zzskm/keyboard/46es/model/samples/README.md

# 46es 시험 쿠폰 원본 — B 쿠폰·보스 탭

`46es_sw_hole_sample.sc`는 주문 1의 B 쿠폰(`SW_HOLE_SAMPLE`)과 보스 탭(`BOSS_TAB_SAMPLE`)의 SolidCraft 원본이다. 46es 부품이 아니라 시험용 조각이다. 출력 파일은 `python 46es/tools/export_print_v5.py`가 이 원본에서 [`../print_v5/order1/`](../print_v5/README.md)의 `46es_v5_sw_hole_coupon`·`46es_v5_boss_tab`으로 내보낸다. 이 폴더에는 출력 파일을 두지 않는다. 재료·수량·출력 방향은 [제작 안내](../print_v5/README.md)를 따른다.

## 형상

B 쿠폰은 145.35 × 74.15 × 10 mm다. 열은 7개이고 X 간격 19.05로 홀이 13.7에서 14.3까지 0.1씩 커진다. 열 0(13.7) 쪽 원점 코너의 3 mm 모따기가 방향 표시다. 두께 10은 업체 최소 부품 크기 때문이다. 스위치 끼움에는 아래 층만 관여한다.

| 행 | 구조 | 확인할 것 |
|---|---|---|
| A | 홀 + 상면 1.5 아래 걸쇠 노치(8 × 1 × 1.5) | 국부 노치 방식 |
| B | 홀(상면 1.5) + 아래 16.5 개방 포켓 | 노치 없는 비교 |
| C | 상면 16.5 개구 1.7(`SMP_upper` = v5 `TBD_upper_plate_T`) + 홀 층 1.5 + 아래 개방 | **v5 plate와 같은 층 구성** |
| D | M2 Ø2.0–2.6, M3 관통 Ø3.0–3.6, 카운터보어 Ø6.0/6.2/6.4 × 3.5(M3 3.3 위), 육각 포켓 AF 4.8–5.4 × 1.5(아랫면) | 나사 자리·보스·지지대 끼움 |

보스 탭은 30 × 30 × 10 판에 커버 보스 Ø5.8 × 1.5(끝 자석 포켓 Ø3.2 × 2.1)와 평면 자석 포켓 Ø3.2/3.3/3.4를 둔 투명 레진 견본이다.

`check_repository.py`는 행 C의 `SMP_upper`가 현행 CAD의 `TBD_upper_plate_T`와 같은지 검사한다. plate 층 두께를 바꾸면 이 원본도 함께 고치고 주문 1을 다시 내보낸다.

## 시험

1. 각 홀에 Gateron KS-3 Milky Yellow Pro를 끼운다. 삽입력·걸쇠·키캡을 뺄 때의 이탈·흔들림·플랜지 착좌를 행 A/B/C별로 기록한다.
2. 행 D: M2 통과·자가탭, M3 통과, 보스 탭 보스와 카운터보어의 여유(반경 0.1/0.2/0.3), M3 육각 스탠드오프와 육각 포켓의 끼움을 기록한다.
3. 보스 탭: 자석 포켓 끼움·에폭시·흡착력과 투명 표면을 확인한다.
4. 홀 내경을 실측해 `measurements.csv` M18에 적고, 채택한 값은 생성기 입력으로 옮겨 주문 2 전에 CAD를 다시 만든다. plate는 깎아 맞추지 않는다([AGENTS.md](../../AGENTS.md) §5).

참고 치수의 출처: [스위치 테스터 분석](../../inspection/switch_tester/README.md)(fidget 14.0 / 남김 1.4 / 노치 16 × 8 × 1.5), r2 DWG 14.0(레이저 커프라 MJF와 다름).
