zzskm/keyboard/46es/inspection/wilmore/README.md

# The_Wilmore.stl 검사 — PSD60 실측 전 하우징 대용값

> **Wilmore는 PSD60 Defender가 아니다.** 둘 다 GH60 호환 60% 하우징이라 내부가 비슷할 것으로 보고, PSD60을 실측하기 전까지 대용값으로만 쓴다. 여기서 뽑은 값은 모두 `REF_WIL_` 매개변수에 넣었고, 하우징 관련 `TBD_` 매개변수가 그 값을 참조한다. 실측값이 나오면 `TBD_` 매개변수의 식을 실측값으로 바꾸면 모델 전체가 따라간다(`../../model/README.md` 참고).

검사일 2026-11-04. 원본 메시 파일은 저장소에 넣지 않았다(외부 모델, 재배포 권한 미확인).

## 원본

| 항목 | 값 |
|---|---|
| 경로 | `C:\Users\bearhappy\Downloads\The_Wilmore.stl` |
| 크기 / SHA-256 | 5,387,484 B / `c9c50ac7cd22fcba3e5492bf53bf5867bfc8d429cbc2098ed6ebe6a173a8d1f6` |
| 형식 | binary STL, 삼각형 107,748, 경계 엣지 0, 비다양체 엣지 13. 단위는 mm로 가정 |
| 출처 | 찾지 못함. Printables의 The Haydee·Morrel·Faria·Zatarra 같은 60% 케이스 시리즈와 이름 짓는 방식이 같지만 같은 제작자인지는 확인하지 못했다 |

## 구성 (연결 성분 7개)

크기는 아래 「좌표 변환」을 적용한 PCB면 기준이다.

| # | 삼각형 | 형상 | 해석 |
|---|---|---|---|
| 0 | 48,400 | 외곽 312.904 × 117.713, 내벽 292.370 × 101.929 R5.5 | 케이스 본체 |
| 2 | 15,766 | 두께 3.0, 높이 17.15 링. 내면 286.381 × 95.934 **R2.5** | 케이스 내벽에 붙는 링. 좌우 가운데에 H05·H06 보스(Ø2 구멍), USB 위치에 틈 |
| 1 | 36,926 | 292.4 × 102.0 시트, 두께 0.62(가장자리 0.96) + H01 스탠드오프 | 바닥 시트. 케이스 바닥에서 0.56 떠 있음 |
| 3·4·5 | 3,192 / 1,724 / 1,724 | Ø5.0 / 구멍 Ø2.0, 높이 4.67 | H04·H03·H02 스탠드오프 |
| 6 | 16 | 292 × 104 쐐기 | 케이스 아래 쐐기(받침 또는 무게추 자리로 추정). 사용하지 않음 |

46es에서 하우징 내벽 역할을 하는 면은 **링 내면**으로 본다. r2 판(286.4 × 95.8)과 거의 같은 크기이고, 링 내면과 GH60 PCB(285 × 94.6) 사이 틈이 사방 0.67~0.69로 고르다.

## 좌표 변환

1. **경사 제거**: 시트 윗면 법선의 경사 4.633°(케이스 본체·링 윗면도 4.633°)만큼 X축으로 돌려 PCB면을 수평으로 만든다.
2. **비틀림 보정**: 내벽 4면을 직선 맞춤해 나온 Z축 비틀림 0.0164°를 보정한다.
3. **원점**: H03·H04 구멍 중심에 GH60 좌표를 맞춘 점(Wilmore 좌표 305.004, 1.441, 두 구멍 잔차 ≤ 0.001)을 원점으로, 스탠드오프 상면(8.730)을 Z = 0으로 잡는다. 46es 모델의 좌표계(GH60 PCB 기준점, Z = 지지대 상면)와 같다.

## 추출값 (46es 모델 좌표)

| 매개변수 | 값 | 측정 방법 |
|---|---|---|
| `REF_WIL_in_W` × `REF_WIL_in_D` | 286.381 × 95.934 | 링 내면. Z −4.7 ~ +12.5 모든 높이에서 같다(수직벽, 구배 없음) |
| `REF_WIL_in_R` | 2.5 | 링 내측 4코너 × 3높이 원 맞춤 2.481 ~ 2.500, 잔차 ≤ 0.01 |
| `REF_WIL_pcb0_dx` / `dy` | 0.693 / 0.667 | 링 내면 → GH60 기준점 |
| `REF_WIL_support_H` | 6.196 | 케이스 내부 바닥 윗면 → 스탠드오프 상면 |
| `REF_WIL_rim_F` / `rim_B` | 12.173 / 11.891 | 스탠드오프 상면 → 앞·뒤 테두리 윗면(내측 모서리) |
| `REF_WIL_usb_X` / `W` / `H` / `Z` | 18.713 / 11.217 / 7.137 / −1.533 | 뒷벽 USB 개구부. 모서리 R 없는 직사각형, 링 포함 벽 두께 약 7.1 |
| `REF_WIL_post_D` | 5.0 (구멍 2.0) | 스탠드오프 외경 |
| `REF_WIL_out_*`, `bot_*`, `chamfer_*` | 표 아래 참고 | 외형 표시용. 측면 단면(X = 450) 폴리곤을 단순화한 값 |
| `REF_WIL_tilt` | 4.633° | 내부 기준면의 타이핑 경사 |

외형 단면(Y, Z): 앞 아래 (−15.302, −7.581) → 뒤 아래 (102.411, −12.025) → 뒤 위 (102.411, 11.891) → 앞 경사 시작 (−7.353, 12.173) → 앞 경사 끝 (−15.302, 6.826). X는 −13.953 ~ 298.951. 실제 메시의 약 1° 외벽 구배와 바깥 모서리 형상은 생략했다.

## GH60 후보 좌표와 비교

| 구멍 | GH60 `CAND_` | Wilmore | 차이 (X, Y) |
|---|---|---|---|
| H01 | 25.199, 66.699 | 25.319, 66.699 | +0.120, 0.000 |
| H02 | 128.200, 47.600 | 128.198, 47.299 | −0.002, −0.301 |
| H03 | 190.499, 9.399 | 190.500, 9.400 | 원점을 맞춘 구멍 |
| H04 | 260.050, 66.699 | 260.050, 66.699 | 원점을 맞춘 구멍 |
| H05 | 3.709, 38.099 | 3.319, 38.110 | −0.390, +0.011 |
| H06 | 281.291, 38.099 | 281.809, 38.110 | +0.518, +0.011 |

H05–H06 중심 거리: GH60 277.58, r2 DWG 279.44, Wilmore 278.49로 세 자료가 모두 다르다. 하우징 대용 바디의 기둥은 GH60 `CAND_` 좌표에 두었다. 체결 좌표는 PSD60 실측(M08)과 체결 시험 프레임(단계 A)으로 정한다.

## 이전 자리표시값과 비교

| 매개변수 | 이전 | 지금(Wilmore) | 메모 |
|---|---|---|---|
| `TBD_case_in_W` | 286.4 (r2 판) | 286.381 | r2 판이 PSD60에 들어간다면 PSD60 내폭은 286.4 이상이어야 한다. Wilmore는 0.019 작다 |
| `TBD_case_in_D` | 95.8 (r2 판) | 95.934 | |
| `TBD_case_in_R` | 2.5 (The_Wedge) | 2.5 | 두 메시가 같다. 사용자 관찰(R3.5 판에서 코너 유격)과도 맞는다 |
| `TBD_pcb0_dx` / `dy` | 0.7 / 0.6 (가정) | 0.693 / 0.667 | |
| `TBD_support_H` | 0 (값 없음) | 6.196 | |
| `TBD_support_to_rim_F` / `B` | 0 (값 없음) | 12.173 / 11.891 | |
| `TBD_usb_X` / `W` / `Z` | 20 / 12 / 0 (근거 없음) | 18.713 / 11.217 / −1.533 | `TBD_usb_H` 7.137 새로 추가 |
| `TBD_case_post_D` | — | 5.0 | 새로 추가. r2 판의 지지대 회피 구멍 Ø4.5보다 크다 → M10 |

## SolidCraft 하우징 대용 바디

초기 스케치 모델 `model/46es_draft_sketches.sc`(태그 `46es-pre-cleanup-2026-11-09`)의 `REF_HOUSING_WILMORE_NOT_PSD60` 바디. 제작용 아님, 간섭 확인용. 현행 v5는 이 값을 `REF_WIL_` 매개변수로 이어받았고, 조립 검토 모델은 실측하지 않은 바닥 윤곽에만 쓴다(`tools/build_assembly_reference_v5.py`).

| 피처 | 내용 | 따르는 매개변수 |
|---|---|---|
| `SK40_HOUSING_PROFILE_REF_WILMORE` → `HOUSING_OUTER_REF_WIL` | 측면 단면 5점 폴리곤을 X로 돌출 | `REF_WIL_out_*`, `bot_*`, `chamfer_*`, `TBD_support_to_rim_F/B` |
| `HOUSING_CAVITY_TBD` | 기존 SK00 내측 외곽을 바닥(−`TBD_support_H`)부터 위로 관통 절단 | `TBD_case_in_W/D/R`, `TBD_pcb0_dx/dy`, `TBD_support_H` |
| `SK41_HOUSING_POSTS_CAND` → `HOUSING_POSTS_CAND` | 기둥 6개. H01–H04는 원기둥, H05·H06은 벽까지 이어진 슬롯 모양 보스. 구멍 지름 `TBD_case_screw_D` | `CAND_H0x_X/Y`, `TBD_case_post_D`, `TBD_case_screw_D`, `TBD_support_H` |
| `HOUSING_USB_CUT_TBD` | 뒷벽 직사각형 관통 | `TBD_usb_X/W/H/Z` |

검증:

- 부피 297,430.3 mm³. 손으로 계산한 값 297,430.3과 같다. Wilmore 케이스와 링을 합친 부피는 295,785 mm³(+0.56%, 바닥 모깎기·턱 생략분).
- 기둥 6개의 원통면 중심·반지름이 `CAND_` 좌표, Ø5.0 / Ø2.0과 일치한다(불리언 보정 이동 ≤ 0.0007).
- 바디를 STL로 내보내 Wilmore 메시와 Z = −5.5 / −3 / −0.3 / 4 / 10 단면을 겹쳐 비교했다. 내벽은 0.01 이내, 외곽은 0.15 이내(외벽 구배 생략분), USB 개구부와 앞 경사면은 일치한다. `render/compare_*.png`(파랑 = SolidCraft, 주황 = Wilmore)
- 스케치 7개 모두 자유도 0, 타임라인 오류 0.

Wilmore와 일부러 다르게 만든 부분: 케이스와 링을 한 덩어리로 만들었고, 바닥 시트를 빼고 기둥을 바닥에서 세웠다(Wilmore 스탠드오프는 바닥 위 1.53에서 시작). 기둥 좌표는 GH60 값을 썼고, 내부 바닥·벽 모서리의 약 1 mm 모깎기, 외벽 구배, 바깥 모서리 형상, 쐐기(성분 6)는 생략했다.

## 재현

스크립트는 `scripts/`에 있다. numpy와 scipy만 쓴다. 임시 폴더에서 실행했으므로 경로는 바꿔서 쓴다.

```bash
python -I scripts/stl_overview.py The_Wilmore.stl wilmore.npz       # 개요·성분
python -I scripts/components.py wilmore.npz wil_lab.npy             # 성분 라벨
python -I scripts/untilt.py wilmore.npz wil_lab.npy wil_kb.npz      # 경사 4.633° 제거
python -I scripts/frame2.py wil_kb.npz wil_lab.npy wil_kb2.npz      # 비틀림 0.0164° 보정
python -I scripts/crossings.py wil_kb2.npz wil_lab.npy 2 12         # 링 내·외면 위치
python -I scripts/corners.py wil_kb2.npz wil_lab.npy 2 12 304.311 590.692 0.774 96.708 2.9   # 링 내측 R
python -I scripts/loops2.py wil_kb2.npz wil_lab.npy 0,1,2,3,4,5 6   # 구멍 중심
python -I scripts/vcross.py wil_kb2.npz wil_lab.npy 450 sec.npz     # 높이(바닥·시트·테두리)
python -I scripts/ysec.py wil_kb2.npz wil_lab.npy 0 101.5 318.5,323.7 3.7,10.8 310 340       # USB
python -I scripts/compare.py wil_kb2.npz wil_lab.npy housing.stl cmp # 대용 바디와 단면 비교
```
