zzskm/keyboard/46es/model/review_side_pairs_v3/README.md

# Side pairs v3 — REVIEW ONLY

기준일: 2026-11-05 KST. 제작 승인·발주용 아님.

STL9개: 좌/우 병합 mount2개 + 중앙 mount2개 + plate2개 + spine1개 + controller bracket/gate 각1개.
단위mm, 조립 좌표 유지. 프린트 베드 배치가 아니다. 상위 `46es_mount_side_pairs_v3_REVIEW_ONLY.step`은 같은9바디 조립이다.

[편집 모델](../46es_mount_side_pairs_v3.sc), [보고서·국부 시험안](../../docs/side-pairs-v3-2026-11-05.md), [CSV](../parameters_side_pairs_v3.csv).
전체9개 shell1·STL 연결1·비정상 edge0. 실제 재료·부품·배선·강도/조립 시험은 미완료다. v2 파일은 이전 안으로 보존했다.
