zzskm/keyboard/46es/docs/design.md

# 현행 설계 — v5

PSD60 Defender용 46키 non-split hand-wired. r2의 키 중심/회전/외곽 유지. plate 좌우 2조각, mount 4, spine, 분리형 Pro Micro 스냅 브래킷(PCB는 나사 없이 고정), 자석 커버 3조각. 스태빌라이저 없음.

## 기준/변경 경로

- 현행 CAD: [`model/46es_mount_seam_v5.sc`](../model/46es_mount_seam_v5.sc) ← `tools/build_seam_v5.py`가 기반 타임라인 [`model/seam_v5_base.json`](../model/seam_v5_base.json)(plate)에 v5 기능을 더해 생성. plate 앞 이음과 주문 1 이음 쿠폰은 `tools/seam_v5.py`, mount 4개는 [`model/mounts_cadcraft_phase1.dxf`](../model/mounts_cadcraft_phase1.dxf)의 평면 윤곽을 `tools/mounts_v5.py`가 직접 돌출하고, 브래킷은 `tools/ctrl_v5.py`, 커버 3조각은 `tools/cover_v5.py`(윗면 장식은 `tools/cover_pattern_v5.py`), spine은 `tools/spine_v5.py`, 참조 나사·너트·자석은 `tools/hardware_v5.py`가 만든다(앞 이음 나사·너트는 `seam_v5.py`). mount만 고칠 때는 `--mounts`, 브래킷만 고칠 때는 `--ctrl`, 커버만 고칠 때는 `--covers`로 수 초–수십 초 안에 확인한다([명령](validation.md#재생성-저장소-루트)).
- `parameters_seam_v5.csv`는 CAD 내보내기 결과. 변경 순서: 생성기 → CAD → 검토/제작 출력 → 검증 → 가이드.
- [`46es_assembly_review_v5.sc`](../model/46es_assembly_review_v5.sc): 조립 검토용 파생(부분 실측/단순 MX·OEM 참고). 실물 보증·주문용 아님.
- 좌표: GH60 PCB 앞·왼쪽 원점, X 오른쪽/Y 뒤쪽/Z 위. **Z=0 = 케이스 지지대 상면**(타이핑 경사 정규화).

## 현행 치수

| 항목 | 값·의미 |
|---|---|
| plate 상면 | Z 13 mm |
| 스위치 상부 개구 / 걸쇠 홀 층 / 아래 릴리프 | 1.7 / 1.5 / 1.8 mm |
| 스위치 착좌 | Z 11.3 mm. 14.0 mm 홀은 시험 출발값 |
| 커버 윗면 / 본체 두께 | 평면 Z 19.0 mm / 6.0 mm |
| mount–plate 접촉면 | Z 8.0 mm, 도면대로 돌출한 일체형 받침 7곳(좌 2·우 2·Rear 1·Front 2) |
| 뒤 받침 블록 | 별도 부품 3개, 길이 14 × 폭 4 × 높이 4.5(Z 0.5–5). X 30–44·106–120·163–177, Y 90.97–94.97. 밑은 케이스 뒤 벽 보스 윗면(가정 Z 0)과 틈 0.5 = 점착 패드, 위는 plate 뒤 플랜지 밑면. plate에는 다리가 없다. 주문 1 높이 변형 4.2 / 4.8 |
| 커버 다리 자석 포켓 위 살 | 3.9 mm |
| 커버 창과 참고 키캡 간격 | 1.0 mm. 쉴 때·4 mm 눌림 모두 |
| 커버 창 윤곽 | 키 블록(왼쪽·오른쪽) 실루엣 2개. 키캡 실제 폭 + 여유를 담는 셀 20.35, 외곽 살 ≥ 1.1, 다리 자석 포켓과 ≥ 1.15. 이 창이 그대로 L/T/R 분할 절삭이다: 9(E)·31(I)번 위 뒤 테두리와 22·40번 아래 앞 테두리를 그 키의 창 폭 띠로 곧게 끊는다(앞 두 곳의 안쪽 선은 키 중심에서 7.0). 윤곽의 0.6 이하 꺾임, 2.5 이하 짧은 모서리, 1.5 이하 평행 계단은 정리한다(`COVER_SPLITS`·`COVER_CLEAN`, `tools/build_seam_v5.py`) |
| 커버 윗면 장식 | 로고 `kb46es/26` 음각 하나, 깊이 1.0(Z 19 → 18, 관통 없음). L 왼쪽 블록 위쪽(X 3.26–18.75, Y 39.5–41.5). 폰트 Xifiction(출처 [dafont Xifiction](https://www.dafont.com/xifiction.font)(Nowak.tv, dafont 표기 "Free for personal use", 폰트 파일 내 표기 "freeware [for non-commercial use]")), 글자 칸 높이 2.0·폭 15.5, 획 0.5, 글자 안 틈·글자 사이 살 0.25(레진 벽 기준 미달, 사용자 수용). 대문자 모양으로 나온다. T·R에는 장식 없음. `tools/cover_pattern_v5.py`, 글자 윤곽 `tools/cover_logo_xifiction.json` |
| 참고 키캡 밑면 | 착좌 +6.0 = Z 17.3 mm. 실측 확정값 아님 |
| 참고 키캡 4 mm 눌림 후 plate 간격 | 0.3 mm |
| 케이스 테두리 | Z 14 mm 대략 실측. 커버 윗면 +5.0 |
| plate·커버 전체 외곽 | 약 285.781 × 95.334 mm |
| SO 체결 6곳 | mount 보스 Ø8(Z 1.5–8)에 보유 원형 황동 M3 인서트 Ø5 × 4를 열압입(구멍 Ø4.2 × 깊이 5, 아래 관통 Ø3.4). 보유 흑색 M3×10이 plate 카운터보어 바닥 Z 9.5에서 인서트를 지나 mount 밑 0.5까지 |
| 자석 | Ø3×2, 보스 6개 + 다리 2쌍 4개 = 10개 |
| 다리 자석 포켓 | 커버 Ø3.2 / plate Ø3.3. X 94.0·167.7, Y 2.5 |

r2 DWG의 P4·P5는 각각 윗면이 평평하고, 세 조각의 윤곽은 거의 일치한다. v5도 세 조각의 윗면을 Z 19(참고 키캡 밑면 17.3 + 덮음 1.7)로 평탄화했다. r2와 비교해 v5에는 키캡 여유 1.0 mm를 위한 창 확장과 밑면 자석 체결이 적용된다.

커버 윗면에는 이름 `46es` 하나만 작게 음각한다(사용자 결정 2026-11-10). 경위: 처음에는 L 앞쪽·R 가운데·T 뒤쪽 빈 면을 채우는 무늬를 시도했다(attractor hex → V자 헤링본 사선 → 폭이 줄어드는 헤링본). 사용자가 미리보기에서 모두 마음에 들지 않아 했고, 면을 채우는 대신 초점 하나를 두는 안 중 T 윤곽 핀스트라이프와 엠블럼을 골랐다. 그 미리보기도 본 뒤 핀스트라이프는 빼고("center cover에 engrave 제거"), 엠블럼은 "minimal, futuristic font"로 작게 바꿔 화면 캡처에 표시한 자리(L 왼쪽 블록의 뒤쪽 가장자리 바로 아래)에 두기로 했다. 글자는 폰트 파일 없이 생성기에 직선으로 그린 각진 단일 획이라 어느 환경에서도 같은 형상이 나온다. 모든 글자가 같은 높이이고 획 끝과 모서리는 직각이며, 막대 사이 살은 높이의 절반 − 획 폭이라 레진 벽 기준 1.0이 글자 높이의 하한을 정한다. 사용자가 폭은 그대로 두고 높이만 조금 줄이라고 해서(2026-11-10) 획을 0.45 → 0.4로 줄여 높이 3.0 → 2.8로 내렸다(막대 사이 살 1.0, 기준에 딱 맞음). 더 줄이려면 살이 1.0 아래로 가거나 획이 0.4보다 가늘어진다. 관통하지 않으므로 커버 강도·자석·배선 가림은 그대로이고, 윗면 평면 Z 19와 창 여유는 바뀌지 않는다. 2026-11-11 사용자가 로고를 폰트 Xifiction과 문자열 `kb46es/26`으로 바꿨다(출처 [dafont Xifiction](https://www.dafont.com/xifiction.font)(Nowak.tv, dafont 표기 "Free for personal use", 폰트 파일 내 표기 "freeware [for non-commercial use]")). 이 폰트는 200 단위 격자의 굵은 각진 글자라 획이 글자 높이의 1/4, 글자 안 틈과 글자 사이가 1/8이다. 살 1.0을 지키려면 글자 높이 8(폭 62)이 필요해 L 어디에도 들어가지 않는다. 앞쪽 띠(높이 6.2, 틈 0.77)·뒤쪽 띠·왼쪽 블록 세로 후보를 미리보기로 보였고, 사용자는 기존 자리(A, 최대 높이 2.7)를 고르고 크기를 줄이라고 했다. 높이 2.0(폭 15.5, 획 0.5, 틈 0.25)으로 정했다. 폰트 파일은 커밋하지 않고 쓰는 글자 7개의 윤곽만 곡선을 직선 6개로 나눠 `tools/cover_logo_xifiction.json`에 둔다(`python 46es/tools/cover_pattern_v5.py --font Xifiction.ttf`로 다시 만듦). 틈 0.25는 출력 벽 검사(`thin_wall_scan.py --exclude`)에서 로고 영역으로 따로 기록하고 폰트 틈 이상인지 확인한다. 로고 밖의 벽은 그대로 재질 기준으로 검사한다. 절삭은 홈마다 바깥 고리의 곡선으로 프로파일을 지정해 안쪽 고리(B·6 속)를 섬으로 남긴다. 생성·검증은 윗면 높이가 Z 19와 Z 18 두 개뿐이고 Z 18 면적이 계산한 홈 면적과 같은지 확인한다.

## 체결·분해

PSD60 → mount 4개(SO 인서트 보스 6개) → plate L/R → 커버 순서다. 좌우 mount에 각각 2곳, 중앙 뒤에 1곳, 중앙 앞에 2곳의 평평한 받침면을 뒀다. 좌측 두 받침은 SO1·SO2 보스 외곽 쪽이 넓어지고, 나머지 받침은 mount 길이 방향을 따라 양끝을 둥글게 마감했다. 타건 하중을 plate 밑면에서 mount로 직접 전달한다. mount는 케이스 체결 오차를 흡수한다(사용자 요구 2026-11-04): 나사를 느슨하게 건 채 위치를 맞추고 조인 뒤 축력으로 고정하며, 장공 방향은 위치별 오차 방향을 따른다. 케이스 벽 간격·나사 여유·출력 보정은 따로 관리하고, 잘 맞는 r2 외곽을 구멍 오차 때문에 줄이지 않는다. 지지대 높이 차이는 장공이 아니라 접촉면 높이·스페이서로 다룬다. 받침은 스위치와 체결부를 피해서 배치하고 사이를 열어 배선 공간을 확보했다. plate·스위치·배선·컨트롤러는 한 모듈로 들어낼 수 있다. 브래킷은 plate 아랫면에 고정하고 Pro Micro를 나사 없이 스냅으로 잡는다(아래 Pro Micro 브래킷 문단, 2026-11-09 `b52c50f`). 이전의 게이트 고정은 폐지했다.

mount 4개는 CADCraft 도면(`model/mounts_cadcraft_phase1.dxf`)의 외곽·받침 윤곽을 그대로 Z 0–3 / Z 1.5–8로 돌출해 만든다. 체결부는 도면이 아니라 매개변수에서 만든다. SO1–SO6: 프레임 관통홀 Ø(`TBD_so_screw_D`+`TBD_so_clr`)=3.4 위에 Ø8 보스(`v5_so_boss_D`, Z 1.5–8)를 세우고, 보스 윗면에서 프레임 윗면까지 인서트 구멍 Ø4.2 × 5(`v5_so_insert_hole_D`, `v5_so_insert_hole_depth`)를 판다. 보유 원형 황동 M3 인서트(Ø5 × 4, `v5_so_insert_D`·`v5_so_insert_H`)를 윗면에 맞춰 열압입하면 아래에 녹은 수지가 갈 1 mm가 남는다. 보유 흑색 M3×10이 plate 카운터보어 바닥(Z 9.5)에서 인서트와 관통홀을 지나 mount 밑으로 0.5 나온다(옛 아래 나사머리 자리 Z −1.65–0 안). 보스는 AF 8.5 팔각형 보존 구역(회피부·케이스 체결부가 들어오지 않는 곳) 안에 있고, plate 플랜지 안쪽 면에서 0.3 떨어지게 잘린다(SO4만 해당, 구멍 둘레 살 1.56, 나머지 1.9). spine의 SO3 회피 구멍은 Ø8.6이다(`spine_v5.SO3_RELIEF_D`). 2026-11-12 전에는 윗면 육각 포켓 AF 5.4 × 깊이 1에 황동 지지대(길이 6, 맞변 5)를 넣고 위 M3×4·아래 M3×5로 잡았다. 케이스 나사 H01–H06: 방향별 장공 폭 2.4(H05만 직선부 1.8, 나머지 2.0), H05를 뺀 다섯 곳에 윗면 머리 자리 폭 4.4×깊이 1. 도면의 홀·머리 자리 레이어는 이 매개변수 형상과 일치하는지 검사만 한다.

스위치 핀 회피부는 r2 배열과 KS-3X1 핀 위치에서 계산한다. 외곽에 0.4 mm 안으로 닿는 핀이 있는 키마다 핀 외곽+0.6의 사각 포켓을 바닥 Z 2.1까지 판다. 포켓과 외곽 사이 벽이 1 mm 미만이면 그 변을 열고, 육각 포켓과는 1 mm를 지키며, 케이스 머리 자리와 1 mm 미만으로 가까우면 둘을 1 mm 클로징으로 이어 접선 필렛으로 만든다(18번, 단순 합집합은 칼날 모양 재료를 남겼다). 여유 영역이 몸체에 1 mm 미만으로만 걸치는 핀은 사각 포켓 대신 핀 둘레 r(핀+0.4+0.6)의 둥근 스캘럽을 판다(33번, 사각이면 옆면에 머리카락 폭 틈이 생긴다). 현행 배열에서는 좌 10·11, 우 18·33·46이다. 생성기는 모든 Z 구간에서 절삭 옆에 1 mm 미만 두께의 재료 조각이 남으면 멈춘다. 받침이 스위치 몸체(13.98+0.15)와 겹치는 곳은 Z 4.95 위를 잘라 낸다(좌 11, 우 46). Front 받침 1에는 앞 이음 M2 너트 자리 Ø5.1을 뚫는다.

PSD60 뒤 벽 안쪽에는 구멍 없는 반원 보스 4개가 있다(사용자 제공 KPrepublic 제품 사진, 2026-11-09). 사진을 H01–H06으로 사영 보정한 중심 X는 약 36·113.6·170.1·245.8(잔차 ≤ 0.8, 기준점 하나씩 빼면 ±2–4), 지름은 약 9다. 윗면은 지지대 윗면(Z 0)과 같다고 가정했다. r2 맨 아래 판 P0(폭 4 테두리, H01·H05·H06 M2 구멍)가 노치 없이 이 보스 위를 지났기 때문이다. 실측은 M22다. ①②③은 plate 뒤 플랜지(Y 92.97–94.97, Z 5–8) 아래에 있다. 각 보스 위에 별도 받침 블록(길이 14 × 폭 4 × 높이 4.5)을 점착 패드로 붙이고 플랜지 밑면(Z 5)이 그 위에 얹힌다(`tools/build_seam_v5.py` `REAR_RESTS`). 2026-11-09에는 플랜지를 길이 14 다리로 Z 0.5까지 내렸으나, plate 출력 높이가 8에서 12.5로 늘고 얇은 다리 3개 때문에 출력에 support가 필요해져(사용자 보고 2026-11-10) 다리를 plate에서 떼었다. plate에는 받침 관련 형상이 없다. 블록 밑면과 보스 윗면의 공칭 틈 0.5는 패드 자리다. 딱 맞게 만들면 지지대 6개가 정한 plate 높이와 겹쳐 과구속이 되므로, 주문 1에 높이 4.2 / 4.5 / 4.8 세 가지를 뽑아 시험 조립에서 패드 두께와 함께 고른다. 어긋남을 plate가 아니라 블록에서 흡수하므로 plate를 기준 부품으로 두는 원칙과 맞는다. 블록 길이는 보스 위치가 ±2 mm 틀려도 플랜지 안쪽 면에서 본 보스 윗면 폭이 블록 밑에 다 들어오게 잡았고, 폭은 플랜지 2에 보스 앞쪽으로 2를 더했다(보스와 겹치는 면적 약 29 mm², 맨 뒷줄 스위치 몸체와 평면 거리 2.2 이상). 뒤 가장자리 받침 간격은 SO2→SO3 124 mm·SO3→SO4 120 mm에서 최대 약 80 mm로 줄고, 숫자 줄 하중이 mount를 거치지 않고 케이스로 간다. ④는 우 mount 뒤 모서리(SO4 옆) 밑이라 블록이 없고, 가정대로면 mount가 그 위에 얹힌다(검토 CAD 거리 0, 겹침 없음). plate는 블록 위에 얹히기만 하므로 분해 방식은 그대로다.

Rear(가운데 뒤 mount)에는 spine 받침을 따로 두지 않는다. spine 줄기 밑면(`split_spine_bottom_Z` = `TBD_frame_T` + `split_support_gap` = Z 3.05)이 Rear 프레임 윗면 Z 3에 공칭 틈 0.05로 얹혀, 줄기가 Rear 위를 지나는 Y 43–83 구간 전체가 접촉면이다(배선 홈 3곳과 H02 케이스 나사머리 자리를 빼고 116 mm², 이전 shim 받침 24 mm²). H02 머리(팬헤드 1.3 가정, 1.0 묻힘 → 윗면 Z 3.3) 위는 줄기 밑면을 옛 높이 Z 4로 남겨(`SPINE_H02_HEAD_RELIEF`, 머리 자리 폭 4.4 + 0.3 여유, 장공 ±1 포함) 0.7을 띄운다. 배선 홈 윗면은 Z 6 그대로라 홈 높이는 2.95, 프레임까지 통로 3이다. 생성 결과는 `inspection/scripts/verify_seam_v5.py`가 주문 1 STL의 Z 1.0·2.5·3.6·6.0 단면을 도면 기준 프로파일과 비교해 확인한다(대칭 차 0.5 mm²·경계 0.1 mm 이내).

Pro Micro 브래킷은 `tools/ctrl_v5.py`가 PCB 기준 좌표(`TBD_ctrl_*`)에서 만든다. plate 왼쪽 아랫면에 M2×6 2개로 달고(나사 (121.7, 18.96)·(121.7, 25.16), 배선하지 않는 1–4번 핀 구역의 패드 두 줄 사이), PCB는 나사 없이 잡는다. +X 끝을 끝 립 아래로 넣고 USB 쪽을 누르면 양옆 탄성 암(X 9.0 × 두께 1.0, 립까지 7.75)의 립이 PCB 긴 변 아래로 `ctrl5_hook_e` 0.4 걸린다. USB 개구 양옆 모서리 턱이 뽑는 힘(−X), 패드 두 줄 사이의 +X 끝 벽이 꽂는 힘(+X)을 받고, 두 쌍이 PCB가 Z축으로 도는 것도 막는다. 위(+Z)로는 모서리 받침·나사 블록·끝 받침이 납땜면을 0.15 위에서 받친다. 펌웨어가 쓰는 핀(행 D1·D0·D4·C6, 열 D7…B6)은 양쪽 5–12번 패드라 그 구간에는 긴 변 벽·홈을 두지 않고, 지붕은 패드 두 줄 사이 띠로 좁혔다. 생성기는 배선 패드(납땜면 r 1.87 × 2.5, 부품면 r 1.17 × 0.5), 부품면 부품(검토 모델의 Pro Micro 참고 도면), 스위치 하우징·핀, USB 플러그, mount, plate 16.5 릴리프를 피하는지 검사한다. 패드 위치(1번 핀이 USB 끝에서 3.8, 12번 핀이 +X 끝에서 1.26)와 부품은 참고 도면 값이고 실물(M15)은 미측정이다. 1번 스위치의 +x, 23번 스위치의 −x PCB 다리는 검토 CAD에서 PCB 뒤 모서리에 0.86 mm 파고들어 조립 때 자른다. 주문 1에는 걸림만 다른 시험편 A(0.25 / 끝 0.7)·B(현행)·C(0.55 / 1.2)를 넣는다. 탄성 암 변형률(외팔보 계산: 삽입 1.75 %, 멈춤 1.85 %)은 계산값이며 실물 강도·반복 탈착은 시험으로 확인한다.

plate 앞 이음은 위에서 얹는 곧은 반턱과 M2×5 나사 1개로 결합한다(`tools/seam_v5.py`). L의 tab은 윗면 쪽 2.4 mm 두께로 X 136.3–147.4까지 R 위로 나온다. tab 옆면(Y 3.0·10.2)이 Y 위치와 면내 회전을 잡고, tab 끝 3.2 mm 구간이 +Y로 2.4 넓어진 걸림 턱이 X 방향 벌어짐을 잡는다. 위치결정 여유는 편측 0.15 mm, tab 끝과 턱 바깥은 0.3 mm다. 나사는 (140.4, 6.6)의 ISO 7380 M2×5 버튼헤드(머리 Ø3.5–3.8 × 1.3), 머리 카운터보어는 Ø4.4 × 깊이 1.4(머리 윗면 Z 12.9, 머리 아래 tab 살 1.0, 카운터보어 둘레 벽 1.4)다. 너트는 R 아랫면의 닫힌 육각 포켓(맞변 4.0, 깊이 1.3)에 눌러 끼운다. 이음면 쪽 벽 1.27, 포켓 위 살 1.3이고, 너트는 plate 밑으로 0.3 나와 Front 받침 1의 Ø5.1 구멍에 들어간다. 나사로 당겨 끼우고 나사로 밀어 뺀다. 측면 삽입 슬롯은 쓰지 않았다. R 바닥 살이 2.6 mm라 위 1.0 + 슬롯 1.8 + 아래 1.0을 넣을 수 없다. 이음에서 5 mm 안에는 스위치 개구가 없다. 2026-11-10 이전에는 dovetail tab(X 136.3–142.9, 여유 0.15)과 이음면 쪽이 열린 얕은 너트 포켓(맞변 4.4, 깊이 1.0)이었다. 비스듬한 면의 0.15 여유는 MJF 공차에서 끼일 수 있는데 plate는 깎지 않는 부품이고, 너트는 조립 중 손으로 받쳐야 했다. 여유와 너트 포켓 맞변은 주문 1 이음 쿠폰 3쌍(S0 옛 dovetail 대조군, S1 현행, S2 여유 0.25·맞변 4.2)으로 확인한다. 중앙·뒤쪽은 spine의 M2 나사 4개가 잡는다. spine 배선 홈은 Y 49/64/72, 폭 3 × 높이 2.95 mm(윗면 Z 6)다. 이음의 단차·삐걱임과 접착 필요 여부는 배선 전에 확인한다.

커버 보스는 plate 카운터보어에서 위치를 잡고 자석은 강철 M3 나사머리에 붙는다. 아래 다리의 자석 2쌍은 서로 붙으므로 극성을 맞춘다. 위 다리는 공간이 부족해 자석을 추가하지 않았다. 비용이 큰 plate를 재출력하기 전에 mount·쿠폰 시험, 장공 조정과 상대 부품의 국부 가공으로 맞춤을 확인한다.

조립 검토 모델의 Pro Micro는 첨부 `arduino-pro-micro-1.snapshot.1.zip`의 STEP과 그림을 참고해 별도로 그렸다. v5의 PCB 외곽과 설치 위치에 맞춰 USB 소켓, 칩, 주요 부품과 양면 납땜 패드를 단순화했다. 소켓이 −X를 향하고 부품면은 케이스 바닥(−Z), 납땜면은 plate(+Z)를 향한다. 제작 모델의 플러그 점유 영역은 케이블 여유 검사용이다.

## 실측과 가정

[2026-11-04 실측 JSON](../model/measurements/2026-11-04T111846Z.json)은 원본 기록이다. 케이스 폭 286, 깊이 96, 테두리 14는 대략값이며 전체 최솟값으로 확정하지 않는다. H01 지지대 높이 5.5·외경 5와 M08 입력 좌표 성분만 참고 모델에 반영하며 미측정 축은 GH60 후보를 유지한다. mount는 GH60 채택 좌표와 장공으로 시험한다. H01–H06 좌표는 [GH60 호환 치수 조사](https://note.com/skeletonkbd/n/n7fdfaac9bd8c?hl=en)의 공개 CAD 비교값(GH60 PCB 앞·왼쪽 원점)이며 실물 측정 자료가 아니다. PSD60 외형 약 320 × 115, 앞 21·뒤 32, 경사 6°는 [KPrepublic 제품 안내](https://kprepublic.com/collections/case/products/kp-poseidon-60-psd60-defender-de-60-cnc-coating-case-layer-painting-for-standard-60-mechanical-keyboard-pcb-xd64-bm6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) 값이다.

케이스 내측 폭 286 기준 외곽 여유는 편측 약 0.11 mm다. 원점 가정을 적용하면 오른쪽에 0.081 mm 중첩이 생긴다. 대략 측정만으로 형상을 축소하지 않으며 실물의 중심 맞춤·접촉을 확인한다.

r2 현물 커버는 체결 상태에서 테두리 위로 최소 3 mm 돌출된다. r2는 5T+2T 아크릴 적층이고 현재 커버는 6T 단일 출력이다. r2 관찰값을 v5 실측 결과로 쓰지 않는다. 맨 아랫줄 키캡 폭은 사용자 확인값 1.25u·1u·2.25u·2u·1u·1u를 따른다. 펌웨어 JSON의 물리 폭 표기는 현물과 다를 수 있어 CAD 폭의 기준으로 쓰지 않는다.

참고 형상의 근거: [Cherry MX](https://www.thingiverse.com/thing:421524), [OEM KeyV2](https://github.com/rsheldiii/KeyV2/blob/master/src/key_profiles/oem.scad). 곡면·내부 소켓·정밀 걸쇠는 생략했다. Gateron KS-3 Milky Yellow Pro와 실제 OEM 키캡의 정밀 도면이 아니다. [r2 판독](../inspection/46es_r2_dwg_inspection.md), [Wilmore 참고 분석](../inspection/wilmore/README.md), [스위치 홀 참고 분석](../inspection/switch_tester/README.md)은 근거 자료로만 사용한다.

재료·수량과 구매품은 [제작 안내](../model/print_v5/README.md), 다음 결정은 [실물 확인 목록](validation.md)을 따른다.

## 결정 이력

이전 결정을 바꾼 변경은 여기에 날짜·커밋·경위를 남긴다. 2026-11-10부터 커밋 칸에는 해시 대신 `decision:` 커밋 제목을 적는다(조회: `git log --grep "^decision:" -- 46es`). 그 전 행의 해시는 그대로 둔다. 치수 자체는 위 표가 현행이고, 이 표는 "왜 바뀌었나"만 적는다. 경위가 기록되지 않은 변경은 `경위 미기록`으로 두고 다음 작업자가 확인한다.

| 날짜 | 커밋 | 결정 | 경위·근거 |
|---|---|---|---|
| 2026-11-04 | `9fd75ff` | 스태빌라이저 없음, Pro Micro 중앙 하단, plate·커버는 r2 아크릴 형상 | 사용자 결정 |
| 2026-11-05 | `67fe2c0` | 정밀 실측 대신 GH60 체결 좌표 채택, 장공·시험 출력으로 확인 | 사용자 결정. 실측 게이트 폐지 |
| 2026-11-05 | `67fe2c0` | 재료 MJF PA12, 최소 벽 1.0 | 사용자 결정(JLC3DP 규칙) |
| 2026-11-06 | `0880d22` | plate·mount 검정 PA12S-HP, 커버·보스 탭 투명 8001 레진 | 사용자: "mount, plate는 black, cover는 transparent resin" |
| 2026-11-06 | `854e647` | 두 단 커버(바닥 Z 16.1 / 창 둘레 턱 Z 19), 참고 키캡 착좌 +6.0, B 쿠폰 행 C 1.7 | 사용자 결정(계획 문서 §0). 커버 부피·돌출 축소 목적 |
| 2026-11-06 | `72d3ea1` | 안전마진: 다리 자석 포켓 위 살 1.0 → 1.3(바닥 Z 16.4) | 사용자: "의심되는 부분은 안전마진 추가" |
| 2026-11-07 | `7b252f3` | **커버를 평판 Z 19(6T)로 되돌림**, mount–plate 받침 7곳 추가 | **사용자 결정(2026-11-09 확인).** r2 P4·P5가 평판이라 r2 외관을 따름. 두 단 커버·안전마진(위 두 행)은 이 결정으로 폐기. 다리 자석 포켓 위 살은 3.9로 늘어 안전마진 문제도 해소. 투명 레진 커버 부피는 두 단 커버보다 큼(수용) |
| 2026-11-07 | `f41bda4`, `91ec26c`, `9c79cb5` | Phase 1 mount: WEB 5개 억제, 팔각 랜드 8.5, 직선 레일, 핀 회피부 | 구조 개선 계획 1단계. `74aebb5`에서 재구축 |
| 2026-11-07 | `7744368` | Phase 2: Ctrl 브래킷 립 4·스톱·게이트 핑거 억제 | 구조 개선 계획 2단계. `b52c50f`에서 재설계 |
| 2026-11-09 | `b52c50f` (`decision:`) | **Pro Micro 브래킷 재설계(Phase 2): 게이트·M2×5·너트 폐지, 스냅 고정**(+X 끝 립, USB 양옆 모서리 턱, 탄성 암 2). plate L의 브래킷 M2 구멍 (125, 17)·(125, 25) → (121.7, 18.96)·(121.7, 25.16), 게이트 홈 2곳 메움. 생성기 `tools/ctrl_v5.py`, 주문 1에 시험편 3종 | 사용자 요청(2026-11-09: 부품·나사 축소, 생성기로 재구축, PCB 고정 복원; 고정 방식은 판단 위임 → 스냅 제안, 외부 검토 2회 반영해 진행 동의). `7744368` 뒤로 PCB를 −Z·X로 잡는 형상이 없었다. 5–12번 핀 양쪽 16선 배선과 긴 변 전체 홈은 양립하지 않고, 앞 M2 너트 보스가 배선 5번 패드 위에 있었다. plate는 주문 전이라 재출력 없음 |
| 2026-11-09 | `74aebb5` (`decision:`) | **mount 4개를 DXF에서 직접 돌출하는 구조로 재구축.** 팔각 랜드 둘레 홈(0.3 mm 링·우측 1.5 mm 해자) 폐지, 핀 회피부를 배열에서 계산, Rear spine 받침 Z 3.95 복원, 우측 두 번째 plate 받침 생성, v4 mount 사슬·REF 스위치 외피·Wilmore 하우징을 생산 모델에서 억제 | 사용자 보고(2026-11-09): 우측이 옛 형상으로 회귀, Front에 V자 홈 반복, 타임라인이 느림. 원인은 옛 바디 위에 clip∩old+fill 패치를 겹치는 생성 방식(DXF 윗레일 폭 10.67 → 생성 9.3–10.4, x≈155에 0.3 mm 슬롯, Rear 받침 3.95 → 3.3, 우측 받침 2 미생성). 0.3 mm 링 홈은 MJF로 출력되지 않아 폐지. 평가 시간 48 s → 약 16 s, mount 단독 2 s |
| 2026-11-09 | `9bacd26` | **plate 뒤 다리 3곳 추가**(PSD60 뒤 벽 보스 ①②③ 위, 틈 0.5 + 패드). 구조 개선 3단계(mount와 브래킷·spine 병합) 폐기 | 사용자: "case outside에 보면 boss가 있던데 이거랑 plate가 닿을 수 있도록", 위치는 판단 위임("적당히 알맞게 위치 정해줘"). 병합은 사용자: "정비성 저하가 크리티컬". 보스 위치·높이는 제품 사진 추정과 r2 P0 근거의 가정(M22 미측정). plate는 주문 전이라 재출력 없음, 주문 1 출력물 바이트 불변 |
| 2026-11-10 | `decision: 46es plate 뒤 다리를 별도 받침 블록으로, plate 출력 support 제거` | **plate 뒤 다리 3곳을 plate에서 떼어 별도 받침 블록 3개로**(14 × 4 × 4.5, 보스 ①②③ 위에 패드로 붙이고 plate 뒤 플랜지가 얹힘). plate L/R은 다리 추가 전 형상(출력 높이 12.5 → 8). 주문 1에 블록 높이 3종(4.2 / 4.5 / 4.8) 각 3개 | 사용자 보고(2026-11-10): "leg를 추가했는데 출력에서 support가 필요하게 돼서 leg를 별도 부품으로". 어느 공정·업체에서 나온 지적인지는 확인하지 못했다. 블록을 케이스 쪽에 두는 것과 주문 1 높이 변형은 계획의 권장안이며 사용자가 그대로 진행을 지시했다. 받치는 위치·하중 경로·분해 방식은 `9bacd26` 그대로다 |
| 2026-11-10 | `decision: 46es plate 앞 이음을 곧은 반턱과 닫힌 너트 포켓으로, 이음 쿠폰 3쌍` | **plate 앞 이음 재설계.** dovetail tab → 위에서 얹는 곧은 반턱 + 끝 걸림 턱(tab 끝 X 142.9 → 147.4, 여유 0.15), M2 (139.5, 6.6) → (140.4, 6.6), 열린 너트 포켓(맞변 4.4, 깊이 1.0) → 닫힌 눌러 끼움 포켓(맞변 4.0, 깊이 1.3). Front mount 받침 1의 Ø5.1 구멍이 나사를 따라 이동. 이음과 쿠폰을 `tools/seam_v5.py`로 옮기고, 주문 1 이음 쿠폰을 plate 복사·절단 1쌍에서 변형 3쌍(S0·S1·S2)으로 | 사용자 요청(2026-11-10): "plate 체결 방식 개선". validation.md 「plate L/R 앞 이음 및 하중 경로」의 출발안(직선 반턱 2.4, 턱 0.15, M2×5 1개)을 따랐다. 측면 삽입 너트 포켓은 R 바닥 살 2.6으로는 벽 1.0을 지킬 수 없어 닫힌 눌러 끼움 포켓으로 바꿨다(판단: Claude, 계획 문서 「핵심 위험」). spine·M3 6개·받침 7곳은 그대로다. 실물 합격은 주문 1 쿠폰 대기 |
| 2026-11-11 | `decision: 46es 커버 로고를 Xifiction 폰트 kb46es/26으로` | **커버 L 로고 `46es`(각진 단일 획, 높이 2.8·살 1.0) → Xifiction 폰트 `kb46es/26`**(같은 자리, 높이 2.0·폭 15.5·획 0.5·틈 0.25). 레진 살 기준 1.0 → 로고 영역만 예외. 보스 탭 시험 음각은 실제 크기와 1.6배(획 0.8·틈 0.4) | 사용자 요청(2026-11-11: 폰트·문자열 변경, 위치 후보 중 "A로 하는데 크기 줄여줘"). 폰트 출처 dafont |
| 2026-11-10 | `decision: 46es 커버 실루엣 창 채택, 높이 Z 19 유지` | **커버 창을 키별 여유 사각형에서 키 블록 실루엣 윤곽 2개로 단순화**(실제 키캡 폭 셀 20.35, 외곽 살 1.1, 다리 자석 포켓과 1.15). 윗면 Z 19·두께 6 유지 | `7b3c569`가 실루엣 창(r2 칸 폭 셀 16)과 Z 18.5를 생성기에만 넣고 CAD·출력물은 재생성하지 않았다. 사용자 결정(2026-11-10): 실루엣 창만 main에 채택, 높이 후보(Z 18.5·18)는 `codex/46es-cover-plate-trial`에서 시험. 셀 16은 키캡 간격 0.31(요구 1.0, 46개 중 30개 키 미달)이라 사용자 선택으로 셀을 키움: 키캡 18.05 + 2×1.0 + 래스터·단순화 오차 0.3. 셀을 r2 칸 폭으로 두면 19번(1.5u 칸, 1u 키캡) 창이 오른쪽 끝까지 가서 립에 0.28 살이 남아 실제 키캡 폭으로 바꿨다. 9·31·40번이 외곽 1.16 안까지 와서 살 1.6 → 1.1(옛 창의 최소 살과 같음). L 다리 자석 포켓 벽이 0.98이 되어 창을 포켓에서 1.15 떨어뜨림(plate 포켓은 그대로). 결과: 키캡 간격 쉴 때·눌림 1.021, 커버 최소 벽 1.059–1.098, 다리 자석 벽 1.137. 커버 3조각만 바뀌고 plate·spine·브래킷·주문 1은 바이트 불변 |
| 2026-11-11 | `decision: 46es 커버 분할을 실루엣 창으로, r2 P4 분할 윤곽 폐지` | **커버 L/T/R 분할 절삭을 r2 P4 창 윤곽에서 실루엣 창 + 곧은 분할 띠로 바꿈**(9·31번 위, 22·40번 아래). 실루엣 창 윤곽의 잔 꺾임·짧은 계단 정리. 부피 L 15.167 → 15.570, T 14.031 → 14.187, R 15.378 → 15.757 cm³(창 밖에 남던 r2 윤곽만큼 살이 늘어남), 최소 벽 T 1.059 → 1.098 | 사용자 요청(2026-11-11: "cover 형상 more simplier 하게 … pgup, pgdn, left ctrl, e, i key 주변"). 원인은 실루엣 창 채택(2026-11-10) 뒤에도 남은 r2 P4 분할 윤곽(`cover_v5.SPLIT_CUTS`)이었다. 창과 최대 2.3 mm 어긋나 PgUp·PgDn 둘레(r2 사각 창), 20번(왼쪽 Ctrl) 옆 홈(X 19–23), E·I 위 조각 끝에 계단을 만들었다. 키캡 간격 1.021·창 외곽 살·다리 자석 벽은 그대로, 커버 3조각만 바뀌고 plate·mount·spine·브래킷·주문 1 출력물은 불변 |
| 2026-11-11 | `decision: 46es spine을 Rear mount 프레임에 직접 얹고 Rear spine shim 받침 폐지` | **spine 줄기 밑면 Z 4 → 3.05(두께 4.5 → 5.45), Rear mount의 spine shim 받침(Z 2.5–3.95, 6 × 5.45) 삭제.** 줄기가 Rear 프레임 윗면 Z 3에 틈 0.05로 얹혀 접촉 24 → 116 mm²(길이 6 → 약 40 mm). H02 케이스 나사머리 위만 옛 밑면 Z 4로 회피, 배선 홈 윗면 Z 6 유지(`spine_wire_H` 2 → 2.95). 부피 spine 1.691 → 1.806, Rear mount 1.592 → 1.561 cm³ | 사용자 요청(2026-11-11): "spine가 center mount랑 접하고 있는데 center mount와의 접점을 늘릴 수 있도록 두께를 조정하고 center mount에서 지지대는 제거". center mount는 spine 바로 밑의 Rear(H02·SO3), 지지대는 `74aebb5`에서 복원한 spine shim 받침으로 읽었다. 두께는 줄기 높이(Z)로 읽었다: 폭(X)을 넓히면 왼쪽 Rear plate 받침과 0.78밖에 남지 않는다. 도면의 `REAR_SHIM` 레이어도 지웠다. 틈 0.05는 지지대 6개가 정한 plate 높이와의 과구속을 피하는 값으로 그대로 두고, 조립 때 필름 shim으로 맞춘다. plate·커버·브래킷·다른 mount 3개 출력물은 불변, Rear mount는 주문 1·spine은 주문 2(둘 다 발주 전) |
| 2026-11-12 | `decision: 46es SO 지지대를 보유 M3 인서트 보스로, 위 나사를 보유 M3×10으로` | **SO 6곳의 황동 육각 지지대(길이 6, 맞변 5)·mount 육각 포켓(AF 5.4 × 1)·아래 M3×5를 없애고, mount에 Ø8 보스(Z 1.5–8)를 세워 보유 원형 황동 M3 인서트(Ø5 × 4)를 열압입(구멍 Ø4.2 × 5).** 위 나사 M3×4 → 보유 흑색 M3×10(인서트와 프레임을 지나 mount 밑 0.5). spine SO3 회피 Ø6.8 → 8.6. 부피 mount L 3.923 → 4.313, R 3.951 → 4.344, Rear 1.561 → 1.759, Front 2.190 → 2.389, spine 1.806 → 1.774 cm³. 주문 1 B 쿠폰 행 D 육각 포켓 4개(AF 5.2–5.8) → 인서트 구멍 4개(Ø4.0–4.6). 도면의 SO 육각 머리 자리 6개 삭제, 기반 타임라인의 지지대 참조 형상·포켓 매개변수 삭제 | 사용자 요청(2026-11-12): "보유한 재고 부품을 최대한 활용하도록 수정". 보유 육각품(`3×10`·`3×14` 표기, 맞변 5)은 표기대로면 길이 10/14라 Z 2–8에 들어가지 않고, 보유 흑색 볼트(사용자 확인 M3×10)는 지지대 구조에서는 아래 나사와 부딪힌다(위·아래 끝 사이 0.5). 인서트 보스안을 제안했고 사용자가 골랐다. 지지대 6·아래 나사 6·위 나사 6의 구매가 없어진다. plate는 그대로(카운터보어·구멍·밑면 Z 8), 케이스 장공·받침 7곳·핀 회피부도 그대로(회피부는 바이트 단위로 같은 윤곽). 정비 방식(M3 6개를 풀어 plate 모듈을 꺼냄)도 같다. 구멍 지름·열압입 상태는 주문 1(B 쿠폰·mount 4개)에서 확인한다. 남은 인서트 14개는 46sp 몫이다 |
| 2026-11-11 | `decision: 46es M2 나사를 ISO 7380 버튼헤드로, 앞 이음 머리 자리 1.4` | **M2 나사 7개를 저두(NBK SSH-M2-5/6, 머리 Ø4 × 1.1)에서 ISO 7380 버튼헤드(머리 Ø3.5–3.8 × 1.3)로 바꿈.** 앞 이음 머리 카운터보어 깊이 1.2 → 1.4(머리 윗면 Z 12.9 유지, 머리 아래 tab 살 1.2 → 1.0 = MJF 최소 벽). spine·브래킷 M2 자리(Z 10.2)는 머리 윗면 Z 11.5로 여유가 커서 형상 그대로다. 대조군 쿠폰 S0는 v4 깊이 1.2 유지. 참조 나사 머리도 Ø3.8 × 1.3으로. 같은 날 구매품 표를 알리 일반품 기준으로 고쳤다(지지대 맞변 5 확인, 위 M3는 흑색 합금강, 자석 니켈 도금, 에폭시 다이소) | 사용자: "구하기 쉬운 부품에 맞춰서 설계를 변경했으면 하는데". 저두 M2는 NBK 같은 전문품이고 알리 "ultra thin"은 치수가 판매처마다 다르다. DIN 7984 저두(머리 1.35)는 옛 1.2 자리에서 plate 윗면 위로 나온다. 버튼헤드는 M3와 같은 묶음으로 살 수 있다 |

정리로 현행 트리에서 뺀 v1~v4 문서·검토 출력·검증 기록은 태그 `46es-pre-cleanup-2026-11-06`(= `72d3ea1`)에서 찾는다. 예: `git show 46es-pre-cleanup-2026-11-06:46es/docs/v5-plan-two-level-cover-2026-11-06.md`. 2026-11-09 정리로 뺀 계획·작업 보고서(`planning.md`, `assembly-revision.md`, `mount-redesign-plan.md`, 11-04 보고서 2개), 초기 스케치 모델(`46es_draft_sketches.sc`, `parameters.csv`), 지그 A, 옛 쿠폰 출력은 태그 `46es-pre-cleanup-2026-11-09`(= `5e62a0a`)에 있다. 작업 방식 개선 계획(`docs/improvement-plan.md`, 2026-11-10)은 끝난 뒤 지웠다. 코드 주석의 `plan 3-4` 같은 번호는 그 계획의 항목이며 `git show 0700a0b:46es/docs/improvement-plan.md`로 본다. 남은 plate 생성 코드 전환은 [validation.md](validation.md)의 「채택 및 반영」에 있다. 뒤 받침 블록·앞 이음 작업의 계획 문서(`plate-fastening-plan.md`, 2026-11-10)는 작업을 마치고 지웠다. 커밋 `decision: 46es plate 뒤 다리를 별도 받침 블록으로, plate 출력 support 제거`에 들어 있다(`git log --grep "뒤 다리를 별도 받침" -- 46es`로 찾아 `git show <커밋>:46es/docs/plate-fastening-plan.md`).
