zzskm/keyboard/46es/docs/work-report-2026-11-04.md

> **역사 문서(현행 v5 기준 아님).** 이 문서는 작성 당시의 계획/실험/검토 기록이다. 현재 설계·제작·검증 판단은 [README](../README.md), [설계](design.md), [검증과 다음 작업](validation.md), [v5 제작 세트](../model/print_v5/README.md)를 우선한다. 필요한 결정/근거만 현행 문서로 옮긴다.

# 46es 작업 보고서 — 2026-11-04

브랜치 `46es-r2-inspection`. 이 문서는 2026-11-04 하루 동안 모델·자료·결정이 어떻게 바뀌었는지 요약한다. 세부 근거는 각 링크의 파일에 있다.

## 1. 요약

| 구분 | 결과 |
|---|---|
| 하우징 대용 바디 | `The_Wilmore.stl`(GH60 호환 60% 케이스, PSD60 아님)에서 치수 22개를 추출해 SolidCraft에 `REF_HOUSING_WILMORE_NOT_PSD60` 바디를 만들었다. 하우징 `TBD_` 13개가 이 값을 참조한다 |
| 부품 초안 바디 | 프레임·스탠드오프·plate·커버 4개를 하우징 안에 세웠다(`*_DRAFT_TBD`). 스위치 홀 46개, 커버 키 창 46개 포함 |
| B 단계 시험 쿠폰 | 스위치 홀 13.7–14.3 × 걸쇠 구조 2종 + M2 구멍 4종 쿠폰을 설계하고 STL/STEP으로 내보냈다(미발주) |
| 결정 기록 | M11 아크릴 홀 실측 생략, M18 FDM·JLCPCB 후보, M19 Gateron KS-3 Milky Yellow, M15/M16 패널형 USB 연장 케이블 접착 |
| 참고 자료 분석 | `v2 keychain.step`(압입 테스터), `3x3Fidget v11.stl`(Printables 1077722, "fit well") |
| 커밋 | `5b4ddc8`, `c2c2e71` (+ 이 보고서) |

모델 현황: 매개변수 109개, 스케치 9개(모두 자유도 0), 바디 5개, 타임라인 오류 0. **실측 항목 M01–M21은 아직 0개 완료**이며, 모든 `TBD_`·`CAND_`·`REF_` 값은 미확정이다.

## 2. 하우징 대용 바디 (Wilmore)

- 분석: `inspection/wilmore/README.md`. STL을 numpy로 단면·원 맞춤해 내측 286.381 × 95.934, 코너 R2.5, 지지대 높이 6.196, 테두리 12.17/11.89, USB 개구 11.2 × 7.1 등을 읽었다. 경사 4.633°를 제거한 PCB면 기준 좌표다.
- 모델: SK40(측면 단면)·SK41(기둥 6개) + 피처 4개. 부피 297,430 mm³, 메시 대비 내벽 0.01·외곽 0.15 이내.
- 주의: Wilmore 내측 폭 286.381은 r2 plate 286.4보다 좁다. 기둥 Ø5.0은 r2의 회피 구멍 Ø4.5와 맞지 않는다. 기둥 위치는 GH60 후보 좌표와 최대 0.52 차이. 모두 PSD60 실측(M01·M08·M10)에서 확인할 항목이다.

## 3. 부품 초안 바디

| 바디 | Z 범위 | 내용 | 따르는 매개변수 |
|---|---|---|---|
| `FRAME_DRAFT_TBD` | 0 → 3 | SK10 외곽 통판, 케이스 구멍 6, 스탠드오프 구멍 6 | `TBD_frame_T`, `CAND_H0n`, `REF_SO_*` |
| `STANDOFFS_DRAFT_TBD` | 3 → 8 | 원기둥 6개(육각 4.7 외접 Ø5.43) | `TBD_standoff_H`, `TBD_so_AF`, `TBD_pcb0_*` |
| `PLATE_DRAFT_TBD` | 8 → 13 | 5T + 스위치 홀 46개(14.0, r2 회전각) | `TBD_plate_T`; 홀 위치는 고정 숫자 |
| `COVER_DRAFT_TBD` | 13 → 21 | 벽 2 쉘(아래 개방) + 키 창 46개(20.0) | `TBD_cover_H`, `TBD_cover_wall`; 창 위치는 고정 숫자 |

- 높이 2개는 **가정값**이다: `REF_draft_standoff_H = 5`, `REF_draft_cover_H = 8`. `TBD_standoff_H`·`TBD_cover_H`가 이를 참조하므로 실측(M05·M14·M17) 후 식만 숫자로 바꾸면 된다.
- 스위치 홀·키 창은 r2 DWG P3 개구부 46개의 중심·회전각을 DXF(`inspection/derived/REF_r2_keys_sq14_gh60.dxf`, `sq20`)로 넣은 고정 스케치(SK22·SK32)다. 매개변수를 따르지 않으며 현물 대조(M12·M20) 전까지 참고값이다.
- 검증: 프레임 81,444.7 = SK10 면적 × 3, plate 90,796.8 = SK20 면적 × 5 − 44 × 14² × 5(템플릿 홀 2개가 실제 키와 일치해 중복), 스탠드오프 693.7, 커버 28,123.1 mm³.
- 당시 중간 렌더는 후속 파일 정리에서 삭제했다. 현재 형상 이미지는 [model/README.md](../model/README.md)의 최신 렌더를 참조한다.

### 초안에서 드러난 점

1. **커버는 키 사이에 리브를 둘 수 없다.** 1u 키캡 18 + 간격 1×2 = 20 > 피치 19.05라 인접 창이 겹친다. 커버 개구부는 클러스터(블록·행) 단위가 되고, 리브는 좌우 블록 경계와 행 사이 각도 차 구간에만 남는다. 1.25u/1.75u/2u 키(펌웨어 JSON 기준 각 1개)는 창 폭을 따로 잡아야 한다.
2. 가정 스택(3 + 5 + 5)에서 plate 상면 13은 Wilmore 뒤 테두리 11.9보다 1.1 높다. PSD60 테두리 실측(M05) 후 스탠드오프 값으로 조정한다.
3. 프레임은 아직 통판이다. 중앙 창·리브·USB 접착 자리·컨트롤러 자리는 다음 단계다.

## 4. B 단계 스위치 홀 쿠폰 (`model/samples/`)

- 145.35 × 50.1 × 10 mm. 7열(홀 13.7 → 14.3, 0.1 간격) × 2행.
  - 행 A(모따기 쪽): 상면 1.5 아래 걸쇠 노치(편측 1.0 × 길이 8 × 높이 1.5, 4변) + 아래 14 우물 — 3×3 fidget 방식 재현.
  - 행 B: 상면 1.5 아래 16.5 개방 포켓 — 비교군.
  - +Y 여백: Ø2.0/2.2/2.4/2.6 (M2 나사 여유·자가 탭).
- 두께 10은 JLC3DP FDM 최소 부품 크기 30 × 30 × 10 때문. 끼움 거동은 상면 1.5 + 노치 1.5만 관여한다.
- 파일: `46es_sw_hole_sample.sc`(매개변수 15개, 피처 41개), `.stl`(3,252 삼각형, 닫힘, 부피 40,294.7), `.step`, 렌더 2장, `README.md`(시험 절차).
- 출력 방향: 홀 쪽 상면을 베드에. 재료는 최종 plate와 같은 것으로.
- 게이트: `model/README.md` §4 B 단계 입력(M11·M18·M19)은 사용자 결정으로 채웠고, 걸쇠 치수는 쿠폰이 직접 시험한다. STL 내보내기는 사용자 승인 후 진행했다.

## 5. 결정 기록 (`model/measurements.csv`)

| ID | 결정 | 비고 |
|---|---|---|
| M11 | 기존 아크릴 홀은 실측하지 않음. r2 DWG 14.000 × 13.999를 출발값으로 | 레이저 커프 공차와 FDM 공차는 별개 |
| M18 | FDM, 업체 후보 JLCPCB(JLC3DP), 재료 미정(PLA-P 언급) | JLC3DP 가이드: 치수 ±0.3(≤100)·±0.4%, 구멍 ±0.4, 최소 벽 1.6@50×50, 조립 틈 0.5, 최소 부품 30×30×10, 돌기·스냅 1.5 초과 권장 |
| M19 | Gateron KS-3 Milky Yellow (Pro), 5핀 PCB 마운트형, MX 호환 하우징 | 공식 도면 미확보. 걸쇠 폭·위치·플랜지는 실물 측정 필요 |
| M15·M16 | Pro Micro → 패널형 USB 연장 케이블 → PSD60 개구부에 글루스틱/핫글루 고정 | 커넥터 종류·암쪽 하우징 L×W×H·케이블 길이 미확인(판매처 이미지 링크만 받음, 자동 수집 불가) |

## 6. 참고 자료 분석 (`inspection/switch_tester/README.md`)

| 파일 | 무엇 | 쓰임 |
|---|---|---|
| `v2 keychain.step` (Fusion, 2024-10) | 20 mm 셀 8개 스위치 테스터 키체인. 13.75 포켓 압입, 플랜지 자리 16.8 × 0.8, 걸쇠 릴리프 ±X Z 7.43–9.33 | 인터넷 다운로드·출력 여부 모름 → 보정 기준점으로 쓰지 않음. 걸쇠 위치 범위(플랜지 아래 1.25–3.15)만 참고 |
| `3x3Fidget v11.stl` (Printables 1077722) | 3×3 셀, 피치 19.0. **홀 14.0, 걸쇠 남김 1.4, 노치 16 × 8 × 1.5 4변, 아래 14 우물 5.6** | 댓글 "fit well". 46es "5T + 국부 박육" 방식과 같은 원리 → 쿠폰 행 A의 원형 |

두 파일 모두 타인 저작물이라 리포지토리에 넣지 않았다(SHA-256은 보고서에 기록).

## 7. 공정 관련 주의 (JLC3DP FDM)

1. 구멍 공차 ±0.4는 스위치 홀 14.0에 비해 크다 → 쿠폰 범위를 13.7–14.3으로 잡았다.
2. 1.5T 걸쇠부는 권장 벽두께(돌기·스냅 1.5 초과) 아래다 → 5T 구조부 + 국부 박육 방식이 맞고, 샘플 검증이 필수.
3. 최소 부품 30 × 30 × 10 — 두께 5의 plate 단품이 이 규칙에 걸리는지 업체에 확인. MJF(PA12, 구멍 ±0.3, 최소 벽 1.0)는 plate 대안으로 열어 둠.

## 8. 다음 단계

| 순서 | 할 일 | 누가 |
|---|---|---|
| 1 | 쿠폰 주문(재료 선택) → 끼움·걸쇠·나사 결과를 M18에 기록 | 사용자 |
| 2 | PSD60 실측 M01–M10·M16 (A 단계 7개 우선) | 사용자 |
| 3 | USB 연장 케이블 커넥터 규격 전달 | 사용자 |
| 4 | 쿠폰 결과로 plate에 걸쇠 노치·우물 추가, 커버 창을 클러스터 단위로 재작성, 프레임 중앙 창·리브·접착 자리 | 모델 |
| 5 | 실측값으로 `TBD_` 식 교체 → 재빌드 → A 단계 시험 지그 STL | 모델 |

관련 문서: [`model/README.md`](../model/README.md)(매개변수·게이트·재개 절차), [`model/samples/README.md`](../model/samples/README.md), [`inspection/wilmore/README.md`](../inspection/wilmore/README.md), [`inspection/switch_tester/README.md`](../inspection/switch_tester/README.md).
