zzskm/keyboard/46es/docs/plate-fastening-plan.md

# plate 체결 방식 개선 계획

작성 2026-11-10, 기준 `main` `4def425`, 작업 브랜치 `46es-plate-seam`. 상태: **1단계·L단계 완료(2026-11-10, F1 받침 블록 14 × 4 × 4.5, 주문 1 높이 변형 4.2 / 4.8), 다음은 2단계.** D1–D5는 권장안으로 진행한다(사용자 "작업 진행해줘").
두 가지를 다룬다. (가) [validation.md 「커버 및 plate L/R 개선 계획」](validation.md#커버-및-plate-lr-개선-계획) 2·3절의 앞 이음 개선, (나) plate 뒤 다리 3곳을 plate에서 떼어 별도 부품으로 바꾸는 것(사용자 요청 2026-11-10). 끝나면 결과를 design.md·validation.md에 옮기고 이 파일은 지운다(AGENTS.md §7).

## 0. 시작 전에 사용자가 정할 것

수행 세션 첫머리에 아래 다섯을 확인한다. 답이 없으면 권장안으로 진행한다.

| 결정 | 권장안 | 다른 선택 |
|---|---|---|
| D1. 범위 | **앞 이음(L/R 반턱 + M2 1개 + 너트)만 고친다.** spine·M3 6개·받침 7곳은 현행 유지 | spine 체결(M2 4 + 낱개 너트 4)까지 같이 고침. 작업량 약 2배, spine 재출력 |
| D2. 너트 고정 방식 | 3단계 단면 검토 결과로 정한다(아래 「핵심 위험」). 1순위 후보는 R 아랫면 국부 보스 + 잡힌 너트 | 열압입 인서트 M2, 또는 현행 아랫면 포켓에 빠짐 방지 턱만 추가 |
| D3. 주문 1 구성 | 이음 쿠폰을 현행(대조군) + 후보로 늘린다. 주문 1은 아직 발주 전이라 세트 교체가 가능 | 현행 쿠폰만 먼저 발주하고 후보는 다음 시험 주문으로 |
| D4. 뒤 다리 부품의 고정 위치 | **케이스 쪽에 둔다(F1).** 보스 위에 놓는 받침 블록이고 plate 뒤 플랜지가 그 위에 얹힌다. plate에는 다리 관련 형상이 남지 않는다 | plate 쪽에 붙임(F2, 에폭시 + 위치 턱), mount를 보스까지 연장(F3). 아래 「뒤 다리」 표 |
| D5. 뒤 다리 부품의 주문 | 주문 1에 높이 변형과 함께 넣는다. 보스 위치·높이(M22)를 mount 시험 때 같이 확인할 수 있다 | 주문 2에 한 가지 높이만 |

## 1. 여섯 가지 (AGENTS.md §2)

1. **목적:** plate R 안쪽을 잡는 체결을 조립하기 쉽고 공차에 덜 민감하게 만든다. 같은 작업에서 plate를 생성 코드로 옮긴다. plate 뒤 다리는 출력에 support가 필요해져(사용자 보고 2026-11-10) plate에서 떼어 별도 부품으로 바꾼다.
2. **기준:** `main` `4def425`, 현행 CAD `model/46es_mount_seam_v5.sc`. 작업 브랜치 `46es-plate-seam`(새로 만든다).
3. **범위:** 설계(plate L/R 앞 이음, Front mount 너트 자리, 이음 쿠폰, 뒤 다리 3곳 → 별도 부품), 생성기, 출력물, 검증, 가이드, 문서.
4. **보존:** 키 중심·회전·외곽(r2), 스위치 홀 3층(1.7 / 1.5 / 1.8), SO1–SO6 위치와 카운터보어, 커버 립 단차, 뒤 가장자리를 케이스 뒤 벽 보스 ①②③으로 받치는 하중 경로(부품만 바뀐다), 다리 자석 포켓, 브래킷 M2 구멍, spine 자리와 M2 4개(D1 권장안), **위 M3 6개만 풀어 plate 모듈을 통째로 꺼내는 정비 방식**, plate는 기준 부품(끼움 오차는 상대 부품에서 흡수).
5. **원본:** `tools/build_seam_v5.py`, `model/seam_v5_base.json`, 새 `tools/plate_v5.py`, `tools/mounts_v5.py`(`SEAM_NUT_CLEARANCE`), `tools/hardware_v5.py`, `tools/parts_v5.py`. 따라 바뀌는 것: 현행·검토 CAD, CSV, 주문 1·2 출력물, 형상 기준, 검증 기록, 가이드.
6. **완료 조건:** `pipeline.py --run` 전 단계 통과, `verify_seam_v5.py --accept` 차이가 plate L/R·이음 쿠폰·Front mount·참조 나사·새 뒤 다리 부품뿐, 가이드 시각 검토(이음 단계·완성 상태), `finish.py` 통과, `decision:` 커밋, main 병합 뒤 가이드 게시. 실물 합격은 `실물 확인 대기`로 남긴다.

## 2. 현행 구조 (2026-11-10 확인)

출처는 `model/seam_v5_base.json`의 피처와 `model/parameters_seam_v5.csv`다. CAD를 열어 단면을 본 것은 아니다.

- **분할선:** 가운데는 X 130.881(`split_center_X`), Y < 11과 Y > 83.5에서는 X 136.881로 +6 우회한다(`split_SO_bypass`). 틈 0.5(`split_plate_gap`).
- **M3 귀속:** SO3·SO6이 X 130.881이라 우회 때문에 둘 다 **L에 속한다.** R에 직접 걸리는 M3는 SO4(250.42, 89.0)·SO5(278.52, 6.52) 두 개뿐이고 둘 다 오른쪽 끝이다. R은 폭 약 154 mm인데 안쪽 가장자리에는 M3가 없다. validation.md 2-1의 가정이 맞다.
- **R 안쪽을 잡는 것:** 앞 이음 1곳, spine(M2 4개, Y 38–87 구간), mount 받침.
- **앞 이음:** L의 tab(X 136.3–142.9, Y 3.0–10.2, 뿌리 쪽이 0.6 좁은 dovetail, 윗면에서 2.4 두께)이 R 포켓에 위에서 얹힌다. 옆 여유 편측 0.15. M2는 (139.5, 6.6), 머리 카운터보어 깊이 1.2(머리 윗면 Z 12.9, 커버 밑면 Z 13).
- **너트:** R 아랫면 육각 포켓 깊이 1.0(`seam_nut_D`)에 낱개 M2 너트(두께 1.6)를 넣는다. 너트가 0.6 아래로 나오고 포켓은 이음면 쪽으로 열려 있다(`SEAM_FRONT_NUT_OPEN_R_MJF`). 조립 때 너트를 밑에서 받치고 있어야 한다. Front mount 받침 1에는 이 너트 자리로 Ø5.1 구멍이 있다(`mounts_v5.SEAM_NUT_CLEARANCE`).
- **이음 쿠폰:** plate L/R과 참조 나사·너트를 Y −60으로 복사해 상자(X 118–150, 폭 22.2)로 잘라 만든다. plate를 고치면 자동으로 따라온다. 후보를 여러 개 두려면 이 방식으로는 안 된다.
- **plate 사슬:** 기반 타임라인 81개 피처가 전부 plate 관련이다. r2 스케치 4개(외곽, 스위치 홀, 위 개구, 아래 릴리프), 카운터보어·립 단차·분할·spine 자리·플랜지·앞 이음·MJF 보정 절삭, 쿠폰 복사, 그리고 사이에 끼인 참조 바디(억제된 하우징·스위치 외피, 컨트롤러·USB 점유 영역, 지지대 참조).

### 문제로 보는 점

| # | 문제 | 근거 |
|---|---|---|
| P1 | 너트가 잡히지 않는다. 포켓이 얕고(1.0 < 1.6) 옆이 열려 있다 | 위 「너트」 |
| P2 | dovetail 여유 0.15가 MJF 공차(±0.3 mm)보다 작다. plate는 다듬지 않는 부품이라 빡빡하면 풀 방법이 없다 | AGENTS.md §5, design.md |
| P3 | R 안쪽 앞 모서리의 들뜸·회전을 M2 1개와 tab 옆면이 맡는다. tab 옆면은 0.6 물림뿐이다 | 스케치 좌표 |
| P4 | 이음 치수가 스케치 고정 좌표다. 매개변수 `seam_*`를 바꿔도 tab·포켓 윤곽은 따라오지 않는다 | `SK_SEAM_FRONT_TAB_V4` 점이 수치 |

### 핵심 위험: 너트 포켓 두께

validation.md 2-3의 "측면 삽입식 육각 너트 포켓"은 현행 두께에서는 벽이 모자란다. R 포켓 바닥 살은 `TBD_plate_T − seam_tab_T` = 5 − 2.4 = **2.6 mm**다. 너트 1.6에 여유를 준 슬롯 1.8을 넣으면 위아래 살이 합쳐 0.8, 한쪽 0.4로 MJF 최소 벽 1.0에 못 미친다. tab을 2.0으로 줄여도 한쪽 0.6이다. 이 계산은 매개변수 값으로만 한 것이므로 3단계 단면에서 다시 확인한다.

갈 수 있는 방향:

| 안 | 내용 | 걸리는 점 |
|---|---|---|
| N1 (1순위) | R 아랫면에 국부 보스를 내려 두께를 확보하고(예: 밑면 Z 8 → 약 5.5) 그 안에 측면 삽입 슬롯 | 보스가 Front mount 받침 1 자리로 내려간다. 받침의 Ø5.1 구멍을 보스 윤곽 + 여유로 넓힌다(mount는 조정 부품이라 원칙에 맞음). 받침 접촉 면적 감소, 앞 이음 옆 스위치 핀과의 간격 확인 |
| N2 | 열압입 인서트 M2(외경 약 3.2–3.6, 길이 3 안팎) | 살 2.6에 길이가 빠듯하다. PA12 열압입 조건·인서트 실물 치수 확인 필요, 구매품 추가 |
| N3 | 현행 아랫면 포켓 유지, 깊이를 1.6 이상으로 하고 입구 턱으로 빠짐만 막음 | 위 살이 1.0 이하로 줄어든다. 턱이 0.3–0.4 수준이라 MJF로 나올지 쿠폰으로만 알 수 있다 |
| N4 | 방향을 뒤집어 L tab 쪽에 너트, R 아래에서 나사 | 위에서만 풀어 꺼내는 정비 방식을 깨므로 **채택하지 않는다** |

시험으로도 R 안쪽이 기준을 넘으면 validation.md의 순서(턱 방향·거리 조정 → M2 2개 → spine·Rear shim)를 따른다. R 안쪽에 M3 지지대를 하나 더 두는 안은 "M3 6개" 정비 방식과 r2 볼트 위치를 바꾸므로 사용자 결정 없이는 하지 않는다.

### 뒤 다리 (현행과 변경 방향)

현행(`tools/build_seam_v5.py` `REAR_FEET`, `9bacd26`): plate 뒤 플랜지(Y 92.97–94.97, Z 5–8)에서 길이 14 × 폭 2의 다리 3개를 Z 0.5까지 내렸다. 플랜지 밑에서 4.5 내려온 얇은 판이다. L에 2개(X 37·113), R에 1개(X 170). 케이스 뒤 벽 보스 윗면(가정 Z 0)과 틈 0.5를 패드로 메운다. 이 다리 때문에 plate 출력 높이가 8에서 12.5로 늘었다(`print_v5/README.md` 부품 표).

**문제(사용자 보고 2026-11-10):** 다리를 넣은 뒤 plate 출력에 support가 필요해졌다. plate는 `윗면이 아래` 방향 MJF로 기록되어 있고 MJF는 보통 support가 없으므로, 수행 세션에서 **어느 공정·업체 견적에서 나온 지적인지** 한 줄로 확인해 결정 이력에 적는다. 원인이 무엇이든 다리를 떼면 plate는 `9bacd26` 이전의 높이 8 형상으로 돌아가 문제가 없어진다.

**변경:** 다리 3개를 plate에서 지우고 같은 역할을 하는 작은 부품 3개로 만든다. 보스 ①②③ 위 받침이라는 하중 경로와 "얹히기만 한다"는 분해 방식은 유지한다. `9bacd26` 결정을 바꾸는 것이므로 `decision:` 커밋이다.

| 안 | 내용 | 장점 | 걸리는 점 |
|---|---|---|---|
| F1 (권장) | **보스 위 받침 블록.** 케이스 보스 윗면에 놓고(양면 테이프 또는 점착 패드) plate 뒤 플랜지 밑면 Z 5가 그 위에 얹힌다. 블록은 케이스에 남는다 | plate에 형상이 전혀 없다. 높이를 블록에서 조절하므로(높이 변형 출력, 다시 뽑아도 싸다) 패드 선택이 블록 선택으로 바뀌고 "어긋남은 plate 밖에서 흡수" 원칙에 더 맞는다. 정비 방식 그대로 | 보스 윗면은 벽에 반쯤 묻힌 Ø9 반원이라 붙일 면적이 작다. 위치를 잡을 형상(뒤 벽에 기대는 면, 보스를 감싸는 턱)이 필요한데 보스 치수가 사진 추정이다(M22) |
| F2 | **plate에 붙이는 다리.** 플랜지 밑면에 얕은 위치 홈이나 턱을 두고 다리를 에폭시로 붙인다 | plate 모듈과 함께 움직인다 | 플랜지 폭이 2라 위치 형상을 둘 살이 거의 없다. plate에 접착 작업이 생기고 높이 조절은 다시 패드로 돌아간다 |
| F3 | **mount 연장.** 가까운 mount를 보스 위까지 늘려 받침을 만든다 | 부품 수가 늘지 않는다 | mount 도면(DXF) 4개 중 해당 mount를 고쳐야 하고, 보스 ①②③ 근처에 mount가 있는지 먼저 확인해야 한다(④는 이미 우 mount 밑). mount 장공 조정과 보스 위치가 묶인다 |

F1의 출발 치수: 받침면 길이 14(현행 다리와 같음, 보스 위치 오차 ±2 수용), 높이 = 플랜지 밑면 Z 5 − 보스 윗면 Z 0 − 접착층. 높이 변형은 공칭과 ±0.3 정도 세 가지를 먼저 본다. 폭은 플랜지 2보다 넓게 잡아 플랜지가 블록 위에서 벗어나지 않게 하되, 맨 뒷줄 스위치·배선과 간격 1.0을 지킨다. 최소 벽 1.0. 이 수치들은 매개변수 값에서 계산한 출발값이며 L단계의 CAD 간격 검사로 확정한다.

## 3. 작업 순서

각 단계는 그 단계의 검증이 통과한 뒤 커밋한다. 형상이 바뀌는 커밋은 둘이다: L단계(뒤 다리)와 4단계(앞 이음). 순서는 1 → L → 2 → 3 → 4 → 5 → 6 → 7이다. L단계는 앞 이음과 독립이라 먼저 끝내고, 이음 작업이 길어지면 L단계만 따로 main에 병합할 수 있다.

### 1단계. 준비

1. `git fetch`, `main`이 `4def425` 이후 바뀌었는지 확인하고 `46es-plate-seam` 브랜치를 만든다. `git config user.email`이 zzskm noreply인지 본다.
2. `origin/codex/46es-cover-plate-trial`은 옛 기준에서 갈라진 커버 높이 시험이다. 커버 밑면 높이가 바뀌면 이음 나사머리 여유(현행 0.1)에 영향이 있으므로 그 브랜치의 진행 여부만 확인하고 파일은 가져오지 않는다.
3. `pipeline.py --status`가 전부 ok인지 확인한다. 낡은 단계가 있으면 원인을 먼저 본다.

### L단계. 뒤 다리를 별도 부품으로

다리는 이미 생성 코드(`build_seam_v5.py`의 `PLATE_REAR_FOOT_{i}_V5` box join)라 2단계의 plate 이전과 무관하게 고칠 수 있다. 아래는 F1 기준이다.

1. `build_seam_v5.py`: plate에 join하던 다리 피처 3개를 없애고, 같은 X 위치에 새 바디 `REAR_REST_{1,2,3}_V5`를 만든다(이름은 구현 때 확정). `REAR_FEET`의 plate 귀속은 "어느 plate 플랜지가 얹히는가"로 의미가 바뀐다. `v5_rear_foot_*` 매개변수는 블록 치수로 이름·설명을 고치고 `v5_rear_foot_gap`은 접착층 두께로 바꾸거나 없앤다. `rear_foot_plan`·`rear_foot_clearance`·`rear_foot_volume`을 블록 기준으로 고친다: 블록 ↔ mount·스위치 참조 형상 간격 1.0, 플랜지 밑면과의 접촉 면적, 보스 위치 ±2에서 블록 밑면이 보스 윗면에 걸치는 폭.
2. 뒤 플랜지 구간 확인: 블록 위에 플랜지가 실제로 있는지(`PLATE_FLANGE_L_REAR` X 30–120, `PLATE_FLANGE_R_REAR_A` X 142–238). 현행 다리 위치 X 37·113·170은 구간 안이다.
3. `parts_v5.py`에 부품 행을 더한다(MJF 검정, 출력 방향은 넓은 면이 아래). D5 권장안이면 주문 1에 높이 변형 3종 × 필요 수량, 주문 2에는 채택 높이 3개. 높이 변형을 시험 모델에 둘지 현행 모델에 둘지는 스냅 시험편(`ctrl_trials_v5.sc`) 구조를 따른다.
4. `build_assembly_reference_v5.py`: 검토 모델의 보스 참조(`REF_PSD_REAR_BOSS_*`)와 블록의 관계를 갱신한다. `verify_assembly_reference_v5.py`의 `rear_boss_within_1mm`·다리 항목을 "블록 밑면 ↔ 보스 윗면 접촉, 블록 윗면 ↔ 플랜지 밑면 접촉, 겹침 없음"으로 바꾼다.
5. `check_repository.py`의 `DESIGN_ROWS` 「plate 뒤 다리」 행을 새 매개변수 식으로 고친다. `smoke_test.py`가 다리 부피를 쓰는지 확인한다.
6. `pipeline.py --run` → `verify_seam_v5.py --accept`. 허용되는 차이: `PLATE_L_SPLIT_V1`·`PLATE_R_SPLIT_V1`(다리 3개 부피만큼 감소, 상자 Z 하한 0.5 → 5), 새 블록 바디 추가, `v5_rear_*` 매개변수. plate L/R의 부피 감소량이 `rear_foot_volume`의 옛 값과 맞는지 대조한다. **mount 4개, 커버, spine, 브래킷, 이음 쿠폰, 스냅 시험편은 불변이어야 한다.**
7. 문서·가이드: design.md 「현행 치수」의 plate 뒤 다리 행과 보스 문단, 결정 이력 한 행(`9bacd26`을 바꾸는 이유 = support, 공정·업체 확인 내용), validation.md 「뒤 벽 보스·plate 뒤 다리」 행(틈 측정 → 블록 높이 선택), `print_v5/README.md` 부품 표(`doc_tables.py --write`, plate 높이 12.5 → 8)·시험 절차 6번, `guide_v5.json`의 plate 설명·뒤 다리 단면 캡션·plate L/R 부품 메모("뒤 다리 2"/"뒤 다리 1")·mount 시험 단계 문구, 새 부품의 가이드 부품 표와 `assembly_v5.json` 참조. 조립 순서에 "블록을 보스에 붙인다"를 mount 장착 단계 근처에 넣는다.
8. 가이드 시각 검토(뒤 다리 단면, mount 시험 단계, 완성 상태) → `finish.py` → 커밋 `decision: 46es plate 뒤 다리를 별도 받침 블록으로, plate 출력 support 제거`.

D4에서 F2·F3를 고르면 1·3·4번이 달라진다. F2는 plate에 위치 형상이 남으므로 2단계 뒤로 미루는 편이 낫고, F3는 `mounts_cadcraft_phase1.dxf`와 `mounts_v5.py`가 원본이 된다.

### 2단계. plate를 생성 코드로 (형상 불변 시도)

목표는 커버·spine·하드웨어 때와 같다. 기반 피처를 **같은 순서·같은 식으로** `tools/plate_v5.py`가 만들게 하고 BRep이 그대로인지 확인한다.

1. `tools/plate_v5.py`를 만든다. 81개 피처를 순서 그대로 내보낸다. r2 스케치 4개의 곡선 수백 개는 코드에 풀지 않고 데이터 파일(`model/plate_r2_sketches.json` 등, 한 줄에 곡선 하나)로 두고 읽는다. 사이에 끼인 참조 바디(하우징·점유 영역·지지대·스위치 외피)는 순서를 지키기 위해 같은 모듈에서 내보내거나 별도 함수로 나누되 타임라인 위치는 바꾸지 않는다.
2. `seam_v5_base.json`에는 매개변수만 남긴다. `BUILD_INPUTS`에 새 파일을 넣는다.
3. `build_seam_v5.py --refresh-record`로 확인한다. 모든 바디 BRep이 같으면 CAD를 그대로 두고 생성 기록만 갱신해 **형상 불변 커밋**으로 끝낸다.
4. BRep이 달라지면 원인(피처 id, 이름 순서, 스케치 평면 식)을 찾는다. 반나절 안에 못 맞추면 이 단계의 코드만 남기고 4단계의 형상 변경 커밋에 합친다. validation.md가 이미 이 경우를 허용한다. 기대값을 새 결과로 덮어 통과시키지 않는다.

여기서는 r2 스케치를 DXF 직접 돌출로 바꾸지 않는다. 형상이 미세하게 달라져 검증 범위가 plate 전체로 커진다.

### 3단계. 현행 단면과 하중 경로 (설계 전 산출물)

validation.md 0절·2-1의 산출물이다. CAD만 읽고 형상은 바꾸지 않는다.

1. 단면 3장을 뽑는다: Y 6.6(앞 이음 나사 축), X 139.5(같은 축의 세로 단면), Y 42(spine). 각 단면에 plate L/R, Front mount 받침, 인접 스위치(참조 형상), 커버, 나사·너트를 함께 표시한다. `guide/review_guide.py`의 `sec_seam` 카메라와 가이드 렌더 `sec-seam`을 먼저 쓰고, 부족하면 SolidCraft MCP로 연다(생성 CAD는 고치지 않는다).
2. 수치로 확인할 것: 나사머리 ↔ 커버 밑면, 너트·나사 끝 ↔ Front mount, tab·포켓 둘레의 스위치 홀까지 잔여 벽, R 바닥 살 2.6, 브래킷 지붕과의 거리, 앞 플랜지(`PLATE_FLANGE_R_FRONT`, X 140부터)와의 관계.
3. R 밑면에 닿는 받침을 표시한다. 받침 7곳 중 R 아래 것과 이음에서의 거리, Rear shim 접촉 여부. `verify_seam_v5.py`의 받침 접촉 검사 결과(`seam-v5-clearance.json`)를 읽는다.
4. 결과로 D2(너트 방식)를 정한다. N1이 벽·간격을 지키면 N1, 아니면 N2·N3 순으로 본다. 판단이 갈리면 사용자에게 단면과 함께 묻는다.

### 4단계. 후보 설계와 생성기 반영

1. **이음을 매개변수화한다.** `plate_v5.py`에서 tab·포켓 윤곽을 `seam_*` 매개변수 식으로 만든다(P4 해소). 출발값은 validation.md 2-2 그대로다: 위에서 끼우는 **직선 반턱 2.4**, 위치결정 턱 편측 **0.15**, 저두 **M2×5 1개**. 턱은 스위치와 잔여 벽 1.0을 지키는 범위에서 나사에서 가장 먼 곳에 둔다.
2. **너트 고정**을 3단계에서 정한 안으로 만든다. N1이면 R 아랫면 보스·슬롯·밀어내기 구멍, `mounts_v5.SEAM_NUT_CLEARANCE`를 원에서 보스 윤곽 + 여유로 바꾼다. 실제 너트 치수(대변 4.0, 두께 1.6)가 출발값이고 여유는 쿠폰 변수다.
3. **이음 쿠폰을 변형별로 만든다.** 복사 + 자르기 방식을 버리고 스냅 시험편 A·C와 같은 구조로 간다. 쿠폰 생성 함수가 매개변수 묶음을 받아 L/R 쌍을 만들고, 본체 plate와 같은 함수를 쓴다. 시험 모델은 `model/ctrl_trials_v5.sc`에 넣을지 새 `model/seam_trials_v5.sc`로 둘지 구현 때 정한다(새 파일이면 `.gitattributes` LFS, `parts_v5.py`, `verify_seam_v5.py`의 `TRIALS`, 정적 검사 경로를 함께 고친다).

   | 쿠폰 | 형상 | 목적 |
   |---|---|---|
   | S0 | 현행 dovetail + 현행 너트 포켓 | 대조군 |
   | S1 | 직선 반턱, 턱 여유 0.15, 너트 여유 기본 | 채택 후보 |
   | S2 | S1에서 턱 여유만 0.25 | 턱 여유 비교 |
   | S3 | S1에서 너트 포켓 여유만 한 단계 넓힘 | 너트 여유 독립 비교 |

   S0를 남기려면 현행 dovetail 윤곽을 코드에 보존해야 한다. 쿠폰 수가 부담이면 S3를 빼고 S1의 반대쪽에 너트 포켓을 하나 더 두는 방법을 검토한다.
4. 본체 plate에는 S1을 넣는다. 쿠폰 시험 뒤 치수가 바뀌면 그때 다시 `decision:` 없이 치수 변경 커밋으로 반영한다(같은 결정의 조정).
5. 참조 나사·너트(`REF_M2_SEAM_FRONT*`)를 `hardware_v5.py`로 옮기고 새 위치를 따르게 한다.
6. 생성기 안 검사를 추가한다: tab·포켓·보스 둘레 최소 벽 1.0, 스위치 홀과의 간격, 너트 삽입 경로가 막히지 않음, 분말이 빠질 구멍. mount 쪽은 기존 "절삭 옆 1 mm 미만 재료 조각이면 중단" 검사가 넓힌 구멍에도 걸리는지 본다.

### 5단계. 재생성과 CAD 검증

1. `pipeline.py --run`. 순서대로 seam → print → verify_seam → assembly → verify_assembly → review.
2. `verify_seam_v5.py --accept`의 차이 목록을 읽는다. 허용되는 변화: `PLATE_L_SPLIT_V1`, `PLATE_R_SPLIT_V1`, 이음 쿠폰 바디(추가·이름 변경), `MOUNT_*` 중 Front 하나, 참조 나사·너트, `seam_*` 매개변수. **커버 3조각, spine, 브래킷, 나머지 mount 3개, 스냅 시험편, B 쿠폰은 바이트 불변이어야 한다.** 다른 바디가 바뀌었으면 멈추고 원인을 찾는다. 차이 목록은 커밋 메시지에 적는다.
3. 벽 스캔(`seam-v5-mjf-thin-wall.json`, `seam-v5-trial-thin-wall.json`)에서 plate L/R과 쿠폰의 최소 벽 ≥ 1.0. 모서리 광선의 짧은 값과 실제 벽을 구분한다.
4. `verify_seam_v5.py`의 mount 단면 비교는 Front mount의 기준 프로파일이 `mounts_v5`에서 나오므로 구멍을 넓힌 것이 기준에도 반영되는지 확인한다. 받침 접촉 면적이 줄어든 만큼 기록한다.
5. `verify_assembly_reference_v5.py`: Front mount와 스위치 핀 하한 0.4 유지.
6. `doc_tables.py --write`로 `print_v5/README.md` 부품 표 갱신.

### 6단계. 가이드·문서

1. `guide/guide_v5.json`: 앞 이음 단면 캡션(Y 6.6), `st-seam`, 「앞 이음은 나사 1개」 항목, 공차 흡수 표의 이음 행, 부품 메모(plate L/R, 이음 쿠폰), 주문 1 목록, 조립 단계의 너트 넣는 순서. `seam_hw` 바디 묶음과 `assembly_v5.json`의 부품 참조가 새 바디 이름과 맞는지 본다.
2. 시각 검토: `review_guide.py --steps standoff trial module --views reset iso`에 이음 단계를 더해 캡처하고 판정을 보고에 적는다.
3. `design.md`: 「체결·분해」의 앞 이음 문단, Front 받침의 너트 자리 문장, 기준/변경 경로(plate_v5.py), 결정 이력 한 행(커밋 칸에 `decision:` 제목).
4. `validation.md`: 실물 확인 목록 「앞 이음」 행을 쿠폰 S0–S3 비교로 바꾸고, 「커버 및 plate L/R 개선 계획」 2절은 남은 실물 시험과 합격 기준만 남긴다. 3절의 plate 생성 코드 문단과 「재생성」의 기반 파일 설명을 현행으로 고친다.
5. `print_v5/README.md`: 부품 표, 구매품(M2 너트 수량·인서트 여부), 시험 절차 2번, `AGENTS.md` §4 표의 "v5 형상" 원본 칸에 plate_v5.py가 필요한지 확인.
6. 이 계획 문서를 지우고 design.md 끝의 정리 문단에 `git show <커밋>:46es/docs/plate-fastening-plan.md`를 한 줄 남긴다.

### 7단계. 마무리

1. `finish.py` → 커밋(제목 `decision: 46es plate 앞 이음을 …`) → 브랜치 push → main 병합 → `publish_guide.py`. 병합·게시는 수행 세션에서 사용자 확인을 받는다.
2. 메모리 `reference-46es-guide-page`의 게시본 기준 커밋을 갱신한다.

## 4. 실물 시험 (주문 1 뒤, 이 계획의 범위 밖)

합격 기준은 validation.md 2절 표를 그대로 쓴다. 요약:

- 쿠폰 삽입: 나사 없이 손으로 5회 중 5회 완전 착좌.
- 너트 유지: 나사를 뺀 채 뒤집어 흔드는 10회 동안 이탈 0, 위에서 조일 때 공회전 0.
- 단차 0.20 이하, 10회 탈착 뒤 단차·면내 유격 증가 각 0.10 이하, 포켓 균열 없음.
- 본 출력 뒤 R 안쪽 열 5 N 하중: L/R 상대 변위 0.20 이하, 잔류 0.10 이하.
- 위 M3 6개만 풀어 모듈을 통째로 꺼낼 수 있음.

## 5. 위험과 멈출 조건

| 위험 | 대응 |
|---|---|
| 2단계에서 BRep이 달라짐 | 원인 추적 반나절 한도. 넘으면 4단계 커밋에 합침 |
| N1 보스가 Front 받침 접촉을 너무 줄이거나 스위치 핀 0.4를 깸 | N2·N3 비교, 그래도 안 되면 사용자에게 단면과 함께 보고 |
| 직선 반턱의 턱이 스위치 홀 벽 1.0을 못 지킴(앞 모서리–커버 창 약 8 mm) | 턱 위치를 Y 방향으로 옮기거나 tab 폭 축소. 현행 dovetail 유지 + 너트만 개선으로 범위를 줄이는 것도 허용 |
| 보스 치수가 사진 추정이라 F1 블록의 위치 형상이 실물과 안 맞음 | 위치 형상은 뒤 벽에 기대는 평면 정도로 최소화하고 X 방향은 길이 14의 여유로 흡수. 주문 1에 넣어 M22 실측과 함께 확인 |
| support 지적이 다리 때문이 아님(다른 형상·다른 공정) | L단계 착수 전에 지적 내용을 확인. 다리를 떼도 남는 원인이면 사용자에게 보고 |
| `--accept` 차이에 의도하지 않은 바디 | 진행 중단, 생성기 원인 수정. 기준을 덮지 않음 |
| 커버 높이 시험 브랜치가 먼저 병합됨 | 나사머리 ↔ 커버 밑면 여유를 새 높이로 다시 확인 |

## 6. 수행 세션의 첫 행동

이 문서와 `46es/AGENTS.md`를 읽고, D1–D5를 사용자에게 한 번에 확인한 뒤 1단계부터 진행한다.
