zzskm/keyboard/46es/docs/improvement-plan.md

# 작업 방식 개선 계획 — 효율·시간·구조·자동화

검토일 2026-11-10, 기준 `main` `3425038`. 대상은 46es의 **작업 도구와 절차**이며 키보드 형상은 다루지 않는다(형상 계획은 [validation.md](validation.md)).

이 문서는 임시 계획이다. 항목을 끝내면 규칙은 [AGENTS.md](../AGENTS.md), 명령은 [validation.md](validation.md)·[guide/README.md](../guide/README.md)에 반영하고, 전부 끝나면 이 파일을 지운다(AGENTS.md §7).

표기: **실측** = 이번 검토에서 직접 실행·집계한 값, **판독** = 코드를 읽고 판단했으나 실행하지 않은 것, **추정** = 효과 예상치.

## 1. 요약

| 순위 | 문제 | 근거 | 대응 |
|---|---|---|---|
| 0 | **main의 생성기와 커밋된 CAD가 다르다.** 정적 검사와 CI는 통과한다 | 실측 (§2.1) | 단계 0: 정합 복구 + 생성 기록 검사 |
| 1 | 커밋마다 붙는 고정 비용이 크다 | 46es 커밋 69개 중 64개가 `manifest.json` 수정, "해시 기입" 후속 커밋 3개, 형상 변경 한 번에 수동 명령 15개 | 단계 1·2: 마무리 한 명령, manifest 폐지, 파이프라인 진입점 |
| 2 | 한 번 고치면 전부 다시 돈다 | 전체 빌드 91–103 s, 같은 입력으로 다시 빌드해도 CAD 해시가 달라져 하위 기록 전부가 낡음 | 단계 3: 이중 평가 제거, 부분 빌드, 형상 지문 기준 무효화 |
| 3 | 같은 정보가 여러 곳에 손으로 적혀 있다 | 부품 표 5곳, 검증 기대값 리터럴, CLI 경로 7곳, 명령 목록 5개 문서 | 단계 4: 부품 레지스트리, 검증 기대값 분리, 문서 표 생성 |

**진행(2026-11-10):** 순서 1(1-1, 1-4)과 순서 2(0-2, 0-1) 완료. 0-1은 실루엣 셀 16이 키캡 간격 0.31이라 사용자 선택으로 셀 20.35·실제 키캡 폭·외곽 살 1.1·다리 자석 포켓 회피로 바꿔 채택했다([결정 이력](design.md#결정-이력)). 순서 3(1-2, 1-3, 1-5, 1-6), 순서 4(3-3, 3-5: 주문 1·2 STL/STEP 바이트 동일), 순서 5(2-1 – 2-5와 단계 5의 두 규칙), 순서 6(3-1, 3-2 중 `--ctrl`, 3-7) 완료. `--covers`는 커버가 v4 타임라인에서 나와 4-5로 넘겼다. 순서 7(3-4, 3-6, 4-1) 완료: 빌드 38 s(처음 약 100 s), 형상이 같은 부품은 다시 내보내지 않는다. 3-8(우선순위 낮음)은 하지 않았다. 순서 10(§4 결정 6, v5 정본화 1단계) 완료: 생성기가 v4 원본 대신 `model/seam_v5_base.json`(v4 기능 428개 중 206개, 모든 바디 BRep 동일)을 읽고, 검증 기준을 v5 형상 지문 `inspection/data/seam-v5-baseline.json`과 `verify_seam_v5.py --accept`로 바꿔 `model/baselines/`(18 MB)를 지웠다(4-3 전부, 4-2의 기준·accept 부분). 타임라인 599 → 377, 주문 1·2 STL/STEP·가이드 렌더 동일. 순서 11 완료: 4-2 나머지(형상 기준에 매개변수 평가값 `values`를 더하고 검증기의 커버 T 6·윗면 Z 19·살 3.9·키캡 Z 17.3·돌출 5.0 리터럴 삭제, CSV 값 열 대조), 4-4(정적 검사가 `print_v5/README.md` 부품 표와 `design.md` 현행 치수 52개 수치를 기록·기준과 대조. 첫 실행에서 주문 2 브래킷 부피 1.64 → 1.57을 찾음). 가이드의 낡은 수치 4곳(커버 두께 5 → 토큰, 위 다리 폭 2.7–3.6 → 실루엣 창 실측 2.5–2.8·약 23 mm, 앞 이음 창까지 6.5 → 약 8, 앞 mount 69.8 → `{{l:}}` 토큰 68.6)도 고쳤다. 순서 12 완료: 4-5 2단계 중 커버 3조각·spine을 `tools/cover_v5.py`·`tools/spine_v5.py`로 옮겼다(기반 피처 206 → 164, 65개 바디 BRep·주문 1·2 출력물 동일). 덕분에 `--covers`(약 9 s, 생산 CAD와 BRep 동일 확인)가 생겼다(3-2 나머지). 3-8: 브래킷 검사의 keep-out 반복 계산 제거(1.85 → 0.1 s, 빌드당 4회), 실루엣 창 입력 해시 캐시(2.5–4.5 → 0.03 s). 4-4 다음 단계: `print_v5/README.md` 측정 칸을 `tools/doc_tables.py`가 기록에서 쓰고 정적 검사가 같은 함수로 대조한다(`design.md`는 문장 속 수치라 대조만). 순서 13 완료: 4-6은 사용자 결정으로 Git LFS(생성 CAD `model/*.sc` 3개, 이전 커밋은 그대로, CI는 LFS 객체 캐시, LFS 포인터를 받으면 정적 검사가 안내). 4-5 3단계: 참조 하드웨어(나사·너트·자석 62개 피처)를 `tools/hardware_v5.py`로 옮기고 만들었다 지우던 겹침 나사 사슬 21개를 없앴다(기반 피처 164 → 81, 65개 바디 BRep 동일). 남은 것은 4-5의 plate다. 외곽·구멍·개구부가 r2 도면 스케치(곡선 수백 개, 기반의 약 290 kB)이고 plate 절삭이 그 사이에 끼어 있어 순서를 옮기면 BRep이 같다고 보장할 수 없다. 도면(DXF)에서 직접 돌출하는 mount 방식으로 바꾸면 형상이 미세하게 달라져 주문 1 출력물이 바뀌므로, 주문 1 결과로 plate를 고칠 때 함께 한다.

§4의 다섯 항목은 2026-11-10에 결정됐다. 실행 순서는 §6이다. 단계 3·4의 나머지는 단계 2의 단계별 시간 기록을 보고 순서를 다시 정한다.

## 2. 현황 진단

### 2.1 main이 어긋나 있다

`7b3c569`가 `tools/build_seam_v5.py`만 바꿨다(커버 윗면 Z 19 → 18.5, 창을 실루엣 윤곽으로 단순화). 생성물은 다시 만들지 않았다.

| 대상 | main의 상태 |
|---|---|
| 생성기 `build_seam_v5.py` | `v5_skirt_cover_H` 1.2 → 커버 윗면 Z 18.5, 두께 5.5, `v5_cover_silhouette_*` 매개변수 5개 추가 |
| `model/46es_mount_seam_v5.sc`, `parameters_seam_v5.csv` | `v5_skirt_cover_H` 1.7, 윗면 Z 19, 실루엣 매개변수 없음 (실측) |
| `print_v5/`, `review_v5/`, 검토 모델, 가이드, `design.md` 치수 표 | Z 19 기준 |
| `verify_seam_v5.py` | `v5_cover_top_Z == 19`, `TBD_cover_T == 6`, `NEW_PARAMS` 고정 목록. 재생성한 CAD에서는 실패한다 (판독) |
| `check_repository.py`, CI | 통과 (실측). 생성기 → CAD 고리를 기록하지도 검사하지도 않는다 |

현재 생성기는 빌드된다: `--probe`로 캐시에만 빌드해 Z 18.5·두께 5.5·오류 없음을 확인했다(실측, 작업 트리 변경 없음). 즉 다음 작업자가 mount만 고치려고 `build_seam_v5.py`를 실행해도 커버가 Z 18.5로 바뀐 CAD가 나오고 검증이 막힌다. [validation.md](validation.md)의 계획은 Z 18.5를 "첫 후보"로 두고 실측·시험 뒤 채택한다고 적었으며, `design.md` 결정 이력에는 기록이 없다.

원인은 두 가지다. 시험 변경이 브랜치가 아니라 main에 들어갔고, 그걸 잡을 검사가 없었다. 검토 모델은 `assembly_reference_v5.json`에 `generator_sha`를 남기지만 생산 CAD에는 같은 기록이 없다.

### 2.2 커밋마다 붙는 고정 비용

- **manifest.json**: 46es 커밋 69개 중 64개가 수정했다(실측). 절차는 `git add` → `update_manifest.py` → `git add manifest.json` → `--check` 네 단계이고 `--check`만 9.8 s 걸린다(실측, 파일 185개를 `git cat-file`로 하나씩 읽음). 내용은 **git 인덱스에서 계산한** 경로·크기·SHA-256·blob SHA라서 git 트리의 사본이다. git이 못 잡는 변경을 잡을 수 없고, 읽는 곳은 CI의 자기 검사뿐이다. 병행 브랜치는 전부 이 파일을 고치므로 병합 때마다 충돌한다.
- **결정 이력의 커밋 해시**: 결정 커밋 뒤에 "해시 기입"만 하는 후속 커밋이 3개(`d36b6c8`, `6115719`, `4b7ffc9`), 이력 재작성 뒤 해시 참조를 고친 커밋이 1개(`cae5fe9`) 있다. 후속 커밋마다 manifest 갱신과 push가 따라붙는다.
- **수동 명령 사슬**: AGENTS.md §10 기준 형상 변경 한 번에 생성·내보내기·검증 5개, 조립 검토 3개, stage·manifest·검사 6개, 게시 1개로 15개다. 어느 단계가 낡았는지는 사람이 기억한다. 같은 명령 목록이 AGENTS.md, validation.md, guide/README.md, model/README.md, README.md 다섯 곳에 있다.
- **환경 준비**: `PYTHONUTF8=1`을 매번 직접 설정해야 한다. SolidCraft CLI 경로가 7개 파일에 하드코딩돼 있고 `--cli`는 가이드만 받는다.
- **검증 JSON의 가짜 diff**: `verify_seam_v5.py`가 `set`을 순회해 dict를 만든다. `7b3c569`의 `seam-v5-verification.json` 변경은 키 순서뿐이었다(실측).

### 2.3 시간

전체 빌드 `build_seam_v5.py --probe` 2회 실측: 103 s, 91 s (SolidCraft 다른 세션이 떠 있는 상태).

| 구간 | 시간 | 비고 |
|---|---:|---|
| Python 준비 | 약 18 s | 실루엣 래스터 4.5 s, 브래킷 검사 1.9 s × 3 |
| CLI `run --save` | 39–41 s | 타임라인 695개 평가(204개는 억제) |
| CLI `eval` | 약 44 s | 방금 저장한 모델을 **다시 평가** |

평가 시간 구성(2026-11-09 캐시의 `eval_v5.json`, 합 33.4 s): CTRL 12.1 s, PLATE 11.8 s, MOUNT 2.1 s, COVER 1.9 s, REF 1.4 s, 기타 4.0 s. CTRL은 브래킷 B와 시험편 A·C를 같은 모델에서 세 번 만든다. PLATE는 v4 타임라인 끝에 붙인 join이 비싸다(뒤 다리 3개가 0.9–1.4 s씩).

- **재현되지 않는 바이트**: 같은 입력으로 두 번 빌드한 CAD의 SHA-256이 서로 달랐다(실측, seed도 다름: zip 타임스탬프). 하위 기록은 모두 CAD **파일** 해시에 묶여 있어(`source_sha256`, `v5_sha`, `model_sha`, 렌더 캐시 키) 형상이 같아도 다시 빌드하면 내보내기·벽 스캔·검증·검토 모델·렌더 20장이 전부 낡은 것으로 처리된다.
- **이중 내보내기**: `review_v5/`를 읽는 코드는 `verify_seam_v5.py`뿐이다. plate L/R과 커버 3개는 `review_v5`와 `print_v5/order2`로 두 번 내보내고 벽 스캔도 두 번 한다.
- **모델을 여러 번 연다**: 빌드 run, 빌드 eval, 검토 내보내기, 주문 2, 주문 1, 검증 eval, 검증 run이 각각 CLI를 띄워 8.8 MB 모델을 연다. 가이드는 렌더마다 10 MB 검토 모델을 연다.
- **캐시 구현 4종**: `cad_eval_cache.evaluation()`(해시 키), `build_seam_v5.evaluate()`, `build_guide.model_eval()`, `verify_seam_v5`의 수정 시각 비교·존재 여부 검사. 뒤의 방식은 체크아웃 순서에 따라 낡은 평가를 읽을 수 있다. tools 스크립트가 `guide/.cache/v5`에 쓰고, 정리하는 코드가 없어 `guide/.cache` 241 MB, `out` 69 MB, `out_publish` 47 MB가 쌓여 있다(실측).

정적 검사 `check_repository.py`는 5.6 s다(실측). 내보내기·검증·가이드 단계의 시간은 이번에 재지 않았다(추적 파일을 덮어쓰기 때문). 단계 2에서 계측한다.

### 2.4 구조

- **v4 기준 + 패치**: 생성기는 `baselines/seam_v4.sc`의 타임라인에서 204개를 억제하고 뒤에 피처를 붙인다. 피처 ID(7–11, 242–244)를 숫자로 참조한다. mount와 브래킷은 이미 처음부터 생성하는 구조로 옮겼고, plate·커버·spine이 v4 타임라인에 남아 있다.
- **검증 기대값이 리터럴**: `verify_seam_v5.py`에 Z 19, 두께 6, 살 3.9, 새 매개변수 목록, 바뀐 바디 집합, gate relief 부피 산술이 손으로 적혀 있다. 설계를 바꿀 때마다 검증기도 손으로 고쳐야 하고, 고치는 순간이 AGENTS.md §5가 경계하는 "통과시키려 기대값을 바꾸는" 지점과 구분되지 않는다.
- **기준 모델이 예외 산술로 유지된다**: `flat_Z18.sc`(9.4 MB)는 검증 전용인데, plate는 이미 "기준 대비 차이 = 뒤 다리 부피 + gate relief"로만 비교한다.
- **부품 표가 여러 곳에**: `export_print_v5.PARTS`·`TRIAL_PARTS`, `export_seam_v5_review.PARTS`, `verify_seam_v5.PRINT_SET_FILES`·`TRIAL_STL`, `guide_v5.json`의 printed, `print_v5/README.md` 표(크기·부피·최소 벽은 손으로 옮긴 값).
- **공통 코드 미분리**: `sha()` 정의 11곳, `write_text` 30곳 중 `newline` 지정 4곳(AGENTS.md §10이 경고하는 CRLF 해시 불일치의 원인).
- **CI**: Ubuntu에서 manifest와 정적 검사만 돈다. 의존성 버전을 고정하지 않았다. SolidCraft 없이 돌 수 있는 순수 Python 생성 논리(mount 윤곽, 브래킷 검사)는 검사하지 않는다.
- **저장소 용량**: 추적 중인 `.sc` 5개가 40 MB, `.git` 244 MB. 재생성할 때마다 8.8 MB + 10 MB가 새로 쌓인다.

## 3. 계획

모든 도구 변경의 공통 완료 조건: **주문 1·2 출력물(STL/STEP)의 SHA-256이 변경 전과 같다.** 도구를 고치다 형상이 바뀌면 안 된다.

### 단계 0 — main 정합 복구

| ID | 작업 | 완료 조건 |
|---|---|---|
| 0-1 | **실루엣 창만 main에 채택하고 높이는 Z 19로 되돌린다**(§4 결정 1). 생성기의 `v5_skirt_cover_H`를 1.7로 되돌리고(윗면 Z 19, 두께 6) 주석의 Z 18.5 표기를 고친다. 커버 3조각이 바뀌므로 CAD·CSV·주문 2 출력물·검증 기대값(`NEW_PARAMS`에 `v5_cover_silhouette_*` 5개)·검토 모델·가이드를 한 작업에서 갱신하고, 참고 키캡과 창 간격 1.0 유지를 `verify_assembly_reference_v5.py`로 확인한다. 가이드 시각 검토와 게시까지 한다. `decision:` 커밋으로 남기고 `design.md` 결정 이력에 경위를 적는다. 높이 후보(Z 18.5·Z 18)는 `codex/46es-cover-plate-trial` 브랜치에서 계속 시험한다 | main에서 `build_seam_v5.py --probe` 결과가 커밋된 CAD와 같은 매개변수·바디 부피를 낸다. 주문 1 출력물 해시는 그대로다 |
| 0-2 | 생성 기록을 추가한다. `build_seam_v5.py`가 입력 8개(`build_seam_v5.py`, `mounts_v5.py`, `ctrl_v5.py`, `make_key_dxf.py`, `mounts_cadcraft_phase1.dxf`, `features_by_panel.json`, `46es_kbfirmware.json`, `baselines/seam_v4.sc`)와 출력의 해시를 `model/seam_v5_build.json`에 쓰고, `check_repository.py`가 대조한다. Python 원본은 `ast.dump` 해시로 비교해 주석만 고친 경우는 통과시킨다 | 생성기만 고친 커밋을 CI가 막는다(§2.1 상황을 재현해 확인) |

0-1은 형상 변경이라 §3 첫머리의 공통 조건에서 주문 2 커버 3조각만 예외다. plate·spine·브래킷과 주문 1 출력물은 바이트가 그대로여야 한다. 0-2를 먼저 넣고 0-1을 하면 0-1의 재생성이 새 검사의 첫 통과 사례가 된다.

### 단계 1 — 커밋 고정 비용 제거

| ID | 작업 | 효과(추정) |
|---|---|---|
| 1-1 | **manifest.json 폐지**(§4 결정 2). `manifest.json`, `update_manifest.py`, CI 단계, 문서 4곳(AGENTS.md, README.md, validation.md, model/README.md)의 절차를 지운다. 출처 추적은 0-2의 생성 기록과 기존 기록(`source_sha256` 등)이 맡는다. `inspection/46es_r2_dwg_inspection.md`의 manifest 언급은 과거 판독 기록이므로 그대로 둔다 | 커밋당 명령 4개·약 10 s 제거, 병행 브랜치의 상시 충돌 제거 |
| 1-2 | 공통 모듈 `tools/common.py`: `ROOT`, CLI 경로(`SOLIDCRAFT_CLI` 환경변수 → 기본 경로), `sha()`, LF로 쓰는 `write_json()`(키 정렬), stdout UTF-8 설정. CLI 경로 7곳, `sha()` 11곳, `write_text` 26곳을 바꾼다 | `PYTHONUTF8` 수동 설정 불필요, CRLF 해시 불일치 원인 제거 |
| 1-3 | 검증 JSON을 결정적으로 쓴다(`set` 순회 → `sorted`). 다시 실행해도 내용이 같으면 diff가 없어야 한다 | 가짜 diff와 그에 따른 커밋 제거 |
| 1-4 | 결정 이력 표의 커밋 칸을 해시 대신 `decision:` 커밋 제목으로 적는다(§4 결정 3). 표 머리말과 AGENTS.md·CLAUDE.md의 관련 문장을 맞춘다. 0-1의 행부터 적용한다. 조회는 `git log --grep "^decision:" -- 46es`. 기존 행은 그대로 둔다 | 결정당 후속 커밋 1개 제거, 이력 재작성에도 참조가 안 깨짐 |
| 1-5 | 마무리 명령 `tools/finish.py`: stage 범위 확인 → 정적 검사 → `git diff --cached --check` → `git config user.email`이 zzskm noreply인지 확인 → AGENTS.md §10의 종료 보고 다섯 줄 틀 출력 | 마무리 명령 6개 → 1개, 작성자 신원 실수 차단 |
| 1-6 | CI 보강: `46es/requirements.txt`로 버전 고정, pip 캐시, 순수 Python 스모크(`mounts_v5.profiles()`, `ctrl_v5.check()`) | SolidCraft 없이도 생성 논리 회귀를 PR에서 검출 |

### 단계 2 — 파이프라인 단일 진입점

| ID | 작업 | 완료 조건 |
|---|---|---|
| 2-1 | `tools/pipeline.py`. 단계(seam → 내보내기 → verify_seam → assembly → verify_assembly → guide 검토)마다 입력·출력·명령을 선언한다. `--status`는 낡은 단계를 보여 주고, `--run`은 낡은 단계만 순서대로 실행하며, `--from 단계`·`--only 단계`를 받는다 | 생성기 한 줄 수정 뒤 `--run` 한 번으로 §10의 8개 명령이 대체된다 |
| 2-2 | 단계별 벽시계 시간을 `.cache/pipeline-timings.json`에 쌓는다 | 단계 3의 순서를 실측으로 정할 수 있다 |
| 2-3 | 검증 기록에 검증 스크립트 자체의 해시를 넣는다. 검증기가 바뀌었는데 예전 `ok`를 재사용하는 경우(AGENTS.md §6)를 `--status`와 정적 검사가 잡는다 | 검증기만 고친 뒤 `--status`가 해당 단계를 낡음으로 표시 |
| 2-4 | 명령 목록을 한 곳으로: validation.md의 「재생성」만 남기고 AGENTS.md §10, guide/README.md, model/README.md, README.md는 그곳을 가리킨다 | 명령이 바뀔 때 고칠 문서가 1개 |
| 2-5 | `.githooks/pre-commit`(정적 검사 + 작성자 확인)과 `git config core.hooksPath .githooks` 안내를 AGENTS.md에 넣는다. git 훅이라 Claude·Codex·사람 모두에게 똑같이 동작한다 | 새 clone에서 한 줄 설정으로 훅이 켜진다 |

### 단계 3 — 시간 단축

2-2의 계측 뒤 효과가 큰 것부터 한다. 아래 순서는 현재 근거 기준이다.

| ID | 작업 | 근거·효과(추정) | 위험·확인 |
|---|---|---|---|
| 3-1 | 빌드의 이중 평가 제거: `run --save` 뒤 `eval`을 다시 돌리지 않고 한 번의 호출에서 측정 JSON까지 받는다(`run --results --json-out` 또는 `eval <seed> --in`) | run 39 s + eval 44 s 중 한쪽 제거, 빌드 약 40 % 단축 | CLI가 한 호출에서 저장과 측정을 모두 내는지 먼저 확인 |
| 3-2 | 부분 빌드 확장: `--mounts`(2 s)와 같은 방식으로 `--ctrl`, `--covers`를 만든다(매개변수만 남긴 문서에 해당 바디만 생성) | 브래킷·커버 반복 설계가 90 s → 수 초 | 커버는 plate 외곽에 의존하므로 plate까지 필요한지 확인 |
| 3-3 | 스냅 시험편 A·C를 **지금** 별도 소형 모델로 옮긴다(§4 결정 5). `--mounts`처럼 매개변수만 남긴 문서에 A·C만 생성해 `model/ctrl_trials_v5.sc`로 두고, `export_print_v5.py --trial`이 A·C를 그 모델에서 내보낸다. `verify_seam_v5.py`의 `ADDED`, 주문 1 기록의 `source_sha256` 대상, 0-2의 생성 기록에 새 모델을 반영한다 | CTRL 12.1 s의 약 2/3(추정 8 s) | 주문 1의 `ctrl_snap_A`·`ctrl_snap_C` STL/STEP 해시가 옮기기 전과 같아야 한다. 다르면 원인을 확인하고 옮기지 않는다 |
| 3-4 | 무효화 기준을 파일 해시에서 **바디 형상 지문**으로: 내보내기·벽 스캔·렌더 캐시가 대상 바디의 지문(`cad_model.live_shapes`)을 키로 쓴다. 기록에는 파일 해시도 계속 남긴다 | mount만 고치면 plate·커버 내보내기·스캔·무관한 렌더를 건너뜀. 재빌드로 인한 전체 무효화 제거 | 지문이 형상 변화를 빠짐없이 반영하는지 검증(의도적으로 0.01 mm 바꿔 확인) |
| 3-5 | `review_v5/` 전부 폐지(§4 결정 4): 폴더, `export_seam_v5_review.py`, `seam-v5-exports.json`, `seam-v5-thin-wall.json`을 지운다. `verify_seam_v5.py`는 주문 2 기록과 벽 스캔을 쓰고, 매개변수 CSV 내보내기는 빌드로 옮긴다 | 파이프라인 단계 1개, 파일 12개, 벽 스캔 5개 제거 | `guide_v5.json`·README·AGENTS.md §9의 `review_v5` 언급 수정. 조립 좌표 STEP은 `print_v5/order2`의 STEP으로 본다 |
| 3-6 | CLI 호출 통합: 빌드 직후 한 스크립트로 CSV·주문 1·주문 2를 내보낸다. `--timings --profile`로 계측 | 모델 열기 3회 제거 | 주문별 원자적 교체(`publish`) 유지 |
| 3-7 | 캐시 통합: 평가 캐시를 `cad_eval_cache.evaluation()` 하나로(해시 키), 위치를 `46es/.cache/`로, `pipeline.py --clean`으로 오래된 항목 삭제 | 낡은 평가를 읽을 가능성 제거, 쌓인 캐시 정리(현재 캐시·출력 합 357 MB) | 가이드 렌더 캐시 경로 이동 |
| 3-8 | Python 준비 시간: 실루엣 래스터와 브래킷 검사 결과를 입력 해시로 캐시 | 약 10 s | 우선순위 낮음 |

### 단계 4 — 구조 개선

| ID | 작업 | 효과 | 비고 |
|---|---|---|---|
| 4-1 | 부품 레지스트리 `tools/parts_v5.py`: 바디·파일명·재료·벽 한계·출력 방향·주문을 한 표로. 내보내기·검증·정적 검사·가이드가 이 표를 읽는다 | 부품 추가·이름 변경 시 고칠 곳 5 → 1 | 형상 불변, 기록 JSON 동일로 확인 |
| 4-2 | 검증을 둘로 나눈다. **불변식**(벽 ≥ 한계, 간섭 0, 단일 셸, 간격 목표)은 코드에 둔다. **현재 값 기대**(윗면 Z, 두께, 매개변수 목록, 바뀐 바디)는 생성기 상수에서 유도하거나 `expected_v5.json`에 두고, `--accept`가 차이를 출력한 뒤에만 갱신한다 | 설계 변경 때 검증기 손편집 최소화. 기대값 변경이 diff로 남는다 | AGENTS.md §5와 맞춘다: accept한 차이는 커밋 메시지에 적는다 |
| 4-3 | 기준 재설정: `flat_Z18.sc`(9.4 MB)를 필요한 수치만 담은 지문 JSON으로 바꾸고, 예외 산술(뒤 다리 부피, gate relief)을 없앤다. `seam_v4.sc`는 생성기 입력이라 남긴다 | 추적 파일 9.4 MB, CLI 평가 1회, 검증 코드 단순화 | 주문 1 발주본을 기준으로 삼는 시점에 한다 |
| 4-4 | 문서 수치 자동화: `print_v5/README.md` 부품 표(크기·부피·최소 벽)와 `design.md` 치수 표를 기록 JSON·매개변수와 정적 검사에서 대조한다. 다음 단계로 표식 블록 안을 생성한다 | §2.1처럼 문서가 CAD에 뒤처지는 것을 검출 | 가이드는 이미 `{{p:}}`·`{{v:}}` 토큰으로 CAD에서 읽는다 |
| 4-5 | (후보) 생성기의 v4 의존 제거: plate·커버·spine도 처음부터 생성 | 타임라인 695 → 대폭 축소, 억제 204개와 피처 ID 하드코딩 제거, PLATE 11.8 s 단축 | 비용이 크고 plate 형상 동일성 증명이 필요하다. 주문 1 결과를 반영할 때 다시 판단 |
| 4-6 | 저장소 용량: 생성 `.sc` 3개를 Git LFS로 옮긴다(사용자 결정 2026-11-10) | 재생성당 약 18 MB 증가 억제 | 완료. 이력은 재작성하지 않는다(§5) |

### 단계 5 — 병행 작업 규칙

AGENTS.md에 두 줄을 더한다.

- 시험·후보 변경은 브랜치에서 한다. main은 생성기·CAD·출력물·문서가 서로 맞는 상태만 받는다(0-2가 검사).
- 브랜치를 병합할 때 생성물(`.sc`, STL/STEP, 기록 JSON)은 손으로 합치지 않는다. 원본만 병합하고 `pipeline.py --run`으로 다시 만든다.

## 4. 사용자 결정 (2026-11-10)

| # | 항목 | 결정 | 따르는 작업 |
|---|---|---|---|
| 1 | 커버 Z 18.5·실루엣 창(`7b3c569`) | **실루엣 창만 main에 채택, 높이는 Z 19 유지.** 높이 후보는 브랜치에서 계속 시험 | 0-1. 커버 3조각 형상 변경이므로 `decision:` 커밋과 결정 이력 기록 |
| 2 | `manifest.json` | **폐지** | 1-1. AGENTS.md §10 규칙 변경 |
| 3 | 결정 이력의 커밋 칸 | **`decision:` 커밋 제목으로 적는다.** 기존 행의 해시는 그대로 | 1-4 |
| 4 | `model/review_v5/` | **전부 폐지**(묶음 STEP 포함) | 3-5 |
| 5 | 스냅 시험편 A·C | **지금 별도 소형 모델로 분리** | 3-3. 주문 1 출력물 해시 동일 확인이 조건 |
| 6 | v5 정본화(같은 날 추가) | **v5를 정본으로 하고 이전 버전 의존을 없앤다. 먼저 v4 원본을 v5 소유 기반 파일로 바꾸고, 부품별 생성 코드 전환(4-5)은 단계적으로** | 순서 10. 4-3과 4-2 일부를 순서 8의 선행 조건(주문 1 발주본 확정) 전에 한다. 형상이 그대로라 기준은 발주본에도 맞다 |

## 5. 하지 않는 것

- 키보드 형상·치수·체결 구조 변경(단계 0-1의 결정에 따른 정합 복구 제외).
- 내부 바디 이름(`V1`, `V3`, `TBD`)과 파일명의 `_v5` 정리. 참조가 넓고 이득이 작다(AGENTS.md §4).
- 저장소 루트의 QMK·bm40 자료 정리. 46es 범위 밖이다.
- Git 이력 재작성.

## 6. 진행 순서와 예상 규모

| 순서 | 묶음 | 규모(추정) | 선행 조건 |
|---|---|---|---|
| 1 | 1-1, 1-4 | 1–2시간 | 없음. 먼저 하면 뒤 묶음의 커밋마다 manifest 절차가 빠진다 |
| 2 | 0-2, 0-1 | 하루(전체 재생성·검증·시각 검토·게시) | 순서 1 |
| 3 | 1-2, 1-3, 1-5, 1-6 | 반나절 | 없음 |
| 4 | 3-3, 3-5 | 반나절–하루 | 순서 2(정합이 맞은 main에서 출력물 해시를 비교한다) |
| 5 | 2-1 – 2-5 | 하루 | 순서 3, 4(단계 구성이 확정된 뒤 선언한다) |
| 6 | 3-1, 3-2, 3-7 | 하루 | 순서 5의 계측 |
| 7 | 3-4, 3-6, 4-1 | 1–2일 | 순서 5 |
| 8 | 4-2, 4-3, 4-4 | 1–2일 | 주문 1 발주본 확정 |
| 9 | 4-5, 4-6 | 재평가 | 주문 1 시험 결과 |

묶음마다 브랜치 하나, 커밋은 형상 변경·도구 변경·문서 변경을 나눈다. 각 묶음의 검증은 §3 첫머리의 출력물 해시 동일 확인, `check_repository.py`, 그리고 바뀐 스크립트의 실제 실행이다. 순서 2의 0-1만 형상 변경이라 가이드 시각 검토와 게시를 하고, 나머지는 형상이 그대로이므로 시각 검토를 `대상 없음`으로 기록한다.
