zzskm/keyboard/46es/docs/minimal-mount-v2-2026-11-05.md

> **역사 문서(현행 v5 기준 아님).** 이 문서는 작성 당시의 계획/실험/검토 기록이다. 현재 설계·제작·검증 판단은 [README](../README.md), [설계](design.md), [검증과 다음 작업](validation.md), [v5 제작 세트](../model/print_v5/README.md)를 우선한다. 필요한 결정/근거만 현행 문서로 옮긴다.

# 46es 최소 mount v2 — 둘레 띠 제거·6개 어댑터

기준일: 2026-11-05 KST. **검토 모델, 제작 승인·발주 아님.**

사용자 요청에 따라 케이스 내부를 두르던 mount 띠와 좌우 lap 연결부를 제거했다. 각 부품이 케이스 체결점1개와 기존 plate 지지대1개를 연결하는6개의 독립 어댑터다. H02 부품에는 중앙 spine 받침을 남겼다. Plate2분할과 spine/bracket/gate는 그대로다. 출력 부품은7개에서11개가 됐다.

## 파일과 보존

- 최신: [46es_mount_minimal_v2.sc](../model/46es_mount_minimal_v2.sc), [별도 CSV](../model/parameters_minimal_v2.csv), [검토 STEP](../model/46es_mount_minimal_v2_REVIEW_ONLY.step), [검토 STL11개](../model/review_minimal_v2/README.md).
- [Mount만 상면](../model/46es_mount_minimal_v2_top_review.png), [조립 렌더](../model/46es_mount_minimal_v2_iso_review.png), [중앙 받침 단면](../model/46es_mount_minimal_v2_support_section.png).
- 시작: main/f068f805e626378a9544093f4db7f858f716177e, Git clean, SolidCraft v1 dirty=false. 저장된 v1의 body 복사·교차 절삭·국부 join으로 파생했고 처음부터 재구축하지 않았다.
- 원본 `46es_draft_sketches.sc` SHA256 `e9c99ca1f38d741c7c0c6ae34efc56b172f9cb2bf38860c2bd277a28ba43b232` 보존.
- 이전 변형 `46es_mount_split_v1.sc` SHA256 `3ccfcea5cbddedf776c15c14f75efd3fe7eca30d2ff2f1ad769be1cda712681e` 보존.
- 새 v2 SHA256 `299517072bfc4f0328225dccab76dec0515674e09dba6a22020ad86670b5374d`.

## 연결 구성

| 출력 부품 | 케이스↔plate 지지 | X×Y 범위 mm | 부피 mm³ |
|---|---|---:|---:|
| MOUNT_H05_SO1_MIN_V2 | H05↔SO1, 앞왼쪽 | 12.087×41.979 | 943.2002 |
| MOUNT_H01_SO2_MIN_V2 | H01↔SO2, 뒤왼쪽, USB 회피 꺾임 | 28.905×31.445 | 981.2265 |
| MOUNT_H02_SO3_MIN_V2 | H02↔SO3, 중앙 spine 받침 포함 | 12.881×50.745 | 1409.1682 |
| MOUNT_H03_SO6_MIN_V2 | H03↔SO6, 컨트롤러 앞쪽 경로 | 69.818×13.079 | 1616.0926 |
| MOUNT_H04_SO4_MIN_V2 | H04↔SO4, 뒤오른쪽 | 19.830×32.508 | 768.8787 |
| MOUNT_H06_SO5_MIN_V2 | H06↔SO5, 앞오른쪽 | 12.069×41.979 | 927.0610 |

Mount 합계22891.9137→6645.6272mm³, **70.9695% 감소**. 기존 외곽 rail, USB 우회 U 띠, 앞/뒤 lap과 하부 tongue는 최종 형상에서 사라졌다. Mount 부품끼리 연결하는 M2×5 볼트4개와 너트4개도 필요 없다. 케이스 나사6개와 M3 지지대6개는 유지했다.

일반 연결 web은 폭8×두께3mm, H02 중앙은10×3mm다. 기존 케이스 장공·M3 육각 포켓이 있는 패드를 보존한 뒤 연결 web을 추가했다. Web은 각 축 중심에서3.7mm 떨어진 곳부터 시작해 나사 구멍·포켓을 메우지 않는다. 교차 절삭이 패드를 별도 body로 분리한 경우 해당 어댑터와 다시 join하고 최종 shell1을 확인했다.

### 회피와 잔여 살

- SO2–H01의 첫 대각선은 USB 아웃렛 가정 영역과14.607798mm³ 겹쳤다. 최종 경로는 SO2(6.494,87.945)→(6.494,75.5)→H01(25.1993,66.6992)로 바꿨다. 현재 USB 점유와 최소 거리**1.0189999mm**, 겹침0이다.
- SO6–H03는 SO6(130.881,6.52)→(155,6.52)→H03(190.4994,9.3993). 컨트롤러 앞쪽을 통과한다. 남은 SO6 패드와 bracket 사이 최소0.3mm는 기존 여유이며, 실제 FDM 조립 보장치는 아니다.
- H02 받침6×6mm와 상면Z3.95를 보존했다. Spine 하면Z4와 거리**0.050000000026mm**, shim 조정 방침 유지.
- M3 육각 포켓 AF5.4/깊이1, 아래 잔여2mm, 금속 지지대 AF5/길이6mm, plate 하면Z8 유지. M3 위×4/아래×5의 공칭 물림·끝 간격도 v1과 같다.
- 케이스 장공Ø2.4와 머리 자리Ø4.4 유지. H05는 원 설계처럼 머리 자리를 생략하고 X 방향 조정±0.9, 가장자리 살 약2.00234mm를 보존했다. 나머지 머리 자리 바닥 잔여2mm.
- 새 join은 mount의Z0–3에만 있다. Plate의 스위치 릴리프·1.5T 체결층을 메우지 않는다. 가정 스위치 핀 하단Z4.7까지1.7mm의 수직 여유이며 실제 배선은 미검증이다.

## 검증 결과

- **107바디·395피처·58스케치 모두 dof0·오류0·dirty=false**. 경고는 원본 HOUSING_POSTS_CAND1개만 남았다. 중앙 mask의 초기 미세 이동 경고는 support mask에 여유를 주어 해소했다.
- Mount6개와 전체 출력11개 모두 native kernel shell1/closed=true. 검토 STL11개 모두 연결 성분1·비정상 경계 모서리0. CAD 대비 STL 부피 최대 차0.0302%, bbox 차0.05mm 이내. 일반 self-intersection 전체 증명은 아니다.
- 원본 SK22/SK24/SK25/SK34 저장 입력 동일. v1과 공통으로 남은 **101바디의 exact BRep가 전부 동일**하다. Plate 외곽285.781×95.334,46키 XY/각도·높이, cover 자석, 별도 controller bracket/gate, spine 모두 유지했다.
- 107바디 전체 간섭의 시간 제한49쌍을 하드웨어·커버·게이트·M2 묶음과 clearance로 마쳤다. USB 수정 후 해당 어댑터를 나머지106바디와 다시 비교했다. 최종 미평가 쌍0, 의도하지 않은 출력 부품 중첩0이다.
- 엄밀한 전체 중첩0은 아니다. 대용 하우징과 가정 케이스 나사 H02/H03/H06에 각각0.002855706/0.002855706/0.002850117mm³ 수치 중첩이 있다. `clearance(min_volume=1e-6)`로 평가했고 미검사0이다. 세 부품은 v1과 exact BRep가 동일하며, 원본 Boolean 미세 이동과 공칭Ø2 참조 맞춤에 따른 수치 접촉이다. 실제 PSD60 나사산 적합성 결과가 아니다.

근거: `inspection/data/minimal-v2-*.json`, [감사 스크립트](../inspection/scripts/verify_minimal_v2.py). 재검사: `python -B 46es/inspection/scripts/verify_minimal_v2.py`.

## 조립과 국부 시험

1. 어댑터별로 M3 지지대를 미리 고정한다. 케이스 나사는6곳을 각각 가볍게 체결한다.
2. Plate를 임시로 얹어 각 어댑터의 방향과 장공 위치를 맞춘다. 공구 접근이 막히면 plate를 다시 들어낸 뒤 케이스 나사를 조인다. 전체 케이스 jig는 요구하지 않는다.
3. 케이스 나사 조임 중 어댑터가 돌아가지 않았는지 확인하고 plate를 장착한다. 각 어댑터의 단일 케이스 나사는 조이기 전 회전을 허용한다. 조인 후의 마찰 고정·반복 탈착 유지력은 실물 시험 대상이다.
4. 중앙 shim은 무하중에서 억지로 휘지 않도록 맞춘다. 컨트롤러 게이트는 이전처럼 plate 모듈을 꺼낸 후 아래에서 접근한다.

국부 시험 우선순위는 긴 H03–SO6 어댑터의 굽힘/층간 파손, H01–SO2와 실제 USB·케이블 여유, H02 받침/shim과 plate 중앙 처짐이다. H05 조정 끝의 잔여 살과 각 M3 포켓·나사 길이도 확인한다. v1 시험안의 mount lap/USB U 연결 시험은 v2에는 적용하지 않는다. 스위치·cover 쿠폰 계획은 유지한다.

## 미확정 사항

둘레 끼움과 큰 프레임의 제약은 줄었지만 실제 조립 성공률·강성이 검증된 것은 아니다. 전체 강성은 기존 plate와 spine에 더 의존한다. FDM 재료·층방향·장기 creep·하중/반복 탈착 시험은 미완료이며 특히69.8mm 앞쪽 어댑터를 먼저 시험한다.

실제 케이스 나사 규격/유효 깊이, PCB/USB 변형, 배선·다이오드·납땜, 키캡 스트로크는 여전히 미확정이다. M1.6×14를 케이스 나사로 지정하지 않았다. 키 높이를 자동으로 올리지 않았다. JLC3DP 우선 검토·소재 미정, 최종 제작 승인/발주 없음.

새 web/mask 스케치14개는 현재 후보 좌표를 고정한 형상이다. CSV185개는 기존 사용자 파라미터이며 새 고정 web 좌표 전체를 구동하는 CSV가 아니다. 케이스/SO 기준 좌표를 바꾸면 새 mask·web도 함께 수정하고 재검증한다. 장공 자체의 기존 조정 범위는 보존했다.

## 갱신 기록

- 2026-11-05: 저장 v1에서 파생, 둘레 띠 제거·6개 독립 mount·USB 회피 수정,11부품 검토 내보내기 및 검증.
