zzskm/keyboard/46es/docs/handoff-split-v1-2026-11-05.md

# 46es 분할 모델 — 새 세션 인계

## 최신 재개 지점 — 최소 mount v2 (2026-11-05 KST)

사용자가 케이스 둘레 띠를 없애고 더 작은 mount로 분할하도록 요청했다.
현재는 `E:\Work\keyboard\46es\docs\minimal-mount-v2-2026-11-05.md`를 먼저 읽는다.

- 최신 모델: `E:\Work\keyboard\46es\model\46es_mount_minimal_v2.sc`. 저장된 v1에서 파생, 원본/v1 둘 다 보존.
- Mount는 H05–SO1/H01–SO2/H02–SO3/H03–SO6/H04–SO4/H06–SO5의6개 독립 어댑터. 둘레 띠·mount lap·볼트4개/너트4개 삭제. 사용자 최신 요청에 따라 이전 mount2분할 조건을6분할로 변경.
- Mount 부피22891.9137→6645.6272mm³,70.9695% 감소. 최장X69.818mm. H02 shim 받침과0.05mm 간격 유지.
- SO2–H01은 USB를 피해 꺾었다. 최종 USB 가정 점유와1.0189999mm 여유, 중첩0. SO6–H03는 controller 앞쪽 경로.
- 107바디/395피처/58스케치 dof0/오류0/원본 경고1/dirty=false. 출력11부품 모두 native shell1/STL 연결1/비정상edge0.
- v1과 공통101바디의 exact BRep 및 SK22/SK24/SK25/SK34 동일. Plate 외곽·46키·높이·자석·controller·spine 유지.
- 전체 미평가 쌍0, 의도하지 않은 출력 부품 중첩0. 대용 하우징↔가정 나사 H02/H03/H06의 미세 수치 중첩은 보고서에 분리 기록. 실부품 검증이 아니다.
- 새 fixed mask/web14스케치는 현재 후보 좌표다. 기존 CSV185행이 이 고정 좌표 전체를 구동하지 않는다. 기준좌표 변경 시 함께 수정·검증.
- 새 CSV `parameters_minimal_v2.csv`, STEP `46es_mount_minimal_v2_REVIEW_ONLY.step`, STL `model/review_minimal_v2/`11개. 모두 검토용. 긴 앞쪽 어댑터 강성·체결 마찰·실제 USB/배선·키캡/소재 시험은 남아 있고 제작 승인·발주 없음.
- 원본 SHA256 e9c99ca1f38d741c7c0c6ae34efc56b172f9cb2bf38860c2bd277a28ba43b232, v1 3ccfcea5cbddedf776c15c14f75efd3fe7eca30d2ff2f1ad769be1cda712681e 보존. v2 299517072bfc4f0328225dccab76dec0515674e09dba6a22020ad86670b5374d.
- Git은 main/f068f80, clean에서 시작했다. 이전 사용자 지시의 원격 저장 흐름을 이어 커밋·푸시한다. reset/checkout/기존 변경 삭제 금지. 초기 재현 명령·이번 적용 로그를 이미 수정된 모델에 재실행하지 않는다.

이하 split v1과 최초 인계는 이전 안의 감사 기록이다.

## 최신 재개 지점 — 후속 구현·검증 완료 (2026-11-05 KST)

아래 원 인계의335피처/121바디/왼쪽mount shells2/하드웨어 미반영 상태는 과거 기록이다.
현재는 [후속 변경 보고서](split-v1-change-report-2026-11-05.md)를 먼저 읽는다.

- 같은 변형 `E:\Work\keyboard\46es\model\46es_mount_split_v1.sc`에 저장. SHA256 `3ccfcea5cbddedf776c15c14f75efd3fe7eca30d2ff2f1ad769be1cda712681e`.
- 원본 해시 `e9c99ca1f38d741c7c0c6ae34efc56b172f9cb2bf38860c2bd277a28ba43b232` 보존.
- 111바디/339피처/44스케치 dof0/오류0/원본 경고1/dirty=false. 와셔 참조10개 억제로 바디 수가 줄었다.
- 왼쪽 mount의 shell2는 USB 노치로 끊긴 실제 두 조각이었다. USB keepout 안쪽4mm U 연결을 추가해7출력 바디 모두 shell1. STL도 각각 연결 성분1/비정상 edge0.
- M3 지지대 길이6/AF5, 포켓 깊이1/AF5.4, 위×4/아래×5 반영. plate 하면Z8·컨트롤러Y13.064485 유지. 끝 간격0.5 공칭.
- M2 plate/spine×6, lap/gate×5 저두Ø4/H1.1, 와셔 없음. Bracket 보스8×8, gate 포켓 받침1.4·옆살1.3, plate 국부 회피 후 잔여3mm. Gate 볼트는(116.5,7.764485).
- 46키와SK22/SK24/SK25/SK34 입력은 원본과 동일. 전체XY285.781×95.334 유지. 새join이 스위치 보호영역을 메우지 않음.
- 전체 간섭 시간 제한 쌍을 묶음/개별 재검사. 미평가 쌍은 없고, 대용 하우징↔가정 M2 H02/H03 두 쌍에 각각0.002855706mm³ 수치 중첩이 남는다. 실제 출력 부품의 의도하지 않은 중첩0. 실부품 검증으로 확대 해석하지 않는다.
- 정식 MCP export가 이번 세션에서는 허용됐다. REVIEW_ONLY STEP/STL7개 생성. 제작용/최종 승인/발주 없음.
- [별도 CSV](../model/parameters_split_v1.csv), [구매 후보](split-v1-hardware-2026-11-05.md), [국부 시험안](split-v1-local-print-plan-2026-11-05.md) 완성. 실제 배선/납땜/키캡 스트로크/재료·실부품 규격 확인은 남아 있다.
- 마지막 사용자 요청은 **작업 포함 all local changes commit and push**다. 이 요청이 원 인계/프롬프트의 staging·commit·push 금지보다 우선한다. 기존33개 staged 변경은 보존하여 함께 포함한다. reset/checkout/기존 변경 삭제 금지는 유지.
- 재현 참고 `scripts/split_v1.commands.json`과 이번 명령 로그를 **이미 수정한 모델에 재실행하지 않는다**.

이하 원 인계는 시작 상태의 감사 기록으로 보존한다.

기준일: 2026-11-05 KST. 사용자가 컨텍스트 증가로 새 세션 재개를 요청하여 중간 상태를 저장했다. **설계·제작 검증 완료가 아니다.**

## 1. 먼저 열 파일과 보존 조건

- 실제 저장소: `E:\Work\keyboard`, 프로젝트: `E:\Work\keyboard\46es`.
- **이어서 수정할 변형 모델:** `E:\Work\keyboard\46es\model\46es_mount_split_v1.sc`.
- 변형 모델 SHA256: `fc6ba4d6ecb1065e5fd66d06b5d9bc253d7ea1f27e0572135f02ae759cbb8b22`.
- 원본(덮어쓰지 말 것): `E:\Work\keyboard\46es\model\46es_draft_sketches.sc`.
- 원본 SHA256은 시작·종료 모두 `e9c99ca1f38d741c7c0c6ae34efc56b172f9cb2bf38860c2bd277a28ba43b232`.
- 저장소는 `main`, HEAD `fa7e588f8d4a302ec7f2817ab0eb26c510b34c1a`. 기존 staged 변경 33개(수정8/추가6/삭제19)는 유지했고 기존 tracked 파일의 새 unstaged 변경은 없다. reset/checkout/삭제/자동 staging/커밋/푸시 금지.
- 현재 `C:\Users\z\Documents\ChatGPT\46es`는 빈 별도 Git 저장소(master, HEAD 없음)였으며, 실제 설계 저장소와 혼동하지 말 것.
- E: 저장소 읽기에는 `git -c safe.directory=E:/Work/keyboard -C E:\Work\keyboard ...`를 사용했다. global Git 설정은 바꾸지 않았다.
- E: 및 프로젝트에서 AGENTS.md를 발견하지 못했다. C: 작업 경로 상위 `C:\Users\z\AGENTS.md`는 KB 참조 지침이며 KB 목차에는 관련 CAD 항목이 없었다.
- 쓰기 권한은 사용자의 `change permission` 요청 후 E: 새 변형 모델 생성에 대해 명시적 도구 승인을 받았다. 현재 환경의 실제 권한을 다시 확인할 것.

## 2. 이번 세션 생성 파일

E: 프로젝트에 새 untracked 파일:

- `model/46es_mount_split_v1.sc` — 최신 저장 상태. 6,350,454 bytes. 종료 검사 `dirty=false`.
- `model/46es_mount_split_v1.sc.bak` — SolidCraft 자동 백업. 삭제하지 않았다.
- `model/parameters_split_v1.csv` — 최신 변형 모델의 별도 파라미터 내보내기. 원본 parameters.csv는 미변경.
- `model/46es_mount_split_v1_iso.png` — 분할·보강 형상의 중간 아이소메트릭 렌더. 이후 추가한 참조 하드웨어는 숨김 상태이므로 최신 최종 검증 렌더로 간주하지 말 것.

C: 작업 폴더의 인계 보조 자료:

- `docs/handoff-split-v1-2026-11-05.md` — 이 문서.
- `scripts/split_v1.commands.json` — 원본에 적용한 **성공한 명령만** 순서대로 저장. 현재 모델을 원본에서 재현하는 참고 자료. 기존 변형 모델에 재실행하지 말 것.
- `inspection/split_v1_handoff_checks.json` — 상세 inspect/measure, 간섭 검사, 파라미터 범위 시험, 마지막 롤백 결과.
- `scripts/layout_checks.py` / `inspection/source_features_by_panel.json` — r2 키 보호 영역과 연결부 후보의 2D 거리·교차 검사.
- `scripts/check_stl.py` — STL 연결 성분 검사 준비용. STL 내보내기가 거절되어 아직 실행 검증하지 못했다.
- `model/46es_source_snapshot.sc` — 시작 시 원본의 보존 복사본.

## 3. 확정 요구와 구현한 형상

새 FDM plate, 현재 3D 외곽 285.781×95.334 및 r2 기반 46키 XY/각도를 유지한다. Plate와 mount의 각 출력 부품 X≤250 mm. JLC3DP 우선 검토, 소재 미정. 전체 케이스 jig 선행 조건 없음. 원본 cover 자석 구조·국부 1.5T 스위치 층을 유지한다. 배선 8mm를 이유로 키 높이를 자동으로 올리지 않는다.

구현한 출력 바디 7개:

| 바디 | X 폭 mm | 부피 mm³ | kernel shells |
|---|---:|---:|---:|
| PLATE_L_SPLIT_V1 | 137.024 | 38234.6234 | 1 |
| PLATE_R_SPLIT_V1 | 154.257 | 40801.6903 | 1 |
| MOUNT_L_SPLIT_V1 | 110.393 | 7986.2935 | **2 — 미해결** |
| MOUNT_R_SPLIT_V1 | 195.188 | 14532.3671 | 1 |
| PLATE_SPINE_V1 | 30.000 | 1766.3223 | 1 |
| CTRL_BRACKET_SPLIT_V1 | 35.100 | 1274.7384 | 1 |
| CTRL_GATE_SPLIT_V1 | 7.419 | 81.7175 | 1 |

모두 `closed=true`지만, 이것만으로 왼쪽 mount가 한 조각으로 연결됐다고 판정할 수 없다.

- Plate seam: X130.881 중앙 통로, 앞·뒤는 X136.881로 우회. Y11→16 및82.5→83.5에서 전환. 실제 수직 폭0.5mm thin-extrude 컷. SO3/SO6는 왼쪽에 남았다.
- Spine: 4mm 폭 줄기, Y42–83, Z4–8.5. 앞18×8/뒤30×8 패드, 패드 하면Z5. 실제 16.5mm 개구를 1mm씩 확장한 18.5mm 보호 정사각형에 앞 패드를 맞춰 절삭. SO3 회피 Ø6.8. Plate 하면 자리 깊이0.5, 앞 XY 여유0.15/뒤 Y0.4 후보.
- Spine M2 후보: (126.381,42), (135.381,42), (121.881,83), (142.881,83). 뒤 두 plate 구멍·머리 자리는 Y±0.4 장공. Ø2.4 관통/Ø4.4 머리 자리, AF4.4×1.8 금속 너트 포켓.
- Mount nominal split X100. 앞·뒤에서 왼쪽 상부 띠를 X90까지 물리고 오른쪽 상부 겹침 띠가 X90.2부터 시작. 아래 혀는 X80–110, Z−3–0, 위 띠 Z0–3. 실제 겹침 약20mm. 외곽을 넓히지 않고 안쪽으로2mm 확장(총 폭10). M2 각 연결부2개: X95/105, 앞Y4.633/뒤Y89.967.
- H02 인근 받침: X130.881 중심, Y56, 6×6mm, 상면Z3.95. Spine 하면Z4와 틈0.05. shim 조립 목표0–0.1mm이며 프린터 정밀도 보장이 아니다.
- H05: 기존 전체 머리자리 cut를 억제하고 H05를 제외한 5개만 다시 절삭했다. H05 X 원호 중심 조정량0.9, 나사 Ø2.4 슬롯은 전체길이4.2. 왼쪽 잔여 폭 약2.002mm. 다른 H 슬롯은 종전 지정축±1mm 원호 중심 조정 유지. M2 축 가정 지정축 이동±1.2/직교±0.2, H05만±1.1/±0.2.
- Plate 외곽 2mm×하향3mm 플랜지를 7개 구간에 통합. SO/USB/분할부를 피하도록 끊었다. 18.5mm 스위치 보호 영역과 2D 겹침 없음. 기존 개구를 메우지 않도록 새 join은 Z5–8에만 추가했다.
- 기존 CTRL_RAIL/STOP/LIP 7개 피처를 억제하고 별도 브래킷으로 재구성. PCB/플러그 위치는 현재 모델과 같다. 상판1.5T 및 (125,17)/(125,25) M2 고정부, 하부 금속 너트 포켓 추가. 상판에 X129.5–138.5/Y15–29 배선 검토용 창을 뚫었다.
- 별도 탈착 게이트가 −X PCB 이탈을 막는다. 브래킷에 체결하며 mount 링의 고정 기능에 의존하지 않는다. 게이트 간섭을 피하기 위해 mount 링 상부에 국부 회피 홈을 냈고 바닥 두께1.7을 남겼다. 게이트 볼트는 plate 모듈을 꺼낸 뒤 아래에서 접근하는 후보 구조다.

## 4. 검증 결과와 한계

최신 저장 상태: **바디121, 스케치44 전부 dof0, 피처335, 오류0**. 경고1개는 원본부터 있던 HOUSING_POSTS_CAND의 Boolean 미세 이동 경고다.

- 분할 부품 7개의 폭은 모두250mm 이하. 원래 키 배열 스케치 SK22/SK24/SK25/SK34를 재생성·이동하지 않았다. 원본과의 최종 JSON 동일성 대조는 아직 해야 한다.
- 브래킷 기본 부피1344.33은 기존 레일/턱+신규 상판의 손계산과 일치했다. Mount 겹침 추가 부피도 계산과 약0.007mm³ 이내로 일치했다. 단계별 상세 수치는 체크 JSON과 명령 로그를 참고.
- 게이트 간섭 수정 후 기본 조립19바디 전체 검사: 간섭0, 미검사0. 이후 상판 배선 창은 제거만 했으므로 기본 구조 중첩을 추가하지 않는다. 이후 새 참조 바디를 추가했다.
- 스위치 참조46개는 기존 배열 스케치에서 만든 **단순 가정 점유**: 하부·5핀 묶음14mm 정사각형 Z4.7–11, 걸쇠 보호16.5mm Z8–9.5, 상부 보호16.5mm Z11–14.6. 실제 Gateron 5핀 CAD가 아니며 핀·걸쇠 세부 형상을 검증한 것이 아니다.
- 볼트/와셔/너트/자석 참조56바디를 추가했다. 이름은 REF_*이고 숨김. 나사산은 원통 구멍으로 단순화했다. 아래 하드웨어 최신 제안은 아직 반영되지 않았다.
- 전체121바디 간섭 검사에서 발견 중첩0이었지만 30초 예산으로 다수 쌍이 미검사다. **전체121바디 간섭0 확정이라고 쓰지 말 것.** 체크 JSON의 unchecked를 확인하고 작은 묶음으로 마저 검사할 것.
- 파라미터 minimum/maximum 조합 시험은 오류0, 복원true였다. gap0.4/0.6, spine폭3.8/4.2, overlap18/22, supportgap0/0.1, fitX0.1/0.25, rearY0.3/0.5, H05조정0.8/0.9. 양끝 모두 왼쪽 mount kernel shells2였다. 아직 허용 범위를 제작 검증한 것은 아니다.
- 실제 배선·다이오드·납땜·키캡 스트로크·탈착 동작은 미검증이며 구체 점유 모델이 없다. 실제 PCB 입출력 배선 경로도 미입력이다. 전체 jig나 키 높이 상승으로 대체하지 말 것.
- 첫 STL 내보내기가 자동 승인 검토에서 `MCP tool call requires approval, but approval policy is never`로 거절됐다. STL/STEP는 생성하지 않았다. 우회 명령으로 같은 내보내기를 강행하지 않았다. 새 세션은 권한·제작/검토 파일 정책을 확인하고 적절한 승인 경로가 있을 때만 출력 파일을 생성할 것.

## 5. 사용자 추가 정보 — 최종 메시지가 우선

사용자가 보유 재고 목록을 제공했다. 용도는 고정하지 않고 **알아서 구성하라**고 했으며, 마지막에는 **적정 bolt/standoff는 새로 구입해도 되니 적합한 규격을 제안하라**고 허용했다.

- M3×8 평머리
- M3×5 둥근머리
- M3×5×4 인서트 = 호칭경×외경×높이
- M1.6×14
- 육각 지지대 M3-5-05: **암–암 / 길이5mm / 꼭짓점 간 외경5mm**. 중간에 맞변5라고 답했지만 나중에 꼭짓점5로 정정했다. 따라서 AF=5·cos30°≈4.330mm이며 AF5 재고라고 해석하지 말 것.
- 위 목록만으로 M1.6×14를 케이스 나사라고 확정하지 말 것. 케이스의 기존 M2 가정/나사산·유효 깊이는 계속 현물 확인 대상이다.

새 구매 제안(검토했으나 CAD **미반영**):

1. **M3 암–암 길이6mm, AF5mm, 금속, 관통 나사산 지지대 6개.** Mount 포켓 깊이를1mm로 바꾸면 하단Z2/상단Z8이 되어 키 높이를 유지한다. 포켓AF5.4 후보.
2. **Plate 위 M3×4 ISO7380-1 버튼헤드, 자석에 붙는 탄소강 6개.** 머리 최대Ø5.7/H1.65, 현재Ø6 카운터보어 안에 들어가는 후보. 상부 나사 끝Z5.5, 지지대 나사 물림2.5mm.
3. **Mount 아래 M3×5 둥근머리 6개.** 재고가 맞는 머리 형상일 때 활용. 끝Z5, 물림3mm. 위 나사와 계산상 끝 간격0.5mm. 실제 스페이서의 나사 유효 길이·끝면 챔퍼를 확인해야 한다.
4. 새 M2 연결부는 아직 최종 구매 규격을 결정하지 않았다. 현재 참조는 plate/spine M2×7+0.2T 와셔, mount lap M2×5+0.2T 와셔, AF4.0×1.6 너트다. 게이트 M2×3.5는 길이가 비표준이고 머리 밑 여유가 작아 **재설계/규격 선택 필요**. 하드웨어를 확정한 뒤 참조와 포켓을 함께 고칠 것.
5. M3×8 평머리, M3×5×4 인서트, 보유5mm 지지대, M1.6×14를 억지로 쓰지 않는다. 특히 짧은 지지대 양끝의 긴 나사는 서로 바닥날 수 있다. 인서트도1.5T 판에 단순 삽입하지 않는다.

공식 자료 확인(2026-11-05):

- Harwin R30-1000602: https://www.harwin.com/products/R30-1000602 — M3 female-female, 6mm, AF5, 황동/니켈도금. 검색·제조사 카탈로그로 규격 확인, 가격/한국 구매처/재고 확인은 안 했다.
- Harwin 카탈로그: https://cdn.harwin.com/pdfs/Harwin_Product_Catalog_page_310.pdf — R30-100 AF5, 길이4–16 등의 표준 선택. 웹 open은 리디렉션 오류였지만 검색 추출은 확인했다.
- Böllhoff ISO7380-1 자료: https://eshop-ro.boellhoff.com/out/media/pdf/ISO_7380-1_Stahl_10.9_Innensechskant___en.pdf — 강철 M3 머리Ø5.7/H1.65. 다른 브랜드 둥근머리가 같다고 가정하지 말 것.
- NBK SSH M2 자료: https://www.nbk1560.com/images/en-US/product/lowsmallheadscrew/SSH/SSH_1.pdf — M2 머리Ø4/H1.1, 길이4/5/6/8 등. 게이트 저두 후보 비교용이며 아직 채택하지 않았다.

### 마지막 시도의 정확한 상태

AF5/포켓깊이1/컨트롤러 Y 고정 및 M3 볼트 참조 수정 batch를 실행했다가 `timeline.edit`의 **diameter는 지원하지 않고 radius를 써야 한다**는 입력 오류로 전체 롤백됐다(`rolled_back=true`). 따라서 저장 모델은 **여전히 AF4.7/포켓깊이1.5/전체길이6.5 참고 지지대**다. 제안6mm가 적용됐다고 설명하면 안 된다.

새 세션에서 적용 시:

- `timeline.inspect` 정의를 보고 CylinderFeature의 `radius`를 사용한다(Ø5.7이면 radius=2.85). `diameter`는 생성 명령에서는 되지만 timeline.edit에서는 안 된다.
- `TBD_so_AF=5`, `TBD_so_pocket_D=1` 후보를 함께 바꾼다. 기존 TBD_standoff_H=5는 mount 상면부터 plate 하면까지의 높이이므로 그대로 유지하면 전체 지지대 길이는6이 된다.
- 기존 `TBD_ctrl_Y` 식은 육각 포켓 AF에 종속돼 있다. PCB/플러그 위치를 유지하려면 Y=13.064485로 기준을 고정하거나 같은 위치를 보장하는 별도 식을 만든다. 새 AF로 SO6 포켓과 컨트롤러 개구 사이 최소 살이 줄어드는 양을 실제 토폴로지로 다시 확인한다.
- SO3 회피Ø6.8이 AF5 지지대의 꼭짓점 외경5.774에 충분한지 확인한다.
- M3 위쪽 참조 shaft는 baseZ5.5/height4, 아래쪽은 baseZ0/height5. 머리들은 radius2.85/H1.65 후보. 나사 끝Z5/5.5와 plate 카운터보어·자석 사이를 확인한다.

## 6. 새 세션의 우선순위

1. 이 문서·지침·Git·해시를 읽고 최신 변형 SC를 열기. 열기 전 현재 SolidCraft dirty 상태부터 검사한다.
2. **왼쪽 mount shells2 원인을 우선 규명·수정.** 폐솔리드 판정만 믿지 말고 두 shell의 부피/위치/연결성을 확인한다. `.sc`는 ZIP이고 `document.json`, `cache/model.json`, `cache/bodies.bin`이 있다. 이 저장 캐시의 읽기 분석은 STL 내보내기와 다른 검증 수단이다. 아직 cache/bodies.bin 형식은 해석하지 않았다. 승인 거절된 export를 우회하지 말 것.
3. 승인된 새 구매 방향으로 6mm/AF5 지지대와 M3×4/×5 조합 적용·검증. 기존 스테이징·원본·키 높이·키 배열은 보존한다.
4. M2 규격/게이트 형상·공구 접근·잔여 살을 정리하고 새 참조 하드웨어 반영. 실제 배선 정보 없는 부분은 제작 확정 보류.
5. 남은 간섭 쌍을 묶음 검사해 미검사와 정상 접촉을 구분. 부품 폭/구멍 위치/체결 잔여 두께/배선 공간/단면/스케치dof/오류를 재확인. 키 배열 스케치4개 원본 대조.
6. 별도 파라미터CSV·최종 변경 보고서·국부 시험 출력안(중앙조립/겹침·H05/스위치·플랜지)·미확정 사항 완성. 현재 인계 문서는 중간 보고서다. 제조 승인·발주·커밋·푸시 하지 않는다.

## 7. 재개 프롬프트

```text
46es 분할 mount·plate 개선 작업을 이어서 진행해.
먼저 C:\Users\z\Documents\ChatGPT\46es\docs\handoff-split-v1-2026-11-05.md를 읽어.
실제 저장소는 E:\Work\keyboard이고, 이어서 수정할 모델은
E:\Work\keyboard\46es\model\46es_mount_split_v1.sc야.
원본·기존 staged33개를 보존하고 staging/commit/push/reset/checkout은 하지 마.
SolidCraft MCP를 사용하고, 왼쪽 mount shells2 문제부터 확인해.
하드웨어는 새 구매 가능하며, 재고 지지대는 암암/길이5/꼭짓점외경5mm다.
검토된 새 6mm AF5 지지대 + 위 M3x4/아래 M3x5 조합은 아직 CAD 미반영이므로
인계 문서의 롤백 상태를 확인한 다음 반영·검증해.
배선·현물 미확정 항목은 명시하되 독립적인 CAD 작업을 계속해.
최종 제작 승인·발주·커밋·푸시는 하지 마.
```

## 갱신 기록

- 2026-11-05: 사용자의 새 세션 요청에 따라 최신 변형 모델 저장, 인계·검증 자료 작성. 작업 완료 선언은 하지 않음.
