zzskm/keyboard/46es/inspection/46es_r2_dwg_inspection.md

# 46es r2 DWG 검사 및 제작 모델 준비 보고

작성일: 2026-11-03 · 대상: `46es/cad/46es_r2_keyboard.dwg` (기존 아크릴 버전 설계 파일, 새 3D 프린팅 케이스의 제작 도면 아님)

> **이 문서와 `46es/model/`의 어떤 값도 제작 확정 치수가 아니다.** DWG 값은 "DWG에 그렇게 그려져 있다"는 사실일 뿐 PSD60 하우징·실부품과 맞는다는 근거가 아니다. 최종 형상·STL은 만들지 않았다.

> 정정 2026-11-09: 이 보고서가 만든 `model/parameters.csv`·`model/46es_draft_sketches.sc`와 계획 문서(`docs/planning.md`·`docs/assembly-revision.md`)는 v5로 대체되어 현행 트리에서 뺐다(태그 `46es-pre-cleanup-2026-11-09`). 현행 매개변수는 [`model/parameters_seam_v5.csv`](../model/parameters_seam_v5.csv), 현행 설계는 [`docs/design.md`](../docs/design.md)다.

> 정정 2026-11-04: 46sp는 별도 split keyboard 예시라 대조 대상에서 뺐다(§1, §7). 부품 구성(§5)은 당시 계획 문서 `docs/assembly-revision.md` 기준으로 갱신했다. r2 DWG는 3D 프린팅 리비전이 아니라 아크릴 버전의 설계 파일로 확인됐다(§1). DWG 판독 결과는 바뀌지 않았다.

상태 표기: **확인** = 파일에서 직접 읽은 사실 · **추정** = 근거 있는 해석이지만 미검증 · **미확정/알 수 없음** = 실측 전에는 정할 수 없음 · **자리표시** = 스케치를 그리기 위해 넣은 임시값

---

## 1. 요약

- DWG는 **열린다.** CADCraft 0.17.0으로 읽었고, 공개 DWG 사양으로 직접 작성한 별도 판독기로 교차 검증했다. **모델 공간의 엔티티 229개는 두 판독 결과가 개수·종류·레이어·원/원호 값까지 완전히 일치**한다.
- 손실은 **형상과 무관한 부분에서만** 확인됐다. 고아 치수 블록 4개, 빈 익명 그룹 1개, 그리기 순서·사전 일부가 DXF 내보내기에서 빠진다(§3).
- 도면에 **기입 치수(DIMENSION)는 0개**다. 모든 치수 후보는 형상에서 산출했다. 엔티티는 전부 레이어 `0`에 있어서, 레이어 이름으로는 부품을 구분할 수 없다.
- **Z(두께·높이) 정보가 없는 순수 2D 도면**이다. 모델 공간 229개 모두 Z = 0, thickness = 0, 돌출 방향 +Z다. 판 두께는 MText 라벨(2T/5T/1.5T/2T/5T/2T, 합 17.5)로만 존재하며 공칭값이다.
- 도면은 **판재 6종(모두 286.4 × 95.8)의 적층 구조**다. MText에는 3D 프린팅 재료가 아닌 판재 재료(투명아크릴, 압출판, 아스텔, 스모그아크릴)가 적혀 있다. 처음에는 r2를 기존 3D 프린팅 리비전으로 설명했으나, 사용자가 **아크릴 버전의 설계 파일**이라고 확인했다(2026-11-04). 판재 재료 표기와 일치한다.
- 스위치 판(1.5T 압출판)에는 **14 mm 개구부가 46개** 있어 펌웨어의 46키와 개수가 맞는다. 그중 1개는 H01 위치의 육각 컷과 겹쳐 윤곽이 합쳐져 있다(W4). 46sp DXF의 45개 집계는 별도 split keyboard 도면의 값이라 46es와 대조하지 않는다.
- r2 체결 후보 6점은 GH60 공개 좌표와 **최대 약 1.1 mm** 어긋난다(최적 평행이동 후). 어느 쪽도 PSD60 실측값이 아니다.
- 실측 전이라 SolidCraft에는 **매개변수 83개와 부품별 2D 초안 스케치 5개만** 만들었다. 미확정 값은 이름에 모두 `TBD_`를 붙였다.

---

## 2. DWG 열기 검사

| 항목 | 값 | 상태 |
|---|---|---|
| 파일 | `cad/46es_r2_keyboard.dwg`, 2,388,706 B | 확인 |
| SHA-256 | `4a9b09d5…f88db59` (manifest.json과 일치, 작업 전후 동일) | 확인 |
| 형식 | AC1024 (AutoCAD 2010–2012 DWG), 파일 ID `AcFssFcAJMB` | 확인 |
| 저장 프로그램 | AutoCAD 2012 (registry 18.2, build F.51.0.0 x64, locale 1042 한국어), Trusted DWG | 확인 |
| 날짜 (TDCREATE / TDUPDATE) | 2021-06-19 / 2023-05-14 (저장 시각 그대로) | 확인 |
| 코드페이지 | ANSI_949 (KOREAN) | 확인 |
| 섹션 | 14개, 암호화 없음, 페이지 272개, 객체 3,698개 | 확인 |

### 사용 도구

1. **CADCraft 0.17.0** (`C:\Program Files\ArtCraft\CADCraft\cadcraft-cli.exe`, 사용자 설치): `info`·`run --cmd`로 읽기만 했다. `skipped: 0`, `readNotes: []`이었고 저장하지 않았다.
2. **자체 판독기** (`scripts/dwg_census.py`): ODA 공개 사양(R2004+ 페이지 구조, LZ77 변형, 객체 맵, R2010 객체 헤더)에 따라 작성했다. 객체 3,698개를 해석 오류 0으로 읽었다. 객체 종류, 공간(모델/페이퍼/블록), 레이어 핸들, 레이어·블록 이름, 원/원호 값을 독립적으로 추출한다.
3. LibreDWG 0.13.3: GNU 키링으로 서명을 검증해 받았지만, 실행은 권한 분류기가 차단했다. **사용하지 않았다.**

### 교차 검증 결과

| 검사 | 결과 |
|---|---|
| 모델 공간 엔티티 | 원본 229 = CADCraft 229. ARC 11, CIRCLE 19, LINE 40, LWPOLYLINE 153, MTEXT 6 |
| 모델 공간 원·원호 30개의 중심·반경·각도 | 최대 차이 0 |
| 엔티티 레이어 | 229개 모두 레이어 `0` (원본·CADCraft 일치) |
| 미사용 블록 59개 내부 엔티티 | 원본 2,895 = CADCraft 2,895 |
| CADCraft DXF 내보내기 → 재판독 | 229개 핸들·좌표·레이어·색 동일, 한글 MText 6개 동일 |

---

## 3. 가져오기·내보내기 손실과 경고

| # | 대상 | 원본 | CADCraft | 영향 |
|---|---|---|---|---|
| L1 | 익명 치수 블록 `*D` 4개 (LINE 12, SOLID 8, POINT 12, MTEXT 4) | 있음. DIMENSION 엔티티 없이 남은 고아 블록 | 내부적으로 읽지만 블록 목록에 표시하지 않음. **DXF 내보내기에서 누락** | 형상 무관. 다만 **삭제된 치수 값 4개**가 이 블록에만 남아 있다: `19,05`, `23,85`, `95,8`, `287`. 정의점은 현재 도면 범위 밖(x≈−1480…−1164)이다. **287은 현재 판 폭 286.4와 다르다.** 리비전 중 폭이 바뀌었을 가능성이 있으므로 이력 정보로만 본다. |
| L2 | GROUP 1개 | 익명, 멤버 0 | 목록·DXF 모두 누락 | 없음 |
| L3 | PROXY_OBJECT 5개 | ACDBSECTIONVIEWSTYLE×2, ACDBDETAILVIEWSTYLE×2, ACDBASSOCPERSSUBENTMANAGER | 프록시로 유지 | 없음 (비도형) |
| L4 | SORTENTSTABLE 55, DICTIONARY 129, XRECORD 44 | — | DXF에서 SORTENTSTABLE 누락, DICTIONARY 51·XRECORD 45로 축약 | 그리기 순서·메타데이터만 해당 |
| L5 | DXF 헤더 `$DWGCODEPAGE` | KOREAN | `ANSI_1252`로 기록 (본문은 UTF-8이라 한글 보존) | 오래된 DXF 리더에서 한글이 깨질 수 있음 |
| L6 | 블록 내부 3DSOLID 1개 (`PCB2x8`) | 있음 | 유지 (DXF에 포함) | 미사용 블록이라 모델과 무관 |
| W1 | **기입 치수 없음** | DIMENSION 0 | — | 모든 치수는 형상에서 계산 (§4) |
| W2 | **레이어 미사용** | 레이어 10개 정의. 모델 공간 엔티티는 전부 `0` | — | `2 보강판 5T`, `3 Middle`, `4 하판 2T`, `5 Nameplate`, `6 Stand`, `기판1.5t`, `보강판2t`, `보강판3t`는 미사용 블록 내부(보강판3t 654, 보강판2t 618, 기판1.5t 49, 6 Stand 4)에서만 쓰인다. 부품 구분은 위치·색·MText로만 가능 |
| W3 | P1(5T) 내측 개구부 윤곽 | 0.0071 mm 열림 (양끝이 이어지지 않음) | — | CAM·슬라이서가 열린 윤곽으로 경고할 수 있음 |
| W4 | P2(1.5T) 좌측 바깥 열 위쪽 개구부 | 14×14 사각과 H01 위치 육각(AF 4.5)이 한 윤곽으로 합쳐짐 | — | 해당 스위치 모서리 고정·강도 문제 가능. 의도 여부 미확인 |
| W5 | P2(14 mm)와 P3(16.5 mm) 개구부 중심 | 판 외곽 기준 최대 0.195 mm, 평균 0.061 mm 차이 | — | 층간 정렬 기준 미확인 |
| W6 | 펌웨어 JSON | UTF-8 BOM으로 시작 | — | 일부 JSON 파서에서 실패 (`utf-8-sig` 필요) |
| W7 | **Z·두께 정보 없음** | 모델 공간 229개 모두 Z = 0, thickness = 0, 돌출 +Z (`scripts/dwg_thickness.py`) | — | 적층 순서·높이·판 실두께는 파일에서 얻을 수 없다. 판 두께는 MText 라벨 공칭값뿐(합 17.5, 전부 적층 가정). 레이어 이름의 두께(5T·3t·2t·1.5t)는 미사용 블록에서만 쓰임 → M21 |

---

## 4. 형상·레이어·단위·치수 후보

### 단위 (확인)

`$INSUNITS=4` (mm), `MEASUREMENT=1` (미터법), `LUNITS=2` (십진수), `LUPREC=4`. 범위는 (−76.13, 28.46) – (308.37, 779.15)이며, 판 6종이 세로로 펼쳐져 있다. 삭제된 치수 텍스트는 소수 쉼표 표기(ISO-25 스타일)다.

Z 방향: 모델 공간 엔티티 229개 모두 Z = 0, thickness = 0, 돌출 방향 +Z다(확인). 앞뒤 깊이(Y)는 판 외곽 95.8이며, 지워진 치수 `95,8`로도 남아 있다. 이는 r2 판의 깊이이고 PSD60 내부 깊이가 아니다.

### 판별 구성 (형상은 확인, 역할은 추정)

모든 좌표는 **각 판 외곽의 좌하단 기준**이다.

| ID | MText 라벨 | 외곽 | 코너 | 주요 형상 (확인) | 역할 (추정) |
|---|---|---|---|---|---|
| P0 | 투명아크릴 2T | 286.4 × 95.8, 1조각 | 외곽 C3.5 모따기, 내측 C8 | 폭 4.0 테두리의 링. Ø2.0 ×3 (H01은 좌상단에서 내려온 탭 끝, H05·H06은 측면 노치), 스택 위치 3곳 육각 노치. 개구부 안에 AF 6.0 육각(Ø2.0 구멍) 소형 부품 3개 | 링 프레임. 소형 육각은 와셔·스페이서 |
| P1 | 투명아크릴 5T | 286.4 × 95.8 | R3.5 | 키 군집을 따라가는 큰 개구부(W3). 육각 AF 4.711 ×6, R2.25 노치 H01·H04(개구부 쪽)·H05·H06(외곽), Ø4.5 H03. AF 6.0 육각+Ø4.5 소형 부품 3개 | 스위치 하부 공간용 중간 프레임 |
| P2 | 투명압출판 1.5T | 286.4 × 95.8 | R3.5 | 14.000 × 13.999 개구부 46개(W4 포함). 육각 AF 4.711 ×6, Ø4.5 H02·H03·H04, R2.25 노치 H05·H06 | 스위치 플레이트 |
| P3 | 투명아스텔 2T | 286.4 × 95.8 | R3.5 | 16.5 × 16.5 개구부 46개(P2와 같은 회전각), 육각 AF 4.711 ×6 | 스위치 주변 스페이서 |
| P4 | 스모그투명아크릴 5T | 3조각, 폭 102.181 / 88.466 / 129.111 × 95.8 | 바깥 R3.5 | 큰 개구부, 육각 AF 4.711 ×6, 가운데 T자 조각 | 3분할 측벽·스페이서 |
| P5 | 투명아스텔 2T | P4와 같은 3조각 | 바깥 R3.5 | 스택 위치 Ø3.0 ×6 | 최하층 (나사 관통) |

스택 볼트 위치 6곳(P1–P5 공통, 편차 0.001 mm 이내): (7.187, 7.187), (7.187, 88.612), (131.574, 88.612), (251.113, 89.674), (279.212, 7.187), (131.574, 7.187).

### 케이스 체결 후보: DWG r2와 GH60 공개 좌표 (둘 다 추정)

GH60 좌표는 [GH60 호환 치수 조사](https://note.com/skeletonkbd/n/n7fdfaac9bd8c?hl=en)의 공개 CAD 비교값이다. "DWG − (0.7, 0.6)" 열은 판 외곽이 GH60 PCB(285 × 94.6)를 가운데 두고 둘러싼다는 **가정**에 따른 변환이다.

| 점 | DWG r2 | DWG − (0.7, 0.6) | GH60 공개 | ΔX, ΔY |
|---|---|---|---|---|
| H01 | (25.150, 67.150) | (24.450, 66.550) | (25.199, 66.699) | −0.749, −0.149 |
| H02 | (129.100, 48.190) | (128.400, 47.590) | (128.200, 47.600) | +0.200, −0.010 |
| H03 | (191.200, 9.900) | (190.500, 9.300) | (190.499, 9.399) | +0.001, −0.099 |
| H04 | (259.720, 67.350) | (259.020, 66.750) | (260.050, 66.699) | −1.030, +0.051 |
| H05 | (3.380, 38.680) | (2.680, 38.080) | (3.709, 38.099) | −1.029, −0.019 |
| H06 | (282.820, 38.880) | (282.120, 38.280) | (281.291, 38.099) | +0.829, +0.181 |

| 중심 간 거리 | DWG r2 | GH60 | 차이 |
|---|---|---|---|
| H01–H04 | 234.570 | 234.851 | −0.281 |
| H05–H06 | 279.440 | 277.581 | **+1.859** |
| H02–H03 | 72.956 | 73.079 | −0.123 |
| H04–H06 | 36.663 | 35.625 | +1.037 |
| H01–H02 | 105.665 | 104.756 | +0.908 |
| H03–H04 | 89.418 | 90.114 | −0.697 |

최적 평행이동(0.404, 0.592) 후에도 잔차가 최대 1.14 mm(H06)다. 균일한 오프셋으로는 설명되지 않는다. 또 r2의 좌우 Y값이 0.2 mm 비대칭이다(H01 67.15 / H04 67.35, H05 38.68 / H06 38.88). 손으로 보정한 흔적일 수 있으며, "막대 부품으로 위치를 억지로 맞췄다"는 기존 설명과도 부합한다. **두 좌표 모두 PSD60 실측(M07·M08) 전에는 사용하지 않는다.**

### 확인 / 추정 / 알 수 없음

| 구분 | 항목 |
|---|---|
| **확인 (DWG 기하값)** | 판 외곽 286.4 × 95.8 (P0–P5). 코너 R3.5 (P1–P5), P0는 C3.5. 스위치 개구부 14.000 × 13.999 (46개). 스페이서 개구부 16.5 × 16.5 (46개). 같은 열 안 키 중심 간격 19.050 (36쌍). 회전각 ±3·5·6·7·9·11° (0°는 2개). 육각 AF 4.711 / AC 5.440 (P1–P4), H01 육각 AF 4.5 (P2). 원 Ø2.0 (P0), Ø3.0 (P5), Ø4.5 (P1·P2). 노치 R2.25 |
| **추정** | 판별 역할과 적층 순서. 소형 육각 부품의 용도. r2 판을 PSD60에 끼우면 직선 변은 맞고 코너만 뜬다는 점(사용자 관찰). 하우징 내측 R < 3.5 (사용자 관찰에서 나온 부등식, 값 아님). 컨트롤러가 ATmega32U4 계열이라는 점(펌웨어 핀 이름 근거) |
| **알 수 없음** | PSD60 내측 치수·R·높이·지지대·나사 규격. 실제 적층 높이와 Z 배치. 스위치 모델. 실제 홀 크기(레이저 커프 보정 여부). 2u 키의 스태빌라이저(DWG에 컷아웃 없음). USB·컨트롤러 위치(DWG에 표현 없음). 287 → 286.4 변경 사유 |

---

## 5. 46키 배치와 부품 구성

### 펌웨어 전기 매트릭스 (확인, 레이어 0)

| row (pin) | 0 (D7) | 1 (E6) | 2 (B4) | 3 (B5) | 4 (F4) | 5 (F5) | 6 (F6) | 7 (F7) | 8 (B1) | 9 (B3) | 10 (B2) | 11 (B6) |
|---|---|---|---|---|---|---|---|---|---|---|---|---|
| 0 (D1) | Q | W | E | R | T | Y | U | I | O | P | BSPC | PGUP |
| 1 (D0) | A | S | D | F | G | H | J | K | L | SCLN | QUOT | PGDN |
| 2 (D4) | SFT_T(Z) | ALT_T(X) | C | V | B | N | M | COMM | DOT | SFT_T(SLSH) | UP | — |
| 3 (C6) | ESC | TAB | LCTL | LGUI | LT(1,SPC) | LT(2,SPC) | RALT | MO(3) | — | LEFT | DOWN | RGHT |

46키, 미사용 위치는 (2,11)과 (3,8)이다. JSON 표시 폭은 1u 43개, 1.25u·1.75u·2u 각 1개이고 회전은 전부 0이다. **JSON 좌표는 표시용일 뿐 물리 배치가 아니다.** DWG의 키는 열마다 회전되어 있다(§4). JSON으로는 어떤 물리 치수도 추정하지 않았다.

### DWG 물리 배치와의 대응 (개수는 확인, 키별 대응은 추정)

| 군집 | DWG P2 개구부 | 펌웨어 키 (추정 대응) |
|---|---|---|
| 왼쪽 주 블록 | 5열 × 3행 = 15 (−3·−3·−6·−9·−11°) | Q–T / A–G / Z–B |
| 왼쪽 바깥 열 | 2 (−3°, 위쪽 1개는 W4) | ESC, TAB |
| 왼쪽 아래 | 3 (−3·−3·−11°) | LCTL, LGUI, LT(1,SPC) |
| 오른쪽 주 블록 | 5열 × 3행 = 15 (+11·+9·+6·+3·+3°) + 6번째 열 2개 (+3°) | Y–P / H–SCLN / N–SLSH + BSPC, QUOT |
| 오른쪽 끝 열 | 2 (0°) | PGUP, PGDN |
| 화살표 역T | 4 (+5°) | UP, LEFT, DOWN, RGHT |
| 오른쪽 엄지 | 3 (+11·+7·+3°) | LT(2,SPC), RALT, MO(3) |
| **합계** | 왼쪽 20 + 오른쪽 26 = **46** | 46 |

1.25u·1.75u·2u 위치도 DWG에서는 모두 단일 14 mm 개구부이고 스태빌라이저 컷아웃이 없다. 실제 키캡 폭은 M17에서 확인한다.

### 부품 구성 (신규 계획 기준, `docs/assembly-revision.md`)

```text
PSD60 Defender ─ 하부 마운트 프레임(케이스 체결) ─ 육각 스탠드오프 ─ 스위치 plate(5T 구조부 + 국부 약 1.5T 걸쇠 체결) ─ 별도 체결 cover
                 └ Pro Micro 브래킷(프레임에 체결) · 패널 고정 USB + 내부 케이블 · plate↔MCU 착탈식 커넥터
```

| 부품 | 역할 | 초안 스케치 | 미확정 핵심 |
|---|---|---|---|
| 하부 프레임 | 케이스 체결(GH60 후보 좌표), plate 지지, 배선·컨트롤러 회피 | `SK10_FRAME_DRAFT_TBD` | 외곽(M01–M03), 체결 좌표·나사(M07–M10), 두께·리브 |
| 육각 스탠드오프 | 프레임–plate 연결·높이 | SK10·SK20의 스택 위치 원 | 형식·AF·길이(M13), 높이(M05·M14) |
| 스위치 plate | 스위치 위치·높이·고정 | `SK20_PLATE_DRAFT_TBD` + 참고 `SK21_REF_r2_P2_DWG_NOT_FOR_PRODUCTION` | 홀(M11·M18·M19), 간격·각도(M12), 코너 |
| 커버 | 측면 틈·빈 공간 가림 | `SK30_COVER_DRAFT_TBD` | 코너 R 샘플, 높이, 키캡 간섭(M17) |
| MCU 브래킷·USB | Pro Micro 단독 교체, USB 삽입 응력을 프레임으로 전달, 하우징과 절연 | 없음 (SK00에 점유 영역만) | 보드 변형·커넥터(M15), USB 개구부·플러그(M16) |
| (공통) | 하우징 내측 기준, USB·컨트롤러 점유 영역 | `SK00_CASE_ENVELOPE_TBD` | M01–M07, M15, M16 |

r2와 신규 계획은 구조가 다르다. r2는 판재 6층 적층이고 스위치 판이 전체 1.5T다. 신규는 5T 구조부에 걸쇠 체결부만 국부 약 1.5T로 두는 plate를 우선 시험한다(전체 1.5T는 대안). r2에서 이어받을 수 있는 건 **배치(키 위치·각도)와 스택 위치 후보**뿐이며, 이것도 현물 대조(M12·M20) 전에는 참고값이다.

---

## 6. 미확정 치수 목록

전체 목록은 `../model/parameters.csv`에 있다(SolidCraft에서 그대로 가져올 수 있는 형식). 주요 항목은 다음과 같다.

| 매개변수 | 현재 값 | 근거 | 측정 |
|---|---|---|---|
| `TBD_case_in_W` / `_D` | 286.4 / 95.8 | r2 판 외곽 (**자리표시**) | M01·M02 |
| `TBD_case_in_R` | 2.5 | Wedge 메시 추정 (PSD60 아님). 하우징 R < 3.5 (사용자 관찰) | M03 |
| `TBD_pcb0_dx` / `_dy` | 0.7 / 0.6 | 가운데 정렬 **가정** | M07 |
| `CAND_H01_X … CAND_H06_Y` | GH60 공개 좌표 | **추정** | M08 |
| `TBD_case_screw_D` | 2 (M2) | 근거 없음 | M09 |
| `TBD_case_boss_clr_D` | 4.5 | r2 회피 구멍 | M10 |
| `TBD_support_H`, `TBD_support_to_rim_F/B` | 0 | **값 없음** | M05 |
| `REF_r2_T_P0 … P5`, `REF_r2_stack_T` | 2 / 5 / 1.5 / 2 / 5 / 2, 합 17.5 | DWG MText 라벨(공칭). 전부 적층 가정 | M21 |
| `TBD_standoff_H` | 0 | **값 없음** | M05·M14 |
| `TBD_so_AF` / `TBD_so_screw_D` | 4.7 / 3 | r2 육각 컷·하판 구멍 | M13 |
| `TBD_sw_hole` | 14.0 | 아크릴 검증값(출발점). 시험 후보 13.9–14.2 | M11·M18 |
| `TBD_sw_pitch` | 19.05 | r2 열 내 간격 | M12 |
| `TBD_sw_ledge_T` / `TBD_sw_relief_W` | 1.5 / 0 | 일반 MX 참고 / 값 없음 | M19 |
| `TBD_plate_T` | 5 | 계획값(5T 구조부. 걸쇠 부위 두께는 `TBD_sw_ledge_T`) | 설계 결정 |
| `TBD_plate_C`, `TBD_frame_C` | 3 / 3 | 모따기 방침, 값 미정 | M03 후 |
| `TBD_cover_R` | 2.5 | 샘플 R2/2.5/3/3.5 | M03·M18 |
| `TBD_ctrl_*`, `TBD_usb_*` | 자리표시 | **근거 없음** | M15·M16 |
| `TBD_keycap_W` / `TBD_cover_H` | 18 / 0 | 일반값 / 값 없음 | M17 |
| 간격·여유 (`*_gap`, `*_clr`) | 0.3–0.4 | 미정 | M18 |

코너 R 관계(사용자 관찰을 반영): 같은 폭·깊이의 둥근 직사각형을 하우징에 넣을 때 **삽입물 R > 하우징 R이면 코너에 틈**이 생기고(r2 상황), **삽입물 R < 하우징 R이면 코너가 간섭**한다. 따라서 plate·cover 코너는 "하우징 내측 R − 간격" 이상이면서 그 값에 가깝게 정한다. 그 전에는 모따기로 간섭을 피한다(planning.md 방침).

---

## 7. 다음 측정 작업 (우선순위 순)

전체 시트는 `../model/measurements.csv`에 있다(측정값 칸은 비어 있음).

1. **하우징 내부 기본 치수**: M01 폭, M02 깊이, M03 코너 R, M05 높이, M06 벽. r2 판이 있으면 끼운 상태에서 네 변과 네 코너의 틈을 필러 게이지로 재면 간접 확인이 빠르다. 같은 자리에서 **M21**(r2 판별 실두께, 적층 순서, 전체 높이)도 잰다. DWG에는 Z 정보가 전혀 없다.
2. **체결**: M07 기준점 오프셋, M08 6점 중심 좌표와 중심 간 거리(얇은 GH60 시험 프레임), M09 나사 규격·유효 깊이, M10 지지대 외경·높이.
3. **스위치**: M19 모델과 걸쇠 위치, M11 기존 아크릴 14 mm 홀의 실제 크기, M12 현물 키 간격·각도, M20 키 수·위치 대조(r2 46 / 현물).
4. **하부 공간**: M13 기존 육각 부품, M14 배선 높이, M15 컨트롤러 외형·위치·커넥터, M16 USB 개구부·케이블 플러그.
5. **외관·공정**: M17 키캡·커버 간섭, M04 외형 문서값 검증, M18 출력 조건 확정 후 홀·여유 샘플.

측정값을 `measurements.csv`에 채운 뒤 `parameters.csv`의 해당 `TBD_` 값을 바꾸고, 근거가 생긴 값은 이름에서 `TBD_`를 떼고 주석에 측정 ID와 날짜를 남긴다. 그다음에 솔리드와 시험 출력용 STL로 넘어간다.

---

## 8. 생성 파일

새로 만든 파일만 있다. 기존 파일(`cad/`, `docs/`, `firmware/`, `images/`, `README.md`, `manifest.json`)은 수정하지 않았으며, 작업 후 해시가 manifest와 일치한다(2026-11-03 검사 시점 기준). 이후 `README.md`·`docs/`·`manifest.json`은 별도 커밋에서 갱신했다. manifest는 이제 46es의 추적 파일 전체를 git blob 기준으로 담으며, `tools/update_manifest.py`로 갱신한다.

| 경로 | 내용 |
|---|---|
| `inspection/46es_r2_dwg_inspection.md` | 이 보고서 |
| `inspection/data/cadcraft_info.json` | CADCraft 도면 요약 |
| `inspection/data/cadcraft_modelspace_entities.json` | 모델 공간 229개 엔티티 전체 (CADCraft) |
| `inspection/data/dwg_object_census.json` | 자체 판독기 결과 (객체 종류, 공간별·블록별 수, 레이어, 고아 치수, 프록시) |
| `inspection/data/geom_loops_panels.json`, `features_by_panel.json` | 루프·판·개구부·구멍 분석 |
| `inspection/render/*.png` | 전체 및 판별 렌더 (CADCraft) |
| `inspection/derived/46es_r2_keyboard_modelspace.dxf` | 모델 공간만 담은 DXF (미사용 블록 정리, 229개 동일 확인). **파생 참고 파일** |
| `inspection/derived/REF_r2_P2_plate_gh60.dxf` | P2 판만, 자리표시 오프셋(−0.7, −0.6)으로 이동. SK21 입력용 |
| `inspection/scripts/*.py` | 분석·교차 검증 스크립트 (읽기 전용). `dwg_thickness.py`는 Z·두께 확인용 |
| `model/parameters.csv` | 매개변수 83개 (SolidCraft `parameters.import` 형식) |
| `model/measurements.csv` | 실측 시트 M01–M21 |
| `model/46es_draft_sketches.sc` | SolidCraft 디자인: 매개변수와 2D 스케치 5개만. 바디·STL 없음 |
| `model/README.md` | 현행 모델과 최신 렌더 안내. 초기 스케치 스크린샷은 후속 정리에서 삭제 |

### 재현

```bash
# 요약·엔티티 (읽기 전용)
cadcraft-cli info cad/46es_r2_keyboard.dwg
cadcraft-cli run cad/46es_r2_keyboard.dwg --cmd 'entities {"limit":5000}'
# 독립 교차 검증
python -I inspection/scripts/dwg_census.py cad/46es_r2_keyboard.dwg census.json
# 전체 DXF (약 9.7 MB, 미사용 블록 포함, *D 블록 제외)
cadcraft-cli convert cad/46es_r2_keyboard.dwg out.dxf
```
