zzskm/keyboard/46es/inspection/render/overview.png

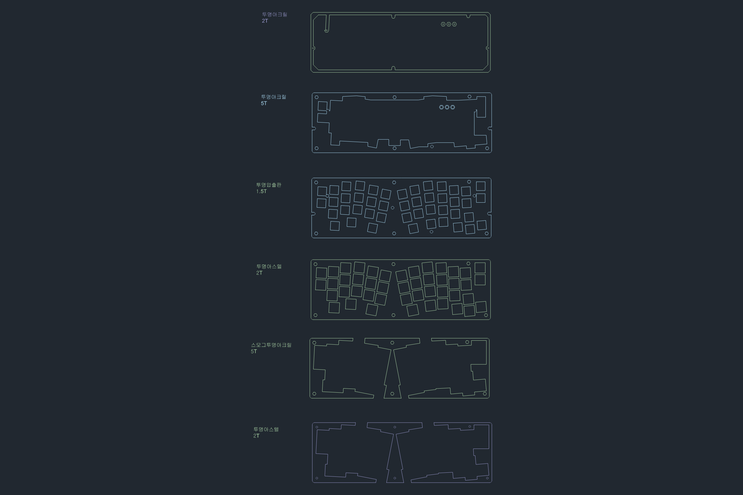
46es/inspection/render/overview.png
