zzskm/keyboard/46es/inspection/render/p0_top_2T.png

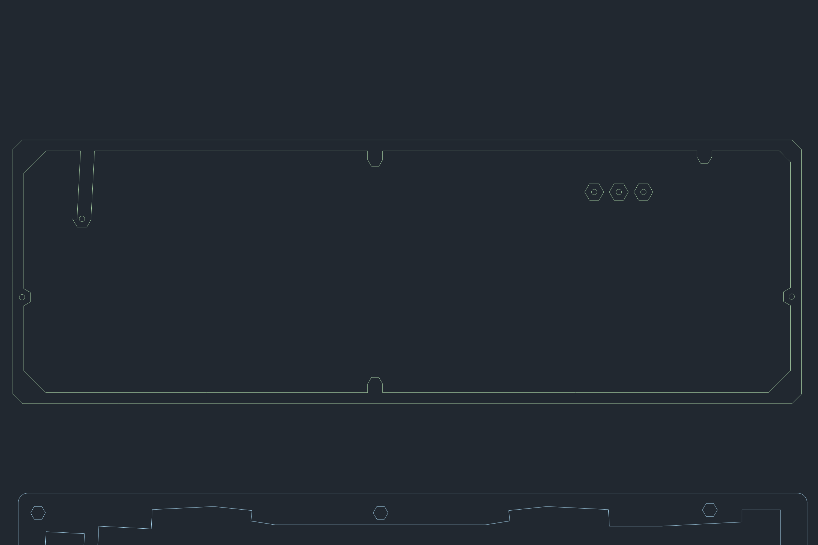
46es/inspection/render/p0_top_2T.png
