zzskm/keyboard/46es/inspection/render/p1_acryl_5T.png

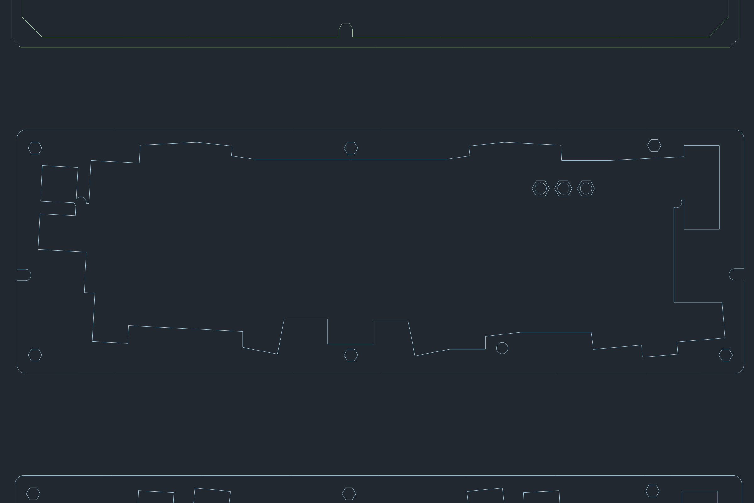
46es/inspection/render/p1_acryl_5T.png
