zzskm/keyboard/46es/inspection/render/p2_plate_1p5T.png

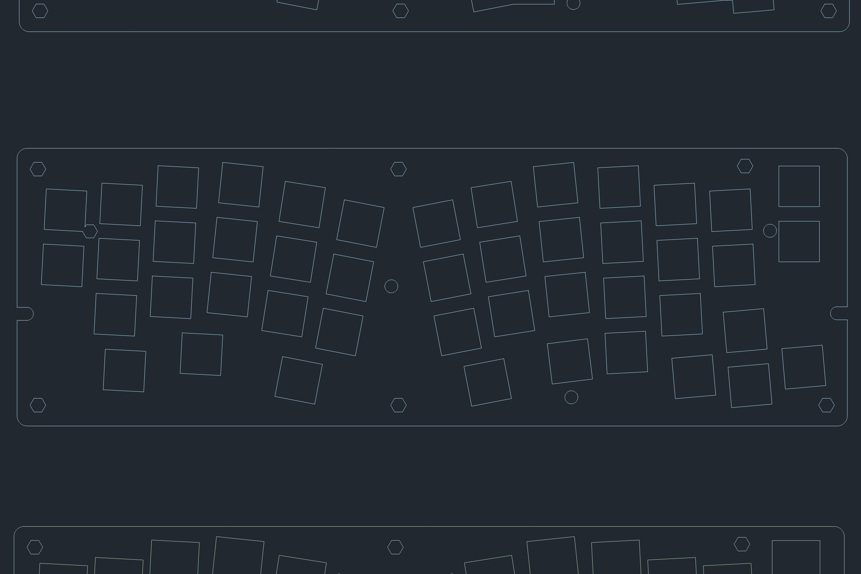
46es/inspection/render/p2_plate_1p5T.png
