zzskm/keyboard/46es/inspection/render/p4_smoke_5T.png

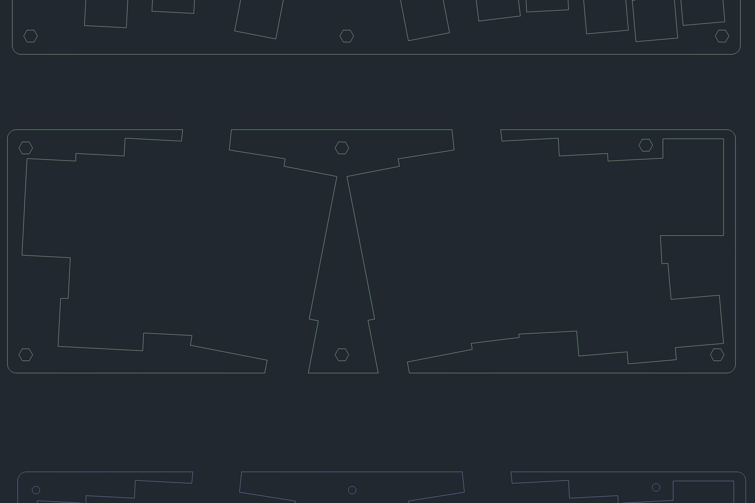
46es/inspection/render/p4_smoke_5T.png
