zzskm/keyboard/46es/inspection/render/p5_astel_2T_b.png

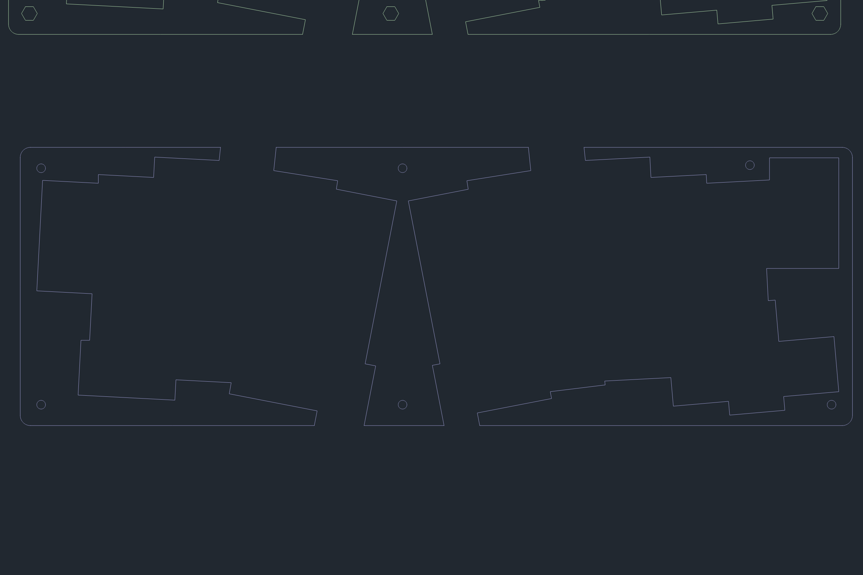
46es/inspection/render/p5_astel_2T_b.png
