zzskm/keyboard/46es/inspection/wilmore/render/compare_z4.0_housing_vs_wilmore.png

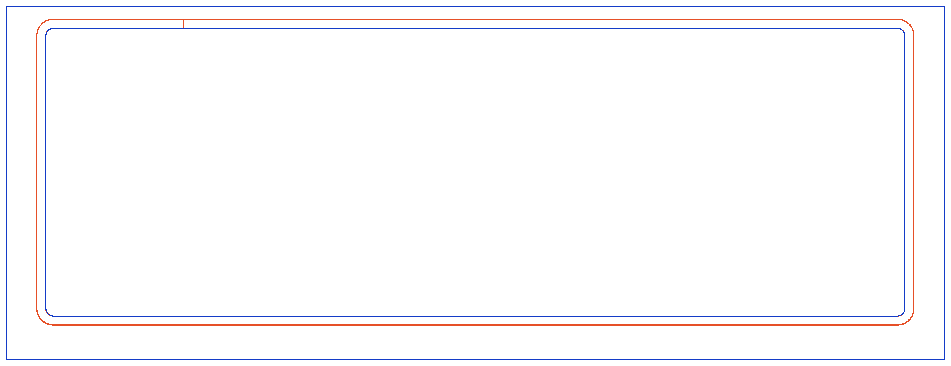
46es/inspection/wilmore/render/compare_z4.0_housing_vs_wilmore.png
