zzskm/keyboard/46es/model/46es_draft_sketches_top.png

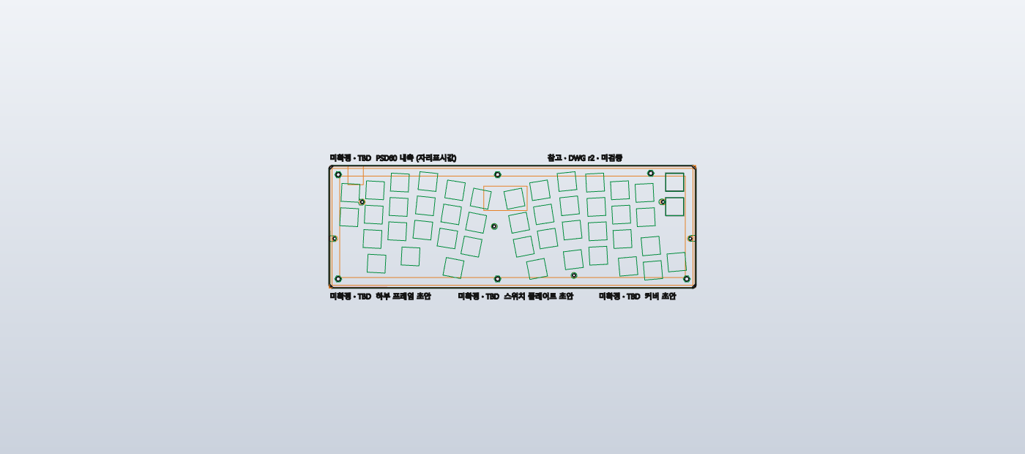
46es/model/46es_draft_sketches_top.png
