zzskm/keyboard/46es/model/46es_mount_minimal_v2_top_review.png

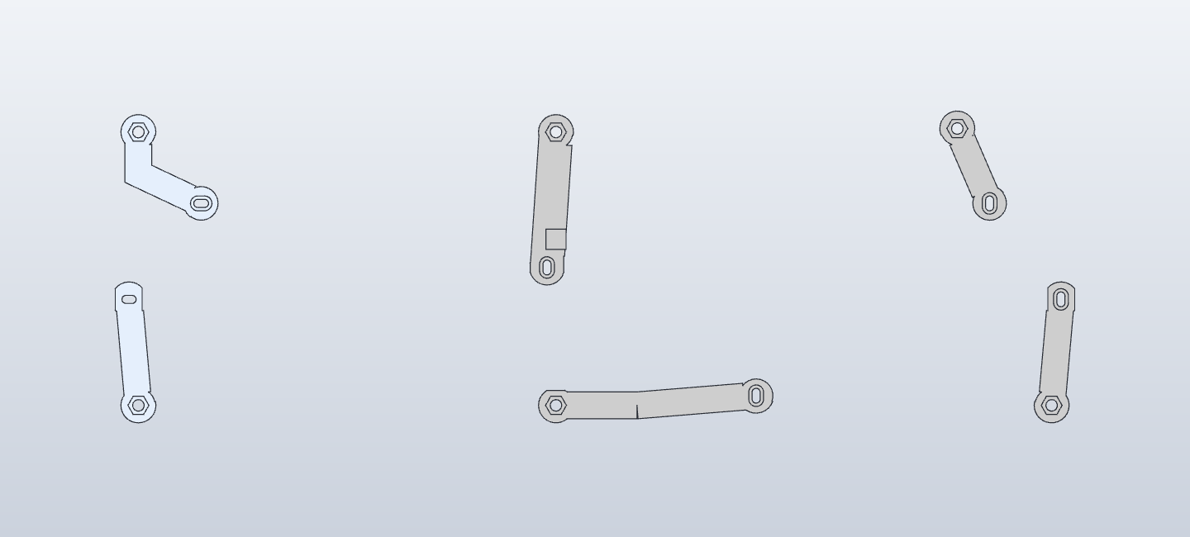
46es/model/46es_mount_minimal_v2_top_review.png
