zzskm/keyboard/46es/model/jigs/46es_jig_A_case_holes_top.png

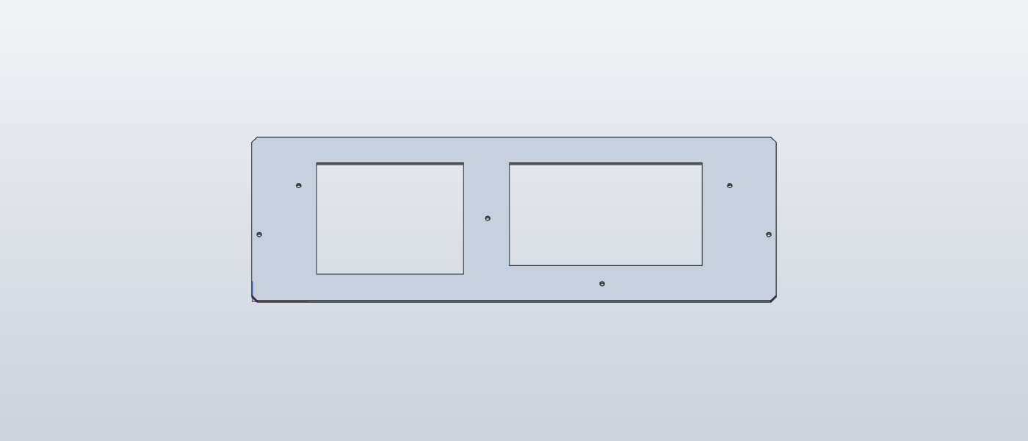
46es/model/jigs/46es_jig_A_case_holes_top.png
