zzskm/keyboard/46es/model/samples/46es_sw_hole_sample_top.png

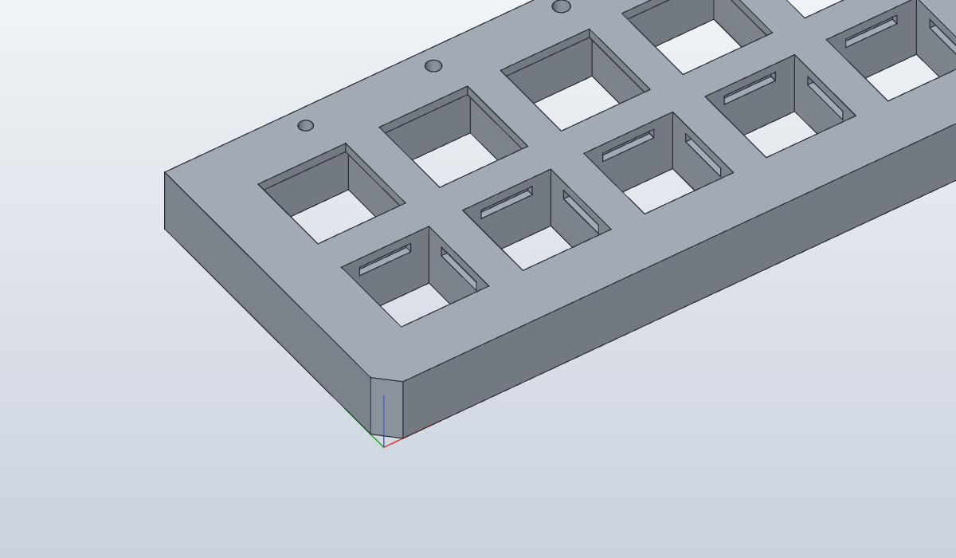
46es/model/samples/46es_sw_hole_sample_top.png
