zzskm/keyboard/46sp/images/check-thumb-keycap.png

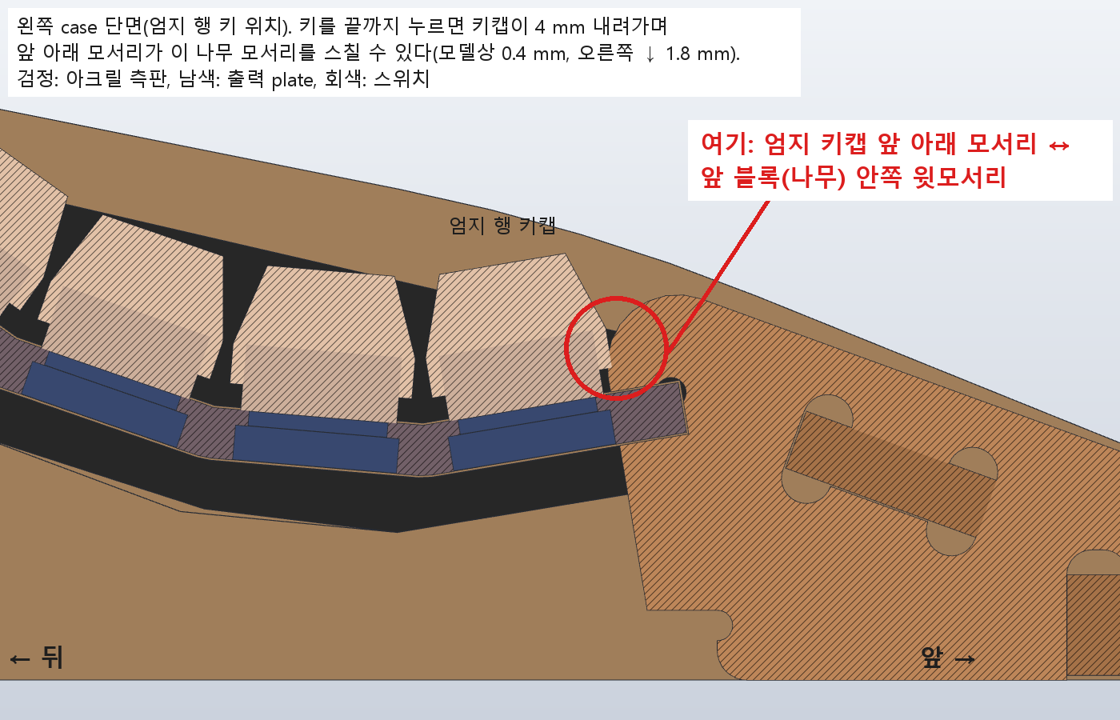
46sp/images/check-thumb-keycap.png
