zzskm/keyboard/46sp/images/controller-layout.png

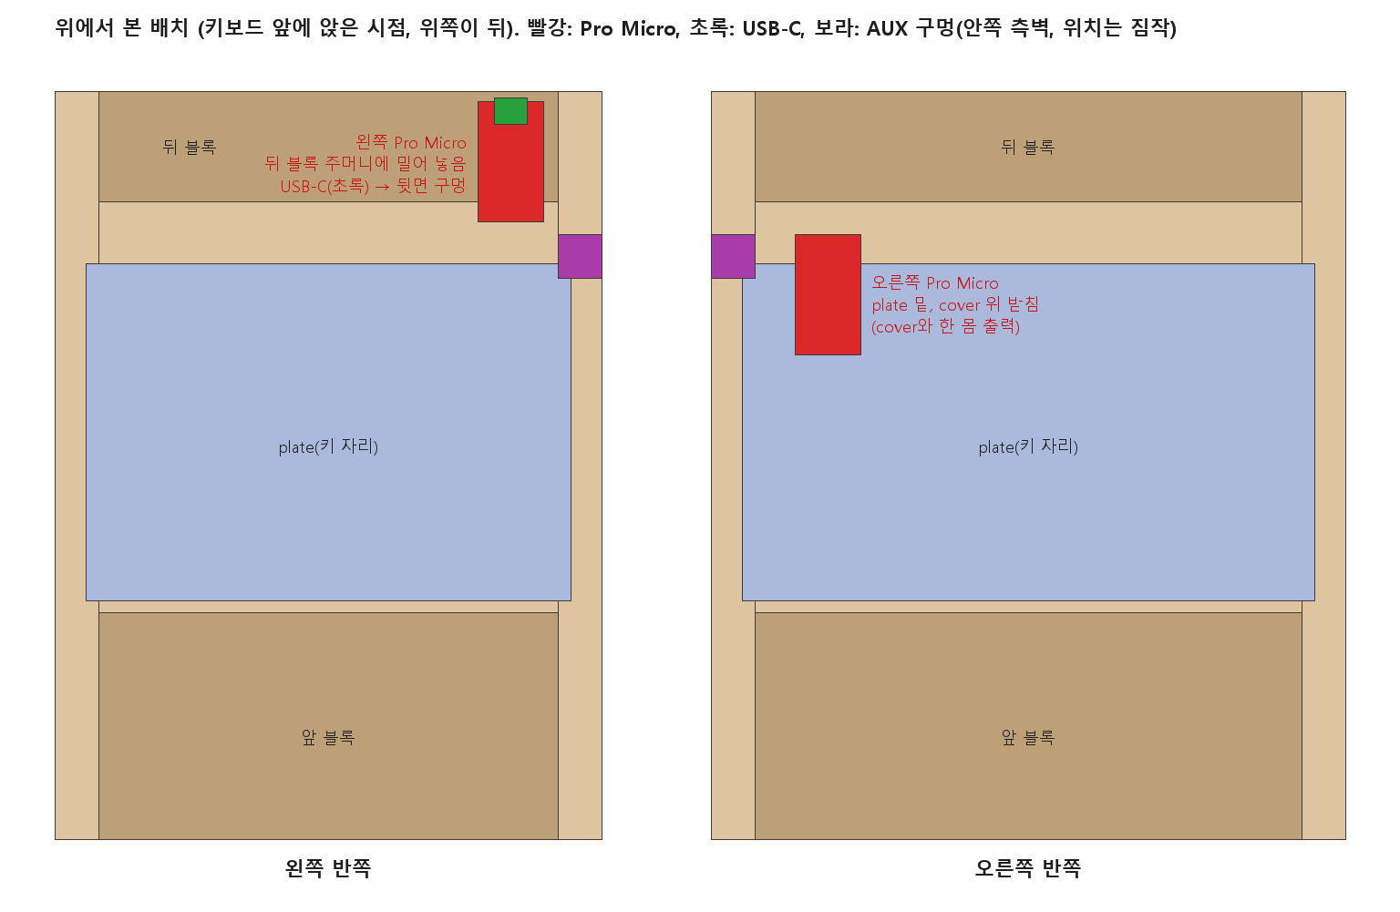
46sp/images/controller-layout.png
