zzskm/keyboard/PURCHASE.md

# 46es·46sp 부품 구매 목록

46es v5와 46sp를 한 대씩 조립하는 기준이다. 보유 수량은 사용자가 제공한 목록을 적용했다. AliExpress 링크는 상품 후보이며 한국 배송 기준 재고·결제가는 미확인이다. 주문 전에 아래 표의 옵션을 선택하고, 치수가 필요한 품목은 판매자 도면에서 확인한다.

설계 기준은 [46es v5 하드웨어](46es/model/print_v5/README.md#하드웨어), [46es 조립 가이드](https://zzskm.github.io/keyboard-46es/), [46sp 배선](46sp/README.md#좌우-연결과-펌웨어)이다.

## 구매할 부품

| 대상 | 부품 | 필요 수량 및 주문 옵션 | AliExpress |
|---|---|---|---|
| 46es | 브래킷·spine 및 앞 이음 버튼헤드 | **M2×6 6개**, **M2×5 1개**. ISO 7380, 머리 지름 3.5–3.8 mm, 높이 1.3 mm 이하. 특히 앞 이음에 쓰는 M2×5의 머리 높이를 확인한다. 보유 나사에는 M2가 없다. | [버튼헤드 상품의 M2 옵션](https://www.aliexpress.com/item/1005006281359483.html) |
| 46es | M2 육각 너트 | **7개**. DIN 934 M2, 맞변 4 mm, 높이 1.6 mm. | [DIN 934 너트](https://www.aliexpress.com/item/32874684920.html) |
| 46es | 원형 네오디뮴 자석 | 장착 **10개**(보스 6개, 다리 4개). 시험·예비 포함 **20개 이상**. 지름 **3 mm × 두께 2 mm**, 니켈 도금, N52 우선. 링크는 설계에서 허용하는 N35 후보이다. | [Ø3×2 N35 후보](https://www.aliexpress.com/item/1005013035412043.html) |
| 46es | 스위치 | **최소 7개 추가**. 보유 Gateron 5핀 Milky Yellow 39개를 모두 46es에 쓰는 기준이다. 46es 지정품은 KS-3 Milky Yellow Pro 5핀이다. 보유품 버전을 확인하고 같은 버전으로 보충한다. | [Milky Yellow Pro 5핀 후보](https://www.aliexpress.com/item/1005008685972487.html) |
| 46sp | 컨트롤러 | **구매하지 않는다.** 보유 USB-C ATmega32U4 Pro Micro 2개를 좌우에 하나씩 쓴다(사용자 2026-11-12). RP2040-Zero 2개 구매안은 취소했다. | — |

스위치 추가 수량 7개는 보유 39개가 46sp에 장착된 스위치와 별도라는 가정이다. 46sp는 장착분을 이식하며 46키로 진행하므로, 46sp 몫의 추가 구매량은 46개에서 이식 가능한 장착분을 뺀 수량이다. 기존 판(r3)의 개구는 45개다. [46sp 이식 확인 항목](46sp/TODO.md#1-기존-조립체-기록과-출력-조건-확인)

## 보유량과 호환성을 확인한 뒤 구매

| 대상 | 부품 | 필요 수량 및 확인 사항 | AliExpress |
|---|---|---|---|
| 공용 | 다이오드 | 두 대 모두 새로 배선하면 **92개**(46키 × 2). 보유량이 부족하면 리드형 **1N4148 DO-35 100개 묶음** 1개. | [1N4148 100개](https://www.aliexpress.com/item/1005008123602046.html) |
| 공용 | 내부 배선재 | 부족하면 **26 AWG 주석도금 구리 연선**. 행·열 구분에 두 색을 쓸 수 있다. | [실리콘 피복 연선](https://www.aliexpress.com/item/1005001877127749.html) |
| 46es | 투명 2액형 에폭시 | 커버와 플레이트의 자석 고정용 **1세트**. 보유 접착제의 종류를 확인한다. | [투명 AB 에폭시](https://www.aliexpress.com/item/1005010228922245.html) |
| 46es | Pro Micro | **구매하지 않는다.** 기존에 쓰던 키보드의 컨트롤러를 분해해 쓴다(사용자 2026-11-12). 현행 스냅 브래킷은 약 33 × 18 mm Micro-B 보드 기준이므로 분해한 보드의 길이·폭·두께·USB 소켓을 재고(M15), 다르면 `46es/tools/ctrl_v5.py`를 고친다. 보유 USB-C 보드 2개는 46es에 쓰지 않고 46sp에 쓴다. | [보드가 상했을 때 Micro-B 후보](https://www.aliexpress.com/item/1005010111006659.html) |
| 46es | 키캡 | 부족분만 구매. OEM 프로파일 기준 **1u 43개, 1.25u·2u·2.25u 각 1개**. 구매 세트의 폭과 행별 높이를 대조한다. | [OEM 무각 키캡 후보](https://www.aliexpress.com/item/1005003894469722.html) |
| 46sp | PC 연결 케이블 | 보유 케이블이 없으면 **USB-C 데이터 케이블 1개**. 링크는 PC 쪽이 USB-A인 경우의 후보이다. | [USB-A → USB-C 데이터 케이블](https://www.aliexpress.com/item/1005012403639360.html) |

46es의 PSD60 기존 케이스 나사 6개와 내부 USB 케이블은 재사용한다. 분해한 컨트롤러의 USB 소켓이 Micro-B가 아니면 내부 케이블의 보드 쪽 플러그를 그에 맞춘다. [46es 하드웨어](46es/model/print_v5/README.md#하드웨어) · [46es 조립 가이드](https://zzskm.github.io/keyboard-46es/)

## 설계·시험 조립 후 결정

| 대상 | 부품 | 결정할 사항 | 링크 |
|---|---|---|---|
| 46sp | 좌우 커넥터·케이블 | **AUX 케이블과 단자 보유**. 단자 2개와 케이블 1개가 서로 맞물리고 독립 접점 3개가 이어지면 좌우 연결에 재사용할 수 있다. 실물 단자의 패널 고정과 내부 깊이도 확인한다. 잠금식 연결이 필요하면 소켓 2개, 짝 플러그 2개, 3심 케이블을 산다. | [GX12 3핀 후보](https://www.aliexpress.com/item/32871937090.html) · [3심 케이블 후보](https://www.aliexpress.com/item/1005009572619578.html) |
| 46sp | 케이스 체결품·범폰 | 보유한 M3×8 평머리 200개(`3×8 NI F/N` 표기), M3×5 둥근머리 200개(`NI P/N 3×5` 표기), **M3×10 십자 접시머리 55개**, 원형 황동 인서트 14개(M3, 외경 Ø5 mm × 높이 4 mm, 20개 중 6개는 46es), 흑철색 M3×10 둥근머리 육각 볼트 94개(100개 중 6개는 46es), 범폰 8개를 기준으로 머리 자리·체결 깊이·보스·바닥을 검토한다. 설계 후 부족분을 산다. | [체결 확인 항목](46sp/TODO.md#3-체결-방식-상세-설계) |
| 46es | 뒤 받침 블록 점착 패드 | **3개와 시험분**. 공칭 틈 0.5 mm를 기준으로 블록 높이와 함께 시험 조립 후 두께를 고른다. | [얇은 실리콘 시트 후보](https://www.aliexpress.com/item/1005010616602064.html) |

AUX를 재사용할 경우 전원을 뺀 상태에서 케이블 양 끝과 단자의 연속성을 측정해 GND·5 V·D2를 각각 대응시키고 선 사이의 단락 여부를 확인한다. USB 전원을 분리하고 AUX 케이블을 탈착한다. [QMK 좌우 연결](https://docs.qmk.fm/features/split_keyboard#hardware-configuration) · [46sp 배선](46sp/README.md#좌우-연결과-펌웨어)

## 46es에 쓰는 보유품

2026-11-12에 46es의 SO 체결 6곳을 보유품에 맞춰 바꿨다([결정 이력](46es/docs/design.md#결정-이력)). 황동 육각 지지대, plate 위 M3×4, mount 아래 M3×5는 더 이상 사지 않는다.

| 부품 | 보유품 | 46es 사용 | 확인할 것 |
|---|---|---:|---|
| SO 인서트 | 원형 황동 M3 인서트, 외경 Ø5 × 높이 4, 20개 | 6 | mount 보스 구멍 Ø4.2에 열압입. 주문 1 B 쿠폰 행 D(Ø4.0–4.6)로 구멍 지름을 정한다 |
| SO 나사 | 흑철색 둥근머리 육각 볼트 M3×10, 100개 | 6 (+예비) | 커버 자석이 머리에 붙는지(흑색 산화 합금강), 머리가 ISO 7380(Ø5.7 × 1.65)급인지 |
| 케이스 나사 | PSD60 기존 나사 | 6 | 주문 1 mount로 길이·머리 확인 |
| 컨트롤러 | 기존 키보드에서 분해한 Pro Micro | 1 | 길이·폭·두께·USB 소켓(M15) |

보유 육각 인서트(`3×10`, `3×14` 표기, 맞변 5 mm)는 46es에 쓰지 않는다. `3×10` 표기 품목은 수량을 확인하고, 이전에 기록한 육각 지지대 `M3-5-05` 17개와 같은 재고인지 대조한다. `3×14` 표기 품목은 20개 보유한다. 46sp에 쓸 경우 몸체 길이와 양끝의 M3 관통 나사산을 실물로 확인한다.

보유 M1.6×14는 약 20개이며, 현재 지정된 체결 위치가 없다.
