zzskm/keyboard/46es/model/46es_parts_v2_section_usb_x18.png

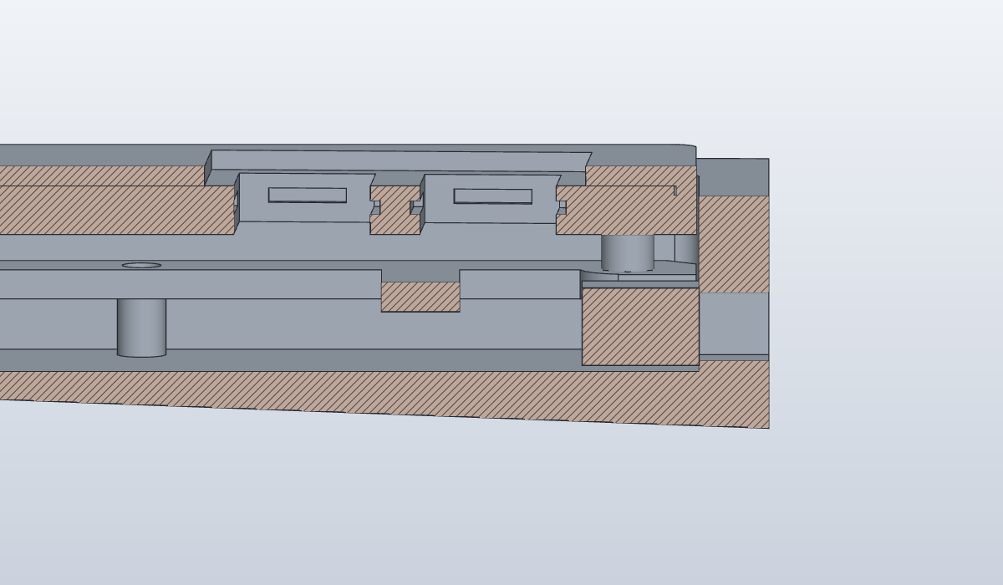
46es/model/46es_parts_v2_section_usb_x18.png
