zzskm/keyboard/46es/model/46es_parts_v3_iso.png

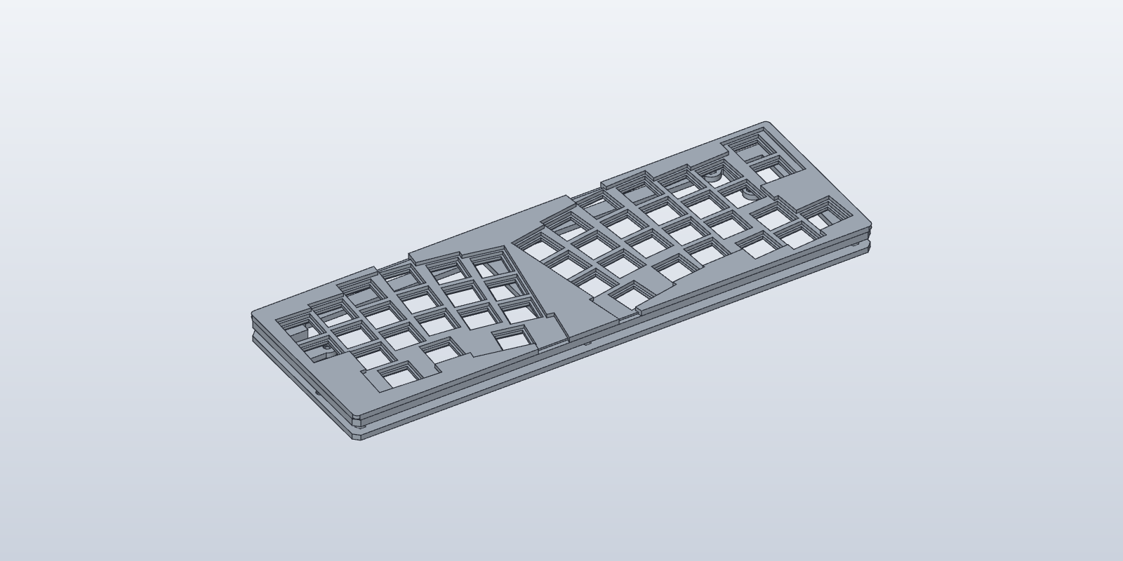
46es/model/46es_parts_v3_iso.png
