zzskm/keyboard/46es/inspection/derived/46es_r2_keyboard_modelspace.dxf

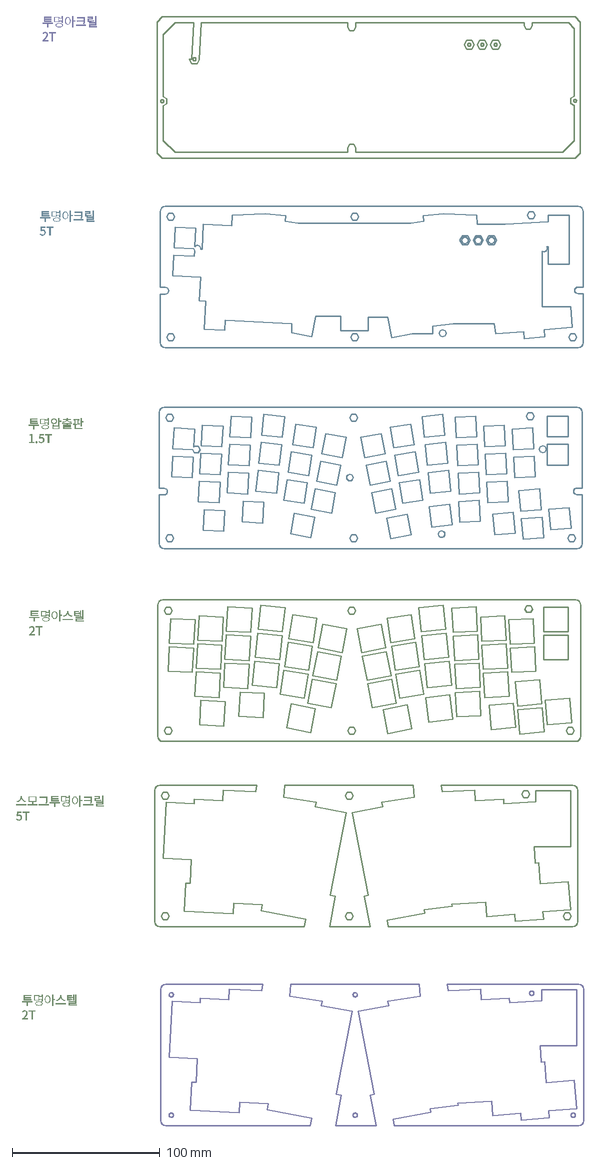
[picture p25: CAD file, 2026-11-03]
46es/inspection/derived/46es_r2_keyboard_modelspace.dxf
투명압출판 1.5T
투명아크릴 5T
투명아스텔 2T
투명아크릴 2T
스모그투명아크릴 5T
