zzskm/keyboard/46es/model/mounts_cadcraft_phase1.dxf

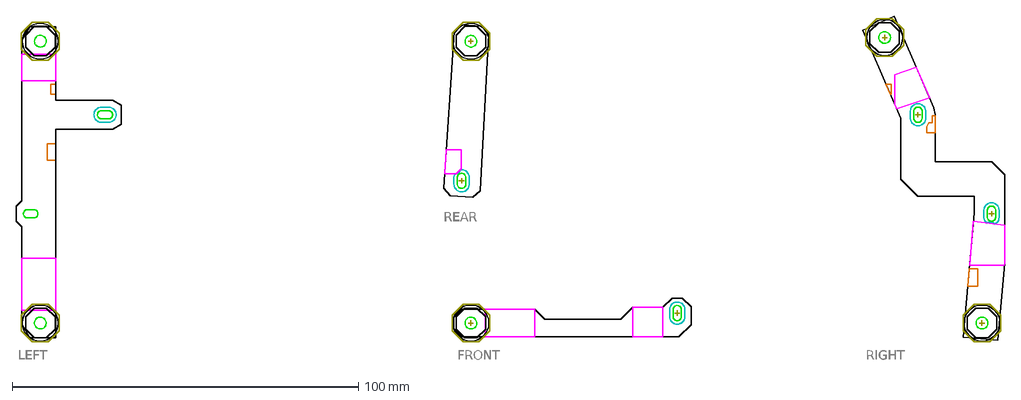
[picture p26: CAD file, 2026-11-12]
46es/model/mounts_cadcraft_phase1.dxf
LEFT
RIGHT
REAR
FRONT
