zzskm/keyboard/46es/model/print_v5/order1/46es_v5_sw_hole_coupon.step

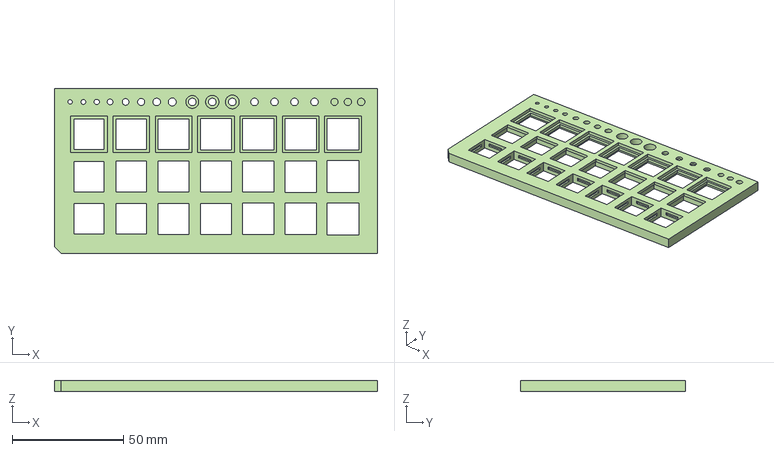
[picture p27: CAD file, 2026-11-12]
46es/model/print_v5/order1/46es_v5_sw_hole_coupon.step
145.4 x 74.2 x 5.00 mm
