zzskm/keyboard/46es/model/print_v5/order2/46es_v5_spine.step

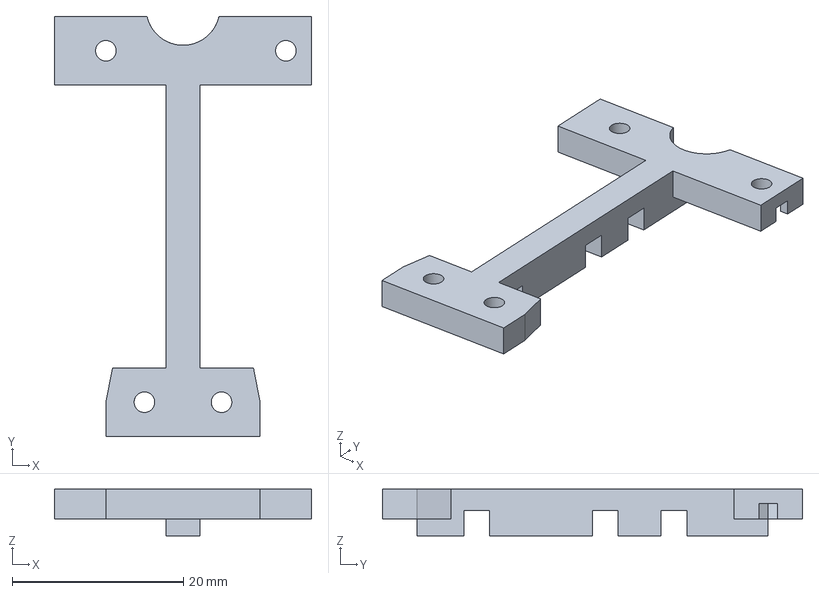
[picture p28: CAD file, 2026-11-12]
46es/model/print_v5/order2/46es_v5_spine.step
30.0 x 49.0 x 5.45 mm
