zzskm/keyboard/46es/model/review_minimal_v2/MOUNT_H01_SO2_MIN_V2_REVIEW_ONLY.stl

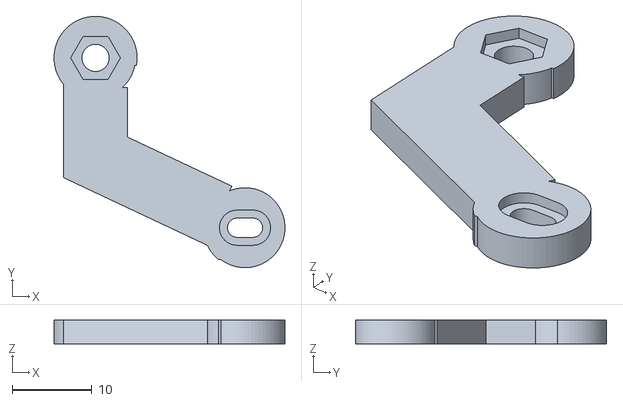
[picture p29: CAD file, 2026-11-05]
46es/model/review_minimal_v2/MOUNT_H01_SO2_MIN_V2_REVIEW_ONLY.stl
28.9 x 31.4 x 3.00
