zzskm/keyboard/46es/model/review_side_pairs_v3/PLATE_R_SPLIT_V1_REVIEW_ONLY.stl

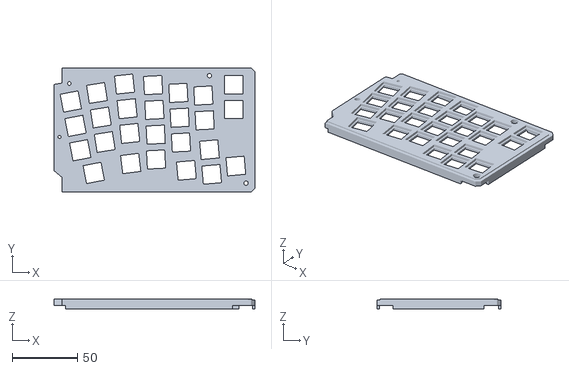
[picture p30: CAD file, 2026-11-05]
46es/model/review_side_pairs_v3/PLATE_R_SPLIT_V1_REVIEW_ONLY.stl
154.3 x 95.3 x 8.00
