zzskm/keyboard/46sp/model/controller-layout.dxf

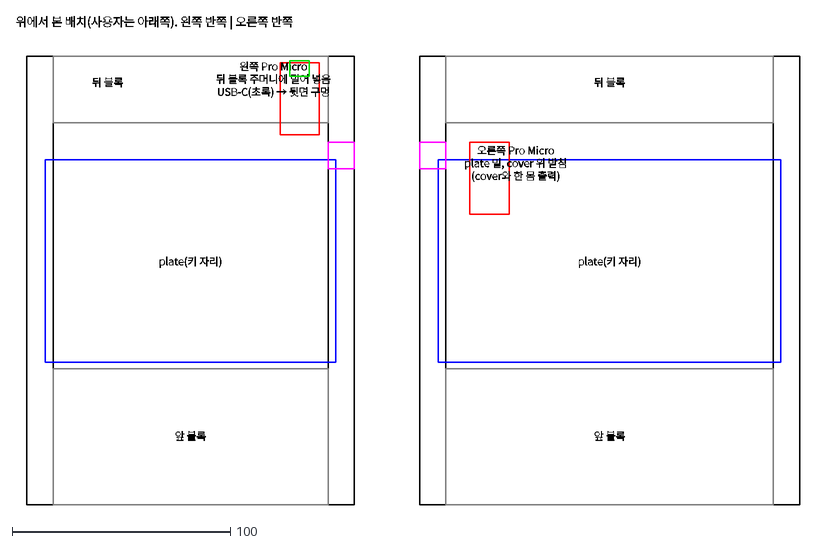
[picture p32: CAD file, 2026-11-13]
46sp/model/controller-layout.dxf
뒤 블록
앞 블록
plate(키 자리)
왼쪽 Pro Micro 뒤 블록 주머니에 밀어 넣음 USB-C(초록) → 뒷면 구멍
오른쪽 Pro Micro plate 밑, cover 위 받침 (cover와 한 몸 출력)
위에서 본 배치(사용자는 아래쪽). 왼쪽 반쪽 | 오른쪽 반쪽
