zzskm/keyboard/46sp/model/print/46sp_Cover_L.stl

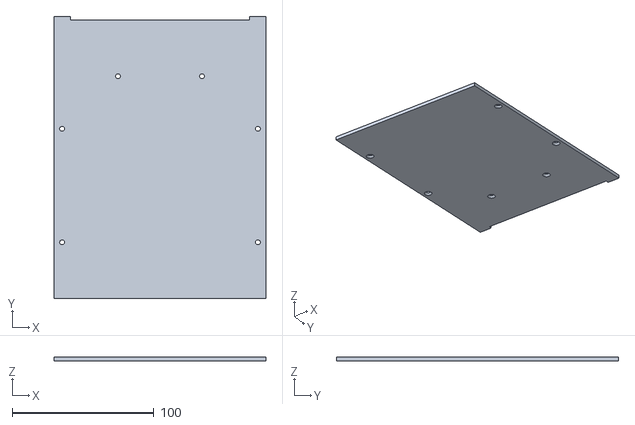
[picture p33: CAD file, 2026-11-13]
46sp/model/print/46sp_Cover_L.stl
149.4 x 199.0 x 3.00
