zzskm/keyboard/46sp/source/46sp_plate_46key.dxf

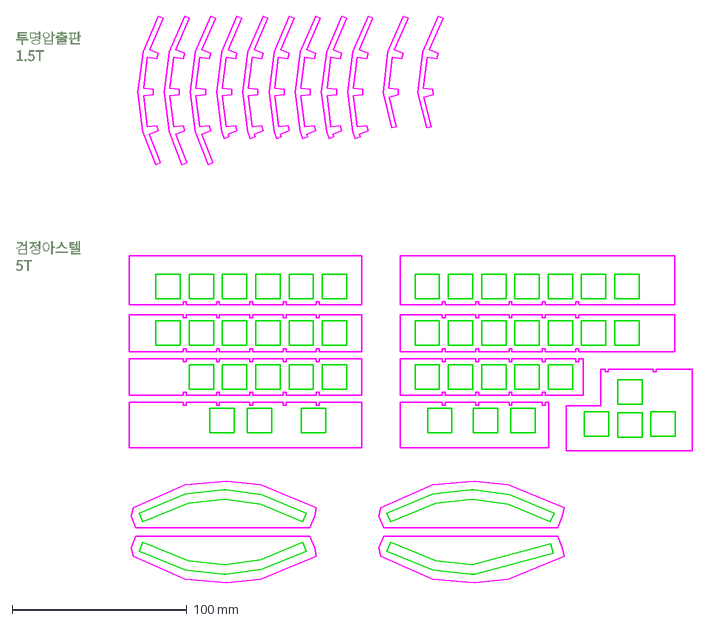
[picture p34: CAD file, 2026-11-13]
46sp/source/46sp_plate_46key.dxf
검정아스텔 5T
투명압출판 1.5T
