zzskm/keyboard/46sp/source/dxf/46sp_inside_fw_r.dxf

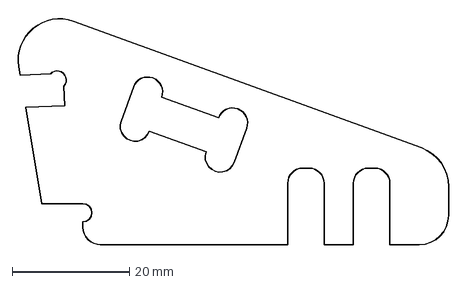
[picture p35: CAD file, 2026-11-11]
46sp/source/dxf/46sp_inside_fw_r.dxf
73.6 x 38.9 mm
