zzskm/keyboard/46sp/source/nesting/nesting_fw_a.dxf

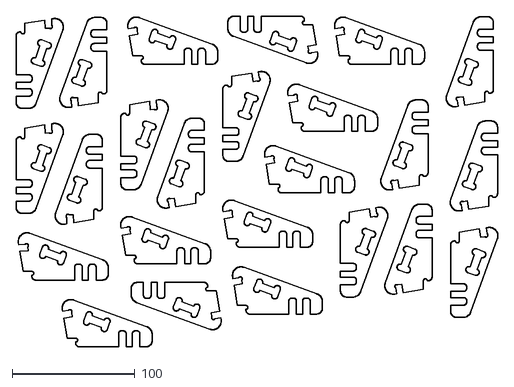
[picture p36: CAD file, 2026-11-11]
46sp/source/nesting/nesting_fw_a.dxf
392.4 x 269.2
