zzskm/keyboard/46es/inspection/derived/REF_r2_P2_plate_gh60.dxf

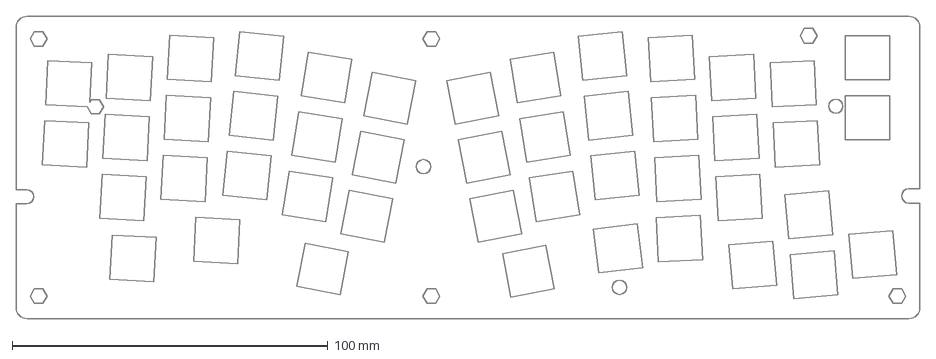
[picture p37: CAD file, 2026-11-03]
46es/inspection/derived/REF_r2_P2_plate_gh60.dxf
286.4 x 95.8 mm
