zzskm/keyboard/46es/model/print_v5/order1/46es_v5_mount_R.step

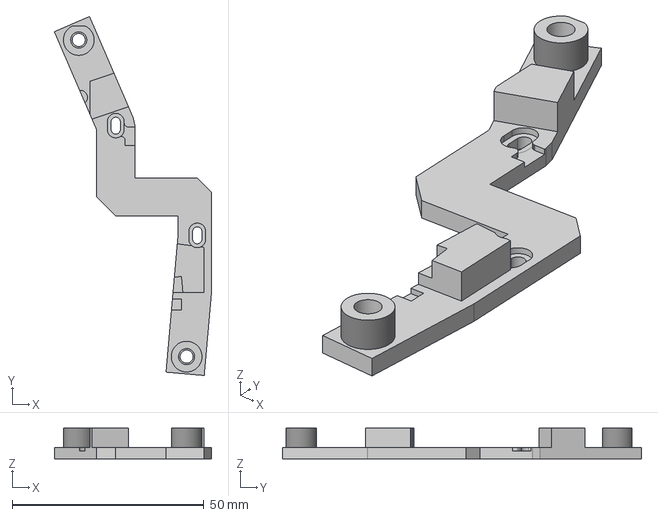
[picture p38: CAD file, 2026-11-12]
46es/model/print_v5/order1/46es_v5_mount_R.step
41.0 x 93.5 x 8.00 mm
