zzskm/keyboard/46es/model/print_v5/order2/46es_v5_plate_L.step

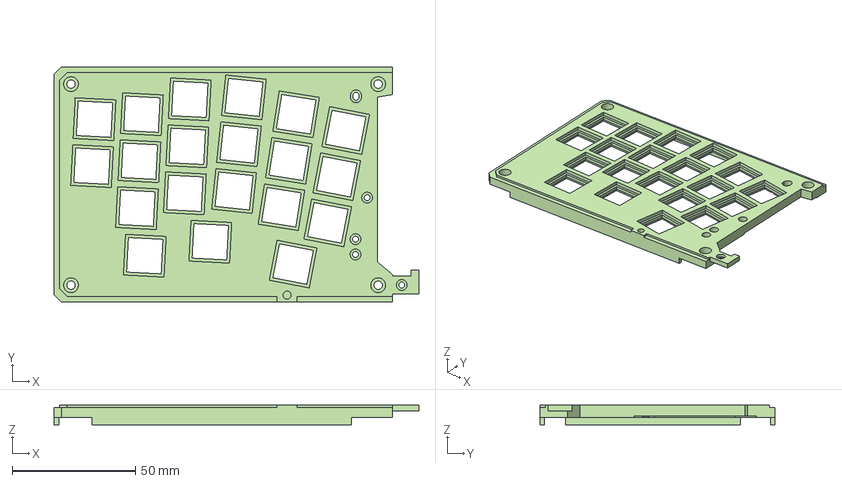
[picture p39: CAD file, 2026-11-11]
46es/model/print_v5/order2/46es_v5_plate_L.step
147.8 x 95.3 x 8.00 mm
