zzskm/keyboard/46es/model/review_v5/46es_v5_cover_T_REVIEW_ONLY.step

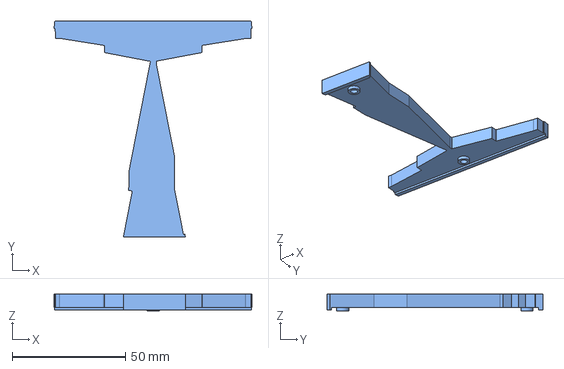
[picture p40: CAD file, 2026-11-10]
46es/model/review_v5/46es_v5_cover_T_REVIEW_ONLY.step
87.5 x 95.3 x 7.50 mm
