zzskm/keyboard/46sp/model/print/46sp_Plate_R.stl

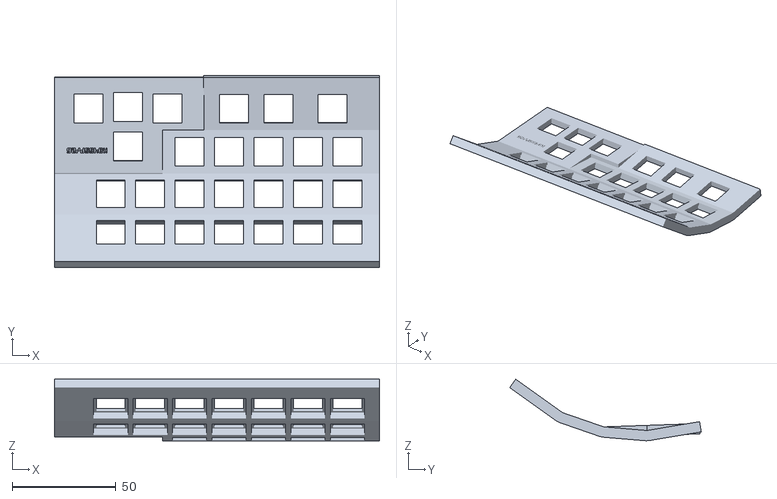
[picture p41: CAD file, 2026-11-13]
46sp/model/print/46sp_Plate_R.stl
157.0 x 92.6 x 29.8
