zzskm/keyboard/46sp/source/dxf/46sp_inside_bw_b.dxf

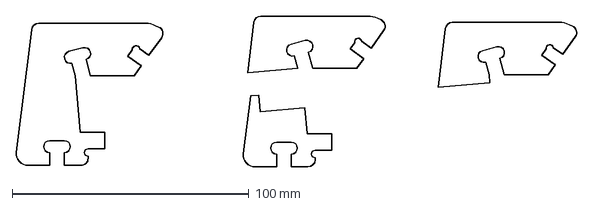
[picture p42: CAD file, 2026-11-11]
46sp/source/dxf/46sp_inside_bw_b.dxf
236.8 x 63.7 mm
