zzskm/keyboard/46sp/source/kb46sp_v11.step

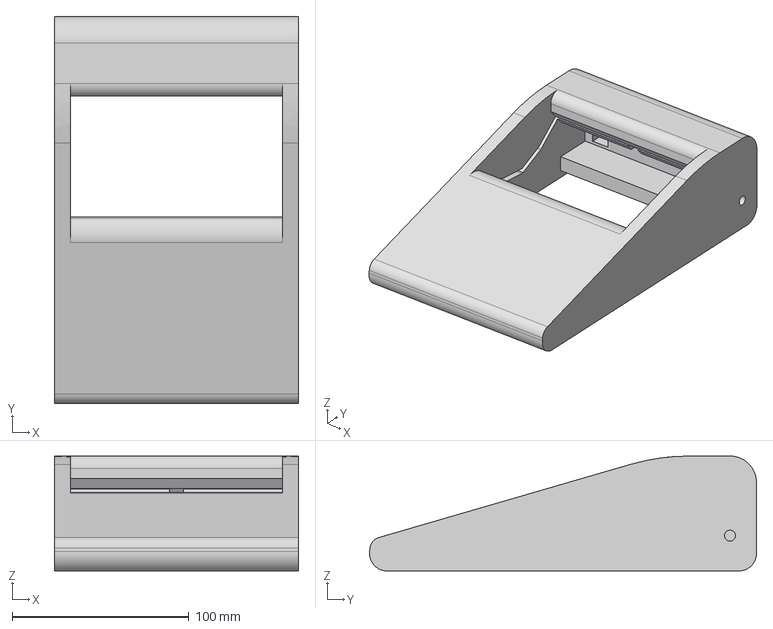
[picture p43: CAD file, 2026-11-13]
46sp/source/kb46sp_v11.step
138.0 x 218.8 x 65.0 mm
