zzskm/keyboard/46sp/source/nesting/nesting_bw_a.dxf

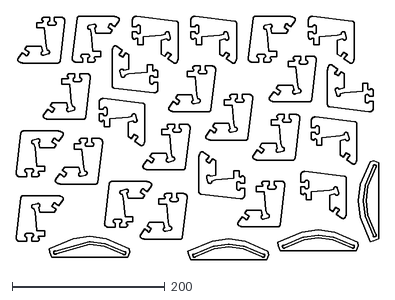
[picture p44: CAD file, 2026-11-11]
46sp/source/nesting/nesting_bw_a.dxf
475.6 x 319.3
