zzskm/keyboard/46es/model/print_v5/order1/46es_v5_mount_H02_SO3.step

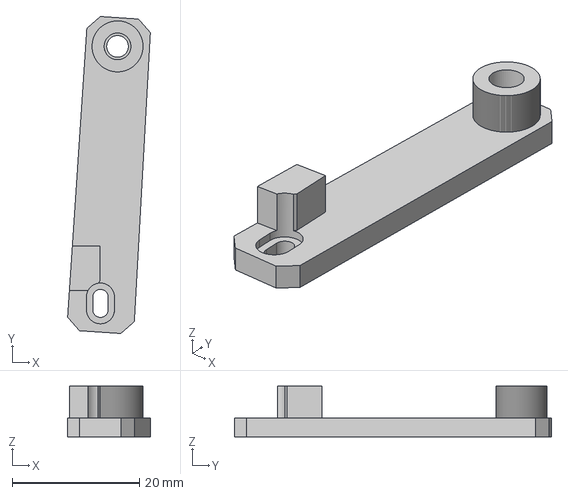
[picture p45: CAD file, 2026-11-12]
46es/model/print_v5/order1/46es_v5_mount_H02_SO3.step
13.0 x 49.8 x 8.00 mm
