zzskm/keyboard/46es/model/print_v5/order2/46es_v5_cover_L.step

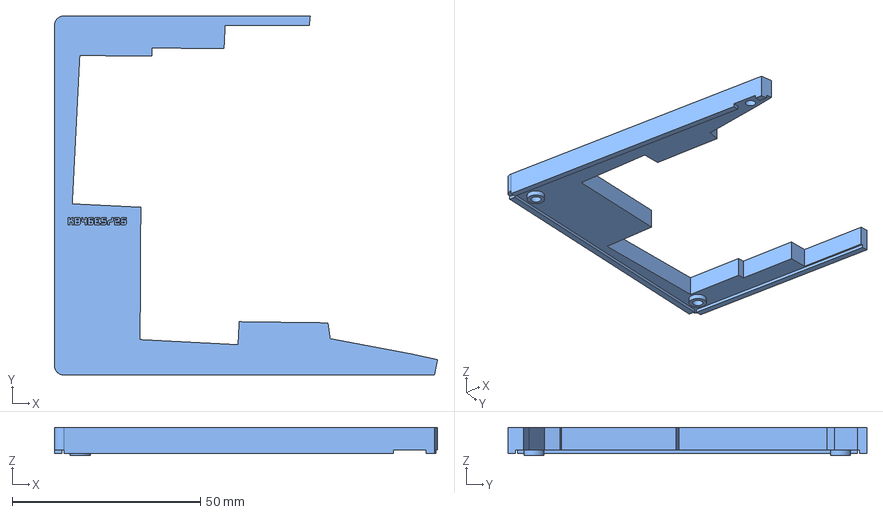
[picture p46: CAD file, 2026-11-11]
46es/model/print_v5/order2/46es_v5_cover_L.step
101.7 x 95.3 x 7.50 mm
