zzskm/keyboard/46es/model/review_v5/46es_v5_changed_REVIEW_ONLY.step

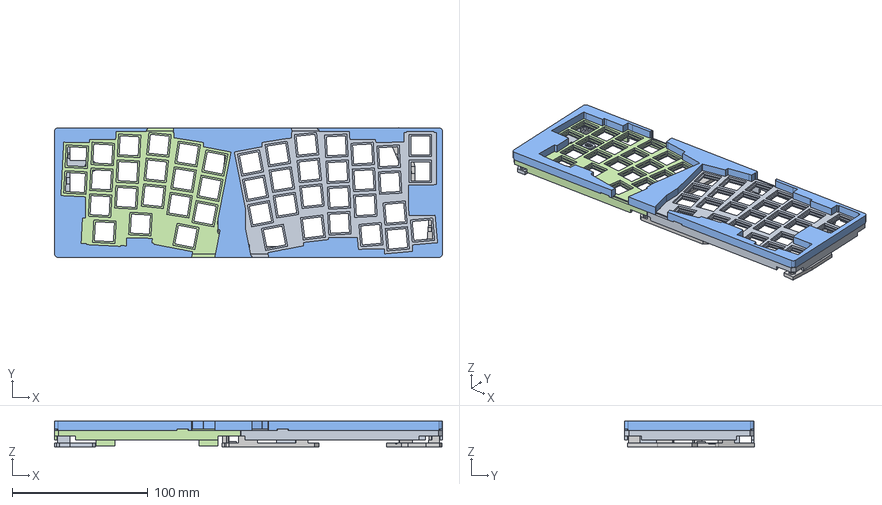
[picture p47: CAD file, 2026-11-10]
46es/model/review_v5/46es_v5_changed_REVIEW_ONLY.step
285.8 x 95.5 x 19.0 mm
