zzskm/keyboard/46sp/model/print/46sp_Plate_L.stl

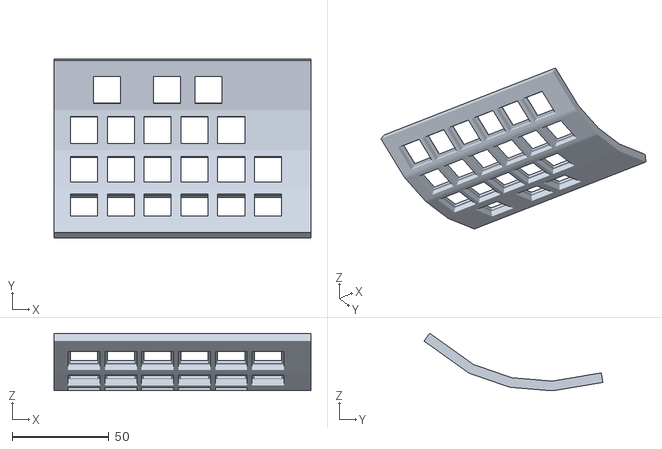
[picture p48: CAD file, 2026-11-13]
46sp/model/print/46sp_Plate_L.stl
133.0 x 92.6 x 29.8
