zzskm/keyboard/46sp/source/dxf/46sp_inside_bw_a.dxf

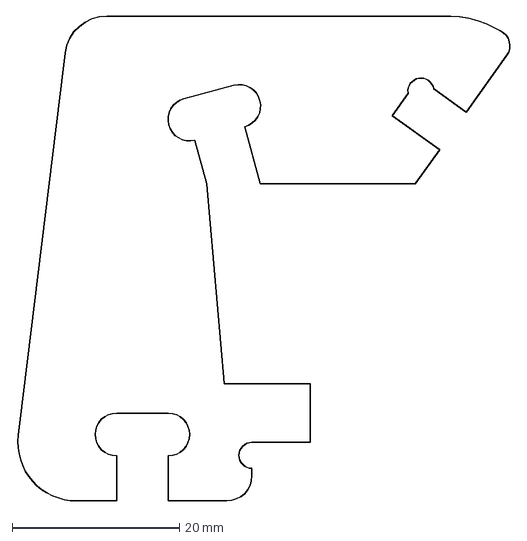
[picture p49: CAD file, 2026-11-11]
46sp/source/dxf/46sp_inside_bw_a.dxf
59.2 x 58.0 mm
