zzskm/keyboard/46sp/source/nesting/nesting_fw_b.dxf

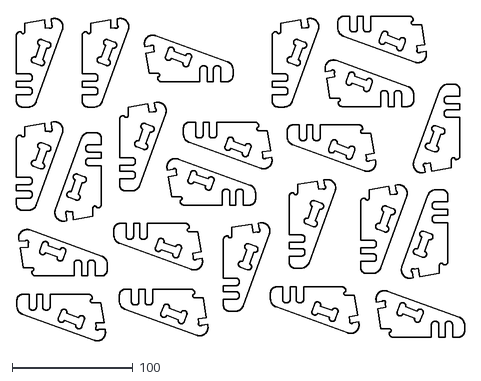
[picture p50: CAD file, 2026-11-11]
46sp/source/nesting/nesting_fw_b.dxf
370.7 x 268.5
