zzskm/keyboard/46es/model/print_v5/order1/46es_v5_mount_H03_SO6.step

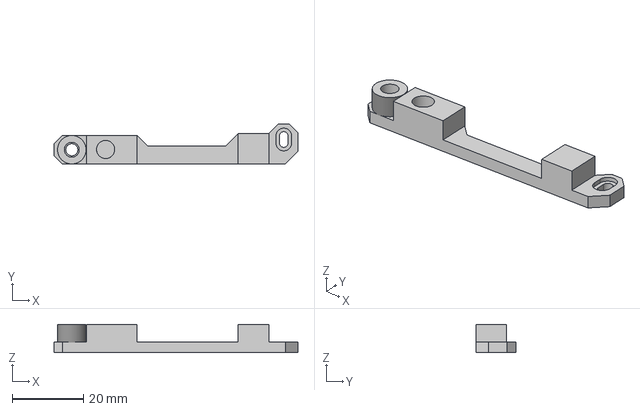
[picture p51: CAD file, 2026-11-12]
46es/model/print_v5/order1/46es_v5_mount_H03_SO6.step
68.6 x 11.2 x 8.00 mm
