zzskm/keyboard/46es/model/print_v5/order2/46es_v5_cover_T.step

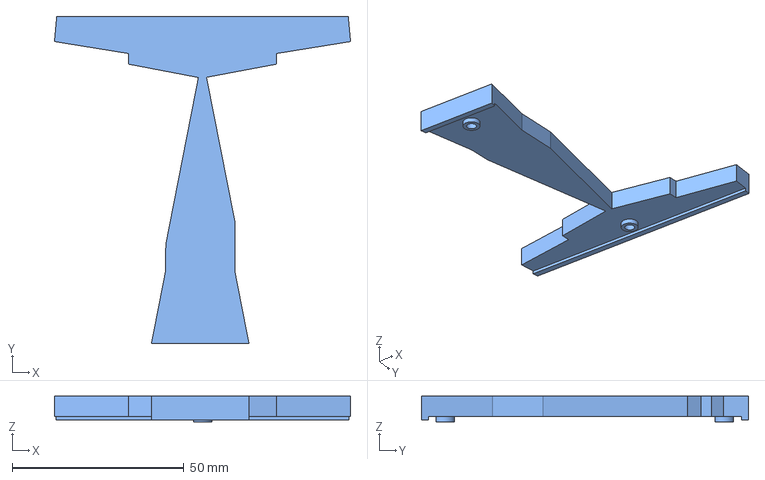
[picture p52: CAD file, 2026-11-11]
46es/model/print_v5/order2/46es_v5_cover_T.step
86.3 x 95.3 x 7.50 mm
