zzskm/keyboard/46sp/model/print/46sp_plate_cover.step

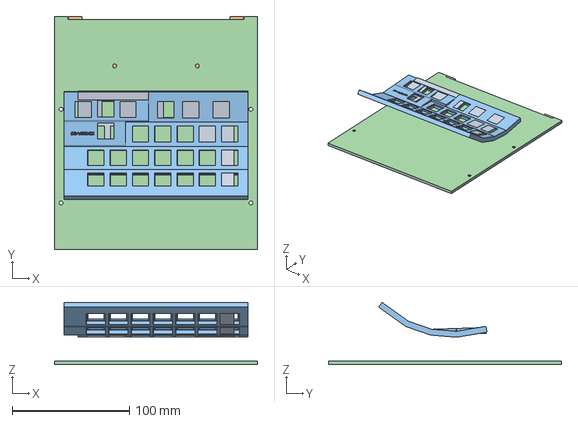
[picture p54: CAD file, 2026-11-13]
46sp/model/print/46sp_plate_cover.step
173.4 x 199.0 x 53.2 mm
