zzskm/keyboard/46sp/source/dxf/46sp_keypad_r.dxf

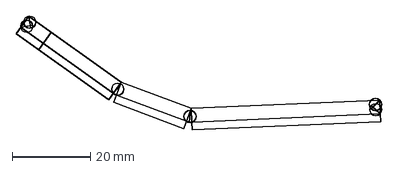
[picture p55: CAD file, 2026-11-11]
46sp/source/dxf/46sp_keypad_r.dxf
93.3 x 29.1 mm
