zzskm/keyboard/46sp/source/nesting/nesting_bw_b.dxf

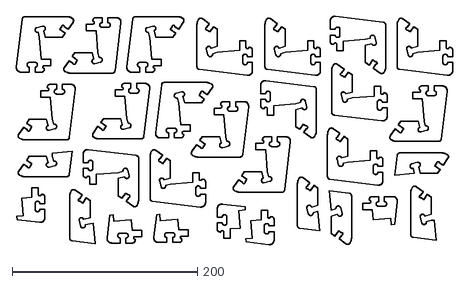
[picture p56: CAD file, 2026-11-11]
46sp/source/nesting/nesting_bw_b.dxf
471.6 x 246.8
