zzskm/keyboard/46es/model/print_v5/order1/46es_v5_mount_L.step

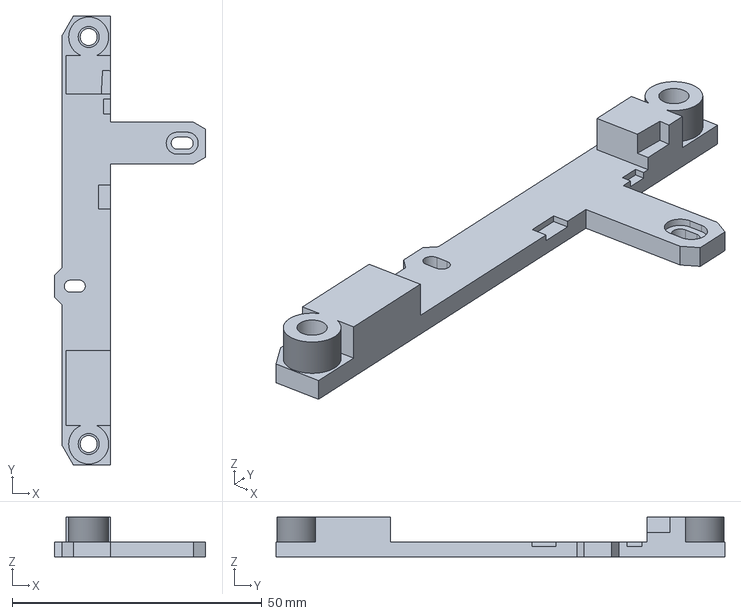
[picture p57: CAD file, 2026-11-12]
46es/model/print_v5/order1/46es_v5_mount_L.step
30.3 x 89.8 x 8.00 mm
