zzskm/keyboard/46es/model/review_v5/46es_v5_plate_L_REVIEW_ONLY.step

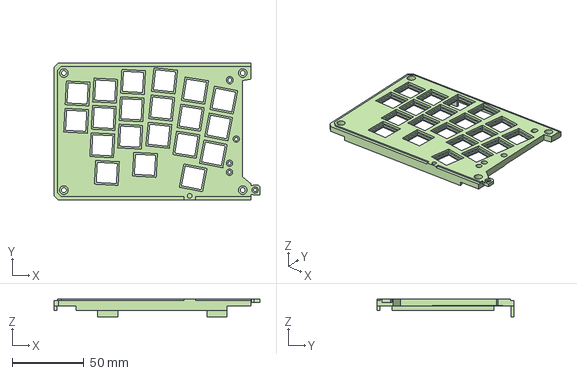
[picture p59: CAD file, 2026-11-09]
46es/model/review_v5/46es_v5_plate_L_REVIEW_ONLY.step
143.3 x 95.3 x 12.5 mm
