zzskm/keyboard/46sp/model/print/46sp_Cover_R.stl

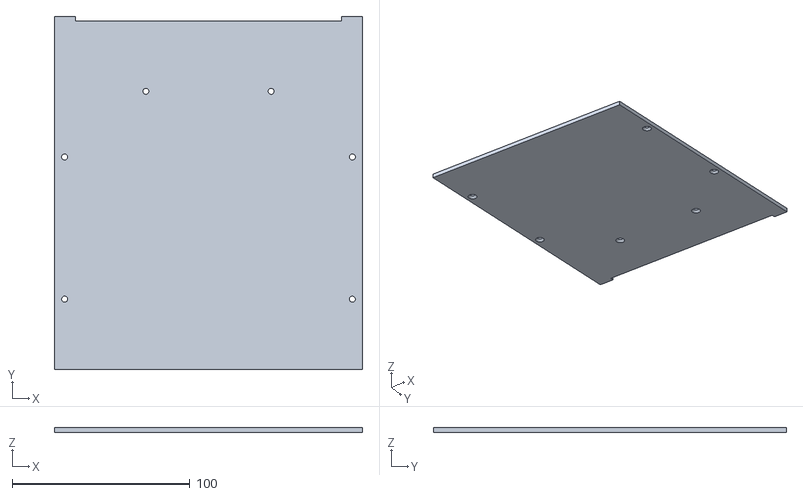
[picture p60: CAD file, 2026-11-13]
46sp/model/print/46sp_Cover_R.stl
173.4 x 199.0 x 3.00
