zzskm/keyboard/46sp/source/dxf/46sp_keypad_side.dxf

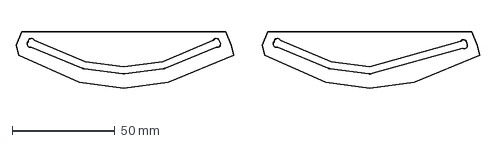
[picture p61: CAD file, 2026-11-11]
46sp/source/dxf/46sp_keypad_side.dxf
226.0 x 27.4 mm
