zzskm/keyboard/46sp/source/nesting/nesting_keypad_side.dxf

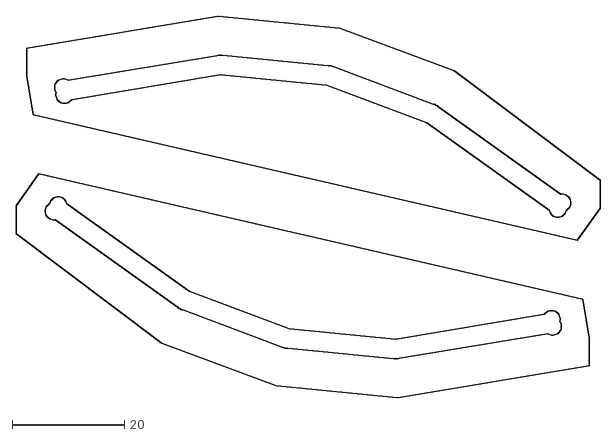
[picture p62: CAD file, 2026-11-11]
46sp/source/nesting/nesting_keypad_side.dxf
104.1 x 68.0
