zzskm/keyboard/46es/model/print_v5/order1/46es_v5_seam_coupon_S2_L.step

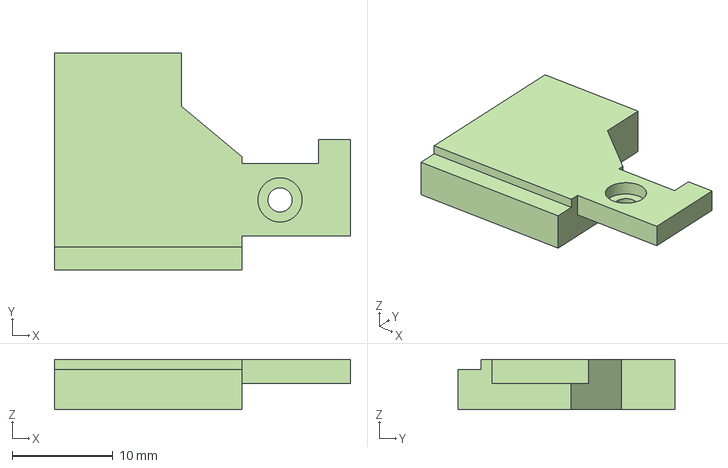
[picture p63: CAD file, 2026-11-11]
46es/model/print_v5/order1/46es_v5_seam_coupon_S2_L.step
29.4 x 21.6 x 5.00 mm
