zzskm/keyboard/46sp/source/46sp_plate_r3.converted.dxf

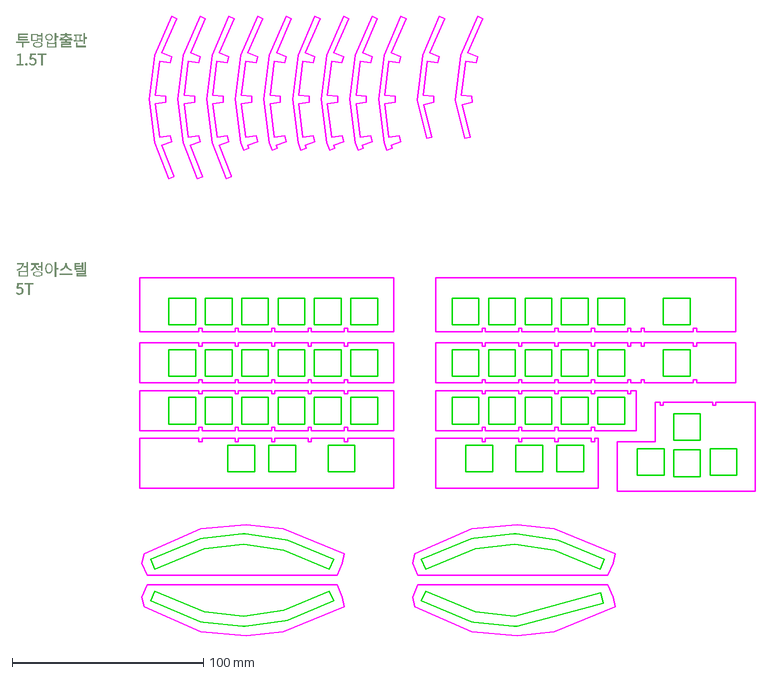
[picture p65: CAD file, 2026-11-11]
46sp/source/46sp_plate_r3.converted.dxf
검정아스텔 5T
투명압출판 1.5T
