zzskm/keyboard/46sp/source/dxf/46sp_inside_fw.dxf

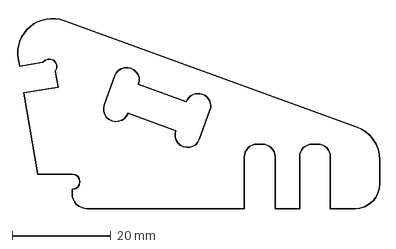
[picture p66: CAD file, 2026-11-11]
46sp/source/dxf/46sp_inside_fw.dxf
73.6 x 38.9 mm
