zzskm/keyboard/46es/model/print_v5/order2/46es_v5_ctrl_bracket.step

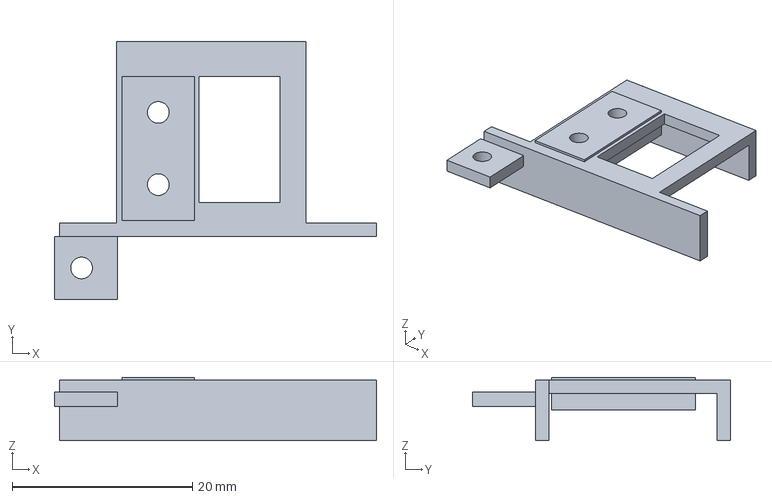
[picture p67: CAD file, 2026-11-07]
46es/model/print_v5/order2/46es_v5_ctrl_bracket.step
35.7 x 28.6 x 7.00 mm
