zzskm/keyboard/46sp/source/dxf/46sp_bone.dxf

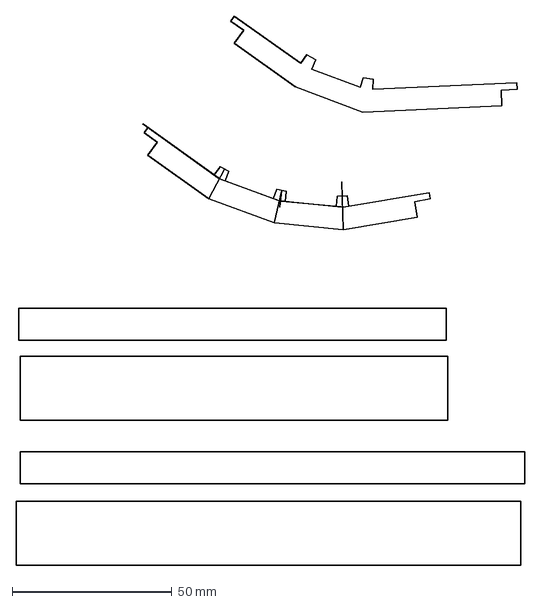
[picture p68: CAD file, 2026-11-11]
46sp/source/dxf/46sp_bone.dxf
159.1 x 171.9 mm
