zzskm/keyboard/46es/model/print_v5/order1/46es_v5_boss_tab.step

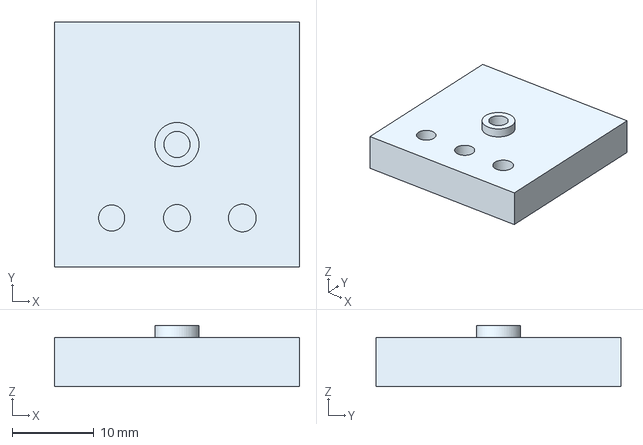
[picture p69: CAD file, 2026-11-11]
46es/model/print_v5/order1/46es_v5_boss_tab.step
30.0 x 30.0 x 7.50 mm
