zzskm/keyboard/46sp/source/dxf/46sp_keypad_side_artryl.dxf

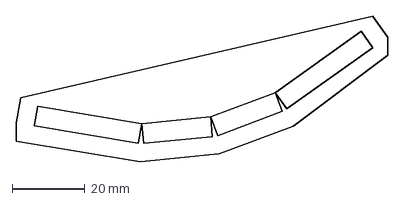
[picture p70: CAD file, 2026-11-11]
46sp/source/dxf/46sp_keypad_side_artryl.dxf
102.2 x 39.9 mm
