zzskm/keyboard/46es/model/print_v5/order1/46es_v5_seam_coupon_S0_L.step

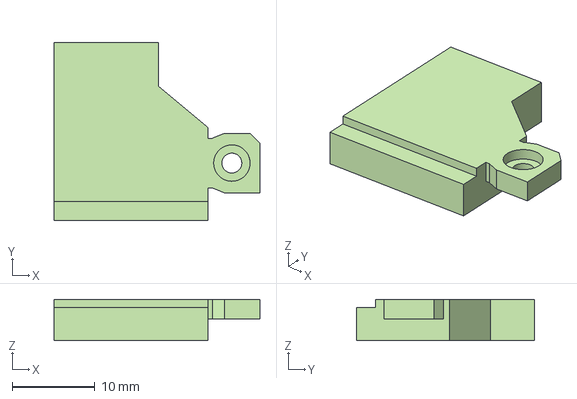
[picture p71: CAD file, 2026-11-10]
46es/model/print_v5/order1/46es_v5_seam_coupon_S0_L.step
24.9 x 21.6 x 5.00 mm
