zzskm/keyboard/46sp/source/dxf/46sp_keypad.dxf

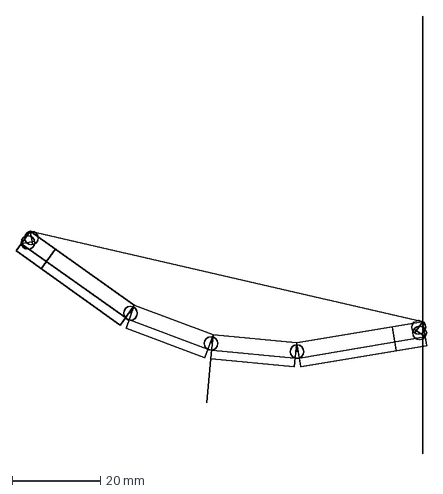
[picture p72: CAD file, 2026-11-11]
46sp/source/dxf/46sp_keypad.dxf
93.2 x 99.4 mm
