zzskm/keyboard/46es/model/print_v5/order1/46es_v5_seam_coupon_S1_R.step

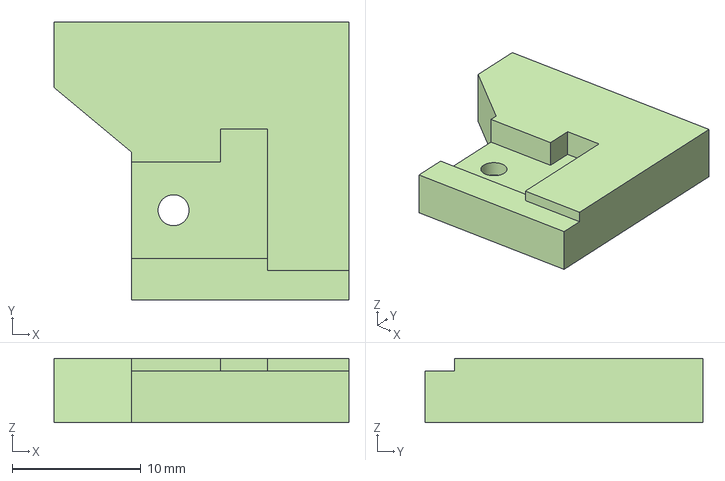
[picture p73: CAD file, 2026-11-10]
46es/model/print_v5/order1/46es_v5_seam_coupon_S1_R.step
22.9 x 21.6 x 5.00 mm
