zzskm/keyboard/46sp/source/dxf/46sp_inside.dxf

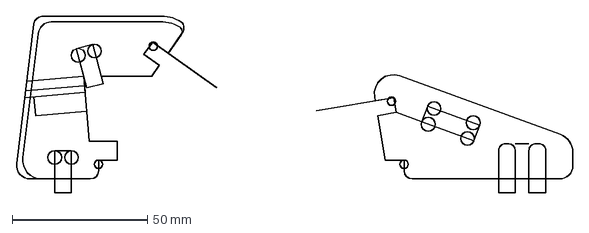
[picture p74: CAD file, 2026-11-11]
46sp/source/dxf/46sp_inside.dxf
205.5 x 65.0 mm
