zzskm/keyboard/46sp/source/dxf/46sp_keypad_side_artryl_r2.dxf

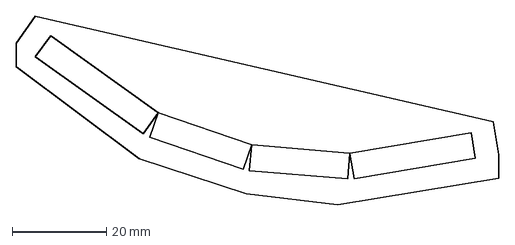
[picture p75: CAD file, 2026-11-11]
46sp/source/dxf/46sp_keypad_side_artryl_r2.dxf
102.2 x 39.9 mm
