zzskm/keyboard/46sp/source/dxf/46sp_side.dxf

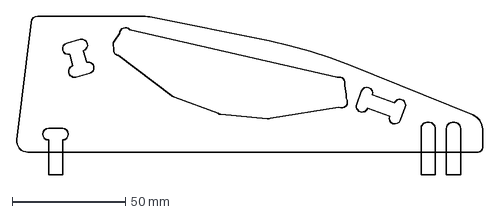
[picture p76: CAD file, 2026-11-11]
46sp/source/dxf/46sp_side.dxf
205.5 x 70.0 mm
