zzskm/keyboard/46es/model/print_v5/order1/46es_v5_rear_rest_lo.step

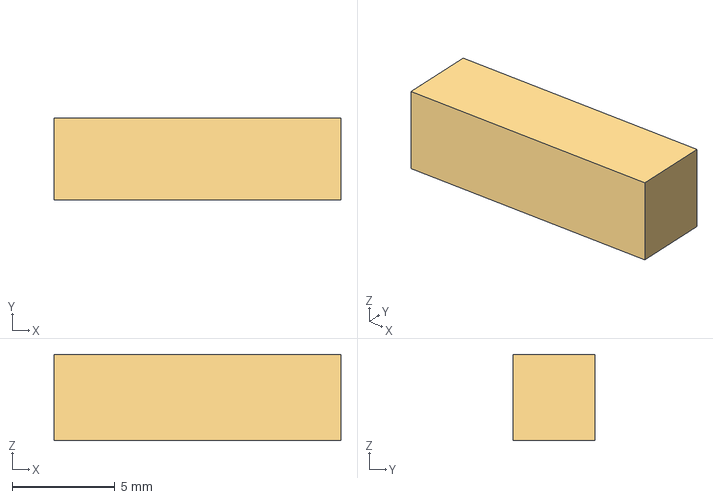
[picture p77: CAD file, 2026-11-10]
46es/model/print_v5/order1/46es_v5_rear_rest_lo.step
14.0 x 4.00 x 4.20 mm
