zzskm/keyboard/46es/model/print_v5/order1/46es_v5_rear_rest.step

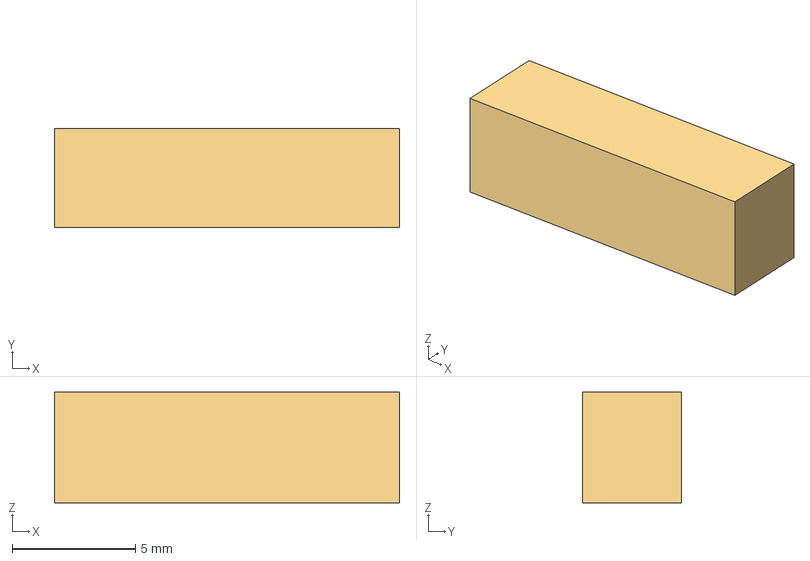
[picture p78: CAD file, 2026-11-10]
46es/model/print_v5/order1/46es_v5_rear_rest.step
14.0 x 4.00 x 4.50 mm
