zzskm/keyboard/46es/model/print_v5/order1/46es_v5_rear_rest_hi.step

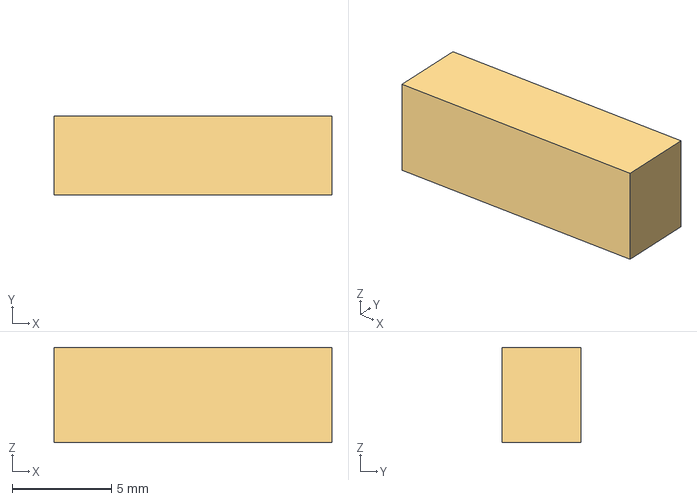
[picture p79: CAD file, 2026-11-10]
46es/model/print_v5/order1/46es_v5_rear_rest_hi.step
14.0 x 4.00 x 4.80 mm
