zzskm/keyboard/46es/model/print_v5/order1/46es_v5_ctrl_snap_C.step

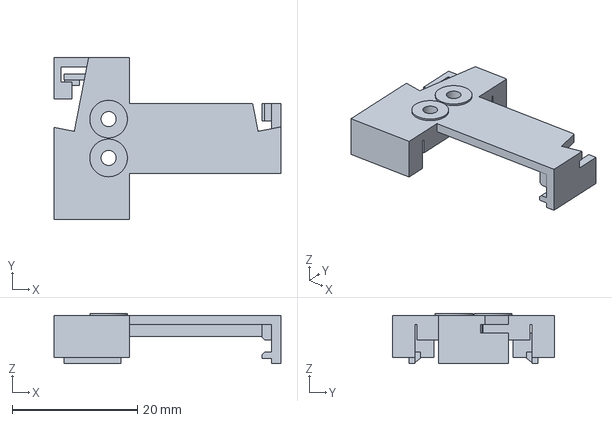
[picture p80: CAD file, 2026-11-09]
46es/model/print_v5/order1/46es_v5_ctrl_snap_C.step
36.2 x 25.8 x 8.00 mm
