zzskm/keyboard/46es/model/print_v5/order1/46es_v5_ctrl_bracket.step

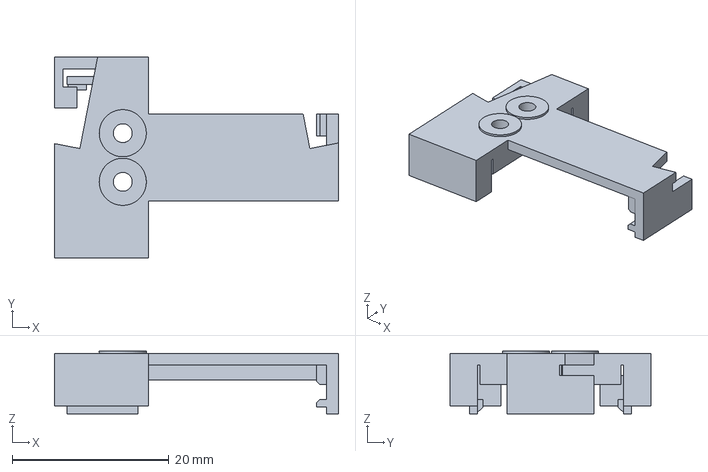
[picture p81: CAD file, 2026-11-09]
46es/model/print_v5/order1/46es_v5_ctrl_bracket.step
36.2 x 25.6 x 8.00 mm
