zzskm/keyboard/46es/model/print_v5/order1/46es_v5_seam_coupon_L.step

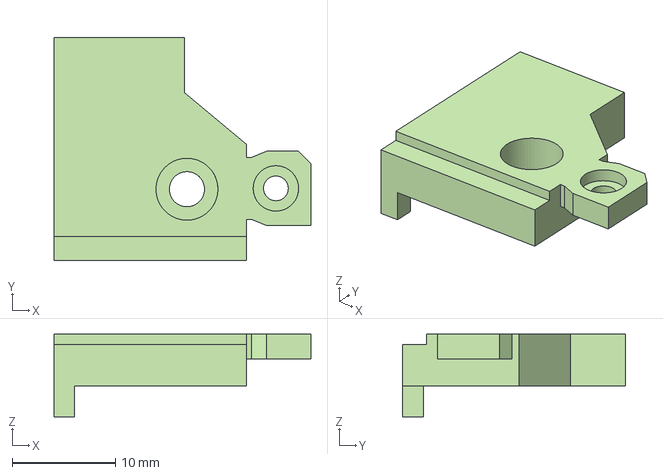
[picture p82: CAD file, 2026-11-09]
46es/model/print_v5/order1/46es_v5_seam_coupon_L.step
24.9 x 21.6 x 8.00 mm
