zzskm/keyboard/46es/model/print_v5/order1/46es_v5_seam_coupon_R.step

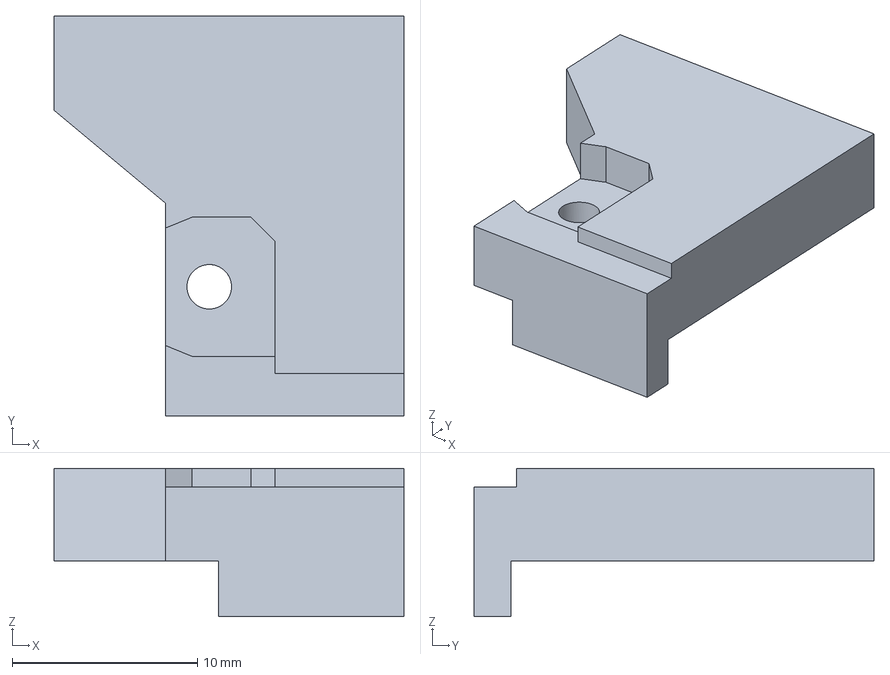
[picture p83: CAD file, 2026-11-09]
46es/model/print_v5/order1/46es_v5_seam_coupon_R.step
18.9 x 21.6 x 8.00 mm
