zzskm/keyboard/(list of files, cad)

Other CAD files:
36_keyboard.dwg
46sp/source/46sp_r3_v13.step
46sp/source/46sp_keyboard.dwg
46sp/source/46sp_plate_r3.dwg
46es/model/print_v5/order2/46es_v5_plate_R.step
46es/model/print_v5/order1/46es_v5_seam_coupon_S1_L.step
46sp/source/46sp_plate.dwg
46es/model/print_v5/order1/46es_v5_seam_coupon_S2_R.step
46es/model/print_v5/order1/46es_v5_seam_coupon_S0_R.step
46es/model/print_v5/order1/46es_v5_ctrl_snap_A.step
46es/model/print_v5/order1/46es_v5_boss_tab.stl
46es/model/print_v5/order1/46es_v5_ctrl_bracket.stl
46es/model/print_v5/order1/46es_v5_ctrl_snap_A.stl
46es/model/print_v5/order1/46es_v5_ctrl_snap_C.stl
46es/model/print_v5/order1/46es_v5_mount_H02_SO3.stl
46es/model/print_v5/order1/46es_v5_mount_H03_SO6.stl
46es/model/print_v5/order1/46es_v5_mount_L.stl
46es/model/print_v5/order1/46es_v5_mount_R.stl
46es/model/print_v5/order1/46es_v5_rear_rest.stl
46es/model/print_v5/order1/46es_v5_rear_rest_hi.stl
46es/model/print_v5/order1/46es_v5_rear_rest_lo.stl
46es/model/print_v5/order1/46es_v5_seam_coupon_L.stl
46es/model/print_v5/order1/46es_v5_seam_coupon_R.stl
46es/model/print_v5/order1/46es_v5_seam_coupon_S0_L.stl
46es/model/print_v5/order1/46es_v5_seam_coupon_S0_R.stl
46es/model/print_v5/order1/46es_v5_seam_coupon_S1_L.stl
46es/model/print_v5/order1/46es_v5_seam_coupon_S1_R.stl
46es/model/print_v5/order1/46es_v5_seam_coupon_S2_L.stl
46es/model/print_v5/order1/46es_v5_seam_coupon_S2_R.stl
46es/model/print_v5/order1/46es_v5_sw_hole_coupon.stl
46es/model/print_v5/order2/46es_v5_cover_L.stl
46es/model/print_v5/order2/46es_v5_cover_R.stl
46es/model/print_v5/order2/46es_v5_cover_T.stl
46es/model/print_v5/order2/46es_v5_plate_L.stl
46es/model/print_v5/order2/46es_v5_plate_R.stl
46es/model/print_v5/order2/46es_v5_spine.stl
46es/model/review_v5/46es_v5_cover_L_REVIEW_ONLY.stl
46es/model/review_v5/46es_v5_cover_R_REVIEW_ONLY.stl
46es/model/review_v5/46es_v5_cover_T_REVIEW_ONLY.stl
46es/model/review_v5/46es_v5_plate_L_REVIEW_ONLY.stl
46es/model/review_v5/46es_v5_plate_R_REVIEW_ONLY.stl
46sp/source/46sp_plate_46key.dwg
46sp/source/46sp_r2_left.f3d
46sp/source/46sp_r3_left.f3d
46sp/source/kb46sp_r1.f3d
