zzskm/keyboard/46es/model/print_v5/README.md

# v5 현행 제작 세트

**주문 1 시험 → 통과 후 주문 2 본 출력.** STL/STEP 포함. CAD/실물 검증 완료·발주 완료 아님. ([design](../../docs/design.md), [validation](../../docs/validation.md))

주문 1의 부품별 CAD 원본과 STL/STEP 해시는 [시험 출력 기록](../../inspection/data/seam-v5-trial-print-set.json)에 있다.

## 주문 1 — 시험 (`order1/`)

| 파일 | 내용 | 재료 | 수량 | STL 방향(참고) | X×Y×Z mm |
|---|---|---|---:|---|---|
| `46es_v5_sw_hole_coupon` | B 쿠폰: 홀 13.7–14.3 A/B/C, M2·M3/CB/인서트 구멍/다리 자석 포켓. **두께·C 층 = v5 plate**(28.29 cm³) | MJF 검정 | 1 | 홀 면 아래 | 145.35×74.15×5 |
| `46es_v5_boss_tab` | 커버 보스 Ø5.4+자석 포켓/평면 포켓(Ø3.2/3.3/3.4), 로고 음각(획 0.5·0.8), 투명 표면 견본 | **8001 투명** | 1 | 보스 위 | 30×30×7.5 |
| `46es_v5_seam_coupon_S0_L/R` | 앞 이음 쿠폰 S0(대조군): 옛 dovetail tab, 이음면 쪽이 열린 너트 포켓 4.4 × 1.0 | MJF 검정 | 각 1 | plate 윗면 아래 | 24.9×21.57×5 / 22.87×21.57×5 |
| `46es_v5_seam_coupon_S1_L/R` | 앞 이음 쿠폰 S1(현행 plate와 같음): 곧은 반턱 + 걸림 턱 여유 0.15, 닫힌 너트 포켓 4.0 × 1.3 | MJF 검정 | 각 1 | plate 윗면 아래 | 29.4×21.57×5 / 22.87×21.57×5 |
| `46es_v5_seam_coupon_S2_L/R` | 앞 이음 쿠폰 S2: S1에서 여유 0.25, 너트 포켓 4.2 | MJF 검정 | 각 1 | plate 윗면 아래 | 29.4×21.57×5 / 22.87×21.57×5 |
| `46es_v5_mount_L/R` | 좌/우 마운트(도면 직접 돌출: H 장공 + SO 인서트 보스, plate 받침 각 2곳, 핀 회피부 좌 10·11 / 우 18·33·46) | MJF 검정 | 각 1 | 밑면 아래 | 30.29×89.83×8 / 41×93.52×8 |
| `46es_v5_mount_H02_SO3` | 가운데 뒤 mount, 받침 1곳. spine 줄기가 프레임 윗면 Z 3에 직접 얹힌다(spine 받침 없음) | MJF 검정 | 1 | 밑면 아래 | 12.99×49.76×8 |
| `46es_v5_mount_H03_SO6` | 가운데 앞 mount, 받침 2곳(앞 이음 너트 자리 Ø5.1 포함, 나사 X 140.4) | MJF 검정 | 1 | 밑면 아래 | 68.62×11.23×8 |
| `46es_v5_ctrl_bracket` | Pro Micro 스냅 브래킷 B(현행, 걸림 0.4 / 끝 0.98) | MJF 검정 | 1 | 지붕이 아래 | 36.18×25.6×8 |
| `46es_v5_ctrl_snap_A` | 시험편 A: 같은 형상, 걸림 0.25 / 끝 0.7 | MJF 검정 | 1 | 지붕이 아래 | 36.18×25.6×8 |
| `46es_v5_ctrl_snap_C` | 시험편 C: 같은 형상, 걸림 0.55 / 끝 1.2, 해제 여유 1.1 | MJF 검정 | 1 | 지붕이 아래 | 36.18×25.8×8 |
| `46es_v5_rear_rest` | 뒤 받침 블록(공칭 높이 4.5). 케이스 뒤 벽 보스 ①②③ 위에 붙여 plate 뒤 플랜지를 받친다 | MJF 검정 | 3 | 밑면 아래 | 14×4×4.5 |
| `46es_v5_rear_rest_lo/hi` | 같은 블록의 높이 변형 4.2 / 4.8 | MJF 검정 | 각 3 | 밑면 아래 | 14×4×4.2 / 14×4×4.8 |

mount 4개, 맞는 스냅 브래킷 하나, 맞는 높이의 받침 블록 3개는 통과 시 본 조립에 쓴다. 시험물은 대상 부품과 동일 재료/색.

## 주문 2 — 본 세트 (`order2/`)

| 파일 | 무엇 | 재료 | 수량 | STL 방향 (참고) | 크기 X×Y×Z mm | 부피 cm³ | 최소 벽 |
|---|---|---|---:|---|---|---:|---:|
| `46es_v5_plate_L` | plate 왼쪽 반 (앞 이음 tab, upper 1.7, 다리 자석 포켓 Ø3.3 + 앞 단차 받침) | MJF 검정 | 1 | 윗면이 아래 | 147.79×95.33×8 | 38.4 | 1.00 |
| `46es_v5_plate_R` | plate 오른쪽 반 (앞 이음 포켓, upper 1.7, 다리 자석 포켓 + 받침) | MJF 검정 | 1 | 윗면이 아래 | 154.26×95.33×8 | 40.5 | 1.05 |
| `46es_v5_spine` | 이음부 아래 받침(배선 홈 3곳). 줄기 밑면 Z 3.05로 Rear mount 프레임에 얹힘, H02 나사머리 위 회피 | MJF 검정 | 1 | 윗면이 아래 | 30×49×5.45 | 1.77 | ≥1.50 |
| `46es_v5_ctrl_bracket` | Pro Micro 스냅 브래킷(주문 1 B와 같은 형상. 주문 1 결과로 걸림을 바꾸면 다시 만든다) | MJF 검정 | 1 | 지붕이 아래 | 36.18×25.6×8 | 1.57 | 1.00 |
| `46es_v5_cover_L` | 커버 왼쪽 (ㄷ형). 평평한 윗면 Z 19(왼쪽 블록 위쪽 로고 `kb46es/26` 음각 1.0), 키캡 여유 1.0 실루엣 창, 아래 다리 자석 포켓 Ø3.2 | **8001 투명** | 1 | 윗면이 아래(보스가 위) | 101.75×95.33×7.5 | 15.6 | 1.10 |
| `46es_v5_cover_T` | 커버 가운데 (T형). 평평한 윗면 | **8001 투명** | 1 | 윗면이 아래 | 86.35×95.33×7.5 | 14.2 | 1.10 |
| `46es_v5_cover_R` | 커버 오른쪽 (ㄷ형). 평평한 윗면, 아래 다리 자석 포켓 | **8001 투명** | 1 | 윗면이 아래 | 128.67×95.33×7.5 | 15.8 | 1.10 |

주문 1에서 mount를 수정했다면 수정된 mount도 본 출력에 포함한다.

## 재료·주문 메모

| 부품 | 선택 |
|---|---|
| plate·mount·spine·브래킷·스냅 시험편·뒤 받침 블록·B 쿠폰·이음 쿠폰 | MJF PA12S-HP 검정 |
| 커버 3조각·보스 탭 | 8001 레진 투명(Transparent) |

위 재료는 기존 설계에서 채택한 조건이다. 기록된 기준은 MJF 벽 1.0 mm, 레진 벽 0.8 mm이며, 실제 업체 수락 조건은 견적 때 확인한다. [8001 자료](https://jlc3dp.com/help/article/photosensitive-8001-resin). JLC3DP 설계 가이드(2026-11-10 열람)의 최소 부품 크기는 MJF·SLA 5×5×5 또는 10×2×2이고, 30×30×10은 FDM에만 적용된다. 같은 가이드의 음각·양각 최소는 MJF·SLA 모두 깊이·폭 0.8이다([설계 가이드](https://jlc3dp.com/help/article/3D-Printing-Design-Guideline)).

업체에는 STL을 올린다. STL은 베드 면 Z=0의 출력 참고 방향이며 STEP은 조립 좌표다. MJF·레진의 배치는 업체가 정한다. 투명 커버의 평평한 윗면은 외관면이다. 주문 메모: "Top face (flat side without bosses) is cosmetic. Please put supports on the boss side only." L 윗면에는 로고 `kb46es/26` 음각(깊이 1.0, 높이 2.0, 획 0.5, 글자 사이 살 0.25)이 있다. 메모에 "The small engraved logo on the left piece is intentional decoration (1.0 mm deep, not through). Its 0.25 mm ribs are below the wall guideline on purpose."를 덧붙인다.

커버 최소 벽은 로고를 빼고 L·T·R 모두 약 1.098이며 다리 자석 포켓 위 살은 3.9, 포켓과 창 사이 벽은 1.14다. L 로고의 글자 사이·안쪽 살 0.25는 벽 검사에서 로고 영역(`excluded`)으로 따로 기록한다. 좁은 베젤의 강도·휨은 본 출력 후 확인한다. 스캔의 짧은 모서리 광선 값과 실제 벽 두께를 구분한다. 검토 결과는 [본 출력 벽 검사](../../inspection/data/seam-v5-mjf-thin-wall.json), [시험 출력 벽 검사](../../inspection/data/seam-v5-trial-thin-wall.json)를 따른다.

## 하드웨어

| 위치 | 규격 | 수량 | 비고 |
|---|---|---:|---|
| SO1–6 인서트 | **보유품.** 원형 황동 M3 열압입 인서트, 외경 Ø5 × 높이 4 | 6 | mount 보스 구멍 Ø4.2 × 깊이 5에 인두로 넣고 윗면을 보스 윗면에 맞춘다. 2026-11-12 전의 황동 육각 지지대(길이 6, 맞변 5)와 아래 M3×5는 쓰지 않는다 |
| SO 나사 | **보유품.** 흑철색 둥근머리 육각 M3×10 | 6 (+예비) | plate 카운터보어 → 인서트 → mount 관통홀, 끝이 mount 밑 0.5. 커버 자석이 이 머리에 붙어야 한다(흑색 산화 합금강, 스테인리스·"black stainless" 불가). 머리 Ø5.7 × 1.65급(ISO 7380)이어야 카운터보어에 앉는다 |
| 보스 자석 | 네오디뮴 원형 **Ø3×2**, N52 (없으면 N35), 니켈 도금 일반품 | 6 | 쿠폰 시험·예비 포함 20개 묶음 권장. 극성 무관. 투명 커버 보스 안에서 보인다.  |
| bracket·spine | M2×6 ISO 7380 버튼헤드(머리 Ø3.5–3.8 × 1.3), 흑색 합금강 | 6 | bracket 2 + spine 4. 위 M3와 같은 판매처의 M2/M3 버튼헤드 묶음으로 산다 |
| 앞 이음 | M2×5 ISO 7380 버튼헤드 | 1 | 머리 자리 깊이 1.4, 머리 윗면이 커버 밑 0.1. **머리 높이 1.3 초과(DIN 7984 저두 1.35, 냄비머리 1.6) 불가** |
| M2 너트 | DIN 934 M2, 맞변 4, 높이 1.6 | 7 | bracket 2 + spine 4 + 앞 이음 1 |
| 케이스 나사 | PSD60 기존 나사 | 6 | r2에서 쓰던 것 |
| 접착제 | 투명 2액형 에폭시(예: 다이소 투명 에폭시 접착제 주사기 6 ml) | — | 자석 고정(투명 커버에 순간접착제를 쓰면 하얗게 흐려진다). 이음 접착(선택)에도 쓴다. 아래 "A냐 A+접착이냐" |
| 다리 자석 | 네오디뮴 Ø3×2 | 4 | 커버/plate 두 쌍. 접착 전 극성 확인 |
| 뒤 받침 블록 패드 | 양면 점착 박판·탄성 패드(양면테이프, 얇은 실리콘·포론 시트 등) | 3 (+시험분) | 뒤 받침 블록 밑면 ↔ 케이스 뒤 벽 보스 윗면, 공칭 틈 0.5. 시험 조립에서 블록 높이와 함께 두께를 정하고 블록을 보스 윗면에 붙인다 |

자석 총수는 10개다(보스 6 + 다리 4). 시험·예비분은 별도다. SO 체결은 2026-11-12부터 보유 인서트와 보유 M3×10을 쓴다(지지대 없음). M3×10 머리에 자석이 붙는지와 머리가 카운터보어에 앉는지를 보스 탭·B 쿠폰으로 확인한다. 자석은 투명 2액형 에폭시로 붙이며 투명 커버에 순간접착제 백화가 생기지 않게 한다.

## 시험과 조립

1. [B 쿠폰·보스 탭](#b-쿠폰보스-탭) 시험: 스위치 끼움, 카운터보어, 자석 포켓·흡착력, 인서트 구멍 열압입, 음각과 출력 치수 편차를 기록한다.
2. 이음 쿠폰 3쌍(S0·S1·S2)을 비교한다. 먼저 나사 없이 L을 위에서 내려 5회 모두 끝까지 앉는지 본다. R 아랫면 포켓에 너트를 눌러 끼우고(S0는 열린 포켓이라 받친다) 나사를 뺀 채 뒤집어 흔들어 본다. M2×5로 조여 단차·흔들림·삐걱임을 기록하고 10회 탈착 뒤 다시 잰다. 쿠폰은 다듬어도 되지만 그 결과는 plate에 옮길 수 없으므로 다듬기 전 상태를 기록한다. 합격 기준은 [validation.md](../../docs/validation.md)의 표다.
3. mount 4개의 보스에 인서트를 열압입하고(구멍은 B 쿠폰 결과와 대조) PSD60에 장착한다. 장공 내 체결, 인서트의 수직·돌림, M3×10 체결과 나사 끝 여유를 확인한다.
4. 스냅 브래킷 A·B·C에 실제 Pro Micro를 끼우고 뺀다. 맨보드 → 16선 납땜 뒤 순서로 하고, USB 쪽 당김, 립이 부품·납땜에 닿는지, 10회 탈착 뒤 암 상태를 본다. 맞는 걸림을 `tools/ctrl_v5.py`에 반영한다([실물 확인 목록](../../docs/validation.md)).
5. 결과를 현행 v5 생성 규칙과 샘플에 반영하고 재출력·검증 후 주문 2를 진행한다.
6. 본 plate L/R·spine·브래킷을 가조립하고 스위치를 꽂아 중앙 아래쪽 키를 누른다. mount 위에 얹었을 때 보스 위에 올린 받침 블록과 plate 뒤 플랜지 사이 틈을 재어 블록 높이(4.2 / 4.5 / 4.8)와 패드를 고르고 블록을 보스에 붙인다(보스 위치·높이는 사진 추정, [실물 확인 목록](../../docs/validation.md)). 이음 보강이 필요하면 배선 전에 결정한다. 배선이 이음을 건너면 반쪽을 벌리기 어렵다.

앞 이음의 현재 구조는 [설계 기준](../../docs/design.md)에 있다. 조립 단계는 [가이드](https://zzskm.github.io/keyboard-46es/)를 따른다.

## B 쿠폰·보스 탭

두 시험물은 `tools/coupon_v5.py`가 현행 매개변수로 `model/ctrl_trials_v5.sc`에 만든다(바디 `SW_HOLE_SAMPLE`, `BOSS_TAB_SAMPLE`). 각 범위는 설계값이 가운데 오도록 매개변수 식(`SMP_*`)으로 정해 plate·커버 치수를 바꾸면 따라 바뀐다. 2026-11-10 전에는 손으로 만든 `model/samples/46es_sw_hole_sample.sc`였다. 이 파일은 두께 10(JLC3DP FDM 최소 크기 30×30×10에서 온 값)·보스 Ø5.8·육각 4.8–5.4로 현행 설계와 달랐다. 이력은 `git log -- 46es/model/samples`로 찾는다.

**B 쿠폰**(MJF 검정)은 plate 두께 5다. 열 7개를 X 간격 19.05로 두고 홀이 13.7에서 14.3까지 0.1씩 커진다(열 3이 `TBD_sw_hole` 14.0). 열 0 쪽 원점 코너의 3 mm 모따기가 방향 표시다.

| 행 | 구조 | 확인할 것 |
|---|---|---|
| A | 위 홀 층 1.5 + 바로 아래 걸쇠 노치(8 × 1 × 1.5), 그 아래 홀 | r2식 국부 노치 방식 |
| B | 위 홀 층 1.5 + 아래 16.5 개방 | 노치 없는 비교 |
| C | 위 16.5 개구 1.7 + 홀 층 1.5 + 아래 16.5 개방 1.8 | **v5 plate와 같은 층 구성** |
| D | M2 Ø2.0–2.6, M3 관통 Ø3.0–3.6, 카운터보어 Ø5.8/6.0/6.2 × 3.5(아래 M3 Ø3.4, 살 1.5), SO 인서트 구멍 Ø4.0/4.2/4.4/4.6 × 4(아랫면, 위로 M3 Ø3.4, 위 살 1.0), plate 다리 자석 포켓 Ø3.2/3.3/3.4 × 2.1(윗면) | 나사 자리·보스·인서트·MJF 자석 끼움 |

**보스 탭**(8001 투명)은 커버 두께 6의 30 × 30 판이다. 보스 위 면에 커버 보스 Ø5.4 × 1.5(끝 자석 포켓 Ø3.2 × 2.1, 둘레 벽 1.1)와 평면 자석 포켓 Ø3.2/3.3/3.4 × 2.1이 있다. 반대쪽 외관면(커버 윗면처럼 아래로 출력되는 면)에는 커버 L과 같은 로고 `kb46es/26` 음각(깊이 1.0)을 두 크기로 넣었다. 하나는 커버와 같은 높이 2.0(획 0.5, 살 0.25), 다른 하나는 1.6배(높이 3.2, 획 0.8, 살 0.4)다. 그 면에서 바로 읽히도록 모델에서는 좌우를 뒤집었다.

`tools/build_seam_v5.py`가 두 바디의 부피·경계를 매개변수로 계산한 값과 대조하고 살 두께(MJF 1.0, 레진 0.8)를 검사한다. `check_repository.py`는 행 C의 층 식(`SMP_T = TBD_plate_T`, `SMP_upper = TBD_upper_plate_T`)을 확인한다.

시험:

1. 각 홀에 Gateron KS-3 Milky Yellow Pro를 끼운다. 삽입력·걸쇠·키캡을 뺄 때의 이탈·흔들림·플랜지 착좌를 행 A/B/C별로 기록한다.
2. 행 D: M2 통과·자가탭, M3 통과, 보스 탭 보스와 카운터보어의 여유(편측 0.2/0.3/0.4), 보유 M3 인서트의 열압입(수직·돌림, M3×10 10회 체결)과 구멍 지름 선택(채택값은 `tools/mounts_v5.py` `INSERT_HOLE_D`로 옮기고 mount를 다시 만든다), Ø3×2 자석과 MJF 다리 자석 포켓의 끼움을 기록한다.
3. 보스 탭: 자석 포켓 끼움·에폭시·흡착력, 보스 벽 1.1이 깨지지 않는지, 투명 표면을 확인한다. 음각 두 크기가 메워지지 않고 살이 남아 읽히는지 본다. JLC3DP 가이드의 SLA 음각 최소는 깊이·폭 0.8이고 커버 L의 획 0.5·살 0.25는 그보다 좁다([validation](../../docs/validation.md)).
4. 홀 내경을 실측해 `measurements.csv` M18에 적는다. 채택한 값은 생성기 입력으로 옮기고 주문 2 전에 CAD를 다시 만든다. plate는 깎아 맞추지 않는다([AGENTS.md](../../AGENTS.md) §5).

참고 치수의 출처: [스위치 테스터 분석](../../inspection/switch_tester/README.md)(fidget 14.0 / 남김 1.4 / 노치 16 × 8 × 1.5), r2 DWG 14.0(레이저 커프라 MJF와 다름).

## 제작 할인 쿠폰

2026-11-05 사용자 확인: 키보드 제작 할인 쿠폰 발급 완료. 시험용 CAD 쿠폰과 별개다. 당시에는 쿠폰 사용을 위해 FDM을 선택했다. 현재 MJF·레진 조건에도 적용되는지는 미확인이다. 할인 금액·최소 주문액·유효기간과 함께 견적 전에 확인한다.

## 재내보내기

저장소 루트에서 `python 46es/tools/export_print_v5.py`(두 주문, 부품 목록은 `tools/parts_v5.py`). [주문 1 기록](../../inspection/data/seam-v5-trial-print-set.json)과 [주문 2 기록](../../inspection/data/seam-v5-print-set.json)에 각 부품의 원본 CAD와 STL·STEP 해시가 있다. [전체 검사·재생성 순서](../../docs/validation.md)를 따른다.
