zzskm/keyboard/46es/docs/assembly-tolerance-2026-11-04.md

> **역사 문서(현행 v5 기준 아님).** 이 문서는 작성 당시의 계획/실험/검토 기록이다. 현재 설계·제작·검증 판단은 [README](../README.md), [설계](design.md), [검증과 다음 작업](validation.md), [v5 제작 세트](../model/print_v5/README.md)를 우선한다. 필요한 결정/근거만 현행 문서로 옮긴다.

# 46es 조립 여유 수정 — 2026-11-04

상태: SolidCraft 0.30.1 MCP로 CAD 수정·검증 완료 / 현물·출력 미검증.
대상: `model/46es_draft_sketches.sc`, 매개변수 `model/parameters.csv`.
사용 중인 r2를 설계 근거로 유지하며 전체 체결 지그 출력을 선행 조건으로 삼지 않는다.

## 수정한 형상

### 케이스 → Mount

기존 체결 구멍/장공/나사머리 자리 24개 피처를 억제하고, 뒤쪽 타임라인에
매개변수로 구속된 장공 스케치 2개와 cut 2개를 추가했다. 이전 형상을 중복 절삭하지 않는다.
처음부터 FRAME 스케치에 포함돼 있던 H05·H06 원형 구멍도 새 장공 안에 포함된다.

| 지지대 | 장공 방향 | 중심의 근거 |
|---|---|---|
| H01·H05 | X (좌우) | 기존 GH60 후보 좌표 유지 |
| H02·H03·H04·H06 | Y (앞뒤) | 기존 GH60 후보 좌표 유지 |

- `TBD_case_adjust = 1 mm`: 양쪽 원호 중심이 기준점 ±1 mm.
- 관통 장공: 폭2.4 × 전체 길이4.4 mm. M2 축을 가정하면 지정축 중심 이동 약±1.2,
  직교 방향 약±0.2 mm. 모든 방향 ±1 mm라는 뜻은 아니다.
- 나사머리 자리: 폭4.4 × 전체 길이6.4 × 깊이1 mm. 관통 장공과 같은 중심·방향·조정량을 따른다.
- 프레임 두께3 mm, 나사머리 자리 아래 살2 mm. H05 자리와 좌측 외곽 사이 최소 살은
  현재 기준 약0.90 mm이므로 출력 상태·체결 강도 확인이 필요하다.
- 기존 `TBD_case_slot_L`은 억제한 옛 피처용으로 남아 있고, 새 조정량은 `TBD_case_adjust`로 바꾼다.
- `TBD_case_head_clr = 0.4 mm`를 추가했다. 나사머리 실제 규격·유효 깊이는 미확정이다.

150 mm 캘리퍼로 입력한 H 측정 성분과의 비교(내벽 기준):

| 입력 성분 | 입력 mm | 기존 좌표 + 내벽 오프셋 mm | 차이 mm |
|---|---:|---:|---:|
| H01 X |26|25.8923|+0.1077|
| H02 Y |49|48.2670|+0.7330|
| H03 Y |11|10.0663|+0.9337|
| H04 Y |68|67.3662|+0.6338|
| H05 X |4|4.40234|−0.40234|
| H06 Y |39|38.7658|+0.2342|

측정 성분은 지정축 조정 범위 안에 있다. 나머지 6개 좌표 성분은 미측정이므로 전체 조립을
보증하지 않는다. 오프셋도 기존 Wilmore 참조값 X0.693/Y0.667이며 PSD60 확정 실측은 아니다.

### Mount → Plate / Cover → Plate

- M3 조립 구멍 직경 여유0.3 → **0.4 mm**: 구멍Ø3.4.
- 육각 포켓 맞변 여유0.3 → **0.4 mm**: AF4.7 참고 스탠드오프에 AF5.1 포켓, 면당0.2 여유.
- 커버 보스 편측 여유0.2 → **0.3 mm**: Ø6 카운터보어에 Ø5.4 보스.
- 커버 립 여유0.3 mm와 자석 포켓은 유지했다. 자석 고정은 기존 나사에 자석이 실제로
  붙는지 확인해야 하며, 스테인리스라는 재질명만으로 흡착 여부를 확정하지 않는다.
- 포켓 여유 변경을 참조하는 컨트롤러 Y 식도 약0.058 mm 이동했으며 간섭 검사에 포함했다.

### 스탠드오프 참고 바디

이전 모델은 육각 스탠드오프를 외접 원통으로 그려 실제 육각 포켓과 약16.34 mm³
겹쳤다. 실제 부품 간섭과 구분할 수 있도록 원통 6개 피처를 억제하고, AF4.7 육각
단면과 Ø3 축 구멍을 가진 **참고 바디 6개**로 바꿨다. 나사산은 단순화한 원통 구멍이다.
높이는 기존 가정값(포켓 포함6.5 mm)이며 현물 스탠드오프 규격을 확정한 것이 아니다.

## 검증

- 사용자 매개변수156개, 스케치15개 모두 dof0.
- 타임라인122개(활성92개), 오류0개.
- 경고1개: 변경하지 않은 `HOUSING_POSTS_CAND`의 기존 Boolean 미세 이동 경고.
- 장공/나사머리 자리 끝 원호24개의 실제 축 좌표와 반지름을 `body_topology`로 대조했다.
- 마운트 수정 단계 전체 부피: 계산418707.9328 / 측정418707.9282 mm³, 차이약0.0046 mm³.
- 육각 참고 바디 합계: 계산470.4148 / 측정470.4606 mm³ (차이0.00974%, 비교 허용0.02%).
- Frame·Plate·Cover3조각·컨트롤러 점유·육각 스탠드오프6개, 총12개 바디 간 간섭0건.
  미검사 쌍0, 예산 초과없음. Wilmore 하우징·USB outlet은 이 검사에서 제외했다.
- `TBD_case_adjust`를1.2 mm로 시험: 피처·매개변수 오류없음, 장공 끝점이±1.2로 이동,
  시험 후1.0 mm 상태로 복원했다. 이 시험은 치수 추종 검사이며 그 상태의 물리적 조립 보증은 아니다.
- 상면·아이소메트릭 렌더를 확인했다. 수치 근거는
  `inspection/data/assembly_tolerance_check.json`에 있다.

## 남은 확인

1. 배선 돌출 약8 mm와 현재 plate 하면→프레임 상면5 mm를 비교해야 한다.
   배선 경로가 없는 상태여서 이번 바디 간섭0건에 배선이 포함되지는 않는다.
   실제로 겹치는 위치를 확인하기 전 키 높이·스탠드오프 높이는 올리지 않았다.
2. r2 외곽 기준은 유지했지만, **코너 R의 최종값은 확정하지 않았다**.
   이번 수정에서는 기존 CAD의 외곽·코너 설정을 변경하지 않았다.
3. 나사머리/나사 길이/피치/유효 깊이, 스탠드오프 실제 AF·길이, 자석 흡착을 확인한다.
4. 기존 A 지그·B 스위치 쿠폰은 이번 조립 CAD와 별도 파일이며 수정하지 않았다.
   최종 STL/STEP도 새로 내보내지 않았다. 작은 체결부와 보스 끼움부터 출력 확인한다.
