zzskm/keyboard/46es/docs/split-v1-local-print-plan-2026-11-05.md

> **역사 문서(현행 v5 기준 아님).** 이 문서는 작성 당시의 계획/실험/검토 기록이다. 현재 설계·제작·검증 판단은 [README](../README.md), [설계](design.md), [검증과 다음 작업](validation.md), [v5 제작 세트](../model/print_v5/README.md)를 우선한다. 필요한 결정/근거만 현행 문서로 옮긴다.

# 46es split v1 국부 시험 출력안

기준일: 2026-11-05 KST. **계획만 작성. 쿠폰 전용 CAD/STL 생성·출력·발주·제작 승인 없음.**

전체 케이스 jig는 선행 조건이 아니다. 아래 국부 조립 시험과 현물 치수 확인을 독립적으로 진행한다. 전체 부품용 REVIEW_ONLY STL을 쿠폰이라고 취급하지 않는다. 쿠폰을 만들 때 변형 SC의 별도 복사본에서 관심 영역을 남기고,7부품 중 해당 부품만 각각 내보낸다.

| 시험 | 남길 국부 범위/구성(대략 mm) | 확인과 채택 기준 |
|---|---|---|
| 중앙 조립·shim | X112–151/Y36–92의 plate 양쪽, spine 전체, H02 받침 주변 mount, SO3 지지대 | seam이 억지 없이 닫히고 SO3가 왼쪽에 유지.4개 M2 접근, 하중 시 들뜸·과도한 굽힘 없음. 받침 간격을 실제 shim으로 맞춰 누르지 않았을 때 휘지 않음 |
| Mount lap | X78–112, 앞Y−0.367–12 및 뒤Y83–94.967, 좌 tongue·우 lap 한 쌍씩 | M2×5·너트 장착,1.7mm 받침·1.2mm tongue 잔여층 파손/갈라짐 없이 반복 탈착. 바닥 나사 돌출0.3mm가 실제 케이스와 닿지 않음 |
| USB U 연결 + H05 | X−0.393–32/Y31–94.967의 왼쪽 mount, 실제 USB 아웃렛과 케이블 | USB 노치 유지,4mm U 연결·2mm rail 중첩의 휨/층간 파손 확인. H05 전체 조정 끝에서도 살 파손 없이 나사 체결. 키/배선 아래 접촉 없음 |
| Controller/gate | X110–152/Y4–34, plate 국부·별도 bracket·gate·실제 보드/플러그 | PCB 위치 유지, 게이트를 풀어 −X 삽입/탈거 가능. M2×5 끝·너트 포켓·Ø3 드라이버 경로, bracket×6 끝과 PCB/납땜 사이 여유. plate 모듈을 먼저 꺼낸 후 아래쪽 공구 접근 |
| Switch/flange | 주변 flange가 포함된 실제 회전 키2–3개, 원1.5T 체결층·16.5 위/아래 개구 | 실제 Gateron5핀·다이오드·납땜·배선으로 삽입/고정/키캡 탈거 시험.1.5T 층을 누르거나 걸쇠를 가리지 않음. 실제 키캡 전 스트로크에서 cover와 접촉 없음 |
| SO/cover | SO1 또는 SO6 주변 plate·mount·cover 보스, 지지대6mm/위×4/아래×5/자석 | 나사가 서로 바닥나지 않고 체결됨. 자석 흡착·접착·커버 탈거력, 보스 끼움, 머리Ø5.7와Ø6 자리 조립 확인 |

## 끼움 비교 쿠폰

- 같은 업체·재료·방향에서 스위치 홀13.9/14.0/14.1/14.2, 국부 체결층1.5T를 비교한다. 기존16.5 릴리프와 실제 회전각을 유지한다.
- M2 통과Ø2.4/2.5, 머리 자리Ø4.4/4.6, 너트 포켓AF4.4/4.5/4.6을 비교한다. 큰 포켓으로 바꿀 때는 주변 최소 살1.2mm 이상을 다시 확인한다.
- M3 지지대 AF5.4/5.5/5.6과 커버 보스/Ø6 자리의 실제 끼움을 비교한다. 후보 변경을 전체 모델에 자동으로 확대 적용하지 않는다.
- 조립 직후와 반복 탈착 후 구멍 크기, 들뜸, 층간 균열, creep, 자석 이탈을 기록한다. 부품을 눌러서 강제로 맞춘 결과는 합격으로 기록하지 않는다.
- 작은 배선/다이오드/납땜은 실제 크기와 경로를 기록해 새 점유 모델에 반영한다.8mm 돌출 수치 하나만으로 키 높이를 올리지 않는다.

## JLC3DP 검토와 출력 방향

FDM·JLC3DP 우선, 재료는 미정이다. ABS/ASA/PLA-P 등은 현재 가능한 공정 후보를 비교하기 위한 이름이며 채택하지 않았다.

업체의 [설계 가이드](https://jlc3dp.com/help/article/3d-printing-design-guideline)는 FDM 공칭 모델 공차±0.3mm(100mm 이내)/±0.4%(그 이상), 홀 공차±0.4mm와 작은 부품 최소 크기30×30×10을 제시한다. 이 조건으로 현재0.15–0.7mm 설계 여유를 보장할 수 없다. 얇은 plate와 작은 gate/spine/bracket의 접수 가능 여부, 후가공, 연결 캐리어/묶음 출력의 허용 여부를 업체에 확인해야 한다. 임의로 영구 형상을 키워 최소 크기를 맞추지 않는다.

예를 들어 [JLC3DP ABS 자료](https://jlc3dp.com/help/article/abs-plastic)는 권장 벽1.6mm/최소1.2mm를 제시한다. Gate 옆 살1.3mm,1.4mm 받침, 스위치1.5T 층은 국부 시험이 필요한 영역이다. 실제 재료의 공차/층간 강도/열변형/표면을 비교하고 최종 재료를 정한다.

Plate는 윗면을 베드 쪽으로 하는 기존 후보를 먼저 검토하되 counterbore와 걸쇠 층의 지지 제거·면 품질을 확인한다. Mount lap은 Z−3~0의 tongue와 상부 rail 단차를 포함한다. 두 출력 방향의 층간 하중을 비교한 뒤 정한다. Bracket/gate의 너트 포켓과1.4mm 받침에는 지지재가 남지 않아야 한다. REVIEW STL의 조립 좌표 배치는 프린트 베드 배치가 아니다.

## 제작 승인 전 남을 기록

현물 케이스 나사 규격/유효 깊이, 실제 spacer/볼트 길이와 챔퍼, 보드/USB 치수, 스위치 핀·걸쇠, 다이오드/배선/납땜 점유, 키캡 전 스트로크, 반복 탈착과 중앙 처짐 결과를 남긴다. 현재 CAD는 참조 점유 검사까지만 끝났고 이 시험 결과는 없다.

## 갱신 기록

- 2026-11-05: 전체 jig 없이 진행 가능한 국부 시험 묶음·비교 치수·JLC3DP 접수 확인 항목 작성.
