zzskm/keyboard/46sp/images/print-bottom.png

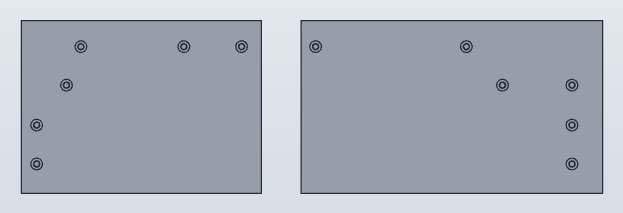
46sp/images/print-bottom.png
