zzskm/keyboard/46sp/images/print-case-left.png

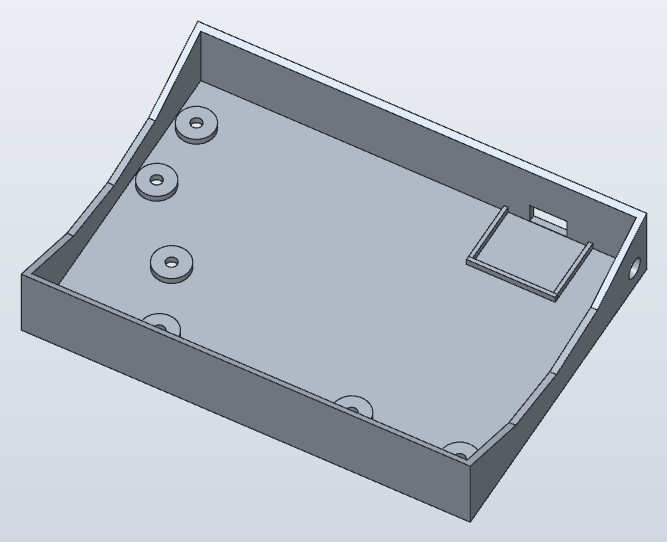
46sp/images/print-case-left.png
