zzskm/keyboard/46sp/images/print-explode.png

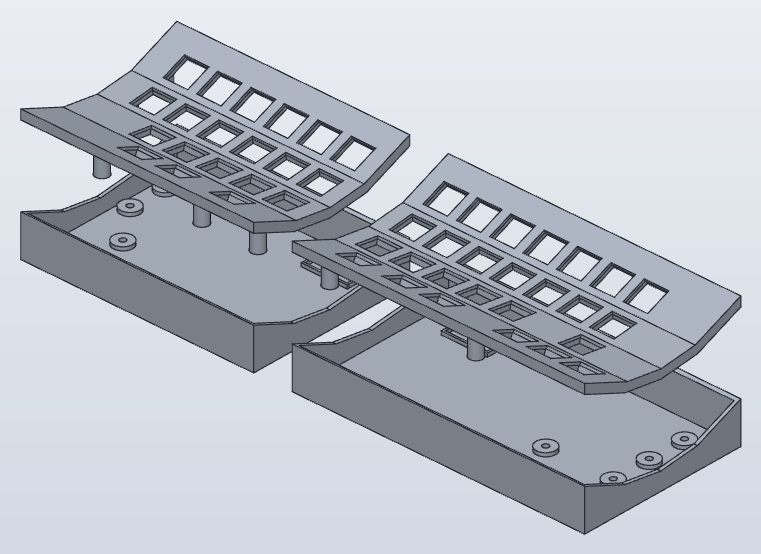
46sp/images/print-explode.png
