zzskm/keyboard/46es/inspection/switch_tester/README.md

# 스위치 테스터 키체인(`v2 keychain.step`) 분석 — 스위치 끼움 치수 참고

상태: 참고 자료 분석 (2026-11-04). 스위치 모델명은 이 파일에 없다. 셀 치수는 **스위치 바디를 포켓에 눌러 끼우는 구조**의 값이며, 46es plate의 1.5T 스냅 체결과는 다른 방식이다.

## 원본

| 항목 | 값 |
|---|---|
| 파일 | `C:\Users\bearhappy\Downloads\v2 keychain.step` (리포지토리에 넣지 않음) |
| SHA-256 | `9e2afb4e68ac570e8e79af674f933872c394638383790ea83dc9dbaaba1e4591` |
| 크기 | 814,430 B, 18,339행 |
| 생성 | Autodesk Translation Framework v13.20 (Fusion), 2024-10-04, AP214 |
| 바디 | 8개 (`Untitled v1` 1개 + `7` … `7 (7)` 7개), 솔리드 총 18,458 mm³ |
| 전체 bbox | X −10 … 140, Y −10 … 13, Z 0 … 11.38 |

분석 방법: SolidCraft `open`(STEP) → `measure`, `body_topology`(실린더·평면 좌표). 렌더는 `render/`.

## 셀 1개 치수 (바디 `7`, 중심 X=30 기준으로 상대 좌표)

20 × 20 × 11.38 mm 컵. 아래 값은 평면·실린더 중심에서 직접 읽은 값이다.

| 부위 | 값 | 비고 |
|---|---|---|
| 외형 | 20.0 × 20.0, 높이 11.38 | 셀 간격 20.0 |
| 바닥 두께 | 1.25 (Z 0 → 1.25) | |
| **스위치 포켓** | **13.75 × 13.75**, Z 1.25 → 10.58 (깊이 9.33) | 내벽 X·Y = ±6.875. 코너는 직각 |
| 포켓 코너 릴리프 | Ø3.3 세로 구멍 4곳, 중심 (±6.875, ±6.875), Z 1.25 → 10.08 | FDM 코너 부풀음 회피 |
| 상단 플랜지 자리 | 16.8 × 16.8, 깊이 0.8 (Z 10.58 → 11.38) | 내벽 ±8.4. MX 상부 하우징 15.6 기준 편측 0.6 여유 |
| 플랜지 자리 코너 | Ø4.3 ×0.8 깊이, 같은 코너 중심 | 코너 릴리프의 상단 확장 |
| **걸쇠 릴리프** | R3.2 원통 2곳, 중심 (±5.01, 0), Z 7.43 → 9.33 (높이 1.9) | ±X 벽 중앙을 X=±8.21까지 파냄. 플랜지 자리 바닥(10.58)에서 1.25 → 3.15 아래 |
| 중앙 구멍 | Ø3.75 (Z 2.25 → 5.25), 아래에서 Ø5.25 카운터보어 (Z −… → 1.25 영역, 깊이 4 표기) | 스위치 중앙 기둥 또는 결합용 |
| 셀 연결 구멍 | Ø3.0 세로 4곳, (±8.5, ±8.5), 깊이 10.88 | 핀/자석 연결용 추정 |

`Untitled v1`(X −10 … 10)은 같은 셀에 +Y 쪽으로 고리(Y 10.25 … 13, R0.25/0.8/1.25/1.5 원호)가 붙은 끝 부품이다. 포켓·릴리프 치수는 `7`과 같다.

## 46es에 쓰는 법

- **스위치 바디 폭 참고**: 이 설계는 MX 바디를 13.75 포켓에 눌러 끼운다. MX 바디 공칭 폭은 약 13.9–14.0이므로 설계상 약 0.15–0.25 간섭이다. 출력물에서 실제로 끼워졌다면 그 공정에서 "홀이 설계보다 커지지 않거나 바디가 눌려 들어간다"는 뜻이다. 출력 여부·조건을 모르므로(인터넷 다운로드) 46es 보정값으로 옮기지 않는다.
- **걸쇠 위치 참고**: 릴리프가 플랜지 자리 바닥에서 1.25 → 3.15 아래, ±X 벽 중앙에 있다. 46es plate의 `TBD_sw_ledge_T`(걸쇠가 걸릴 남김 두께, 현재 1.5 참고값)와 `TBD_sw_relief_W`(하면 파임 폭, 현재 0)를 정할 때 "걸쇠는 플랜지 아래 약 1.3–3.2 구간에 있다"는 범위로 쓴다. 스위치 도면값이 아니므로 미확정이다.
- **쓰지 않는 것**: 13.75를 plate 홀 값으로 쓰지 않는다. plate는 바디를 통과시키고 걸쇠로 잡는 구조라 홀이 14.0 전후여야 하고, 포켓 압입과는 요구가 반대다.

## 아직 모르는 것

1. 스위치 모델명(M19). 파일에 없다.
2. ~~이 키체인을 실제로 출력했는지~~ → 사용자 확인(2026-11-04): 인터넷에서 내려받은 타인 설계이며 출력하지 않았다. 따라서 13.75 포켓은 "어느 설계자가 그렇게 그렸다"는 사실일 뿐, 출력 보정 기준점(M18)으로는 쓰지 않는다.
3. 걸쇠가 ±X 쪽인지 ±Y 쪽인지는 스위치 방향(LED/핀 방향)에 따라 다르다. 이 셀은 ±X에 릴리프가 있다.

## 재현

```text
SolidCraft MCP: open {"path": ".../step_in/v2_keychain.step"} → measure {"summary": true}
               → body_topology {"body": "7", "faces": "cylinders"} / {"faces": "all"}
Python(-I, numpy): CARTESIAN_POINT bbox·CYLINDRICAL_SURFACE 반지름 집계 (scratchpad scripts/step_scan.py)
```

## 참고: JLC3DP FDM 설계 가이드 (2026-11-04 열람)

출처: <https://jlc3dp.com/help/article/212-3D-Printing-Design-Guideline>. 업체는 아직 후보(JLCPCB)이며 확정이 아니다.

| 항목 | FDM | MJF(PA12) | SLA 레진 |
|---|---|---|---|
| 치수 공차 (≤100 mm / >100 mm) | ±0.3 / ±0.4% | ±0.3 / ±0.4% | ±0.2 / ±0.3% |
| 구멍 공차 | ±0.4 | ±0.3 | ±0.3 |
| 최소 벽 50×50 / 100×100 / 200×200 | 1.6 / 2.0 / 2.5 | 1.5 / 2.0 / — | 1.0 / 1.5 / — |
| 최소 구멍 | Ø1.5 | Ø1.5 | Ø1.0 |
| 조립 틈 최소 | 0.5 | 0.2–0.4 | 0.2 |
| 최소 부품 크기 | 30 × 30 × 10 | — | — |
| FDM 재료 | ABS, ABS-ESD, ASA, PLA-P, PA12-CF, TPU, PEBA, PEEK (PETG 없음) | | |

46es에 걸리는 점: (1) 걸쇠 남김 1.5T는 FDM 권장 벽두께(돌기·스냅 1.5 초과) 아래다 → 5T 구조부 + 국부 박육 방식이 맞고, 샘플 검증이 필수다. (2) 구멍 공차 ±0.4는 스위치 홀 14.0에 비해 매우 크므로 13.9–14.2 샘플만으로 부족할 수 있다(범위 확대 검토). (3) 최소 부품 크기 30×30×10 — 홀 샘플 쿠폰은 이 크기 이상으로, 두께 5의 plate 단품이 이 규칙에 걸리는지 업체에 확인한다.

---

# 3×3 Key Switch Fidget Lanyard(`3x3Fidget v11.stl`) 분석 — **커뮤니티 검증된 FDM 스냅 홀 치수**

상태: 참고 자료 분석 (2026-11-04). 출처 <https://www.printables.com/model/1077722-3x3-key-switch-fidget-lanyard> (Third Dimension Labs, "Cherry MX 호환" 시리즈). 사용자 전언: 댓글에 "fit well". 페이지 본문·댓글은 자동 수집이 403으로 막혀 직접 읽지 못했다(출력 재료·프린터 미상). 파일은 리포지토리에 넣지 않는다(타인 저작물).

| 항목 | 값 |
|---|---|
| 파일 | `C:\Users\bearhappy\Downloads\3x3Fidget v11.stl`, 39,684 B, binary STL 792 삼각형 |
| SHA-256 | `be2630939b07114c98deeea17237a106e9ca5f160e8fb162c941ee0fdfa93a58` |
| 전체 | 64 × 64 × 16.2 mm, 셀 3×3, **간격 19.0** (46es r2는 19.05) |

## 셀 1개 단면 (중앙 셀, 평면 좌표 그대로 읽음 — 모두 정확한 정수/소수)

```text
Z 16.2  ── 테두리 상단 (plate 위 6.5 mm 키캡 가드, 벽 3 mm)
Z  9.7  ── plate 상면            ┐
            홀 14.0 × 14.0        │ 걸쇠 남김 1.4
Z  8.3  ──                        ┘
            걸쇠 노치: 홀 → 16.0 (편측 1.0), 길이 8.0 (중앙 ±4), 높이 1.5, 4변 모두
Z  6.8  ──
            우물 14.0 × 14.0 (하부 하우징·핀 수납), 깊이 5.6
Z  1.2  ── 우물 바닥
Z  0.0  ── 바닥
```

| 요소 | 값 | 비고 |
|---|---|---|
| 스위치 홀 | **14.0 × 14.0** (코너 직각) | r2 DWG 14.000과 같음 |
| 걸쇠 남김(ledge) | **1.4** (9.7 → 8.3) | 일반 MX 1.5보다 0.1 얇음 |
| 걸쇠 노치 | 폭 16.0(편측 1.0) × 길이 8.0 × 높이 1.5, **4변 전부** | 걸쇠 방향을 가리지 않음 |
| 노치 아래 우물 | 14.0 × 14.0, 깊이 5.6 | 바디를 잡아 흔들림 억제 |
| 하면 개방 | 없음(바닥 1.2 막힘) | 핀이 바닥에 닿지 않음: 플랜지 아래 8.5 |

## 46es에 쓰는 법

이 형상은 46es가 계획한 **"5T 구조부 + 국부 1.5T 걸쇠부"**와 같은 원리다: 두꺼운 판에 14.0 홀을 뚫고, 상면 1.4–1.5만 남긴 채 그 아래에 1.5 높이의 얇은 노치(편측 1.0)를 파서 걸쇠를 받는다. 노치 아래는 다시 14.0으로 좁혀 바디를 잡는다. "fit well" 댓글은 이 조합(14.0 / 1.4 / 노치 16×8×1.5)이 FDM에서 작동한다는 간접 증거다. 단, 출력 재료·프린터·노즐을 모르므로 **JLCPCB 출력 샘플로 재확인**한다.

B 쿠폰(`../../tools/coupon_v5.py`, [제작 안내](../../model/print_v5/README.md#b-쿠폰보스-탭)) 행 A는 이 방식(ledge 1.5, 노치 8 × 1.0 × 1.5, 우물 = 홀 치수)을 홀 13.7–14.3로 변화시킨 것이고, 행 B는 노치 대신 하면 전체를 16.5로 개방한 비교군이다.

## 재현

```text
python -I <scratchpad>/scripts/stl_quick.py 3x3Fidget_v11.stl   # bbox, 수평/수직 평면 좌표와 면적
python -I <scratchpad>/scripts/stl_cell.py  3x3Fidget_v11.stl   # 중앙 셀 Z별 단면 교차점, 평면 목록
```
(스크립트 사본: `scripts/`. 렌더: `render/fidget_top.png`(플레이트·노치 쪽), `render/fidget_bottom.png`(막힌 바닥))
