zzskm/keyboard/46es/model/measurements.csv

id | 우선순위 | 분류 | 항목 | 측정 방법 | 도구 | 목표 정밀도 | 연결 매개변수 | 현재 후보값 | 후보 출처 | 상태 | 실측값 | 측정일 | 메모
M01 | 1 | PSD60 내부 | 내측 폭(좌↔우 내벽) | 앞·중·뒤 3곳 × 지지대 높이/테두리 높이 2레벨(구배 확인). r2 판을 끼운 상태에서 좌우 틈을 필러 게이지로 재면 간접 확인 가능 | 캘리퍼 내경조(300mm급) · 필러 게이지 | ±0.05 mm | TBD_case_in_W | 286.381 (Wilmore) / 286.4 (r2) | Wilmore STL(PSD60 아님, inspection/wilmore) 링 내면 / DWG r2 판 외곽(자리표시) | 대략 실측·참고용 | front_post=286 mm | 2026-11-04 | [실측 2026-11-04] 부분 측정: 앞·지지대 높이 1/6곳만 입력. 전체 최솟값·구배 미확정. r2 외곽 폭 286.4와 측정 위치 기준 차이 -0.4 mm; 끼움 재확인. 원본: measurements/2026-11-04T111846Z.json / [사용자 결정 2026-11-04] 측정 정확도가 낮으므로 참고 기록으로만 보존. 매개변수는 기존 STL 기반값·GH60 후보 좌표 유지; JSON params 자동 채택 안 함.
M02 | 1 | PSD60 내부 | 내측 깊이(앞↔뒤 내벽) | 좌·중·우 3곳 × 2레벨. r2 판 끼움 상태 앞뒤 틈 병행 측정 | 캘리퍼 내경조 · 필러 게이지 | ±0.05 mm | TBD_case_in_D | 95.934 (Wilmore) / 95.8 (r2) | Wilmore STL(PSD60 아님, inspection/wilmore) 링 내면 / DWG r2 판 외곽(자리표시) | 대략 실측·참고용 | left_post=96 mm | 2026-11-04 | [실측 2026-11-04] 부분 측정: 좌·지지대 높이 1/6곳만 입력. 전체 최솟값·구배 미확정. 원본: measurements/2026-11-04T111846Z.json / [사용자 결정 2026-11-04] 측정 정확도가 낮으므로 참고 기록으로만 보존. 매개변수는 기존 STL 기반값·GH60 후보 좌표 유지; JSON params 자동 채택 안 함.
M03 | 1 | PSD60 내부 | 내측 코너 R(4코너) | R 게이지 대조 또는 코너 본뜨기(종이 전사·점토) 후 스캔. r2 판(R3.5) 끼움 시 코너 틈 측정 | R 게이지 · 스캐너 · 필러 게이지 | ±0.25 mm | TBD_case_in_R, TBD_plate_C, TBD_frame_C, TBD_cover_R | 2.5 | Wilmore STL(PSD60 아님, inspection/wilmore) 링 내측 R2.48~2.50 · The_Wedge 메시 추정 R2.5 — 둘 다 PSD60 아님. 사용자 관찰: R3.5 판에서 코너 유격 → R<3.5 예상 | 미확정
M04 | 3 | PSD60 외곽 | 외형 폭·깊이·앞 높이·뒤 높이·경사 | 평면 위에서 측정 | 캘리퍼 · 하이트 게이지 · 각도기 | ±0.1 mm / ±0.2° | TBD_case_out_W, TBD_case_out_D, TBD_case_H_front, TBD_case_H_back, TBD_case_tilt | 320 / 115 / 21 / 32 / 6° (문서) · Wilmore 312.9 / 117.7 / — / — / 4.63° | KPrepublic 안내(docs/design.md) / Wilmore STL(외형은 PSD60과 다른 모델) | 문서값·미검증
M05 | 1 | PSD60 내부 | 내부 높이: 바닥→지지대 상면, 지지대 상면→앞/뒤 테두리 상단, 테두리 턱·언더컷 유무 | 지지대 6곳 각각 측정(높이 편차 확인) | 캘리퍼 뎁스 바 · 깊이 게이지 | ±0.1 mm | TBD_support_H, TBD_support_to_rim_F, TBD_support_to_rim_B, TBD_standoff_H, TBD_cover_H | 바닥→지지대 6.196 / 지지대→앞 테두리 12.173 / 뒤 11.891 | Wilmore STL(PSD60 아님, inspection/wilmore). 지지대 = 스탠드오프 상면. 언더컷·턱 없음(수직벽) | 부분 실측·H 참고 | sup_H01=5.5 mm; rim_F=14 mm; rim_B=14 mm | 2026-11-04 | [실측 2026-11-04] H01 1/6곳만 측정: 5.5를 6곳 평균으로 확정하지 않음. 앞/뒤 테두리 14. 턱·언더컷 미입력. 원본: measurements/2026-11-04T111846Z.json / [후속 사용자 결정 2026-11-04] H 지지대 측정은 신뢰 가능: sup_H01=5.5 mm를 H01 높이 근거로 사용. 다른 5곳 높이 및 rim_F/rim_B의 정확도까지 확정한 것은 아님. CAD 공통 높이 자동 변경 안 함. / [150 mm 캘리퍼·후속방침] H 측정은 어긋남 방향·대략 크기의 근거로 사용. 기존 GH60 후보 좌표를 유지하고 장공으로 조정; 소수점 단위 확정치로 간주하지 않음.
M06 | 2 | PSD60 내부 | 벽 두께·내벽 수직도 | 상단·하단 두께 차로 구배 확인 | 캘리퍼 | ±0.1 mm | TBD_plate_gap, TBD_cover_gap | 없음 | — | 미확정
M07 | 1 | 기준 좌표 | 내측 좌벽·앞벽 → GH60 PCB 기준점 오프셋 | M08 결과(체결점 중심)와 내벽까지 거리로 역산 | 캘리퍼 | ±0.05 mm | TBD_pcb0_dx, TBD_pcb0_dy | 0.693 / 0.667 (Wilmore) · 0.7 / 0.6 (가정) | Wilmore STL(PSD60 아님, inspection/wilmore): 링 내면 → H03·H04에 맞춘 GH60 기준점 | 미확정
M08 | 1 | 체결 | 체결 구멍 6곳 중심 좌표 및 중심 간 거리(H01–H04, H05–H06, H02–H03, H01–H05, H04–H06, H01–H02) | 얇은 GH60 좌표 시험 프레임을 끼워 억지 없이 들어가는지 확인 + 구멍 가장자리 간 거리 ± 반지름으로 중심 거리 산출. 대안: 전사용 나사 | 캘리퍼 · 시험 프레임 · 전사용 나사 | ±0.1 mm | CAND_H01_X … CAND_H06_Y | GH60 공개 좌표(H05–H06 277.58). r2 DWG 279.44. Wilmore 278.49 | 공개 CAD 비교 문서 / DWG r2 / Wilmore STL — 모두 PSD60 실측 아님 | 부분 실측·H 참고 | H01_x=26 mm; H02_y=49 mm; H03_y=11 mm; H04_y=68 mm; H05_x=4 mm; H06_y=39 mm | 2026-11-04 | r2 DWG 체결 후보는 GH60 좌표와 최적 평행이동 후에도 X 잔차 최대 약 1.1 mm / Wilmore − GH60(H03·H04 기준 맞춤): H01 X +0.12, H02 Y −0.30, H05 X −0.39, H06 X +0.52, H03·H04 일치. CAD 하우징 대용 바디의 기둥은 CAND_(GH60) 좌표 사용 / [실측 2026-11-04] 입력 6개는 내벽 기준 절대거리. GH60 PCB 기준 CAND_ 좌표에 직접 대입하지 않음. M07 원점 오프셋·나머지 좌표·중심 간 거리 확인 후 반영. 원본: measurements/2026-11-04T111846Z.json / [후속 사용자 결정 2026-11-04] H 지지대 위치 입력 6개는 신뢰 가능한 현물 기준으로 채택. H01_X=26, H02_Y=49, H03_Y=11, H04_Y=68, H05_X=4, H06_Y=39 mm (모두 내벽 기준). 미측정 좌표는 GH60 후보 유지. CAD는 GH60 원점이므로 M07 오프셋을 고려해 변환해야 함; 아직 CSV 매개변수·SC 미반영. / [150 mm 캘리퍼·후속방침] H 측정은 어긋남 방향·대략 크기의 근거로 사용. 기존 GH60 후보 좌표를 유지하고 장공으로 조정; 소수점 단위 확정치로 간주하지 않음.
M09 | 1 | 체결 | 케이스 체결 나사 규격(호칭경·피치·길이·머리 지름/높이), 나사산 유효 깊이, 6곳 동일 여부 | 기존 나사 실측 + 피치 게이지, 유효 깊이는 뎁스 바 | 피치 게이지 · 캘리퍼 | — | TBD_case_screw_D, TBD_case_screw_clr | M2 가정 (Wilmore 구멍 Ø2.0) | 근거 없음(자리표시) / Wilmore STL 구멍 지름 | 대략 실측·참고용 | D=2 mm | 2026-11-04 | [실측 2026-11-04] 호칭경 2 mm 입력. 피치·길이·머리 크기·유효 깊이·6곳 동일 여부는 미확정. 원본: measurements/2026-11-04T111846Z.json / [사용자 결정 2026-11-04] 측정 정확도가 낮으므로 참고 기록으로만 보존. 매개변수는 기존 STL 기반값·GH60 후보 좌표 유지; JSON params 자동 채택 안 함.
M10 | 1 | 체결 | 케이스 지지대(보스) 외경·높이·상면 면적(6곳) | 각 보스 외경 2방향 | 캘리퍼 | ±0.1 mm | TBD_case_boss_clr_D | Ø4.5 회피 구멍(r2) / Ø5.0 스탠드오프(Wilmore) | DWG r2 판의 Ø4.5/R2.25 노치 / Wilmore STL 스탠드오프 외경 | 부분 실측·H 참고 | H01_D=5 mm | 2026-11-04 | r2 회피 Ø4.5와 Wilmore 기둥 Ø5.0이 맞지 않음 → 실물 기둥 외경 확인 필요 / [실측 2026-11-04] H01 외경 5 mm만 측정. 나머지 보스·2방향 외경 미확정. r2 회피 Ø4.5보다 큼: 회피 치수는 설계 여유 포함 재검토. 원본: measurements/2026-11-04T111846Z.json / [후속 사용자 결정 2026-11-04] H 지지대 측정은 신뢰 가능: H01 외경 5 mm를 H01 외경 근거로 사용. 나머지 5곳 외경까지 확정하지 않음. 회피 구멍 여유는 별도 설계. / [150 mm 캘리퍼·후속방침] H 측정은 어긋남 방향·대략 크기의 근거로 사용. 기존 GH60 후보 좌표를 유지하고 장공으로 조정; 소수점 단위 확정치로 간주하지 않음.
M11 | 1 | 스위치 홀 | 스위치 홀 실제 크기: 기존 아크릴 14mm 홀(가로·세로 각 2곳), r2 1.5T 판 홀 | (사용자 결정 2026-11-04) 기존 아크릴 홀은 실측하지 않는다: 레이저 커프 공차와 FDM 공차가 달라 참고 가치가 낮다. r2 DWG 값 14.000×13.999를 출발값으로 쓰고 출력 샘플(M18)로 정한다 | 캘리퍼 내경조 · 핀 게이지 | ±0.02 mm | TBD_sw_hole | 14.0 (r2 DWG) | r2 DWG P2 홀 14.000×13.999; 아크릴 14mm 타이트 체결 경험 | 미확정 |  |  | 아크릴 실측 생략 결정. 최종값은 M18 홀 샘플 결과
M12 | 1 | 스위치 배치 | 실제 키 간격·각도: 인접 스위치 중심 간 거리(열 방향·행 방향·엄지 키), 키별 회전각 | 키캡 제거 후 스위치 하우징 외곽 기준 측정, 또는 상면 평판 스캔 후 보정. r2 DWG와 대조(46sp는 별도 키보드라 대조하지 않음) | 캘리퍼 · 평판 스캐너 | ±0.1 mm / ±0.5° | TBD_sw_pitch (+ SK21 참고 배치) | 19.05 | DWG r2 P2 열 내 중심거리(36쌍) | 미확정 |  |  | r2 회전각: ±3 / 5 / 6 / 7 / 9 / 11°, 0° 2개
M13 | 1 | 스탠드오프 | 기존 육각 스탠드오프/인서트 형식(암-암·암-수·인서트), 나사 규격, 맞변(AF), 길이, 수량 | 부품별 실측 | 캘리퍼 | ±0.05 mm | TBD_so_AF, TBD_so_screw_D, TBD_standoff_H | AF 4.71 / Ø3.0 | DWG r2 육각 컷·최하층 구멍 | 대략 실측·참고용 | type=암-암 육각; material=스테인리스 | 2026-11-04 | [실측 2026-11-04] 암-암 육각, 나사 재질 스테인리스. 자석 흡착 여부 미입력: 재질명만으로 확정하지 않음. AF·길이·나사 규격·수량 미입력. 원본: measurements/2026-11-04T111846Z.json / [사용자 결정 2026-11-04] 측정 정확도가 낮으므로 참고 기록으로만 보존. 매개변수는 기존 STL 기반값·GH60 후보 좌표 유지; JSON params 자동 채택 안 함.
M14 | 1 | 배선 | 배선 공간: plate 하면→배선·다이오드 최하단, 스위치 핀 돌출, 교차 배선 점유 두께, 경로·고정점 | 현 버전에서 측정 | 캘리퍼 뎁스 바 | ±0.2 mm | TBD_standoff_H | 없음 | — | 대략 실측·참고용 | wire_low=8 mm | 2026-11-04 | 모델(2026-11-04 후반): 스탠드오프 5 가정에서 스위치 핀 끝(Z 4.7)↔프레임 상면(3) 여유 1.7. 배선·다이오드가 이보다 두꺼우면 TBD_standoff_H 증가 / [실측 2026-11-04] plate 하면에서 배선 최하단까지 8 mm. 초안 plate 하면→프레임 상면 5 mm와 비교하면 같은 XY에서는 3 mm 겹침 가능. 개방부·배선 경로 확인 전 스탠드오프 높이 자동 변경 안 함. 원본: measurements/2026-11-04T111846Z.json / [사용자 결정 2026-11-04] 측정 정확도가 낮으므로 참고 기록으로만 보존. 매개변수는 기존 STL 기반값·GH60 후보 좌표 유지; JSON params 자동 채택 안 함.
M15 | 1 | 컨트롤러 | 컨트롤러 보드 종류, L×W×H(부품·헤더·커넥터 포함), USB 커넥터 종류·위치(보드 끝 기준), 고정 방식, 배선 인출 위치, 현재 장착 위치 | 실물 측정 + 사진 | 캘리퍼 | ±0.1 mm | TBD_ctrl_X, TBD_ctrl_Y, TBD_ctrl_L, TBD_ctrl_W, TBD_ctrl_H | 34×19 자리표시 | 근거 없음. 펌웨어 핀 이름(D7·E6·B4·F4–F7 등)상 ATmega32U4 계열로 추정 | 대략 실측·참고용 | board=Pro Micro (ATmega32U4); H=4 mm; usb=Micro-B | 2026-11-04 | USB는 Pro Micro 포트에 연장 케이블 플러그를 꽂아 outlet으로 빼는 구성(M16 참조). Pro Micro 자체는 외부 응력을 받지 않음; 모델(2026-11-04 후반): 프레임에 컨트롤러 포켓(CTRL_POCKET_*)과 점유 바디 CTRL_KEEPOUT_TBD 추가. 위치 TBD_ctrl_X/Y = 33/68(뒤-왼쪽 열린 구역, USB 노치 오른쪽) 가정, 33×18×4(Pro Micro, 핀헤더 없음) 가정. PCB는 턱(1 mm) 위, 부품면 아래. 2026-11-04 마지막: 사용자 결정으로 Pro Micro를 plate 아랫면 브래킷(C-채널 레일+턱 2단+끝막이, CTRL_RAIL_*/CTRL_LIP_*/CTRL_STOP)에 고정 → plate 나사를 풀면 plate·배선·컨트롤러가 함께 분리. PCB Z 2~3.6, Y 13.0~31.0, 프레임에는 관통 개구부(CTRL_OPENING_CUT)만. 측정 시 커넥터 높이(USB-C 3.2?)와 핀헤더 유무 확인. 입력은 model/measure_psd60.html / [실측 2026-11-04] Pro Micro ATmega32U4 / Micro-B / 전체 높이 4 mm 입력. PCB 길이·폭·헤더 유무·플러그 점유 치수는 미확정. 원본: measurements/2026-11-04T111846Z.json / [사용자 결정 2026-11-04] 측정 정확도가 낮으므로 참고 기록으로만 보존. 매개변수는 기존 STL 기반값·GH60 후보 좌표 유지; JSON params 자동 채택 안 함. / [v5 2단계 2026-11-09] 스냅 브래킷(tools/ctrl_v5.py)은 검토 모델의 Pro Micro 참고 배치 기준: PCB 33×18×1.6, 패드 피치 2.54(1번 중심 −X 끝에서 3.8), 12번 패드 링 끝 ↔ +X 끝 0.39, 크리스털 +X 끝에서 0.7. 실측할 것: PCB L·W·T, +X 끝 ↔ 12번 패드 중심, 크리스털 위치·높이, USB 쪽 모서리 부품 유무.
M16 | 1 | USB 간섭 | PSD60 USB 개구부 중심 X(내측 좌벽 기준)·중심 높이(지지대 상면 기준)·폭·높이·벽 두께, 케이블 플러그 오버몰드 크기·굽힘 여유 | 개구부 실측 + 사용할 케이블 플러그 실측 | 캘리퍼 | ±0.1 mm | TBD_usb_X, TBD_usb_W, TBD_usb_Z, TBD_usb_keepout_D | X 18.713 / 폭 11.217 / 높이 7.137 / 중심 Z −1.533 (Wilmore) | Wilmore STL(PSD60 아님, inspection/wilmore). 모서리 R 없는 직사각형, 벽 두께(링 포함) 약 7.1 | 미확정 |  |  | 사용자 결정 2026-11-04: Pro Micro에 패널형 USB 연장 케이블(outlet)을 연결해 PSD60 USB 개구부 안쪽에 글루스틱/핫글루로 고정. 나사 보스 불필요, 프레임에 접착 자리(평면·위치 고정 턱)만 필요. 커넥터 종류(USB-C/Micro-B/USB-A)·암수·하우징 L×W×H·케이블 길이 미확인(판매처 이미지 링크만 받음, 페이지 자동 수집 불가) → 실물 측정 후 TBD_usb_outlet_* 추가; 모델(2026-11-04 후반): TBD_usb_outlet_W/H/D(12/8/12 자리표시)·TBD_usb_glue(1) 추가. 프레임 뒤 테두리에 노치 14 × 깊이 15(USB_NOTCH_TBD), 점유 바디 USB_OUTLET_TBD. 실물 측정값으로 교체. 2026-11-04 마지막: Pro Micro 쪽 플러그 오버몰드 점유 TBD_usb_plug_W/H/L(12/7/25 자리표시, CTRL_KEEPOUT_PLUG)와 프레임 링 노치(CTRL_USB_PLUG_NOTCH) 추가 → 플러그 폭·높이·길이도 함께 측정
M17 | 2 | 키캡·커버 | 키캡 1u/1.25u/1.75u/2u 하단 폭·깊이, 눌림 상태 키캡 하단↔plate 상면 간격, 2u 스태빌라이저 사용 여부 | 현물 측정 | 캘리퍼 | ±0.1 mm | TBD_keycap_W, TBD_keycap_gap, TBD_cover_H | 18 자리표시 | 일반값 | 미확정 |  |  | DWG r2에는 스태빌라이저 컷아웃 없음; 모델(2026-11-04 후반): 벽형 커버는 뒤쪽 키캡↔내벽 여유 2.15로 불가 → 평판 베젤(TBD_cover_T 2)로 변경. 키캡 폭은 사용자 확인(2026-11-04): 맨 아랫줄 1.25u·1u·2.25u·2u·1u·1u(tools/make_key_dxf.py WIDTHS_U 반영). 2u 스태빌라이저 TBD_stab_2u=0(결정 필요); 커버 창은 2026-11-04 후반에 키 블록 실루엣(좌·우 2창, 셀 18.5 = 스위치 개구 16.5 + 1.0)으로 변경 → 키캡 폭 배정은 창 외곽선에만 영향(2u·1.75u·1.25u 썸키 위치); PgUp·PgDn·맨 아랫줄 6키는 키캡 보유에 따라 가변 → 커버 창은 수용 폭(실제+0.5u, PgUp·PgDn 1.5u 상한)으로 그림(tools/make_key_dxf.py ENVELOPE_U)
M18 | 2 | 출력 보정 | 출력 공정·재료·방향 확정 후 보정량: 스위치 홀 B 쿠폰(13.7–14.3, 행 A 노치/B 개방/C v5 층), 나사·카운터보어·육각·자석 포켓 여유, 외곽 간격 | 최종 출력과 같은 업체·재료·방향·후처리로 소형 샘플 출력 | 시험 출력 · 캘리퍼 | — | TBD_case_screw_clr, TBD_so_clr, TBD_frame_gap, TBD_plate_gap, TBD_cover_gap | MJF PA12S-HP 검정·8001 레진 투명(2026-11-06 변경) / JLCPCB(JLC3DP). 2026-11-04 FDM·PLA-P 안은 폐기 | 사용자 결정 2026-11-04; JLC3DP 설계 가이드(2026-11-04 열람) | 미확정 |  |  | JLC3DP FDM 가이드: 치수 공차 ±0.3(100 이하)·±0.4%(100 초과), 구멍 공차 ±0.4, 최소 벽 1.6(50×50)·2.0(100×100)·2.5(200×200), 조립 틈 최소 0.5, 최소 부품 크기 30×30×10, 돌기·스냅·체결부 1.5 초과 권장. 1.5T 걸쇠부는 권장 벽두께 아래이므로 샘플 필수. v2 keychain.step(13.75 포켓 압입)은 인터넷에서 받은 타인 설계라 출력 결과를 모름 → 보정 기준점으로 쓰지 않음. 2026-11-10: 위 FDM 수치(최소 부품 30×30×10 등)는 현행 MJF·레진에 적용되지 않는다. JLC3DP 가이드의 MJF·SLA 최소 부품 5×5×5 또는 10×2×2, 음각 최소 0.8. 샘플은 tools/coupon_v5.py가 plate 두께로 만든다
M19 | 1 | 스위치 | 스위치 모델명, 걸쇠 위치·폭, 장착부 허용 plate 두께, 상단 플랜지 크기 | 데이터시트 + 실물 | 캘리퍼 | ±0.05 mm | TBD_sw_ledge_T, TBD_sw_relief_W | Gateron KS-3 Milky Yellow (Pro), 5핀 PCB 마운트형, MX 호환 하우징; 걸쇠 남김 1.5T 참고; 걸쇠는 플랜지 아래 약 1.25–3.15 구간(키체인 릴리프) | 사용자 지정 2026-11-04(모델명); 일반 MX 참고값; v2 keychain.step(inspection/switch_tester) | 미확정 |  |  | 모델명 확정. Gateron 공식 KS-3 도면은 못 찾았고 판매처 사양만 확인(5핀 PCB 마운트, 50g, 2.0/4.0mm). 걸쇠 폭·위치·플랜지(15.6 추정)는 실물 캘리퍼 측정 필요. 샘플 쿠폰은 걸쇠 위치와 무관하게 하면 포켓을 4변 전체로 파서 설계
M20 | 1 | 배치 대조 | 현물 키 수·위치 vs r2 P2(46개) | 사진 + 키별 대조표 | 육안·사진 | — | N_KEYS | 46 | 펌웨어 JSON·DWG r2 | 확인(수량)/미확정(위치) |  |  | r2 좌측 바깥 열 위쪽 개구부가 H01 위치 육각 컷과 겹침
M21 | 1 | r2 적층(Z) | r2 판별 실제 두께(P0~P5, 각 3곳), 조립 적층 순서, 전체 적층 높이, 하우징 장착 시 지지대 상면→각 판 상면 높이 | DWG에는 Z·두께 정보가 전혀 없음(모델 공간 229개 Z=0, thickness=0). 라벨 두께는 공칭값이라 실물과 다를 수 있음 | 캘리퍼 · 마이크로미터 · 뎁스 바 | ±0.05 mm | REF_r2_T_P0 … REF_r2_T_P5, REF_r2_stack_T, TBD_standoff_H | 2 / 5 / 1.5 / 2 / 5 / 2 (합 17.5) | DWG MText 라벨 | 미실측 |  |  | P0 링·소형 육각 부품이 적층에 포함되는지 함께 확인
M22 | 1 | PSD60 내부 | 뒤 벽 안쪽 반원 보스 4개: 중심 X·지름·벽에서 돌출·윗면 높이 | 중심 X는 왼쪽 내벽에서 캘리퍼. 윗면 높이는 테두리→보스 윗면 깊이와 테두리→H01·H04 지지대 윗면 깊이의 차 | 캘리퍼(깊이자) | ±0.2 mm | v5_rear_boss_1_X–4_X, v5_rear_boss_D, v5_rear_boss_top_Z | X 36.0 / 113.6 / 170.1 / 245.8, Ø9, 윗면 Z 0(가정) | 사용자 제공 KPrepublic 제품 사진(2026-11-09)을 H01–H06으로 사영 보정(잔차 ≤ 0.8, 기준점 하나씩 빼면 ±2–4). 윗면 높이는 r2 맨 아래 판 P0가 노치 없이 지난 것에서 추정 | 미측정(사진 추정) |  |  | 뒤 받침 블록 3곳(tools/build_seam_v5.py REAR_RESTS)과 우 mount 뒤 모서리(④)가 이 값에 걸린다. 재면 블록 위치·높이를 실측으로 고친다
