zzskm/keyboard/46es/model/measure_psd60.html

# PSD60 실측 도우미PSD60 실측46es · M01–M21

JSON 내보내기

1. 그림에서 위치 확인그림의 M 라벨을 누르면 해당 카드로 간다. 칸을 누르면 그 위치가 그림에 강조된다.
2. 카드에 값 입력이 브라우저에 자동 저장된다. Enter로 다음 칸, Shift+Enter로 이전 칸.
3. JSON 내보내기복사한 텍스트를 model/measurements/에 원본 기록으로 저장한다. 채택 여부는 measurements.csv에 적고, 채택한 값은 생성기 입력으로 옮겨 CAD를 다시 만든다.

단위는 mm(각도는 °). 여러 곳을 재는 항목은 칸마다 따로 적으면 아래 집계(최소·평균·최대)가 매개변수 후보가 된다. 칸의 회색 숫자는 후보값(Wilmore STL 추정, PSD60 아님)이다.

측정 위치닫기 ✕

## 내부 평면

위에서 본 모습 · 위쪽이 뒤(USB 쪽)

← 그림을 옆으로 밀어서 본다

## 앞↔뒤 단면

옆에서 자른 모습 · 왼쪽이 앞 · 높이는 지지대 상면 = 0 기준

- 벽·바닥(실선 = 내벽, 점선 = 외형)
- 체결 지지대 H01–H06
- USB 개구부
- 측정 치수
- 기준선 · GH60 원점
- M01누르면 카드로 M01완료

그림은 개략도이며 치수 위치·후보값은 Wilmore STL 추정(PSD60 아님)이라 실물과 다를 수 있다.

## 측정 항목

전체 우선 1 우선 2·3 미완료

이 조건에 맞는 항목이 없다.

## JSON 내보내기

칸별 값·메모·측정일과, 바로 매개변수가 되는 값(params)이 들어 있다. Claude Code 세션에는 전체를 그대로 붙여넣는다.

JSON 복사 파일로 저장

가져오기 — 다른 기기나 이전에 내보낸 JSON 불러오기

JSON을 붙여넣거나 파일을 고른다. 같은 칸은 가져온 값으로 덮어쓰고, JSON에 없는 칸은 그대로 둔다.

붙여넣은 JSON 가져오기 파일 열기

입력은 이 브라우저에만 저장된다. 다른 기기로 옮길 때는 JSON을 쓴다. 모두 지우기
