zzskm/keyboard/46es/inspection/switch_tester/render/fidget_top.png

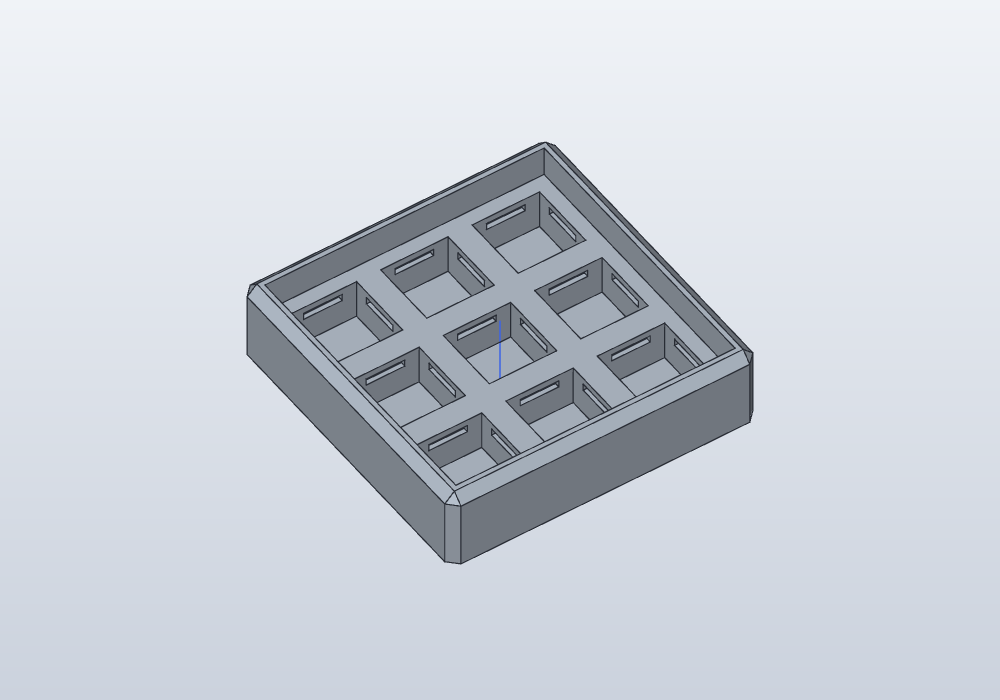
46es/inspection/switch_tester/render/fidget_top.png
