zzskm/keyboard/(commit log)

2021-04-09 33 키보드
2021-04-09 planck 레이아웃
2021-04-09 bm40 펌웨어
2026-11-03 Add 46es keyboard design materials
2026-11-03 46es r2 DWG 검사 결과와 실측 대기용 초안 모델 추가
    - inspection/: DWG 검사 보고서, CADCraft·자체 판독기 교차 검증 데이터,
    판별 렌더, 모델 공간 DXF, 분석·검증 스크립트
    - model/: 매개변수 83개(미확정은 TBD_ 접두어), 실측 시트 M01–M21,
    SolidCraft 2D 초안 스케치 5개(바디·STL 없음), 실측 후 재개 절차
    DWG 치수는 참고값이며 제작 확정 치수가 아님. 기존 파일은 변경하지 않음.
2026-11-04 46es PSD60 조립·정비 설계 기준 문서 추가, 46sp 구분 정정
    - docs/assembly-revision.md 추가: PSD60 Defender tray mount frame,
    스위치 스냅 체결, Pro Micro/USB, 분해·점검 절차, 실측 체크리스트
    - README.md: 46es(non-split)와 46sp(별도 split 예시) 구분, 새 문서 링크
    - docs/planning.md: 46sp 45홀 집계를 46es 이슈 목록에서 제외,
    결합·정비 요구사항 13절 추가
    - manifest.json: 변경·신규 파일 크기/SHA256/git blob SHA 재계산
    (LF 기준; 기존 planning.md 항목이 CRLF 기준으로 어긋나 있던 것도 정정)
2026-11-04 46es 문서 정합성 정리: 검사 보고서 연결, 46sp 비교 제거, manifest 자동 갱신
    - README·planning·assembly-revision: r2 DWG 2D 형상은 이미 검사 보고서에서
    판독·DXF 추출됨을 반영(Z·기입 치수 없음, MText 재료 표기 불일치는 확인 필요).
    검사 보고서·모델 README 링크 추가, 체크리스트에 실측 ID(M01–M21)·단계(A–G) 연결.
    - assembly-revision: r2 P2 전체 1.5T 사례, GH60 후보 좌표와 r2 차이(최대 약 1.1 mm),
    펌웨어 16선의 Pro Micro 핀 대조(D2·D3 여유) 추가.
    - inspection 보고서: 46sp 45개 집계 추정·M20 비교 제거, 부품 구성을
    assembly-revision 기준(5T 구조부 +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
2026-11-04 46es r2 DWG를 아크릴 버전 설계 파일로 정정
    사용자 확인(2026-11-04): 46es_r2_keyboard.dwg는 3D 프린팅 리비전이 아니라
    기존 아크릴 버전의 설계 파일이다. MText 판재 재료 표기(아크릴·압출판·아스텔)와 일치.
    - README·assembly-revision·planning·inspection 보고서의 "3D 프린팅 리비전" 표현과
    "확인 필요" 표시를 정정. planning §12는 제목 변경 후 정정 이력 유지.
    - manifest 갱신 (tools/update_manifest.py, --check 통과)
2026-11-04 46es Wilmore 대용 하우징 바디, 스위치 홀 시험 쿠폰, 스위치·공정 결정 반영
    하우징 대용 (PSD60 실측 전):
    - The_Wilmore.stl에서 하우징 치수 추출 (inspection/wilmore/: 보고서, 스크립트 13개, 렌더 4장)
    - 매개변수 24개 추가 (REF_WIL_* 22, TBD_usb_H, TBD_case_post_D), 하우징 TBD_ 13개를 REF_WIL_ 식으로 연결
    - 참조 바디 REF_HOUSING_WILMORE_NOT_PSD60 (SK40/SK41 + 피처 4개, 297,430 mm³). 출력하지 않음
    B 단계 스위치 홀 쿠폰 (model/samples/):
    - 46es_sw_hole_sample.sc/.stl/.step: 홀 13.7–14.3 × 행 A(fidget식 노치) / 행 B(개방 포켓), M2 구멍 2.0–2.6, 145.35×50.1×10
    - 참고 자료 분석 inspect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
2026-11-04 46es 부품 초안 바디 추가 (프레임·plate·스탠드오프·커버), USB 연장 케이블 결정 기록
    - 46es_draft_sketches.sc: FRAME/PLATE/STANDOFFS/COVER_DRAFT_TBD 바디 4개 (피처 14개). 매개변수 109개, 스케치 9개, 오류 0, 모두 dof 0
    - REF_draft_standoff_H(5)·REF_draft_cover_H(8) 가정값 추가, TBD_standoff_H·TBD_cover_H가 이를 참조 (실측 후 숫자로 교체)
    - 스위치 홀 46개·커버 키 창 46개: r2 P3 중심·회전각의 고정 DXF (inspection/derived/REF_r2_keys_sq14/sq20_gh60.dxf) → SK22/SK32
    - 발견: 커버는 키 사이 리브 불가 (20 > 19.05), 클러스터 단위 창. SK20 템플릿 홀 2개는 실제 키 위치와 일치
    - meas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
2026-11-04 46es 2026-11-04 작업 보고서 추가
    Wilmore 대용 하우징, 부품 초안 바디, B 단계 쿠폰, 결정 기록(M11·M15·M16·M18·M19), 참고 자료 분석, 공정 주의, 다음 단계 요약
2026-11-04 46es 부품 모델 구조 완성: 프레임 개방·장공·육각 포켓, plate 걸쇠 노치·단차, 평판 베젤 실루엣 창, 지그
    - 프레임: 중앙 개방 + 테두리/중앙 바/H01·H04 바 + 보스, GH60식 X 장공 H02–H04와 카운터보어,
    스탠드오프 육각 포켓(매개변수 스케치 SK11), USB 아웃렛 노치, Pro Micro 포켓·턱
    - plate: fidget 방식 걸쇠 노치 46개(SK23 DXF), M3 카운터보어, 커버 단차(rabbet) + 섬 모따기
    - 커버: 벽형 안 폐기(뒤쪽 키캡↔내벽 2.15) → 평판 베젤 2T + 립. 창은 키 블록 실루엣 2개
    (스위치 개구 16.5 + 1.0 셀, 좌·우 블록 따로 닫힘 R8, 가변 폭 키 8개는 수용 폭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
2026-11-04 46es 커버 실루엣 창 곡선 제거: 직선 메움 16 + 오목 R0, 닫힘 R8 폐기
    - tools/make_key_dxf.py silhouette: fill_L 인자 추가(가로·세로 선분 닫힘으로 틈·쐐기를
    직선으로 메운 뒤 close_r 원판 닫힘). close_r 0이면 둥글림 없음
    - REF_r2_cover_silhouette_gh60.dxf 재생성(좌 36·우 48 꼭짓점, 창 면적 19,342)
    - SK33 교체·창 컷 재생성, 커버 부피 17,263.2, 피처 오류 0, 스케치 자유도 0
    - 매개변수 TBD_cover_close_R 8→0, TBD_cover_fill_L 16 추가(총 138, 미확정 88)
    - 렌더 46es_cover_v3_top.png 추가, README·parameters.csv 갱신
2026-11-04 46es 사용자 결정 반영: 스태빌라이저 없음, Pro Micro 중앙 하단, 커버·plate를 아크릴 r2 형상으로
    - stab_2u = 0 확정(접두어 제거)
    - 컨트롤러 포켓을 좌우 썸키 사이 중앙 하단(SO6 뒤, 중앙 세로 바 위)으로 이동, 포켓 벽 1.5 → 3
    - 커버 창을 r2 P4(5T)/P5(2T) 3조각 경계 그대로 교체(SK34, tools/make_r2_cover_dxf.py); 커버 L/T/R 3바디
    - plate를 r2 plate(1.5T, 14.0) + upper plate(2T, 16.5) 3층 구조로 변경(SK24·SK25), 걸쇠 노치 십자 SK23 삭제
    - 렌더 카메라 pitch 부호 정정(+90° = 상면), v3/v4 렌더 추가, README·parameters.csv·manifest 갱신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
2026-11-04 46es 커버 자석 고정·Pro Micro plate 브래킷·PSD60 실측 도우미
    - 커버 고정: plate 카운터보어 3.5 깊이, 커버 밑면 보스 Ø5.6×1.5 6개 + Ø4×2 자석 포켓,
    자석이 강철 스탠드오프 나사머리를 당김(plate 쪽 자석 없음)
    - Pro Micro: 프레임 포켓 → plate 아랫면 C-채널 브래킷(레일 2·턱 2단·끝막이),
    프레임은 관통 개구부·링·USB 플러그 노치만, 플러그 점유 바디 추가
    - model/measure_psd60.html: M01–M21 측정 위치 그림·입력·JSON 내보내기(오프라인 단일 파일)
    - parameters.csv 154개, measurements.csv M15·M16 메모, README, 렌더 5장, manifest 96개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
2026-11-04 46es PSD60 실측 도우미 UI 개선: 그림 겹침 해소, 칸↔그림 연동, 표 입력, 모바일 그림 시트 - 그림을 화면 px 기준으로 다시 그림(mm 단위 viewBox라 글자가 커져 겹치던 문제). 항목마다 라벨 하나, 고른 항목의 치수선만 진하게, 칸을 누르면 그 위치 강조, 완료 항목 라벨 초록 - 넓은 화면: 그림 오른쪽 고정 / 좁은 화면: 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
2026-11-05 Refine 46es split mount and hardware review model
    Include the existing assembly-tolerance changes, connect the split left mount, revise M3/M2 hardware and controller gate, and add review exports, CAD audits, purchase candidates, and local print plans. Keep manufacturing approval pending.
2026-11-05 Replace perimeter mount with six independent adapters
    Derive minimal v2 from the saved split model, preserve plate and hardware geometry, clear the USB envelope, retain the H02 shim support, and add review exports and CAD connectivity audits. Manufacturing approval remains pending.
2026-11-05 Add underside and mount fastening screenshots for minimal v2
2026-11-05 Merge left and right mount pairs with local connecting ribs
    Preserve v2 and all common plate and hardware bodies, join each side into one printable solid, retain central mounts and USB clearance, and add parametric link checks, independent volume verification, and v3 review exports.
2026-11-05 46es plate 보호·B 쿠폰 개정: 프레임 스탠드오프 X 장공, plate 틈 0.8, 쿠폰 행 C·D·보스 탭
    - plate를 기준 부품으로: 맞지 않을 수 있는 곳을 프레임·커버·조립 단계에서 흡수
    - 프레임 SO1·SO2·SO4·SO5 X 장공(편측 TBD_so_float 1, 포켓 7.77 × 5.0, 나사 구멍 3.3 × 5.3,
    보스 12 × 10), SO3·SO6 원형 기준. 흡수 X 1.45 / Y 0.6
    - plate 외곽 틈 TBD_plate_gap 0.3 → 0.8, 단차 안쪽 벽을 커버 기준으로(립 맞춤 0.3 유지, 상한 약 1.1)
    - 컨트롤러 브래킷 피처 7개를 PLATE_DRAFT_TBD 바로 뒤로(형상 같음, 틈 변경 시 재빌드 실패 해소)
    - README「plate 보호」절: 맞닿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
2026-11-05 46es manifest 갱신: inspection README 2개의 로컬 경로를 ~\Downloads로 바꾼 기록 재작성 반영
2026-11-05 46es split mount 재적용: fb884de의 폐기를 되돌리고 plate 보호는 변형 파일로 보존
    사용자(2026-11-05): split mount 폐기는 regression.
    - main의 split mount 계열을 모두 되살림: 46es_mount_split_v1 / minimal_v2 / side_pairs_v3(최신),
    parameters_*.csv, 보고서·구매 후보·시험안 문서, review STL/STEP, inspection data·scripts,
    원본 46es_draft_sketches.sc와 parameters.csv(2026-11-04 조립 여유 수정 판),
    assembly-revision.md "조립 여유 CAD 반영 결과" 원문, assembly-tolerance 보고서.
    - 브랜치 작업은 보존:
    - plate 보호 모델은 46es_draft_sketches_plate_protect.sc + parameters_plate_protect.csv(변형 파일)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
2026-11-05 46es 조립 가이드 생성기 추가: guide_v3.json + CAD 모델 → 정적 페이지
    - guide/build_guide.py: solidcraft-cli eval(바디·부피·매개변수·오류)과 snapshot(단계별 렌더 13장,
    보일 바디·카메라·단면을 spec에서 지정)으로 페이지를 만든다. 부품 표, 실측 칩·카드
    (measurements.csv), 문장 속 {{p:..}}/{{v:..}}/{{d:..}}/{{n:..}} 토큰, 푸터 수치는 자동.
    렌더는 모델 해시 + 설정 키로 .cache/에 캐시, --only/--skip-renders/--clean-img.
    - guide/guide_v3.json: split mount v3 기준 내용(조립 13단계, 맞춤 검토 10행, 열린 항목 12,
    국부 시험 7, 구매품, 정비, 결정 기록).
    - guide/assets/: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
2026-11-06 46es seam v4 + MJF PA12: 앞 이음 dovetail, 출력 세트 2회 주문, 얇은 벽 1.0 이상
    v4 모델(46es_mount_seam_v4.sc, v3는 그대로 둠):
    - 앞 이음: plate L 윗단 dovetail tab(2.4)이 plate R 윗면 포켓(+0.15)에 내려앉고 M2×5 1개 +
    너트(X 139.5, Y 6.6). spine 배선 홈 Y 49/64/72(3×2). 이음 쿠폰 L/R.
    - 재료 JLC3DP MJF PA12-HP 자연 회색(두 주문). MJF 최소 벽 1.0 기준 수정:
    - spine 뒤 패드 M2 카운터보어(SPINE_M2_3/4_HEAD)가 윗면 0.2를 남겨 나사머리가 들어가지
    않던 오류(split v1부터)를 돌출 2.6 → 4로 고침.
    - 이음 너트 포켓을 이음면 쪽으로 엶, 포켓↔커버 단차와 SO4 카운터보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
2026-11-06 46es 재료·색: plate·mount 검정 MJF PA12S-HP, 커버 투명 8001 레진 / r2 보유 하드웨어 정정
    - 재료·색(사용자 2026-11-06): MJF 부품 전부(plate, mount, spine, 브래킷, 게이트,
    B 쿠폰, 이음 쿠폰)는 JLC PA12S-HP 검정, 커버 L/T/R과 보스 탭은 8001 레진 투명.
    시험물은 대신하는 부품과 같은 재료·색. 모델·STL 변경 없음(레진 벽 >0.8, PA12S >1.0 통과).
    - 투명 커버 영향: 위 M3×4 흑색 합금강, 자석 흑색 코팅 우선, 자석은 투명 2액형 에폭시
    (순간접착제 백화), 받침은 보스 쪽에만 요청. 보고서 docs/color-material-2026-11-06.md,
    print_v4/README 표에 재료 열, guide_v4.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
2026-11-06 46es v5 2차: 두 단 커버(바닥 Z16.1 / 창 둘레 턱 Z19), 참고 키캡 착좌+6, B 쿠폰 행 C 1.7
    - 46es_mount_seam_v5.sc: 평판 Z18(테두리 +4)을 두 단으로. 바닥 16.1 = plate 13 + 자석 2 + 0.1 + 살 1.0
    (테두리 +2.1), 창 둘레 폭 1.5 턱 19.0 = 키캡 스커트 밑면 17.3 + 덮음 1.7 (테두리 +5.0). 한 스케치
    SK36_COVER_DROP_V5 + 영역 선택 컷 COVER_DROP_V5. 매개변수 213, 바디 115, 타임라인 450. v4 불변.
    1차 평판 모델·커버 STEP은 model/review_v5/flat_Z18/에 보존(--flat 옵션).
    - 검증: 커버 윗면 Z {16.1, 19.0}뿐, 커버 부피 9.29/8.65/10.16 cm³(1차 13.07/12.06/13.61), 최소 벽 1.0/1.098/1.0,
    키캡↔커버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
2026-11-06 46es 가이드: v5 판을 Pages v5/ 하위에 함께 게시, v4↔v5 상호 링크
2026-11-06 46es v5 3차: 안전마진(포켓 위 살 1.3 → 커버 바닥 Z 16.4), v5를 현행 설계로, 주문 2 세트 print_v5, 가이드 루트 v5
    - 사용자 결정(2026-11-06): 아직 주문 전 → v5가 현행 설계. r2 기준 유지, 의심되는 곳만 안전마진.
    - build_seam_v5: v5_legmag_skin 1.0 → 1.3(레진 벽 규칙 1.0 + 0.3) → 바닥 Z 16.1 → 16.4(테두리 +2.4), 턱 Z 19 그대로.
    DROP_MIN_HALF_WIDTH 1.0 → 1.5(폭 3.0 미만 갇힌 자리는 깎지 않음; 유일한 2.09 포켓은 커버 살 밖이라 형상 변화 없음).
    - 검증: verify_seam_v5 / verify_assembly_reference_v5 통과(기대값 16.4/2.4). 커버 9.94/9.25/10.78 cm³, 최소 벽 1.098,
    키캡↔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
2026-11-06 chore(46es): retire obsolete revisions and consolidate current v5 files
2026-11-06 Build visual 46es assembly instructions and r2 comparison
2026-11-06 fix(46es): flatten v5 covers and support the plates
2026-11-06 refine(46es): round the v5 mount bearing seats
2026-11-06 feat(46es): detail Pro Micro orientation in the assembly guide
2026-11-07 chore(46es): remove tracked .bak files, fix sample and static checks, regenerate manifest
    - 제거: 추적 중인 .bak 3건 (model/*.sc.bak), AGENTS.guide-r2.tmp 중복 임시 파일
    - inspection/scripts/read_sc_cache.py: spline/rationale_spline 커브 포인트 샘플링 지원
    - tools/check_repository.py: 캐시 없는 샘플 SC도 문서에서 바디 이름 추출해 정적 검사 통과
    - model/samples/46es_sw_hole_sample.sc: SMP_upper=1.7 mm, BOSS_TAB_SAMPLE 바디 선언 추가
    - manifest.json: 324개 파일 재생성 및 검증 완료
2026-11-07 docs(46es): simplify current markdown docs and refresh manifest
2026-11-07 feat(46es): phase 1 mount simplification - suppress 5 WEB features
    - Remove WEB from MOUNT_L_PAIR_V3 / MOUNT_R_PAIR_V3 (front T-shape simplification)
    - Remove WEB from MOUNT_H03_SO6_MIN_V2 front/bottom (2 features)
    - Remove WEB from MOUNT_H02_SO3_MIN_V2 rear/top
    - Regenerate CAD, exports, assembly reference, and manifest
    - Verification: ok=true, overlaps=0, contacts 49/59 (no interference)
    - Update docs/design.md and docs/validation.md
2026-11-07 feat(46es): phase 2 Ctrl bracket simplification
    - Suppress CTRL_LIP_F_LOW_SPLIT_V1, CTRL_LIP_F_UP_SPLIT_V1,
    CTRL_LIP_B_LOW_SPLIT_V1, CTRL_LIP_B_UP_SPLIT_V1 (bracket lips)
    - Suppress CTRL_STOP_SPLIT_V1 (bracket stop)
    - Suppress CTRL_GATE_STOP_FINGER (gate stop finger)
    - Simpler/straighter bracket/gate for Pro Micro insertion/removal
    - CTRL_BRACKET_SPLIT_V1 and CTRL_GATE_SPLIT_V1 removed from SAME_AS_V4
    - Rebuild CAD, export order2, verify: ok=true, overlaps=0, contacts=113
    - Assembly reference: ok=true, bracket_gate_overlap_count=0
    - Manifest OK (325 files)
    - check_repository.py: 미실행 (--trial sample file 파싱 오류, 사전 이슈)
2026-11-07 chore(46es): standardize guide review and print provenance
2026-11-07 Finalize Phase 1 mount redesign
2026-11-08 Refine Phase 1 mount standoff lands
    Regenerate the mount and assembly CAD, validate print geometry, and update the assembly guide for the six octagonal lands.
2026-11-09 46es 작업 방식 정렬: CLAUDE.md→AGENTS.md 단일 규칙, 결정 이력 표, 정리 전 태그, CI 의존성
    - 루트 CLAUDE.md: Claude도 46es/AGENTS.md를 유일한 작업 규칙으로 따르고, 시작 전 origin/main 확인,
    병행 작업은 브랜치 분리, 결정 번복은 decision: 접두어 + design.md 결정 이력에 기록
    - docs/design.md 「결정 이력」: 11-04~11-08 결정과 경위. 커버 평판화(7b252f3)는 두 단 커버·안전마진을
    되돌린 변경인데 경위가 없어 "경위 미기록"으로 표시(사용자 확인 필요)
    - 태그 46es-pre-cleanup-2026-11-06(=72d3ea1): 정리로 뺀 v1~v4 문서·print_v4·guide_v4.json 복구 지점.
    README·mo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
2026-11-09 46es design.md: 커버 평판화(7b252f3)를 사용자 결정으로 기록
    사용자 확인(2026-11-09): 평판 Z 19 커버는 r2 P4·P5 외관을 따른 의도된 결정. 두 단 커버·3차 안전마진은
    이 결정으로 폐기. 「경위 미기록」 표시 제거.
2026-11-09 46es 문서: 이력 재작성으로 바뀐 커밋 해시 참조 갱신
    작성자 신원 정리(filter-repo mailmap, 회사·개인 이메일 → zzskm noreply)로 Codex 라인 30커밋의 해시가
    바뀌었다. design.md 결정 이력, model/README, work-report의 참조 6개를 새 해시로 바꿨다.
    72d3ea1 계열과 태그 46es-pre-cleanup-2026-11-06은 불변.
2026-11-09 decision: 46es mount를 DXF 직접 돌출로 재구축, 레거시 피처 억제(평가 48→16 s)
    mount 4개를 v4 바디 위 패치(T자 레일·clip∩old·면적 필터 fill) 대신
    model/mounts_cadcraft_phase1.dxf의 외곽·받침·Rear shim을 tools/mounts_v5.py가
    직접 돌출하고, 체결부(Ø3.4 보어, AF 5.4 육각 포켓 Z 2–3, 장공 2.4, 머리 자리 4.4)는
    매개변수로, 핀 회피부는 키 배열에서 계산한다(좌 10·11, 우 18·33·46).
    - 패치 구조의 결함 해소: 우측 윗레일 폭 회귀, Front x≈155 0.3 mm 슬롯,
    Rear spine 받침 3.3→3.95 복원, 우측 두 번째 plate 받침 생성.
    - 팔각 랜드(AF 8.5) 둘레 홈(0.3 mm 링·1.5 mm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
2026-11-09 46es design.md: mount 재구축 결정 이력에 커밋 해시 기입
2026-11-09 decision: 46es Pro Micro 브래킷을 스냅 고정으로 재설계, 게이트·M2×5·너트 폐지
    v4 브래킷·게이트 사슬(CTRL_*·CTRL_GATE_*, plate 게이트 홈, REF_M2_GATE)을 억제하고
    tools/ctrl_v5.py가 브래킷·plate 나사 구멍·참고 M2를 직접 만든다. 7744368 뒤로 PCB를
    −Z·X로 잡는 형상이 없었고, 앞 M2 너트 보스가 배선 5번 패드 위에 있었다.
    - 고정: +X 끝 립(패드 열 사이, 크리스털 양옆 둘로 나눔)·끝 받침, USB 양옆 모서리 턱,
    Y로 휘는 탄성 암 2개(X 9.0, 두께 1.0, 립 45° 경사, 걸림 0.4). 레일이 과변형 멈춤(간격 1.0).
    삽입 변형률 1.75 %, 멈춤 1.85 %(외팔보 계산,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
2026-11-09 46es design.md: 스냅 브래킷 결정 이력에 커밋 해시 기입
2026-11-09 46es AGENTS.md: 메모리에만 있던 규칙 이동, Windows 인코딩·줄바꿈 안내
    CLAUDE.md는 규칙을 AGENTS.md 한 곳에 두게 하지만, 일부가 Claude 메모리에만 있어
    Codex는 알 수 없었다.
    - §3: 원본 자료(cad/·firmware/·images/) 덮어쓰기 금지, 재배포 조건 미확인 외부 모델
    커밋 금지.
    - §5: plate는 기준 부품(사용자 결정 2026-11-05). 끼움 오차는 mount·커버·브래킷·구매품과
    조립 보정으로 흡수하고 plate 재출력으로 풀지 않는다.
    - §10: Windows에서 PYTHONUTF8=1(cp949 출력 오류), 스크립트 편집 시 LF 유지. 생성기·검사가
    작업 트리 원본 해시(generator_sha 등)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
2026-11-09 46es 가이드: 조립 그림(배선·핀·스냅·자석·시험·키캡) 추가, 전기 시험 단계, 원커맨드 게시
    - guide/diagrams.py: 생성 소스(ctrl_v5·make_key_dxf·mounts_v5·matrix_v5.json)에서 SVG 13장을
    만든다. 아랫면 배선 지도(행·열·mount 자리·spine 홈), Pro Micro 양면 핀 지도, 다이오드 방향,
    스냅 끼우기·빼기 4장, 자석 극성 3장, 46키 시험 격자, 키캡 폭. 펌웨어 키 순서·폭·컨트롤러
    위치가 CAD와 어긋나면 빌드가 멈춘다. Esc·Tab 순서는 미확정으로 표시.
    - 인터랙티브 단계와 정적 문서에 그림 표시(옛 컨트롤러 양면 PNG 대체). 입체 버튼 추가로
    시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
2026-11-09 46es 정리: 역사 문서·초기 스케치 모델·지그 A·옛 쿠폰 출력 제거, 근거는 현행 문서로 이동
    AGENTS §7 기준으로 현재 역할이 없는 파일 23개를 뺐다(태그 46es-pre-cleanup-2026-11-09 = 5e62a0a).
    - docs: planning.md, assembly-revision.md, mount-redesign-plan.md(+평면도 PNG·plot_mount_outlines.py),
    work-report-2026-11-04.md, assembly-tolerance-2026-11-04.md(+검사 JSON, model의 렌더 2장)
    - model: 46es_draft_sketches.sc, parameters.csv(어느 코드도 읽지 않음, v5가 대체), jigs/(지그 A, 미출력),
    samples의 옛 B 쿠폰 STL/STEP·렌더(주문 1 쿠폰은 export_print_v5 --trial이 .sc에서 내보냄)
    - inspection/derived: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
2026-11-09 46es plate 뒤 다리: PSD60 뒤 벽 보스 3곳에 얹힘, 부품 병합 후보 폐기
    PSD60 Defender 뒤 벽 안쪽의 반원 보스 4개(사용자 제공 제품 사진)를 plate
    뒤 가장자리 받침으로 쓴다.
    - 보스 위치: 사진을 H01–H06으로 사영 보정해 X 36.0·113.6·170.1·245.8,
    지름 약 9로 추정(잔차 ≤ 0.8, 기준점 하나씩 빼면 ±2–4). 윗면은 지지대와
    같은 Z 0으로 가정(r2 P0가 노치 없이 지남). 실측 M22 미측정.
    - plate 뒤 플랜지를 ①②③ 위에서 길이 14 다리로 Z 0.5까지 내림
    (L X 30–44·106–120, R X 163–177). 틈 0.5는 시험 조립에서 패드로 메운다.
    보스 위치가 ±2 틀려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
2026-11-09 46es design.md: 뒤 다리 결정 이력에 커밋 해시 기입
2026-11-09 docs(46es): plan cover and plate joint improvements
2026-11-09 v5 커버 창 단순화 및 높이 Z18.5 시험
    - 커버 창 윤곽을 개별 키 마진 그룹에서 실루엣 통합 윤곽으로 단순화 (make_key_dxf.py::silhouette_polys 로직 사용)
    - v5_skirt_cover_H 1.7 → 1.2로 변경하여 커버 상면 Z19 → Z18.5 (검증.md 1단계 계획)
    - 새 파라미터 추가: v5_cover_silhouette_cell/close_r/fill_L/min_rail/res
    - 커버 두께 6.0 → 5.5 mm, 상단 레벨 단일 평면 Z18.5 유지
    - CAD 검증 통과 (verify_seam_v5.py, verify_assembly_reference_v5.py)
2026-11-09 검증 결과 JSON 및 manifest 갱신 (커버 창 단순화 반영)
2026-11-10 46es: manifest.json 폐지, 결정 이력 커밋 칸을 decision: 제목으로
    - manifest.json·update_manifest.py·CI 단계 삭제 (improvement-plan 1-1, 사용자 결정 2)
    - AGENTS.md §10, README, validation.md, model/README의 manifest 절차 제거
    - 결정 이력 커밋 칸은 해시 대신 decision: 커밋 제목 (1-4, 사용자 결정 3). 기존 행은 그대로
2026-11-10 docs(46es): 작업 방식 개선 계획 추가 (임시, 완료 후 삭제)
2026-11-10 decision: 46es 커버 실루엣 창 채택, 높이 Z 19 유지
    improvement-plan 0-1·0-2. 7b3c569가 생성기만 바꿔 main의 생성기와 CAD가 어긋났던 것을 복구한다.
    형상 (커버 3조각만):
    - 사용자 결정 2026-11-10: 실루엣 창만 채택, 윗면 Z 19·두께 6 유지 (v5_skirt_cover_H 1.2 -> 1.7)
    - 셀 16은 키캡 간격 0.31(요구 1.0)이라 사용자 선택으로 셀 20.35, 실제 키캡 폭(w_u) 기준
    (r2 칸 폭이면 19번 창이 오른쪽 립을 잘라 0.28 살), 외곽 살 1.6 -> 1.1, 다리 자석 포켓과 1.15
    - 키캡 간격 쉴 때·눌림 1.021, 커버 최소 벽 1.059-1.098, 다리 자석 벽 1.137
    - plate·spine·브래킷·주문 1 STL/STEP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
2026-11-10 docs(46es): 개선 계획 진행 상황 (순서 1·2 완료)
2026-11-10 46es: 공통 모듈, 결정적 검증 JSON, 마무리 명령, CI 스모크 (계획 1-2·1-3·1-5·1-6)
    - tools/common.py: ROOT, CLI(SOLIDCRAFT_CLI → 기본 경로), sha(), LF write_json(), stdout UTF-8.
    생성기·내보내기·검증·조립 검토·정적 검사·가이드가 사용 (CLI 경로 7곳, sha 9곳).
    - verify_seam_v5: changed_params를 정렬해 다시 실행해도 같은 바이트. 검증 JSON 2회 실행 동일 확인.
    - build_seam_v5 --refresh-record: 형상이 그대로인 정리 뒤 캐시에 다시 빌드해 커밋된 CAD와 문서·바디 67개가
    같을 때만 생성 기록 지문을 갱신(CAD 바이트·하위 기록 유지). 이번 변경에 적용.
    - tools/fini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
2026-11-10 docs(46es): 공통 모듈·finish.py·smoke_test·--refresh-record 절차 반영
2026-11-10 46es: 스냅 시험편 A·C 분리 모델, review_v5 폐지 (계획 3-3·3-5)
    - build_seam_v5.py가 시험편 A·C를 model/ctrl_trials_v5.sc(매개변수만 남긴 소형 문서)로 따로
    만들고, 매개변수 CSV도 빌드에서 내보낸다. 생성 기록에 trials_output_sha 추가.
    - export_print_v5.py --trial은 A·C를 새 모델에서 내보낸다. 주문 1·2 STL/STEP와 CSV는 바이트 동일,
    기록은 source_sha256만 바뀜.
    - model/review_v5/, export_seam_v5_review.py, seam-v5-exports.json, seam-v5-thin-wall.json 삭제.
    verify_seam_v5.py는 주문 2 기록으로 커버·plate를 검사한다.
    - 검토 모델에는 시험편을 함께 넣는다(trials_sha 기록). 검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
2026-11-10 docs(46es): 시험편 분리 모델·review_v5 폐지 반영
    model/README 표에 ctrl_trials_v5.sc·seam_v5_build.json, AGENTS.md §9·§10과 validation.md에서
    review_v5와 검토 내보내기 명령 삭제, 가이드의 review_v5 참조를 검토 모델로 바꿈.
2026-11-10 46es: 파이프라인 진입점, 단계별 시간, 검증기 지문, pre-commit 훅 (계획 2-1·2-2·2-3·2-5)
    - tools/pipeline.py: seam → order2 → order1 → verify_seam → assembly → verify_assembly → review.
    --status는 커밋된 기록으로 낡은 단계와 이유를 보이고(SolidCraft 불필요, 약 1 s), --run은 낡은
    단계만 순서대로, --from/--only 지원. 실행 시간은 46es/.cache/pipeline-timings.json에 쌓는다.
    - 입력 지문 함수를 common.fingerprint로 옮기고 build_seam_v5.stale_reasons()를 정적 검사와
    공유한다. 생성 기록은 --refresh-record로만 갱신(바디 67개 동일, CAD 유지).
    - 두 검증 기록에 inputs(검증기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
2026-11-10 docs(46es): 명령 목록을 validation.md 한 곳으로, 파이프라인·훅·병행 규칙 (계획 2-4, 단계 5)
    validation.md 「재생성」에 pipeline.py와 단계별 명령·낡음 판정을 두고 AGENTS.md §10, README,
    model/README, guide/README는 그곳을 가리킨다. AGENTS.md에 core.hooksPath 안내와 §8 병행 규칙 두 줄
    (시험 변경은 브랜치, 생성물은 손으로 병합하지 않고 다시 생성)을 넣었다. 계획 진행 기록 갱신.
2026-11-10 46es: 빌드 한 번 평가, --ctrl 부분 빌드, 평가 캐시 통합·--clean (계획 3-1·3-2·3-7)
    - build_seam_v5.evaluate(): run --save 뒤 eval을 다시 돌리지 않고 eval + file.save_as 한 번으로 저장과
    측정을 함께 받는다(시험편 모델 12.8 s → 5.9 s, 전체 빌드 약 100 s → 77 s, --refresh-record로 바디
    67개 동일 확인). 측정은 공유 평가 캐시에 넣어 뒤 단계가 다시 평가하지 않는다.
    - --ctrl: 브래킷 B와 시험편 A·C만 매개변수 문서에서 만들어 금지 영역·부피 추정과 비교(약 20 s).
    커버 단독 빌드는 커버가 v4 타임라인에서 나오므로 4-5로 미룬다.
    - cad_eval_cache: 파일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
2026-11-10 docs(46es): --ctrl·--clean·평가 캐시 위치, 계획 진행(순서 6)
2026-11-10 46es: 부품 레지스트리, 내보내기 CLI 통합, 바디 형상 지문 무효화 (계획 4-1·3-6·3-4)
    - tools/parts_v5.py: 출력 부품 18행(주문·파일·바디·원본 CAD·재료·벽 한계·뒤집기) 한 표.
    export_print_v5.py, pipeline.py, check_repository.py, verify_seam_v5.py가 읽고, 정적 검사가
    guide_v5.json 출력 부품 표(바디·「주문 N」·STL 방향)를 이 표와 대조한다.
    - 3-6: 빌드가 저장하는 같은 CLI 호출에서 매개변수 CSV와 두 주문의 STL/STEP을 내보낸다
    (.cache/v5/export/, 저장 해시로 유효). 내보내기는 두 주문을 원본 CAD당 한 번의 run으로 처리하고
    --timings --profile을 .cache/pri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
2026-11-10 docs(46es): 부품 표·내보내기 통합·형상 지문 무효화 반영, 계획 진행(순서 7)
2026-11-10 46es: v4 원본 대신 v5 기반 타임라인, 형상 지문 기준으로 검증 (v5 정본화 1단계, 계획 4-3·4-2 일부)
    - model/seam_v5_base.json(새 생성기 입력): v4 원본 기능 428개 중 빌드가 평가하던 기능과
    검토 모델이 다시 켜는 참조 기능 206개. 억제된 v4 mount·브래킷 사슬, 쓰지 않는 스케치 8개,
    치수 98개, 없는 바디의 외관·숨김 항목을 뺐고, 생성기가 매번 v4 문서에 하던 고정 변경
    (TBD_upper_plate_T 1.7, TBD_cover_T 식, 스위치 외피 242–244 착좌 추종)을 넣었다.
    매개변수·기능 한 줄에 하나. 매개변수 v4_plate_top_Z -> plate_top_Z.
    - build_seam_v5.py: strip_legacy·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
2026-11-10 docs(46es): 기반 타임라인·형상 기준 반영, model/baselines 삭제, 계획 진행(순서 10)
    - README·model/README·design.md·validation.md: 편집 원본에 model/seam_v5_base.json,
    검증 기준 inspection/data/seam-v5-baseline.json과 verify_seam_v5.py --accept 절차.
    - AGENTS.md §5: 형상 기준은 --accept로만 바꾸고 차이를 커밋 메시지에 적는다.
    - improvement-plan.md: §4 사용자 결정 6(v5 정본화, 2026-11-10), 진행 갱신.
    - model/baselines/(seam_v4.sc, flat_Z18.sc, 18 MB) 삭제. 더는 읽는 코드가 없고, 같은 내용이
    태그 46es-pre-cleanup-2026-11-09에 있다.
2026-11-10 46es: 검증기의 현재 값 리터럴을 형상 기준의 매개변수 값으로 (계획 4-2 나머지)
    - seam-v5-baseline.json에 values(설계 매개변수의 평가값, 각도는 deg)를 더했다. 다른 매개변수를 거쳐
    바뀌는 값(커버 두께, 키캡 착좌 Z)도 --accept 차이에 나온다.
    - verify_seam_v5.py: 커버 T 6, 윗면 Z 19, 자석 위 두께 3.9, 키캡 Z 17.3 리터럴 검사 삭제(기준 values가 고정).
    커버 벽 한계는 parts_v5.WALL_SCAN에서 읽는다.
    - verify_assembly_reference_v5.py: 림 높이 14·돌출 5.0 리터럴 대신 매개변수. PSD60 실측값 검사는 산 부품이라 유지.
    - check_repository.py: CSV value 열을 기준 valu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
2026-11-10 46es: 문서 수치 대조(print_v5 부품 표·design.md 현행 치수), 가이드 {{l:BODY}} 토큰 (계획 4-4)
    - check_repository.py: model/print_v5/README.md 주문 1·2 표의 파일 목록·재료·크기(적힌 자릿수까지)와
    주문 2 부피·최소 벽을 출력 기록·벽 검사와, design.md 「현행 치수」 13행의 수치를 형상 기준 values와 대조
    (34개 식, 외곽은 plate 두 조각의 상자). 첫 실행에서 주문 2 브래킷 부피 1.64(실제 1.568) 하나를 찾았다.
    - build_guide.py: {{l:BODY}} = 바디 평면(X/Y) 최대 길이(소수 1자리).
2026-11-10 docs(46es): 문서 수치 대조 반영, 가이드 낡은 수치 4곳, 계획 진행(순서 11)
    - print_v5/README.md: 주문 2 브래킷 부피 1.64 → 1.57(스냅 재설계 뒤 갱신 누락, 새 검사가 찾음).
    - guide_v5.json: 커버 「v5 두께 5」 → {{p:TBD_cover_T}}(6). 위 다리 끝 폭 2.7–3.6·약 25 mm → 실루엣 창
    기준 실측(주문 2 커버 STL 단면 Z 0.5) 2.5–2.8·약 23 mm. 「이음면에서 창 끝까지 약 6.5」 → 앞 이음 tab
    끝(X 142.9)에서 앞 모서리부터 창까지 약 8(창 윤곽 실측 7.9). 앞 mount 69.8 → {{l:MOUNT_H03_SO6_MIN_V2}}(68.6).
    - guide/README.md 토큰 목록, validation.md 정적 검사 설명, improvement-plan.md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
2026-11-10 46es: 커버 3조각·spine을 기반 타임라인에서 생성 코드로 (계획 4-5 2단계)
    tools/cover_v5.py, tools/spine_v5.py가 기반의 피처를 같은 순서·식으로 기반 타임라인 뒤에 만든다.
    seam_v5_base.json에서 42개 피처 제거(SPINE_M2_1/2_CLEAR는 plate 절삭만 남기고 spine 쪽은 코드).
    커버 분할 절삭의 이름 순서가 위치에 따라 바뀌어(T,R → R,T) cover_v5.check가 조각별 X 범위를 확인한다.
    형상: 65개 바디 BRep 동일(probe 대조), 형상 기준 67개 일치, 주문 1·2 STL/STEP 변경 없음,
    가이드 렌더 다시 찍은 것 0. CAD·검토 모델 바이트와 기록의 source 해시만 바뀜.
    seam-v5-clearan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
2026-11-10 46es: print_v5/README.md 부품 표 측정 칸을 기록에서 생성 (계획 4-4 다음 단계)
    tools/doc_tables.py가 크기·주문 2 부피·최소 벽·(cm³) 메모를 기록에서 쓰고(--write), check_repository가
    같은 함수로 낡은 칸을 막는다. 첫 실행: 값은 모두 일치, 표기만 6칸(25.60 → 25.6, spine 1.7 → 1.69 등).
2026-11-10 46es: 준비 시간 캐시와 커버 부분 빌드 --covers (계획 3-8, 3-2 나머지)
    - ctrl_v5.check: keep-out 목록을 프리즘마다 다시 만들던 것을 한 번으로(1.85 s → 0.1 s, 빌드당 4회).
    - 실루엣 창: 키 배치·상수·관련 함수 소스·라이브러리 버전 해시로 .cache/v5/prep에 캐시(2.5–4.5 s → 0.03 s).
    - --covers: 매개변수만 남긴 문서에 커버 3조각과 창·다리 자석 절삭만 생성(약 9 s, 평가 1.6 s).
    윗면·조각 범위·자석 살을 검사하고 생산 CAD와 BRep 동일 여부를 보고한다(첫 실행 세 조각 모두 동일).
    - build()의 커버 매개변수·절삭을 cover_params / emit_cover_cuts / emit_c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
2026-11-10 docs(46es): 커버·spine 생성 코드, --covers, 준비 캐시, 부품 표 생성 반영, 계획 진행(순서 12)
2026-11-10 46es: 생성 CAD .sc 3개를 Git LFS로 (계획 4-6)
    - 46es/.gitattributes: model/*.sc(현행·조립 검토·시험편)를 LFS로. 재생성마다 약 18 MB 쌓이던 blob을 막는다.
    이전 커밋은 일반 blob 그대로(이력 재작성 없음, 계획 §5). 작업 트리 바이트는 같다(sha256 확인).
    - .githooks/: core.hooksPath가 .git/hooks를 가리지 않도록 LFS 훅 4개(pre-push 등), 루트 .gitattributes에 eol=lf.
    - check_repository.py: LFS 포인터로 받은 .sc를 만나면 git lfs pull을 안내하며 멈춘다.
    - CI: LFS 객체를 id로 캐시하고 git lfs pull.
    - AGENTS.md §10, validation.md, model/README.md에 LFS 필요 사항.
    형상·출력물 변화 없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
2026-11-10 46es: 참조 하드웨어를 기반 타임라인에서 생성 코드로, 겹침 나사 사슬 삭제 (계획 4-5 3단계)
    - tools/hardware_v5.py: REF_M2_PLATE_3..6(나사·너트), REF_SO1..6(M3 위·아래, 자석), REF_CASE_H01..06 62개 피처.
    기반과 같은 순서·식·좌표(비트 단위 동일 확인)로 기반 타임라인 뒤에 만든다. 너트 스케치 4개는 기반처럼 보이게 둔다.
    - seam_v5_base.json: 위 62개와, REF_M2_LAP_1..4를 만들었다가 MIN_V2_REMOVE_RING_AND_LAP_HARDWARE로 지우던
    21개를 뺐다(164 → 81). hidden_bodies에서 LAP 이름 8개 삭제.
    - 재생성: 65개 바디 BRep 동일, 주문 1·2 STL/STEP 바이트 동일(내보내기 0),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
2026-11-10 docs(46es): 작업 방식 개선 계획 종료, plate 생성 코드 전환은 validation.md로
    계획 항목은 4-5의 plate만 남았다. 형상을 바꾸지 않고는 옮길 수 없어(주문 1 출력물 불변 조건)
    주문 1 결과로 plate를 고칠 때 함께 하므로 형상 계획(validation.md 「채택 및 반영」)으로 옮기고
    임시 계획 파일을 지운다(AGENTS.md §7). 코드 주석의 plan 번호는 design.md에 찾는 법을 적었다.
2026-11-10 decision: 46es plate 뒤 다리를 별도 받침 블록으로, plate 출력 support 제거
    plate 뒤 플랜지에 붙여 내렸던 다리 3개(9bacd26)를 plate에서 떼고, 같은 자리의
    별도 받침 블록 3개(REAR_REST_1..3_V5, 14 x 4 x 4.5)로 바꿨다. 블록은 케이스 뒤 벽
    보스 1-3 위에 점착 패드(공칭 틈 0.5)로 붙이고 plate 뒤 플랜지 밑면(Z 5)이 얹힌다.
    사용자 보고(2026-11-10): 다리를 넣은 뒤 plate 출력에 support가 필요해짐.
    plate L/R은 다리 추가 전 형상으로 돌아가 출력 높이 12.5 -> 8.
    주문 1에 블록 3종(높이 4.2 / 4.5 / 4.8)을 넣었다(변형 2개는 ctrl_trials_v5.sc).
    기준 차이(verify_seam_v5.py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
2026-11-10 decision: 46es plate 앞 이음을 곧은 반턱과 닫힌 너트 포켓으로, 이음 쿠폰 3쌍
    plate L/R 앞 이음을 다시 설계했다(validation.md 「plate L/R 앞 이음 및 하중 경로」의 출발안).
    - dovetail tab -> 위에서 얹는 곧은 반턱 + 끝 걸림 턱. tab X 136.3-147.4, 옆면 Y 3.0/10.2,
    턱은 X 144.2부터 +Y로 2.4. 위치결정 여유 편측 0.15, tab 끝 0.3.
    - M2 (139.5, 6.6) -> (140.4, 6.6). 머리 카운터보어 둘레 벽 1.4, 머리 아래 살 1.2.
    - 너트: 이음면 쪽이 열린 포켓(맞변 4.4, 깊이 1.0) -> 닫힌 눌러 끼움 포켓(맞변 4.0, 깊이 1.3).
    이음면 쪽 벽 1.27, 포켓 위 살 1.3. 측면 삽입 슬롯은 R 바닥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
2026-11-10 46es: 커버 L 윗면에 이름 46es 음각
    커버 왼쪽 조각 윗면(왼쪽 블록 위쪽, X 5.6-16.5 / Y 38.9-42.1)에 이름을
    깊이 1.0으로 음각한다(관통 없음). 글자는 tools/cover_pattern_v5.py가 직선으로
    그리는 각진 단일 획이다: 높이 2.8, 글자 폭 1.5, 간격 1.5, 획 0.4,
    막대 사이 살 1.0(레진 벽 기준과 같음). 위치·크기·글자체는 사용자가 미리보기로
    정했다(2026-11-10). 면을 채우는 무늬(hex, 헤링본)와 T 핀스트라이프는
    미리보기 뒤 채택하지 않았다. 경위는 docs/design.md.
    생성기와 검증은 커버 윗면 높이가 Z 19와 음각 바닥 Z 18뿐이고 바닥 면적이
    계산한 글자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
2026-11-10 46es: 가이드 3D 뷰어 개선, 작업 부품 중심 맞춤·작은 부품 고리·외곽선·그림자·크게 보기
    - 단계 시점을 이번 작업 부품 기준으로 맞춤(주변은 전체의 절반까지만), 화면 맞춤을
    bbox 대각선 대신 투영한 꼭짓점 기준으로 바꿔 빈 여백 축소
    - 14 mm 이하 instance로만 된 부품(나사·너트·자석·지지대·받침 블록)은 작업 대상일 때
    위치 고리 표시. instance는 빌드가 CAD body bbox로 묶음(assembly.py instances)
    - 부품 외곽선, 바닥 그림자, 톤 매핑·조명 정리, 고스트 위계(작업 > 주변 > 하우징),
    모든 부품이 작업 대상인 단계는 원래 색 유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
2026-11-10 46es: 가이드 3D 단면 보기, 단계별 확인 단면·겹친 자석 이중 고리·세로 화면 맞춤
    - 단면: x/y 평면으로 자르고 잘린 면은 뒷면 빗금으로 표시. 카메라 쪽 절반을 지우고 아래 시점 단계는 아래에서 본다.
    - 단계 기본 단면은 assembly_v5.json section(axis, through=CAD body, note)이며 빌드가 body 중심으로 위치를 정한다(9단계).
    - instances가 겹친 body 수를 세 번째 값으로 남겨 다리 자석 쌍을 이중 고리와 '2개 겹침'으로 표시.
    - 세로(portrait) 캔버스는 작업 부품 주변 여백을 줄여 맞춤. review_guide.py --views section 추가.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
2026-11-10 46es: 가이드 3D 모델을 압축 GLB 하나로, 불러오기 진행률 표시
    - 빌드가 조각별 STL 51개(33 MB)를 models/assembly.glb 하나(9 MB)로 묶는다(glb.py):
    같은 정점 합치기, 메시 상자 안 uint16 좌표(KHR_mesh_quantization), 법선 없음.
    Pages가 .glb를 gzip으로 보내 실제 전송은 약 3.5 MB. 좌표 오차 0.003 mm 미만.
    - r2 비교 메시도 models/r2.glb로 묶는다. 게시본에 STL은 남지 않는다(빌드 캐시에만).
    - 뷰어는 GLTFLoader(three 0.180.0 vendored)로 읽고 면 법선을 다시 계산해 전과 같은 화면.
    2D 조립도도 같은 GLB를 읽는다(게시본과 픽셀 평균 차 0.01 이하).
    - 3D 여는 동안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
2026-11-10 46es: 가이드 3D 기본 열기, 폰에서 3D 위 세로 스크롤, UI 미리보기 매개변수 복구
    - 조립서가 화면 가까이 오면 3D가 저절로 열린다(받는 동안 2D 유지, 실패 시 2D).
    조립도로 돌아가기를 누르면 그 브라우저는 다음에도 2D, 3D로 보기를 누르면 해제.
    데이터 절약(saveData, prefers-reduced-data)이면 열지 않는다.
    - OrbitControls가 캔버스에 touch-action none을 넣어 폰에서 3D 위(높이 300~470px)를
    세로로 밀어도 페이지가 스크롤되지 않던 문제: 캔버스를 pan-y로(가로 밀기=회전,
    크게 보기·비교 화면은 바깥 none이 우선해 자유 회전 그대로).
    - preview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
2026-11-10 46es: B 쿠폰·보스 탭을 생성기로, plate·커버 현행 치수를 따르게
    손으로 만든 model/samples/46es_sw_hole_sample.sc를 tools/coupon_v5.py로 옮겼다.
    두 바디는 model/ctrl_trials_v5.sc에 매개변수 식(SMP_*)으로 생성된다.
    - B 쿠폰 두께 10 → TBD_plate_T 5. 10은 JLC3DP FDM 최소 크기(30×30×10)였고
    MJF·SLA는 5×5×5 / 10×2×2다. 행 C 아래 개방이 6.8 → 1.8로 plate와 같아졌고
    부피는 55.74 → 28.31 cm³.
    - 범위를 설계값 중심으로: 카운터보어 6.0/6.2/6.4 → 5.8/6.0/6.2, 육각 포켓
    4.8–5.4 × 1.5 → 5.2–5.8 × 1.0(mount 포켓 깊이), M3 관통 아래 Ø3.3 → Ø3.4.
    - 행 D에 plate 다리 자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
2026-11-11 decision: 46es 커버 로고를 Xifiction 폰트 kb46es/26으로
    커버 L 왼쪽 블록 위쪽 로고를 각진 단일 획 `46es`(높이 2.8, 살 1.0)에서
    Xifiction 폰트(dafont, Nowak.tv, Free for personal use) `kb46es/26`으로
    바꿨다. 같은 자리(사용자: "A로 하는데 크기 줄여줘"), 글자 칸 높이 2.0,
    폭 15.5, 획 0.5, 글자 안 틈·글자 사이 살 0.25.
    - 폰트 파일은 커밋하지 않고 쓰는 글자 7개의 윤곽만
    tools/cover_logo_xifiction.json에 둔다(cover_pattern_v5.py --font로 재생성).
    - 보스 탭 시험 음각: 실제 크기(X1) + 1.6배(X1_6, 획 0.8·살 0.4). 옛 X2(2배)는
    31 mm라 탭에 들어가지 않음.
    - thin_wall_scan.py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
2026-11-11 decision: 46es 커버 분할을 실루엣 창으로, r2 P4 분할 윤곽 폐지
    커버 L/T/R를 나누는 절삭을 r2 P4 창 윤곽(cover_v5.SPLIT_CUTS)에서 실루엣 창
    (build_seam_v5.cover_windows())으로 바꿨다. 두 윤곽이 최대 2.3 mm 어긋나 PgUp·PgDn
    모서리 계단, 왼쪽 Ctrl(20) 옆 X 19–23 홈, E·I 위 조각 끝 꺾임이 생기던 것을 없앤다.
    - 분할 띠: 9·31번 위(뒤 테두리), 22·40번 아래(앞 테두리)에서 그 키 창 폭 그대로
    곧게 끊는다(COVER_SPLITS). 조각 끝이 키 창 옆선과 한 직선.
    - 윤곽 정리(COVER_CLEAN, clean_outline): 0.6 mm 이하 꺾임, 2.5 mm 이하 짧은 모서리,
    1.5 mm 이하 평행 계단을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
2026-11-11 decision: 46es spine을 Rear mount 프레임에 직접 얹고 Rear spine shim 받침 폐지
    사용자 요청(2026-11-11): spine과 center mount(Rear, H02·SO3)의 접점을 늘리도록
    spine 두께를 조정하고 center mount의 지지대(spine shim 받침)를 제거.
    - spine 줄기 밑면 split_spine_bottom_Z 4 -> 3.05 (= TBD_frame_T + split_support_gap),
    두께 4.5 -> 5.45. Rear 프레임 윗면 Z 3에 틈 0.05로 얹혀 접촉 24 -> 116 mm2.
    - H02 케이스 나사머리(팬헤드 1.3 가정, 윗면 Z 3.3) 위는 옛 밑면 Z 4로 회피
    (SPINE_H02_HEAD_RELIEF, 장공 +-1 포함). 머리와 수평 0.60 / 수직 0.70.
    - 배선 홈 윗면 Z 6 유지: spine_wire_H 2 -> 2.95 (프레임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
2026-11-11 46es: spine 받침 폐지 후속 정리(가이드 문구, 미사용 매개변수, 나사머리 높이 참조)
    - 가이드: "중앙 받침 틈"·"중앙 shim" 문구를 spine 밑면–Rear 프레임 틈 기준으로
    - 기반 매개변수 split_support_size(옛 mount 받침 6x6) 삭제: 쓰는 곳 없음
    - spine_v5.check(): 나사머리 높이를 hardware_v5.CASE_HEAD_H에서 읽고 여유 0.5 이상 확인
    verify_seam_v5.py --accept 차이: param/value removed split_support_size (6 mm)뿐.
    출력 STL/STEP 바이트 불변.
2026-11-11 decision: 46es M2 나사를 ISO 7380 버튼헤드로, 앞 이음 머리 자리 1.4
    구하기 쉬운 부품 기준(사용자 요청). 저두 NBK SSH-M2-5/6(Ø4 × 1.1)은 전문품이라
    M2 7개를 ISO 7380 버튼헤드(Ø3.5–3.8 × 1.3)로 바꾼다.
    - 앞 이음 머리 카운터보어 1.2 → 1.4: 머리 윗면 Z 12.9 유지, 머리 아래 tab 살 1.0.
    seam_v5.check가 머리 윗면 ≤ plate 윗면 − 0.1을 확인. 대조군 S0는 v4 1.2 유지.
    - spine·브래킷 자리(Z 10.2)는 형상 그대로, 참조 나사 머리만 Ø3.8 × 1.3.
    - 구매품 표·가이드를 알리 일반품 기준으로: 지지대 맞변 5 확인, 위 M3 흑색 합금강
    (black stainless 불가), 자석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
2026-11-11 46sp: restore r3 CAD and prototype split internals
2026-11-11 46sp: record prototype assembly and wiring decisions
2026-11-11 46sp: correct project scope to 3D printed migration
2026-11-11 docs: record insert dimensions and fastener labels
2026-11-11 docs: record 3x14 hex insert stock
2026-11-11 docs: record black and countersunk bolts on hand
2026-11-12 decision: 46es SO 지지대를 보유 M3 인서트 보스로, 위 나사를 보유 M3×10으로
    사용자 요청(2026-11-12): 보유한 재고 부품을 최대한 활용하도록 수정.
    보유 육각품(3×10·3×14 표기, 맞변 5)은 길이가 Z 2–8에 맞지 않고, 보유 흑색
    볼트(M3×10)는 지지대 구조에서 아래 나사와 부딪혀 쓸 수 없었다. 인서트 보스안을
    사용자가 선택.
    - mount 4개: SO1–SO6 육각 포켓(AF 5.4 × 1) 삭제, Ø8 보스(Z 1.5–8)에 인서트
    구멍 Ø4.2 × 5(아래 M3 관통 Ø3.4 유지). SO4 보스는 plate 뒤 플랜지에서 0.3
    안쪽으로 잘림(구멍 둘레 살 1.56, 나머지 1.9). 핀 회피부 윤곽은 그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
2026-11-12 docs: use stock inserts and M3x10 for 46es, reuse old controller
    46es SO 체결을 보유 원형 황동 M3 인서트 6개와 흑철색 M3×10 6개로 바꾼 결정을
    구매 목록에 반영: 황동 지지대·M3×4·M3×5 구매 항목 삭제, 46es 보유품 표 추가,
    Pro Micro는 기존 키보드에서 분해한 컨트롤러 재사용(구매 안 함), 46sp 몫 인서트
    14개·M3×10 94개로 정정.
2026-11-12 46sp: plan 46 keys and port the 46es keymap by physical position
    The "46 keys" came from the 46es keymap, whose rows are wiring rows
    (4 x 12). The r3 plate has 45 openings and the assembly drawing 44.
    The user chose to go ahead with 46 keys, laid out like 46es: left
    6/6/5 + 3 thumbs, right 7/7/5 + 3 thumbs + cross. The right-side
    width will be re-checked against the real case.
    - keyboard.json: drop the left row-3 outer key, add a 7th key to right
    rows 1-2; columns follow physical columns
    - keymap.c: the four 46es layers placed by physical position (checked
    key by key against 46es_kbfirmware.json); not compiled here (no QMK)
    - README/TODO/PURCHASE: key layout section, 92 diodes
    Co-Autho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
2026-11-12 46sp: add the MJF print model (plate and case per half) and its generator
    46sp/tools/build_print.py builds 46sp/model/46sp-print.sc from the r3
    DXF. The plate copies the row cross-sections of the r3 cheek slot
    (+22.5 / +6.07 / -8.19 / -22.5 deg) as one 5 mm bent band per half,
    with 14.0 holes, a 1.5 latch layer and 16.5 reliefs, laid out for 46
    keys (cross on rows 3/4). The case is a 2 mm tray whose walls follow
    the plate underside. Six vertical plate legs per half hold the stock
    D5x4 inserts; stock M3x10 go up through floor pads. RP2040-Zero
    cradle, back USB-C opening and an AUX jack hole in the inner wall.
    Checks in the generator: 4 closed bodies, plate volume within 0.02 %
    of the compute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
2026-11-12 46sp: add the assembly guide for the MJF print model
    Parts per half, insert pressing, switch fitting, matrix wiring tables,
    controller and AUX jack, first flash and tests before closing, closing
    with M3x10 from below, and maintenance. Values that wait on
    measurements or print tests are marked [확인 필요]. Three renders of the
    print model are added under 46sp/images.
2026-11-12 46sp: go back to two ATmega32U4 Pro Micro controllers
    The user has two USB-C ATmega32U4 Pro Micro boards and uses them
    instead of buying RP2040-Zero boards. The firmware returns to the pin
    map used before e070b14 (rows D1 D0 D4 C6, columns D7 E6 B4 B5 F4 F5
    F6, bitbang serial on D2, Caterina); config.h is no longer needed.
    The README, TODO, purchase list and assembly guide follow, and mark
    the print model as under review: the user reuses the already
    assembled plywood case, so the new-case print parts will be redesigned.
2026-11-13 46sp: 46-key plate for the existing case, same width
    Edit the r3 plate drawing instead of widening the case: L_R2 loses its
    outer opening, R_R0/R_R1 get keys 6-7 at a uniform 19.05 pitch
    (X 280.775, 299.825) in place of the old 6th key, and the two rib notches
    under them go. Plate lengths are unchanged so the plates drop into the
    existing cheek slots. Document the STEP exports, the 10 mm drawing offset
    of the thumb plate, and the end ribs that no longer fit.
2026-11-13 46sp: drop the ribs, record how the plate can reuse the acrylic cheeks
2026-11-13 46sp: record press-fit case walls, plan bottom cover and plate logo
2026-11-13 46sp: print plate and bottom cover for the existing case
    One MJF plate per half replaces the r3 acrylic row strips and ribs: its
    section is the r3 cheek slot shrunk 0.25 all round, so both ends slide
    into the existing acrylic cheeks; 46 keys from the 46-key drawing, and
    the 46es-style logo kb46sp/26 engraved on the left thumb row. A 3 mm
    bottom cover screws on with six countersunk wood screws, clear of the
    bone bar grooves. The generator checks closed solids, volumes, keycap
    and relief clearances, and (--check-case) the left parts against the
    case STEP. Records that the STEP cheek slot (f3d) differs from the r3
    DWG slot the plate follows, and retires the old full-case print model.
    Co-Author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
2026-11-13 46sp: cover follows the case footprint, right case is the left one mirrored
    The cover outline now follows the case bottom measured on the left STEP
    (front block and the back block's inner half sit further in than the
    side walls). The right case is the same as the left with the AUX jack on
    the other side (user), so the right cover mirrors the left one.
2026-11-13 46sp: right case has its AUX hole on the left wall and no USB outlet
    Record the jack and outlet places the user gave (the STEP has neither)
    and keep the cover's back step, read as the USB outlet's place, on the
    left cover only.
2026-11-13 46sp: Pro Micro cradle size in the retired full-case print generator
2026-11-13 46sp: cheeks are the r3 DWG 5T ones, not the f3d STEP cheek
    The DWG labels put the plates and the cheeks under 5T black acrylic and
    the ribs under 1.5T clear, so the cut cheeks have the 5.5 slot the print
    plate already follows; the STEP cheek (4 thick, 3.5 slot) is an older
    design. Cheek thickness in the keycap checks goes from 4 to 5.
2026-11-13 46sp: assembly guide for the existing case and the print plate
    Rewrite ASSEMBLY.md for the plan as built: take the press-fit case
    apart, move the switches to the print plate, slide the r3 5T cheeks on,
    close the walls, test, then glue the walls and screw the cover on.
    build_assembly.py makes the assembly (STEP plywood parts, r3 cheeks,
    bone bars, plate, cover, switch and keycap stand-ins; the right case is
    the left mirrored and widened), checks interference and renders the
    guide pictures. Keycaps at the thumb row reach the front block's inner
    edge by 0.4 mm (right down arrow 1.8) in the model: listed to check on
    the real case.
2026-11-13 46sp: flush back block, logo on the right plate at row 3
    The STEP's stepped inner back block (inside_bw_b) is another version's
    shape (user): the assembly uses the outer block mirrored and the cover's
    back edge is straight. The logo moves to the right plate at row 3
    height, outside the up-arrow key, the widest free spot on that row
    (height 2.5, stroke 0.63, rib 0.31).
2026-11-13 46sp: only the thumb keycap check needs the real keyboard
    The cheek pocket depth needs no measuring: the print plate keeps the
    acrylic plates' length and ends, so it fits where they fit. Add a marked
    section picture of where the thumb-row keycaps may brush the front block.
